NOVA-Cluster/Universal-Poofer-Control/bom/bom.csv

Reference | Qty | Value | Footprint | MPN | Manufacturer | LCSC | LC_Stock | Chosen_Distributor | Datasheet | Validated | DNP | Notes
C4,C1,C2,C3,C66 | 5 | 10uF / 25V | 0805 | CL21A106KAYNNNE | Samsung Electro-Mechanics | C15850 | 3505306 | LCSC | https://datasheet.lcsc.com/datasheet/pdf/02336ea48ea44ca18c72517dd3cb7b47.pdf?productCode=C15850 | Package/pin-map checked; prototype pending |  | Output effective capacitance>0.5uF required; ceramic stable regulator.
C5,C40,C7,C8,C9,C131,C132,C133,C134,C135,C136,C137,C138,C139,C80,C81,C82,C83,C84,C90,C91,C92,C110,C111,C112,C113,C74,C75,C70,C71,C72,C154,C141,C142,C143,C144,C145,C146,C147,C148,C149 | 41 | 100nF | 0805 | CC0805KRX7R9BB104 | YAGEO | C49678 | 7277425 | LCSC | https://datasheet.lcsc.com/datasheet/pdf/23ccee80ee542e7cf156a772bb589942.pdf?productCode=C49678 | Package/pin-map checked; prototype pending |  | Dominant compensation: OUT to isolated local IN-; do not connect directly to global reference.
C6 | 1 | 1uF / 50V | 0805 | CL21B105KBFNNNE | Samsung Electro-Mechanics | C28323 | 2084641 | LCSC | https://datasheet.lcsc.com/datasheet/pdf/02336ea48ea44ca18c72517dd3cb7b47.pdf?productCode=C28323 | Package/pin-map checked; prototype pending
C10,C11,C161,C162,C163,C164,C165,C166,C167,C168,C169 | 11 | 1nF / 50V | 0805 | CL21B102KBANNNC | Samsung Electro-Mechanics | C51210 | 9257 | LCSC | https://datasheet.lcsc.com/datasheet/pdf/02336ea48ea44ca18c72517dd3cb7b47.pdf?productCode=C51210 | Package/pin-map checked; prototype pending |  | Absorbs positive FIELD-step charge through the reverse blocker; prevents detector B-E avalanche. Qualify edge timing.
C50,C55,C60,C101,C102,C103,C104,C105,C106,C107,C108,C109,C156 | 13 | 10nF / 50V | 0805 | CL21B103KBANNNC | Samsung Electro-Mechanics | C1710 | 1006855 | LCSC | https://datasheet.lcsc.com/datasheet/pdf/02336ea48ea44ca18c72517dd3cb7b47.pdf?productCode=C1710 | Package/pin-map checked; prototype pending
D11,D12,D13,D14,D15,D16,D17,D18 | 8 | SS14 | SMA | SS14 | MDD(Microdiode Semiconductor) | C2480 | 2818967 | LCSC | https://datasheet.lcsc.com/datasheet/pdf/9977bb85cd7e349115b7bcb7054cfa0d.pdf?productCode=C2480 | Package/pin-map checked; prototype pending |  | Relay COIL flyback: cathode+12V, anodeMOSFET drain;~30mA initial current.
D31,D32,D33,D34,D35,D36,D37,D38 | 8 | SS34 | SMA | SS34 | MDD(Microdiode Semiconductor) | C8678 | 3557042 | LCSC | https://datasheet.lcsc.com/datasheet/pdf/dfa1ff67dea875d0135103ba9ada713a.pdf?productCode=C8678 | Package/pin-map checked; prototype pending |  | Valve LOAD flyback: cathodeNO, anodeRETURN. External12VDC valve1A max; slow release with diode clamp.
D41,D42,D43,D44,D45,D46,D47,D48 | 8 | SMBJ8.0A | SMB | SMBJ8.0A | Littelfuse | C224028 | 1621 | LCSC | https://datasheet.lcsc.com/datasheet/pdf/4ab84a227fae39f9eac85241b8264ead.pdf?productCode=C224028 | Package/pin-map checked; prototype pending
D91,D21,D22,D23,D24,D25,D26,D27,D28 | 9 | 8.2V / 1W | SMA | SMAZ8V2-13-F | DIODES | C84362 | 1566 | LCSC | https://datasheet.lcsc.com/datasheet/pdf/cc6412513453b26615ae87468f11d42c.pdf?productCode=C84362 | Package/pin-map checked; prototype pending
D111,D112,D113,D114,D115,D116,D117,D118,D101,D121,D102,D122,D103,D123,D104,D124,D105,D125,D106,D126,D107,D127,D108,D128,D109,D129,D119 | 27 | BAS21 | SOT-23 | BAS21,215 | Nexperia | C8661 | 221621 | LCSC | https://datasheet.lcsc.com/datasheet/pdf/75d45a3e45edceaa3bd611cf778a4f4a.pdf?productCode=C8661 | Package/pin-map checked; prototype pending |  | Nexperia BAS21,215:1anode2NC3cathode. Reverse blocks continuous-100V. Hot leakage bound in manufacturer curve; qualify-40..85C. Do not substitute100V 1N4148.
D141,D142,D143,D144,D145,D146,D147,D148,D149 | 9 | BAT54 | SOT-23 | BAT54,215 | Nexperia | C85084 | 110551 | LCSC | https://datasheet.lcsc.com/datasheet/pdf/720f73fc486de0cffc6ba54ebac7d3e3.pdf?productCode=C85084 | Package/pin-map checked; prototype pending |  | Reference-relative clamp protects compensation input during rail loss.
J1,J2,JP1,J11,J12,J13,J14,J15,J16,J17,J18,J9,J10,J41,J42,J43,J44,J45,J46,J47,J48,JP2 | 22 | 2P / 2.54mm | PinHeader_1x02_P2.54mm_Vertical | B-2100S02P-A110 | Ckmtw | C124375 | 71004 | LCSC | https://datasheet.lcsc.com/datasheet/pdf/c97166a9fa81fc94cb289f4b496e4403.pdf?productCode=C124375 | Package/pin-map checked; prototype pending |  | External regulated 5.0V, >=1A. Do not apply 12V.; 12V coil supply only; ~0.24A for eight relays. Valve power is wired separately per channel.; 5V logic; continuous +/-100V referenced to pin2; no galvanic isolation.; Valve:1positive/switchedNO;2valve-return. RETURN is isolated from logicGND. Wire valve negative here.
J3,J4,J5 | 3 | 20P / 2.54mm | PinHeader_1x20_P2.54mm_Vertical | 2.54-1*20P | BOOMELE(Boom Precision Elec) | C50981 | 8114 | LCSC | https://datasheet.lcsc.com/datasheet/pdf/d52c83a07830c4e9e9a614accc55f5cd.pdf?productCode=C50981 | Package/pin-map checked; prototype pending |  | Module pins1-20 in order, 3.3V GPIOs only. Some GPIOs reserved for shift registers.; Module pins21-40 in order. GPIO0/3/45/46 strap levels must be preserved at reset.; Serial bus and relay-driver test/breakout; never drive against MCU or shift-register outputs.
J6,J7,J31,J32,J33,J34,J35,J36,J37,J38 | 10 | 3P / 2.54mm | PinHeader_1x03_P2.54mm_Vertical | B-2100S03P-A110 | Ckmtw | C124376 | 38557 | LCSC | https://datasheet.lcsc.com/datasheet/pdf/219f7e7eb5f34457895b2c164313179f.pdf?productCode=C124376 | Package/pin-map checked; prototype pending |  | Reset:short1-2. Download:hold3-2 low during reset, then release. Use jumper/buttons externally.; 3.3V UART programmer. Self-powered target; never use5V UART levels.; Relay contacts:1COM2NO3NC; externally feedCOM with fused12V valve supply. <=1A valve design.
J20 | 1 | EXP_UP | PinHeader_2x08_P2.54mm_Vertical | 2.54-2*8P针 | BOOMELE(Boom Precision Elec) | C68234 | 36548 | LCSC | https://datasheet.lcsc.com/datasheet/pdf/d52c83a07830c4e9e9a614accc55f5cd.pdf?productCode=C68234 | Package/pin-map checked; prototype pending |  | NOPOWERPINS;independentlocalsupplies. Pin11NCcontinuity,terminateonlylast.
J21 | 1 | EXP_DOWN | PinHeader_2x08_P2.54mm_Vertical | 2.54-2*8P针 | BOOMELE(Boom Precision Elec) | C68234 | 36548 | LCSC | https://datasheet.lcsc.com/datasheet/pdf/d52c83a07830c4e9e9a614accc55f5cd.pdf?productCode=C68234 | Package/pin-map checked; prototype pending |  | NOPOWERPINS;independentlocalsupplies. Pin11NCcontinuity,terminateonlylast.
K1,K2,K3,K4,K5,K6,K7,K8 | 8 | SRD-12VDC-SL-C | Relay_SPDT_Songle_SRD | SRD-12VDC-SL-C | Songle Relay | C30431 | 142727 | LCSC | https://datasheet.lcsc.com/datasheet/pdf/9ddfe54b7529126320ff1ddcabf6bab7.pdf?productCode=C30431 | Package/pin-map checked; prototype pending |  | Songle12V/360mW coil;400ohm nominal.10A contact rating is resistive. Custom footprint corrects stockSANYOU NC/NO reversal;1COM2/5coil3NC4NO.
Q40,Q131,Q132,Q133,Q134,Q135,Q136,Q137,Q138,Q139 | 10 | AO3401A | SOT-23 | AO3401A | AOS | C15127 | 715902 | LCSC | https://datasheet.lcsc.com/datasheet/pdf/fee353dd1e9e0bc90b295f14f381aa4c.pdf?productCode=C15127 | Package/pin-map checked; prototype pending |  | P-MOS gates local5V bias only.1G2S3D;10k gate-source pullup defaultsOFF on OV or powerloss.
Q41,Q42,Q111,Q121,Q112,Q122,Q113,Q123,Q114,Q124,Q115,Q125,Q116,Q126,Q117,Q127,Q118,Q128,Q119,Q129 | 20 | MMBT3904 | SOT-23 | MMBT3904(RANGE:100-300) | JSCJ | C20526 | 2033567 | LCSC | https://datasheet.lcsc.com/datasheet/pdf/9335632bcfa83df8351353eab379720e.pdf?productCode=C20526 | Package/pin-map checked; prototype pending
Q101,Q102,Q103,Q104,Q105,Q106,Q107,Q108,Q109 | 9 | MJD350T4G | TO-252-3_TabPin2 | MJD350T4G | onsemi | C145514 | 6132 | LCSC | https://datasheet.lcsc.com/datasheet/pdf/e1ca48ba9fe8215bfc40bb66a4536fef.pdf?productCode=C145514 | Package/pin-map checked; prototype pending |  | P-MOS gates local5V bias only.1G2S3D;10k gate-source pullup defaultsOFF on OV or powerloss.
Q149,Q1,Q2,Q3,Q4,Q5,Q6,Q7,Q8 | 9 | AO3400A | SOT-23 | AO3400A | AOS | C20917 | 1535925 | LCSC | https://datasheet.lcsc.com/datasheet/pdf/130876b936da464599428c58fd8de8f6.pdf?productCode=C20917 | Package/pin-map checked; prototype pending |  | 1Gate2Source3Drain;Rds(on) specified at2.5V gate. Relay coil current~30mA.
Q151,Q152,Q153,Q154,Q155,Q156,Q157,Q158,Q159 | 9 | MMBT3906 | SOT-23 | MMBT3906 2A(RANGE:100-300) | JSCJ | C2143 | 77637 | LCSC | https://datasheet.lcsc.com/datasheet/pdf/550597da53734df4a72fadeaed7e7aa7.pdf?productCode=C2143 | Package/pin-map checked; prototype pending |  | Fast backup limiter; senses half of33Rdrop, typically30-50mA surge bound.
R2,R3,R4,R5,R61,R70,R114,R113,R115,R1020,R1013,R1050,R1043,R1080,R1073,R1110,R1103,R1140,R1133,R1170,R1163,R1200,R1193,R1230,R1223,R1021,R1051,R1081,R1111,R1141,R1171,R1201,R1231,R1261,R1260,R1253,R90,R91,R92,R93,R94,R95,R124,R125,R126,R127,R128,R129,R130,R131,R132,R133,R134,R135,R88,R153,R155,R157,R1024,R1054,R1084,R1114,R1144,R1174,R1204,R1234,R1264 | 67 | 10k | 0805 | 0805W8F1002T5E | UNI-ROYAL | C17414 | 10726008 | LCSC | https://datasheet.lcsc.com/datasheet/pdf/0a975aaa49b7c97f38a963127be4a823.pdf?productCode=C17414 | Package/pin-map checked; prototype pending |  | Gate-source pullup provides default-off state.
R40,R1001,R1031,R1061,R1091,R1121,R1151,R1181,R1211,R1241,R120,R121 | 12 | 2.2k | 0805 | 0805W8F2201T5E | UNI-ROYAL | C17520 | 936020 | LCSC | https://datasheet.lcsc.com/datasheet/pdf/0a975aaa49b7c97f38a963127be4a823.pdf?productCode=C17520 | Package/pin-map checked; prototype pending
R50,R51 | 2 | 200k | 0805 | 0805W8F2003T5E | UNI-ROYAL | C17539 | 421599 | LCSC | https://datasheet.lcsc.com/datasheet/pdf/0a975aaa49b7c97f38a963127be4a823.pdf?productCode=C17539 | Package/pin-map checked; prototype pending
R52 | 1 | 3.3k | 0805 | 0805W8F3301T5E | UNI-ROYAL | C26010 | 457218 | LCSC | https://datasheet.lcsc.com/datasheet/pdf/0a975aaa49b7c97f38a963127be4a823.pdf?productCode=C26010 | Package/pin-map checked; prototype pending
R56,R1017,R1047,R1077,R1107,R1137,R1167,R1197,R1227,R1257 | 10 | 6.8k | 0805 | 0805W8F6801T5E | UNI-ROYAL | C17772 | 327991 | LCSC | https://datasheet.lcsc.com/datasheet/pdf/0a975aaa49b7c97f38a963127be4a823.pdf?productCode=C17772 | Package/pin-map checked; prototype pending
R57,R58 | 2 | 75k | 0805 | 0805W8F7502T5E | UNI-ROYAL | C17819 | 49785 | LCSC | https://datasheet.lcsc.com/datasheet/pdf/0a975aaa49b7c97f38a963127be4a823.pdf?productCode=C17819 | Package/pin-map checked; prototype pending
R60 | 1 | 30k | 0805 | 0805W8F3002T5E | UNI-ROYAL | C17621 | 317144 | LCSC | https://datasheet.lcsc.com/datasheet/pdf/0a975aaa49b7c97f38a963127be4a823.pdf?productCode=C17621 | Package/pin-map checked; prototype pending |  | Gate-source pullup provides default-off state.
R65,R55,R111,R112,R1003,R1002,R1022,R1023,R1033,R1032,R1052,R1053,R1063,R1062,R1082,R1083,R1093,R1092,R1112,R1113,R1123,R1122,R1142,R1143,R1153,R1152,R1172,R1173,R1183,R1182,R1202,R1203,R1213,R1212,R1232,R1233,R1243,R1242,R1262,R1263,R137,R138,R139,R140 | 44 | 1k | 0805 | 0805W8F1001T5E | UNI-ROYAL | C17513 | 6086189 | LCSC | https://datasheet.lcsc.com/datasheet/pdf/0a975aaa49b7c97f38a963127be4a823.pdf?productCode=C17513 | Package/pin-map checked; prototype pending |  | 5VpullupBEFOREshunt preservescontactcurrent.; MANDATORY: limits clamp versus driver current to <=5.25mA.
R71,R116,R1014,R1015,R1016,R1009,R1010,R1011,R1012,R1044,R1045,R1046,R1039,R1040,R1041,R1042,R1074,R1075,R1076,R1069,R1070,R1071,R1072,R1104,R1105,R1106,R1099,R1100,R1101,R1102,R1134,R1135,R1136,R1129,R1130,R1131,R1132,R1164,R1165,R1166,R1159,R1160,R1161,R1162,R1194,R1195,R1196,R1189,R1190,R1191,R1192,R1224,R1225,R1226,R1219,R1220,R1221,R1222,R1004,R1005,R1006,R1007,R1034,R1035,R1036,R1037,R1064,R1065,R1066,R1067,R1094,R1095,R1096,R1097,R1124,R1125,R1126,R1127,R1154,R1155,R1156,R1157,R1184,R1185,R1186,R1187,R1214,R1215,R1216,R1217,R1244,R1245,R1246,R1247,R1254,R1255,R1256,R1249,R1250,R1251,R1252,R211,R212,R213,R214,R215,R216,R217,R218,R136,R151,R152,R154 | 113 | 100k | 0805 | 0805W8F1003T5E | UNI-ROYAL | C149504 | 2466214 | LCSC | https://datasheet.lcsc.com/datasheet/pdf/0a975aaa49b7c97f38a963127be4a823.pdf?productCode=C149504 | Package/pin-map checked; prototype pending |  | High-impedance test observation; limit ordinary counterdrive to<35uA. Use a high-impedance probe.
R80,R81,R82,R83,R84,R85,R86,R87,R1000,R1030,R1060,R1090,R1120,R1150,R1180,R1210,R1240 | 17 | 33R | 0805 | 0805W8F330JT5E | UNI-ROYAL | C17634 | 334351 | LCSC | https://datasheet.lcsc.com/datasheet/pdf/0a975aaa49b7c97f38a963127be4a823.pdf?productCode=C17634 | Package/pin-map checked; prototype pending |  | Compensated current servo; backup PNP limits short transients. Qualify pulse energy.
R150,R110,R122,R123 | 4 | 4.7k | 0805 | 0805W8F4701T5E | UNI-ROYAL | C17673 | 3444289 | LCSC | https://datasheet.lcsc.com/datasheet/pdf/0a975aaa49b7c97f38a963127be4a823.pdf?productCode=C17673 | Package/pin-map checked; prototype pending |  | Series fault attenuation; <34V and <12mW each at+100V.
R201,R202,R203,R204,R205,R206,R207,R208,R66,R67 | 10 | 100R | 0805 | 0805W8F1000T5E | UNI-ROYAL | C17408 | 2576764 | LCSC | https://datasheet.lcsc.com/datasheet/pdf/0a975aaa49b7c97f38a963127be4a823.pdf?productCode=C17408 | Package/pin-map checked; prototype pending |  | Capacitive-load isolation and power-off discharge current limit.
R1008,R1038,R1068,R1098,R1128,R1158,R1188,R1218,R1248,R156 | 10 | 68k | 0805 | 0805W8F6802T5E | UNI-ROYAL | C17801 | 221823 | LCSC | https://datasheet.lcsc.com/datasheet/pdf/0a975aaa49b7c97f38a963127be4a823.pdf?productCode=C17801 | Package/pin-map checked; prototype pending
R1018,R1019,R1048,R1049,R1078,R1079,R1108,R1109,R1138,R1139,R1168,R1169,R1198,R1199,R1228,R1229,R1258,R1259,R158 | 19 | 1M | 0805 | 0805W8F1004T5E | UNI-ROYAL | C17514 | 752470 | LCSC | https://datasheet.lcsc.com/datasheet/pdf/0a975aaa49b7c97f38a963127be4a823.pdf?productCode=C17514 | Package/pin-map checked; prototype pending |  | 100k||1M =90.909k; lowers5V trip to4.269V with normal-supply corner margin.
U1 | 1 | ESP32-S3-WROOM-1-N8 | ESP32-S3-WROOM-1 | ESP32-S3-WROOM-1-N8 | ESPRESSIF | C2913198 | 6072 | LCSC | https://datasheet.lcsc.com/datasheet/pdf/24a44651a4767a6582addcdaa9cab2ca.pdf?productCode=C2913198 | Package/pin-map checked; prototype pending |  | N8:8MB flash, no PSRAM; all module GPIOs exposed. GPIO0/3/45/46 are strapping pins. Antenna keepout mandatory at layout.
U2 | 1 | TLV1117LV33 | SOT-223-3_TabPin2 | TLV1117LV33DCYR | TI | C15578 | 1771 | LCSC | https://www.ti.com/lit/ds/symlink/tlv1117lv.pdf | Package/pin-map checked; prototype pending |  | Ceramic stable1A regulator. SOT223 copper heat spreader required:0.85W at500mA. Verify final thermal layout.
U3 | 1 | 74HC595D,118 | SOIC-16_3.9x9.9mm_P1.27mm | 74HC595D,118 | Nexperia | C5947 | 300597 | LCSC | https://datasheet.lcsc.com/datasheet/pdf/a010531f03b3cd52f281e9270a37554f.pdf?productCode=C5947 | Package/pin-map checked; prototype pending
U4,U5 | 2 | 74HC165D,653 | SOIC-16_3.9x9.9mm_P1.27mm | 74HC165D,653 | Nexperia | C5613 | 176023 | LCSC | https://datasheet.lcsc.com/datasheet/pdf/581a3a30f07ab5fec4b563321f834e05.pdf?productCode=C5613 | Package/pin-map checked; prototype pending
U10,U13,U11,U14,U12 | 5 | LM2901BIDR | SOIC-14_3.9x8.7mm_P1.27mm | LM2901BIDR | TI | C22427890 | 2406 | LCSC | https://www.ti.com/lit/ds/symlink/lm2901.pdf | Package/pin-map checked; prototype pending |  | B suffix mandatory:5.5mV max offset. Quad comparator5V supply, open-collector outputs pulled to3.3V. Input power-off tolerance independent of supply.
U20,U21,U22 | 3 | LM2902DR | SOIC-14_3.9x8.7mm_P1.27mm | LM2902DR | TI | C350545 | 79908 | LCSC | https://datasheet.lcsc.com/datasheet/pdf/4a62dd90e9e076620b6ad3345f8cbf23.pdf?productCode=C350545 | Package/pin-map checked; prototype pending |  | LM2902DR quad current servo;12 V raw supply;emitter+ CURRENT_REF-;unit properties identical.
U30 | 1 | 74HC00D,653 | SOIC-14_3.9x8.7mm_P1.27mm | 74HC00D,653 | Nexperia | C5586 | 38676 | LCSC | https://datasheet.lcsc.com/datasheet/pdf/f075b54a1e6ef92859876c6b1072c938.pdf?productCode=C5586 | Package/pin-map checked; prototype pending |  | HC00 output-enable logic; 3.3V; all unit properties identical.
U31 | 1 | 74HC02D,653 | SOIC-14_3.9x8.7mm_P1.27mm | 74HC02D,653 | Nexperia | C5588 | 9973 | LCSC | https://datasheet.lcsc.com/datasheet/pdf/1c47bea93f023f708e04ad0ea1d69eaa.pdf?productCode=C5588 | Package/pin-map checked; prototype pending |  | HC02 loop permission and asynchronous clear; 3.3V.
U32 | 1 | 74HC14D,653 | SOIC-14_3.9x8.7mm_P1.27mm | 74HC14D,653 | Nexperia | C5605 | 323410 | LCSC | https://datasheet.lcsc.com/datasheet/pdf/14be360d5023de3678ac97c5270a2114.pdf?productCode=C5605 | Package/pin-map checked; prototype pending |  | HC14 Schmitt conditioning; 3.3V.
U34 | 1 | 74HC74D,653 | SOIC-14_3.9x8.7mm_P1.27mm | 74HC74D,653 | Nexperia | C27597 | 17491 | LCSC | https://datasheet.lcsc.com/datasheet/pdf/f4f0560be08307d88611fab756814ae9.pdf?productCode=C27597 | Package/pin-map checked; prototype pending |  | HC74 edge-armed RUN latch; async clear on stop or power fault; 3.3V.
U35 | 1 | TLV9022DR | SOIC-8_3.9x4.9mm_P1.27mm | TLV9022DR | TI | C2871718 | 3324 | LCSC | https://datasheet.lcsc.com/datasheet/pdf/3d1f78e103f465c65679bc7782083f18.pdf?productCode=C2871718 | Package/pin-map checked; prototype pending |  | B suffix mandatory:5.5mV max offset. Quad comparator5V supply, open-collector outputs pulled to3.3V. Input power-off tolerance independent of supply.
U40 | 1 | TLV803EA30 | SOT-23 | TLV803EA30DBZR | TI | C5218924 | 4037 | LCSC | https://datasheet.lcsc.com/datasheet/pdf/075232f81476471fb0145392049399fa.pdf?productCode=C5218924 | Package/pin-map checked; prototype pending |  | 1GND2RESET_N3VDD;3.08Vthreshold,130-270ms delay.
U50,U51,U52 | 3 | SN74LVC244A | SOIC-20W_7.5x12.8mm_P1.27mm | SN74LVC244ADWR | TI | C507250 | 5314 | LCSC | https://datasheet.lcsc.com/datasheet/pdf/837c4cf251ed322926ebeb792567c9cb.pdf?productCode=C507250 | Package/pin-map checked; prototype pending |  | LVC244A3.3V,Ioff,5Vtolerantinputs;unusedinputsGND.
U54 | 1 | PCA9517AD | SOIC-8_3.9x4.9mm_P1.27mm | PCA9517AD,118 | NXP | C2802638 | 2831 | LCSC | https://www.nxp.com/docs/en/data-sheet/PCA9517A.pdf | Package/pin-map checked; prototype pending |  | NXP A variant;A sides commonUP/DOWN, B privateMCU. Partial-power isolation.
