NOVA-Cluster/Universal-Poofer-Control/output/pcb/placement_top.pdf

## UNIVERSAL POOFER CONTROL

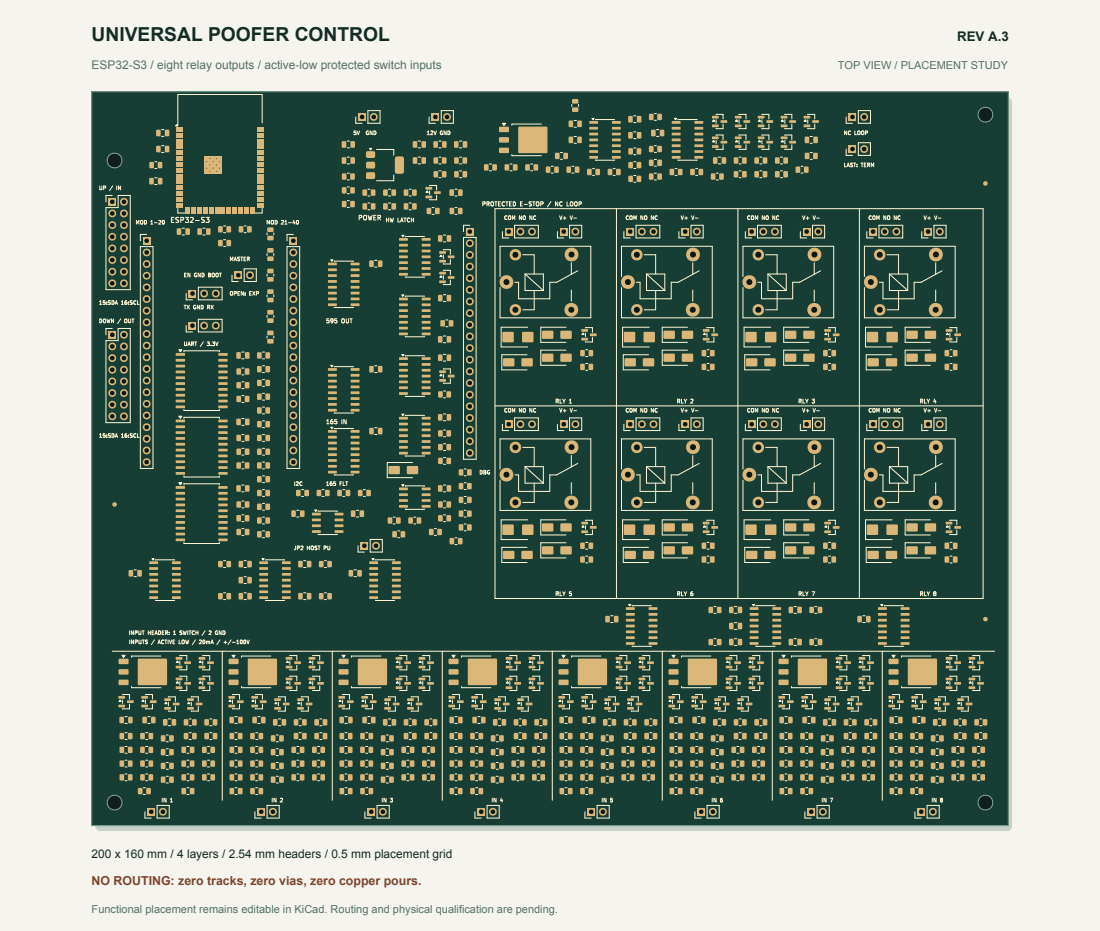
[picture p7: page 1]
REV A.3

ESP32-S3 / eight relay outputs / active-low protected switch inputs

TOP VIEW / PLACEMENT STUDY

200 x 160 mm / 4 layers / 2.54 mm headers / 0.5 mm placement grid

NO ROUTING: zero tracks, zero vias, zero copper pours.

Functional placement remains editable in KiCad. Routing and physical qualification are pending.
