NOVA-Cluster/Universal-Poofer-Control/output/pdf/Universal_Poofer_Control_A3.pdf

1 | 2 | 3 | 4 | 5 | 6 | 7 | 8

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
Size: A3 | Rev: A.3 | F Date: 2026-10-03
KiCad E.D.A. 10.0.5 | Id: 1/24

# Title: 01 | System architecture

## File: Universal_Poofer_Control.kicad_sch

## Sheet: /

## Universal Poofer Control | Engineering

## Grounded contacts / 20mA wetting / +/-100V faults

## Hardware stop latch | 12V / 1A NO valve outputs

18 | Analog supplies, spare units and debug port File: Analog_Support.kicad_sch | 24 | Stable emitter feedback for all wetting sources File: Source_Feedback_Filters.kicad_sch 20 | Buffered current reference and rail sequencing
File: Current_Reference.kicad_sch 16 | Valve outputs 1-4
File: Relay_Outputs_1.kicad_sch | 21 | I2C expansion and power-off isolation
File: I2C_Expansion.kicad_sch 17 | Valve outputs 5-8
File: Relay_Outputs_2.kicad_sch 13 | Wetting sources 5-6
File: Contact_Sources_3.kicad_sch 12 | Wetting sources 3-4
File: Contact_Sources_2.kicad_sch 02 | Processor and service interfaces
File: Controller.kicad_sch | 08 | Contact receivers 3-4
File: Input_Receivers_2.kicad_sch | 09 | Contact receivers 5-6
File: Input_Receivers_3.kicad_sch 06 | Hardware stop latch and coil gate
File: Hardware_Stop.kicad_sch | 05 | Buffered expansion interface
File: Expansion.kicad_sch 04 | Register chains

### File: Serial_IO.kicad_sch 03 | Power and analog references

### File: Power.kicad_sch 22 | Expansion defaults and buffer supplies

File: Expansion_Bias.kicad_sch

### 07 | Contact receivers 1-2

File: Input_Receivers_1.kicad_sch 11 | Wetting sources 1-2

### File: Contact_Sources_1.kicad_sch 23 | Hardware monitoring of 5V and raw 12V

File: Rail_Supervision.kicad_sch

### 10 | Contact receivers 7-8

File: Input_Receivers_4.kicad_sch | 19 | Safety logic supplies and unused gates
File: Logic_Support.kicad_sch 14 | Wetting sources 7-8
File: Contact_Sources_4.kicad_sch | 15 | NC emergency-stop field loop

File: Stop_Field.kicad_sch

# UNIVERSAL POOFER CONTROL

Stable shared wetting-current reference Protected NC loop and tail termination Protected contact sensing

Safety logic bypassing and spare units 20 mA source and field fault cutoff Logic-powered raw supply-loss protection

Analog bypassing and defined spare units

Logic supplies and monitored startup

Safe control defaults and bypass PCB placement stage only: no tracks, vias or copper pours. Routing, actual-valve tests and independent system safety qualification remain required. | Stable transistor-loop feedback

## HARDWARE SAFETY CONTRACT

NC loop open/disconnected sets hardware stop latch. Loop restored does not re-energize retained outputs. Fresh ARM edge and power-good required to enable. GPIO18 = loop healthy; GPIO21 = hardware RUN feedback. NC relay contacts auxiliary; valve connectors are NO. Protected contact sensing | 8 command bits / 16 captured input bits Asynchronous stop / edge-controlled restart | Buffered chain and physical module role REV A.3 | Functional architecture | 2026-10-03
Protected contact sensing 20 mA source and field fault cutoff Processor, reset and programming | Protected contact sensing Physical role jumper; no MCU control of role/source. | 20 mA source and field fault cutoff NO valve contacts and release clamps
Buffered host/expander chain; separate module power. 8 NO valve outputs:12 VDC, 1 A design load per channel. | NO valve contacts and release clamps

Continuous +/-100V field faults; negative faults masked.

Shared A bus / isolated private MCU bus

8 grounded contacts; nominal 20 mA supplied by board. INTERFACE CONTRACT

20 mA source and field fault cutoff

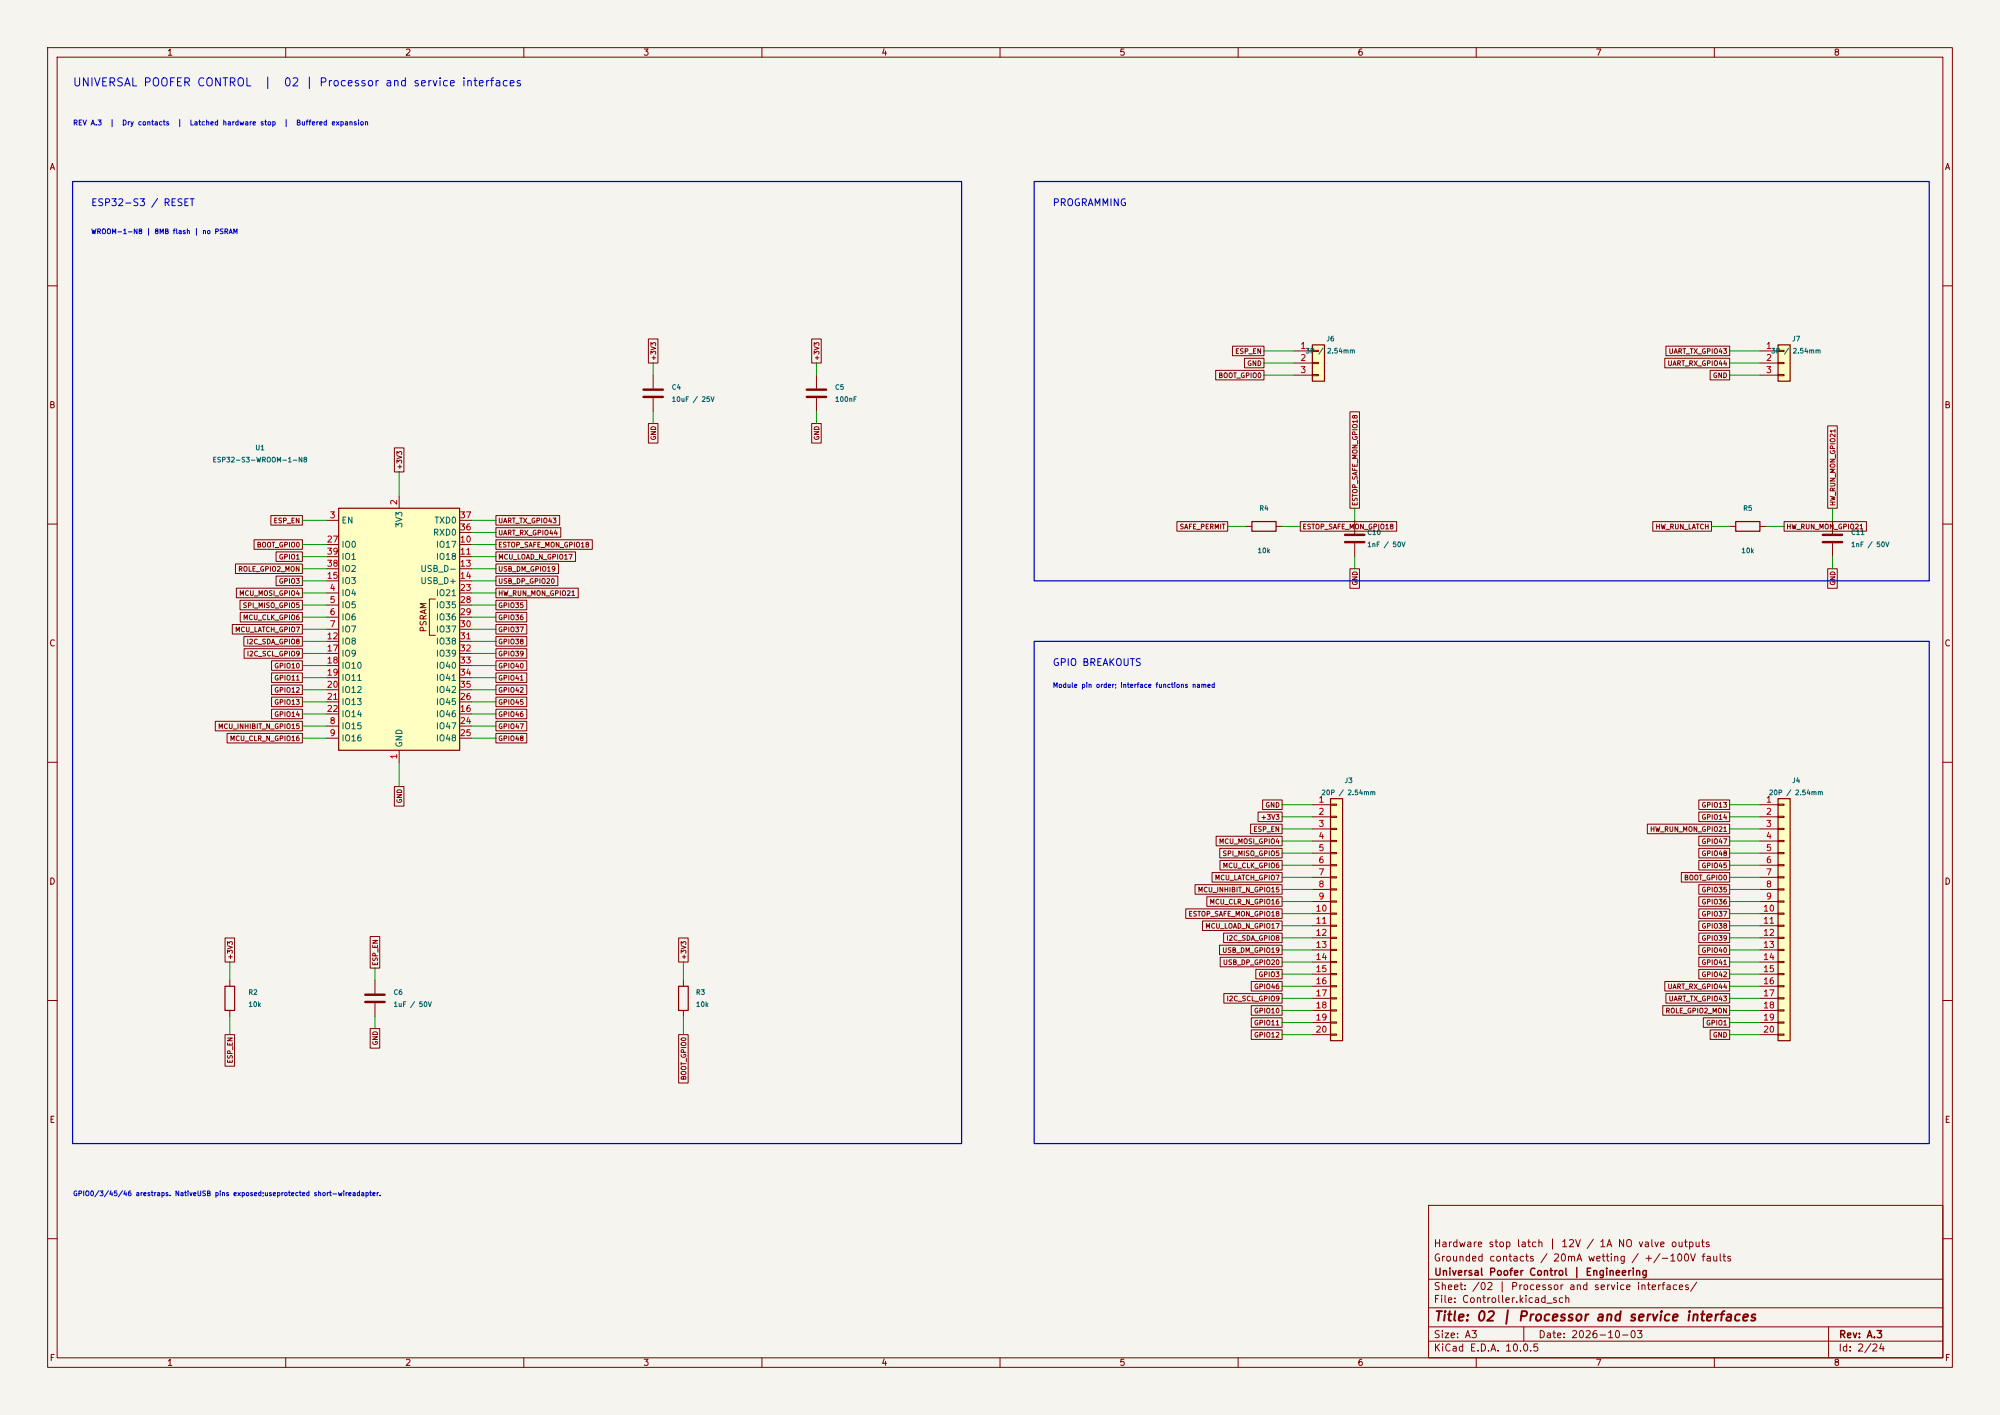
[picture p8: page 2]

UNIVERSAL POOFER CONTROL | 02 | Processor and service interfaces

Module pin order; interface functions named

GPIO0/3/45/46 arestraps. NativeUSB pins exposed;useprotected short-wireadapter.

Hardware stop latch | 12V / 1A NO valve outputs
Grounded contacts / 20mA wetting / +/-100V faults
Universal Poofer Control | Engineering
Sheet: /02 | Processor and service interfaces/
File: Controller.kicad_sch
Title: 02 | Processor and service interfaces

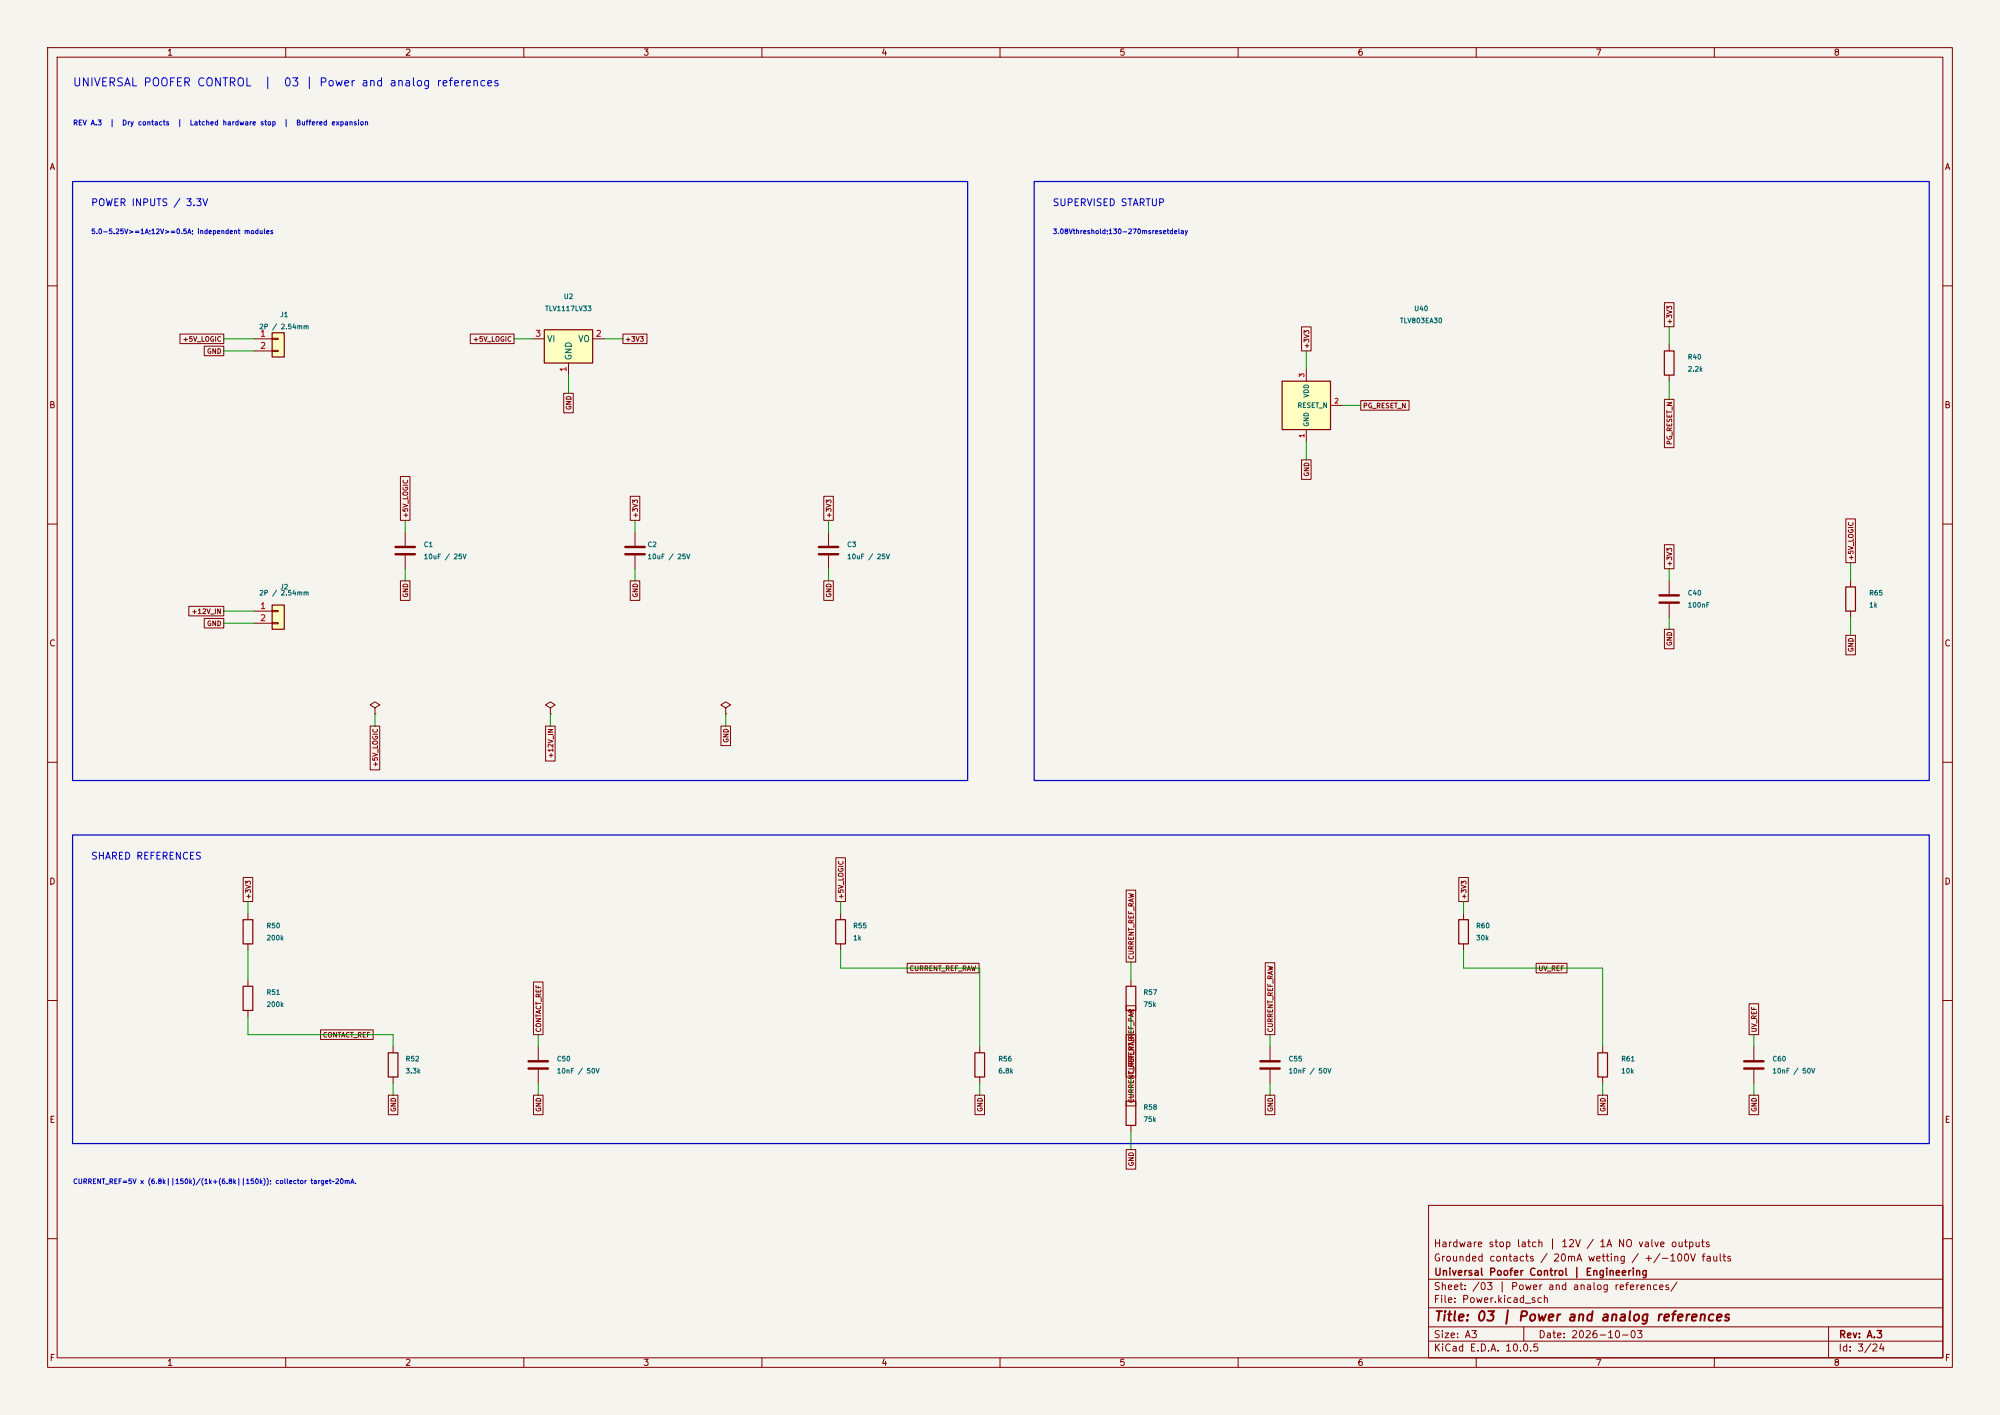
[picture p9: page 3]

UNIVERSAL POOFER CONTROL | 03 | Power and analog references

CURRENT_REF=5V x (6.8k||150k)/(1k+(6.8k||150k)); collector target~20mA. SHARED REFERENCES

Hardware stop latch | 12V / 1A NO valve outputs
Grounded contacts / 20mA wetting / +/-100V faults
Universal Poofer Control | Engineering
Sheet: /03 | Power and analog references/
File: Power.kicad_sch
Title: 03 | Power and analog references

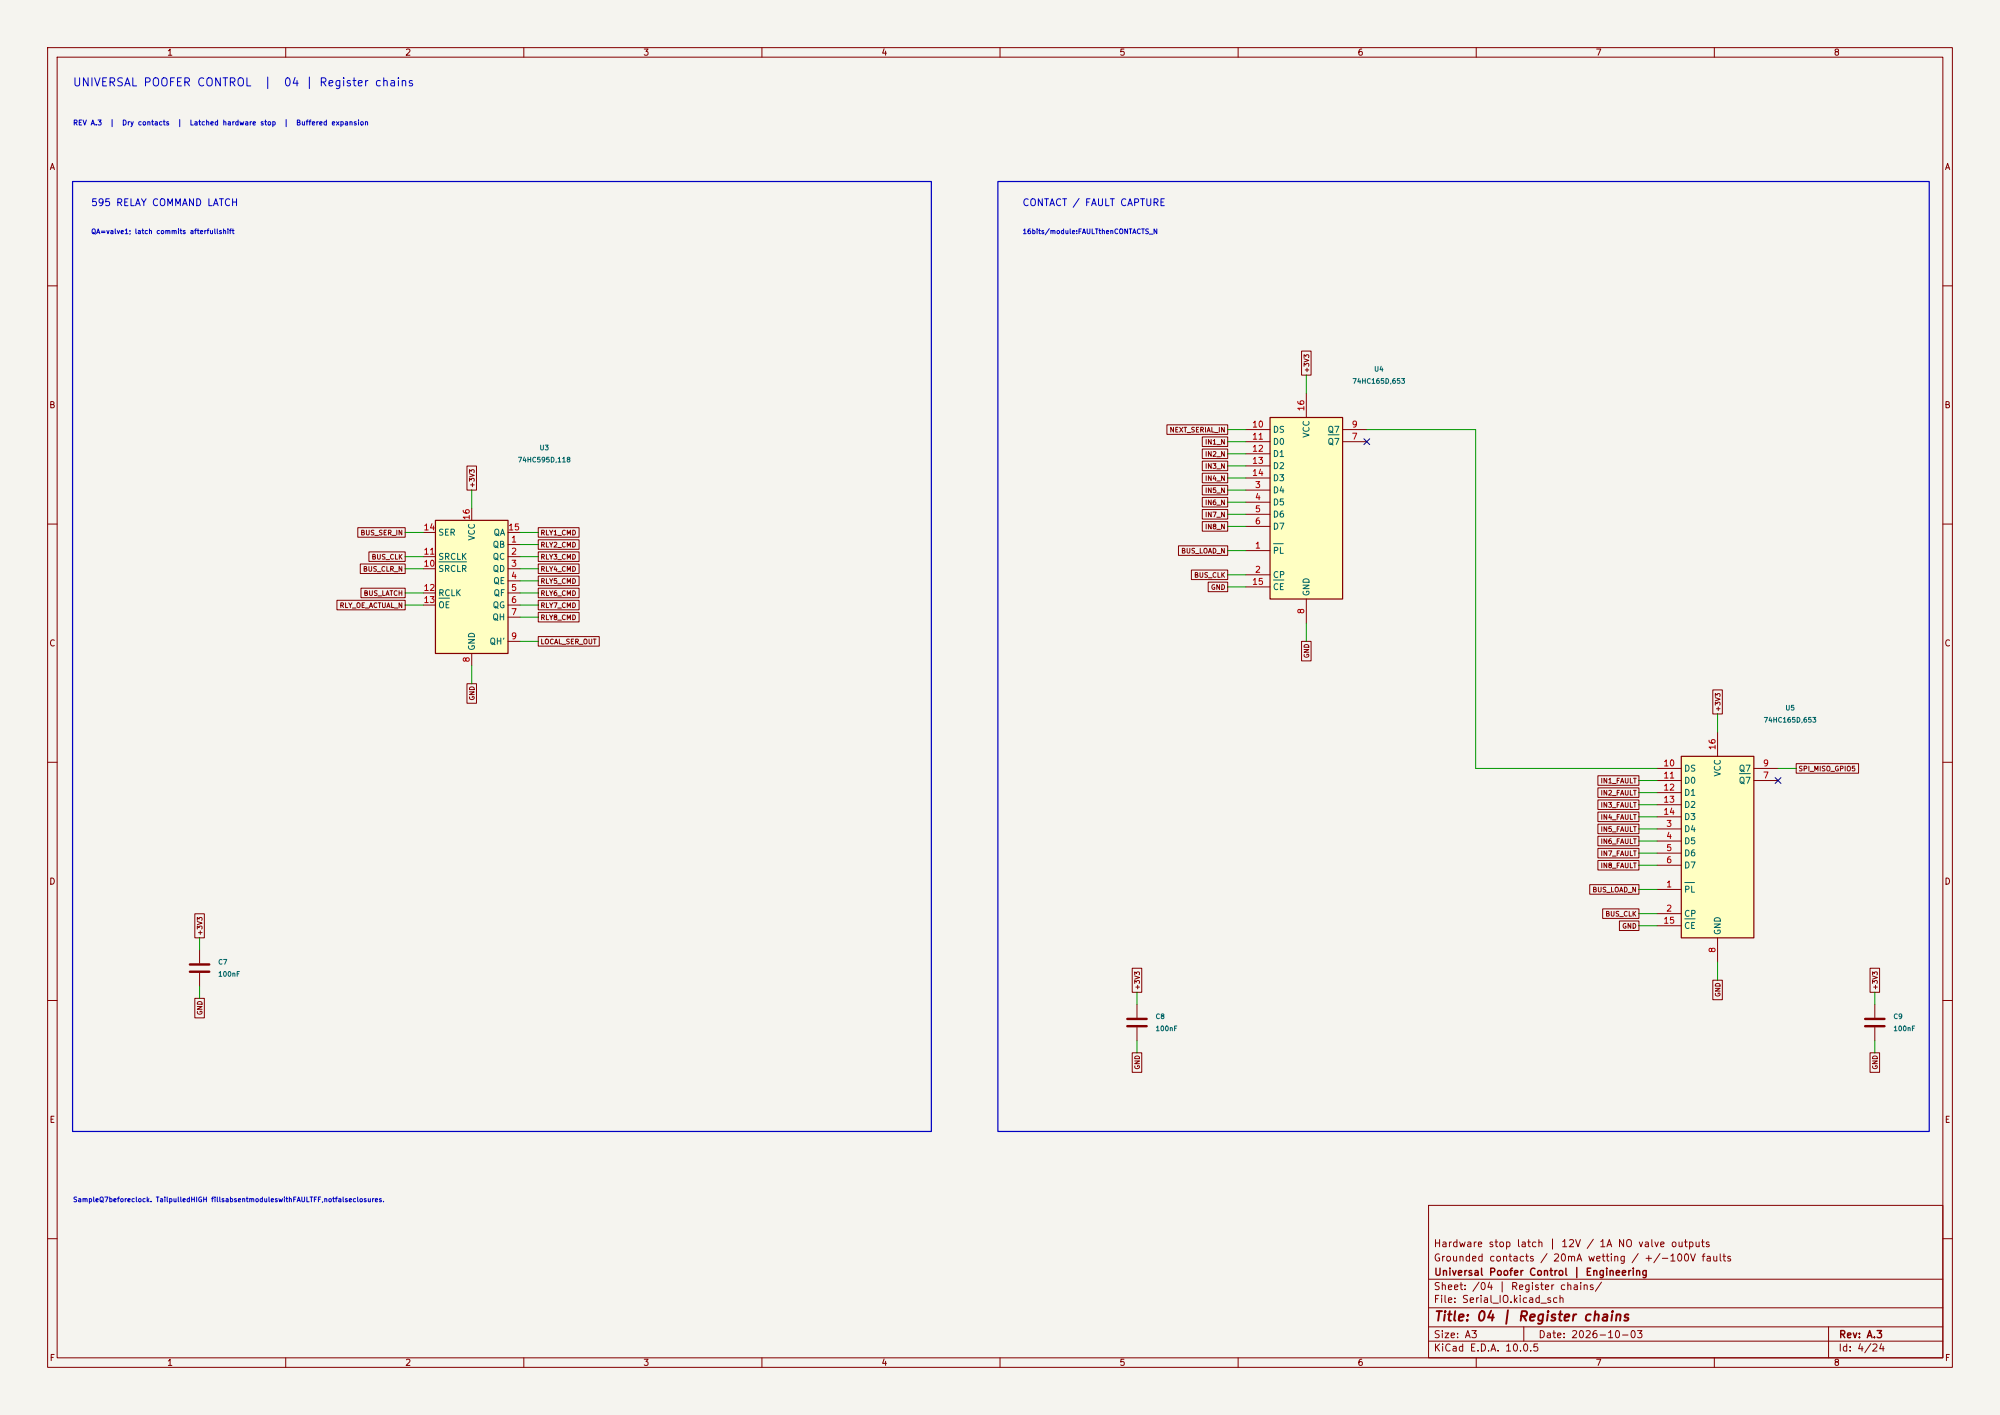
[picture p10: page 4]

16bits/module:FAULTthenCONTACTS_N UNIVERSAL POOFER CONTROL | 04 | Register chains

REV A.3 | Dry contacts | Latched hardware stop | Buffered expansion

QA=valve1; latch commits afterfullshift

SRCLR 10 SRCLK 11 RCLK 12 OE 13

Hardware stop latch | 12V / 1A NO valve outputs
Grounded contacts / 20mA wetting / +/-100V faults
Universal Poofer Control | Engineering
Sheet: /04 | Register chains/
File: Serial_IO.kicad_sch
Title: 04 | Register chains

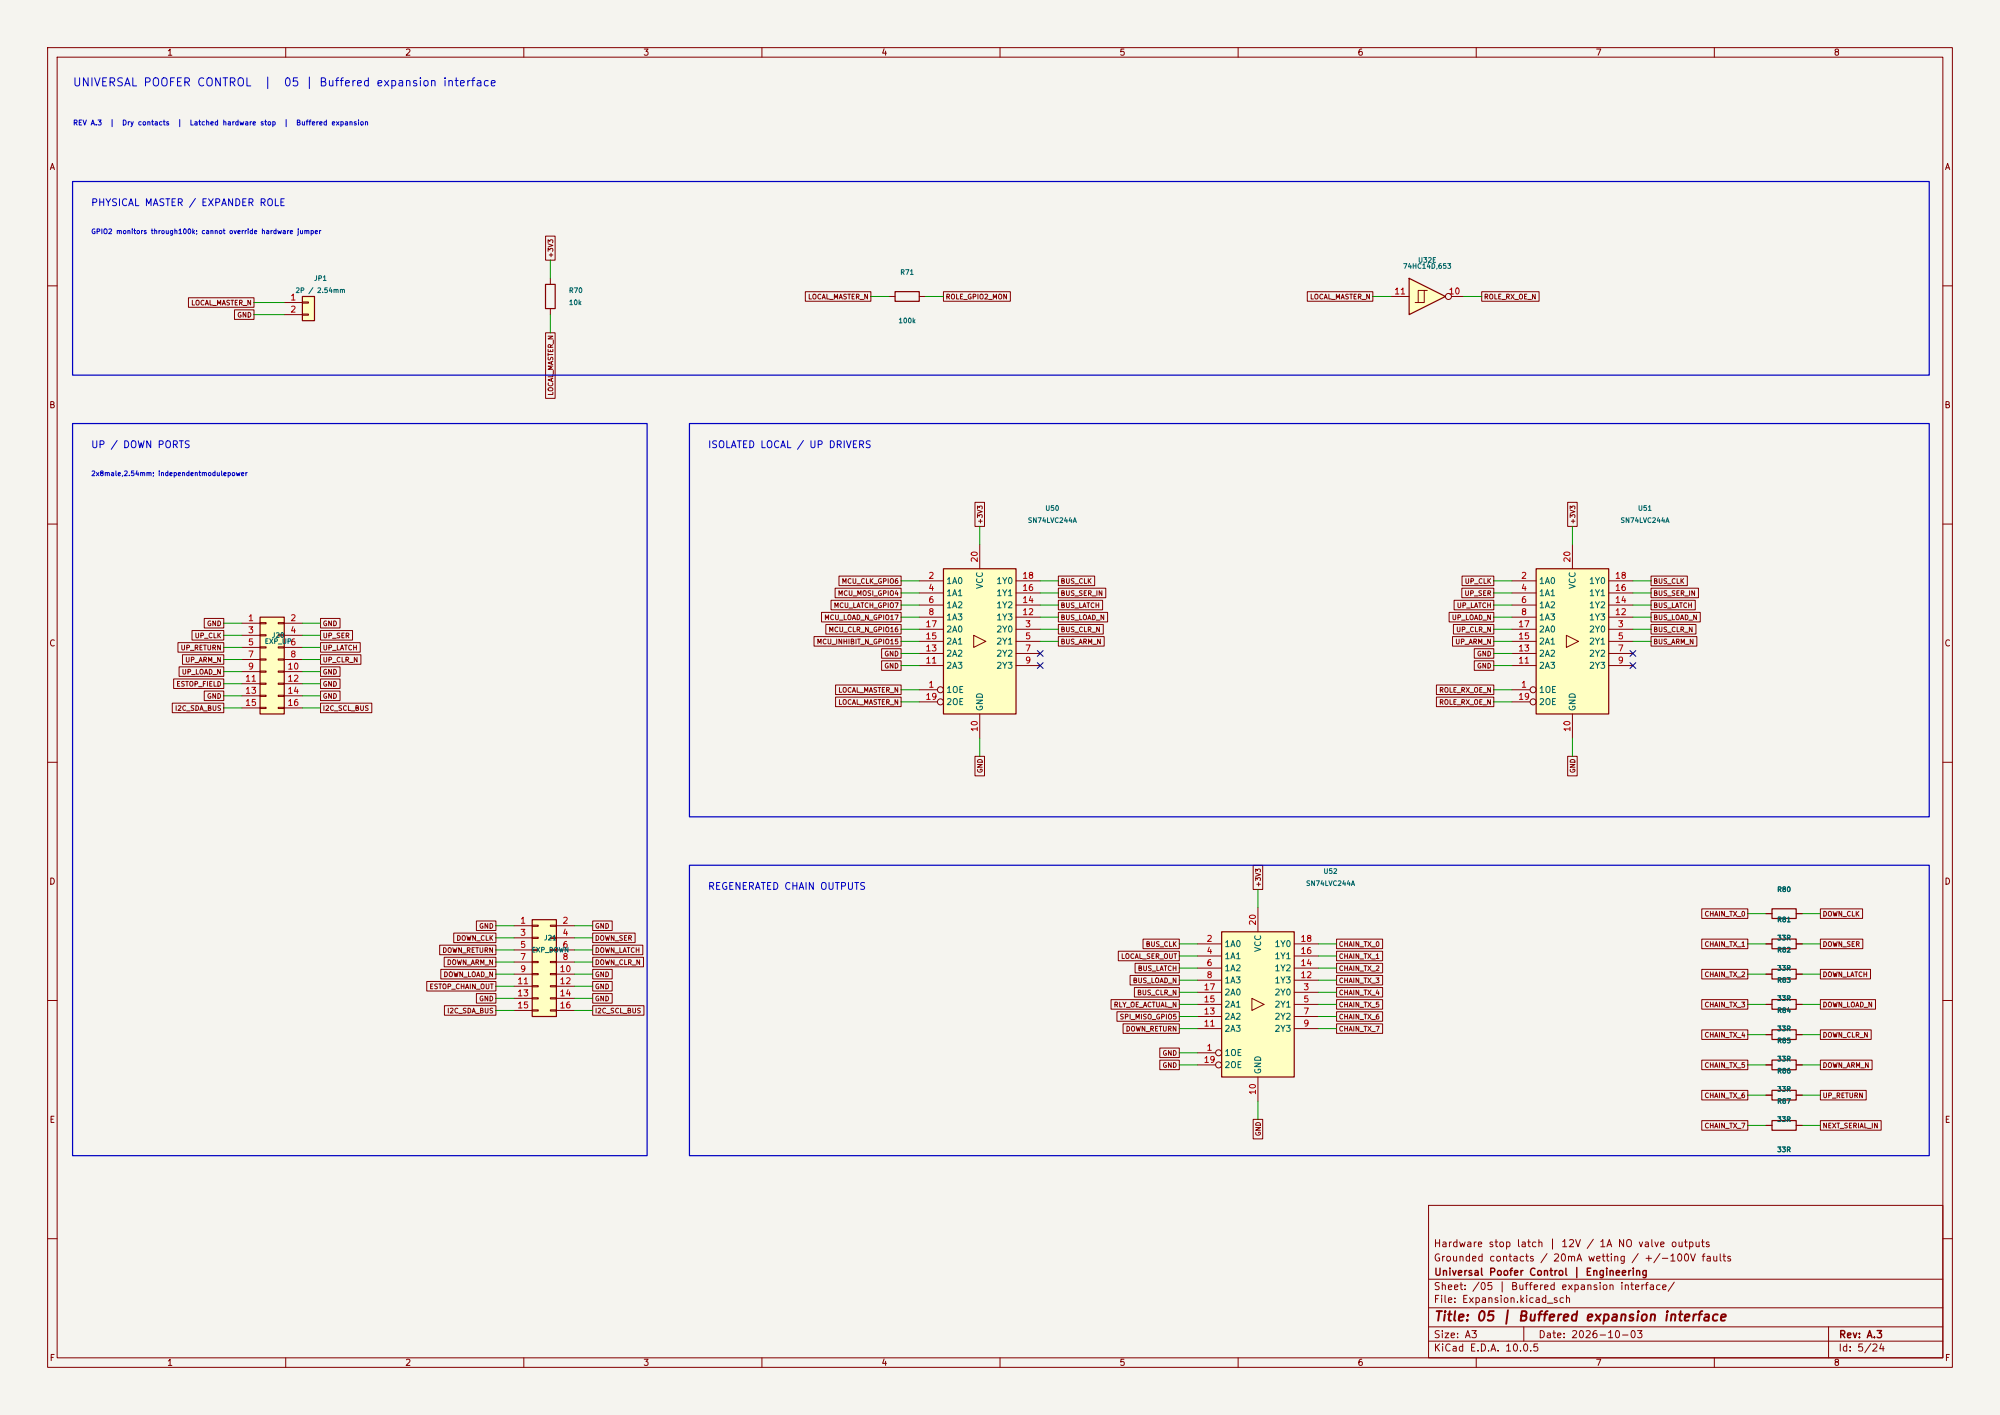
[picture p11: page 5]

UNIVERSAL POOFER CONTROL | 05 | Buffered expansion interface

REV A.3 | Dry contacts | Latched hardware stop | Buffered expansion

PHYSICAL MASTER / EXPANDER ROLE

Hardware stop latch | 12V / 1A NO valve outputs
Grounded contacts / 20mA wetting / +/-100V faults
Universal Poofer Control | Engineering
Sheet: /05 | Buffered expansion interface/
File: Expansion.kicad_sch
Title: 05 | Buffered expansion interface

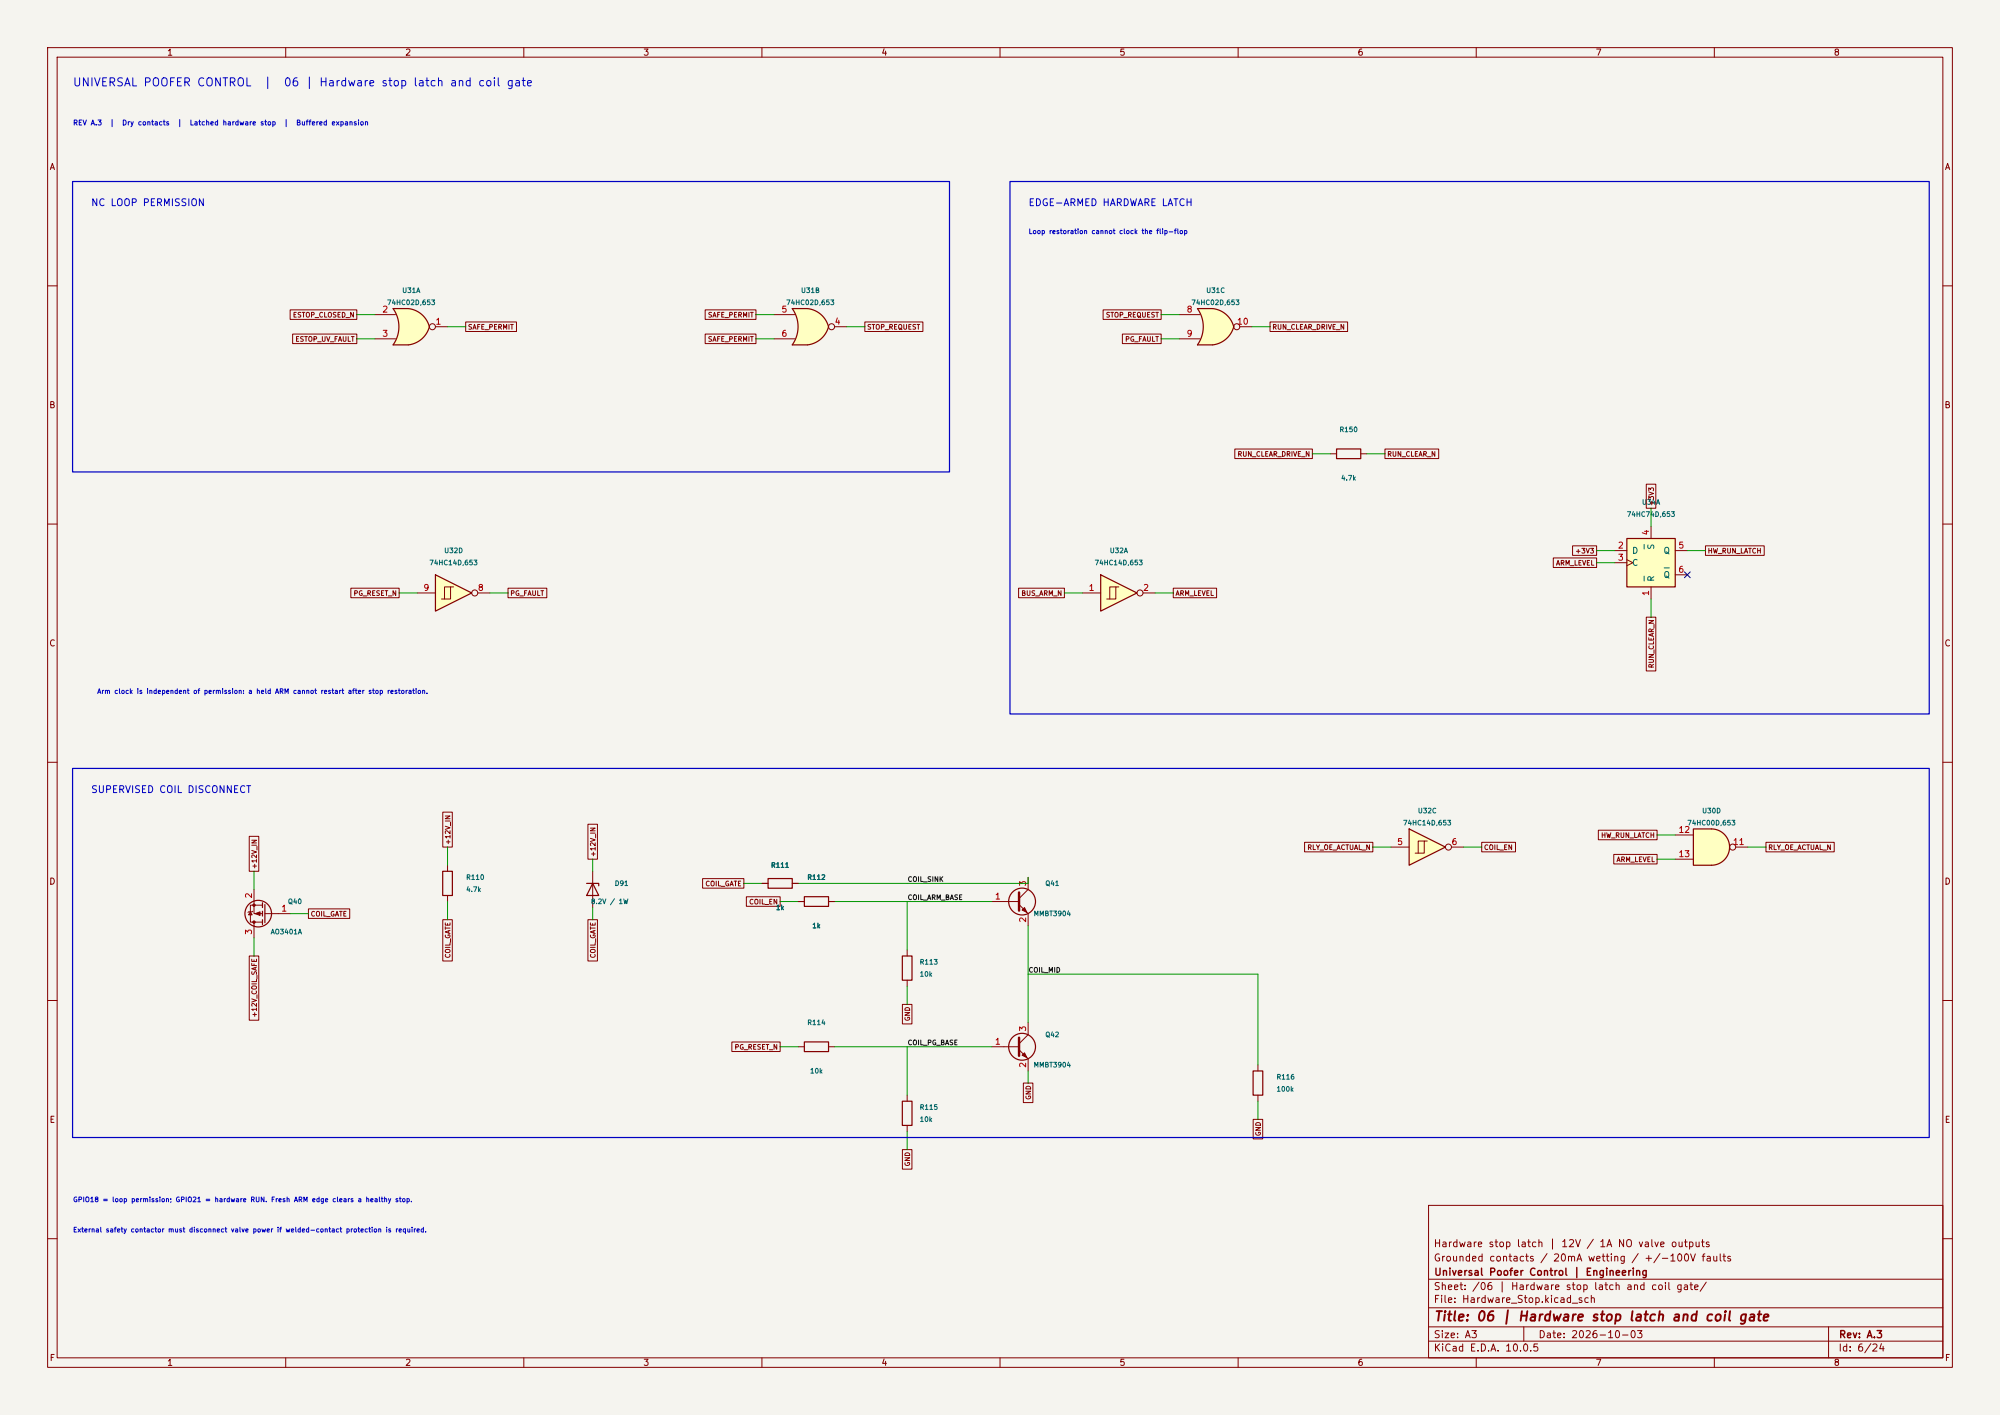
[picture p12: page 6]

UNIVERSAL POOFER CONTROL | 06 | Hardware stop latch and coil gate
REV A.3 | Dry contacts | Latched hardware stop | Buffered expansion SUPERVISED COIL DISCONNECT
74HC02D,653 COIL_GATE

GPIO18 = loop permission; GPIO21 = hardware RUN. Fresh ARM edge clears a healthy stop. External safety contactor must disconnect valve power if welded-contact protection is required.

Hardware stop latch | 12V / 1A NO valve outputs
Grounded contacts / 20mA wetting / +/-100V faults
Universal Poofer Control | Engineering
Sheet: /06 | Hardware stop latch and coil gate/
File: Hardware_Stop.kicad_sch
Title: 06 | Hardware stop latch and coil gate

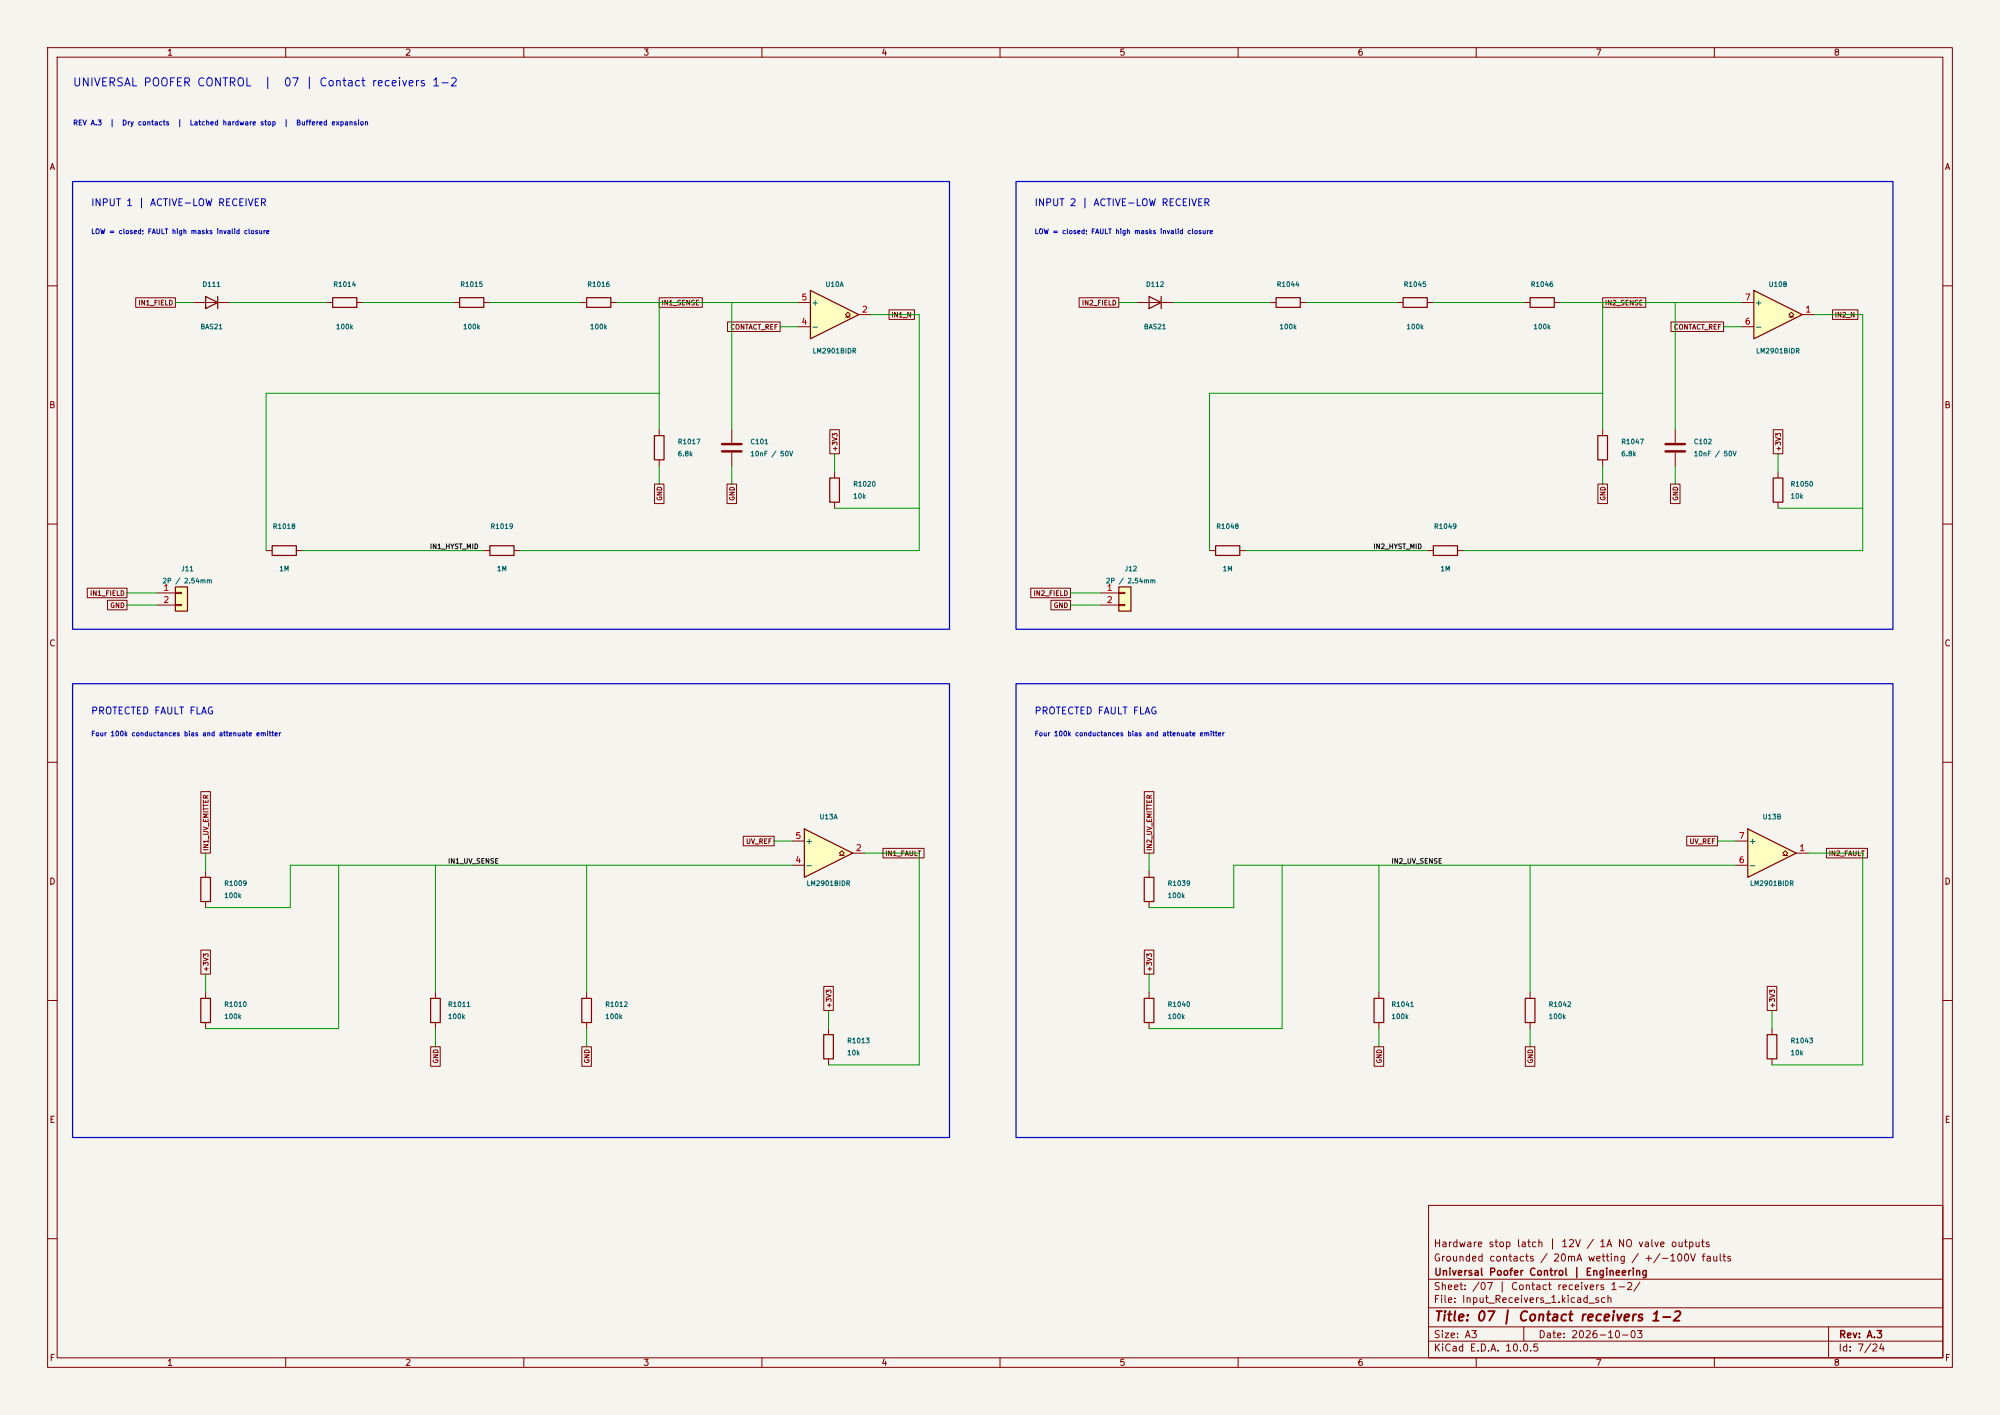
[picture p13: page 7]

REV A.3 | Dry contacts | Latched hardware stop | Buffered expansion UNIVERSAL POOFER CONTROL | 07 | Contact receivers 1-2

INPUT 1 | ACTIVE-LOW RECEIVER

INPUT 2 | ACTIVE-LOW RECEIVER

Four 100k conductances bias and attenuate emitter

Hardware stop latch | 12V / 1A NO valve outputs
Grounded contacts / 20mA wetting / +/-100V faults
Universal Poofer Control | Engineering
Sheet: /07 | Contact receivers 1-2/
File: Input_Receivers_1.kicad_sch
Title: 07 | Contact receivers 1-2

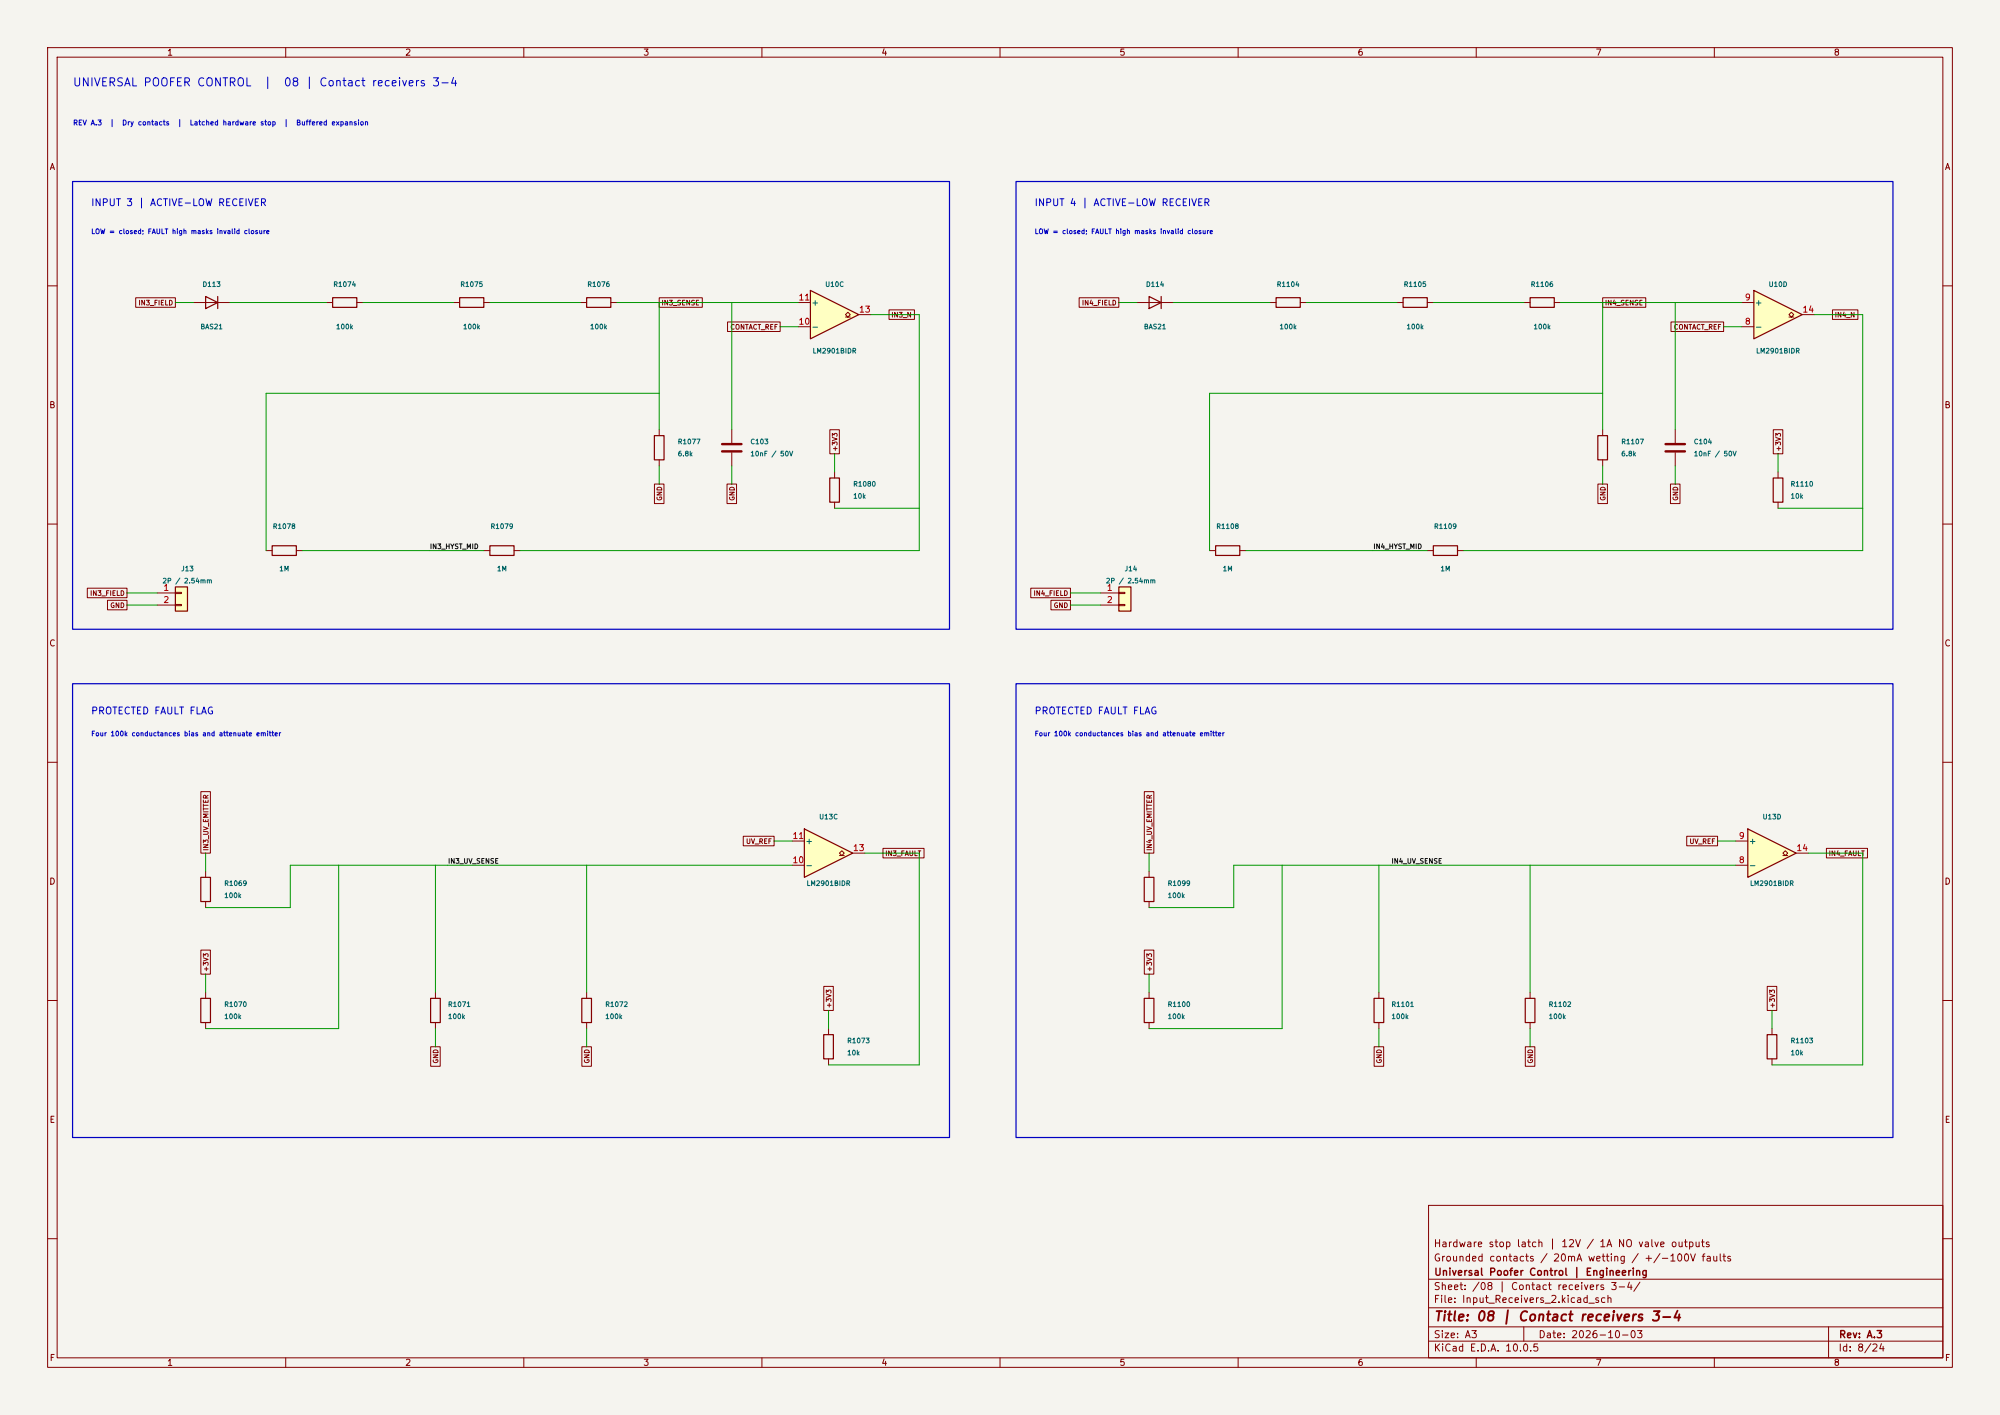
[picture p14: page 8]

REV A.3 | Dry contacts | Latched hardware stop | Buffered expansion UNIVERSAL POOFER CONTROL | 08 | Contact receivers 3-4

INPUT 3 | ACTIVE-LOW RECEIVER

INPUT 4 | ACTIVE-LOW RECEIVER

Four 100k conductances bias and attenuate emitter

Hardware stop latch | 12V / 1A NO valve outputs
Grounded contacts / 20mA wetting / +/-100V faults
Universal Poofer Control | Engineering
Sheet: /08 | Contact receivers 3-4/
File: Input_Receivers_2.kicad_sch
Title: 08 | Contact receivers 3-4

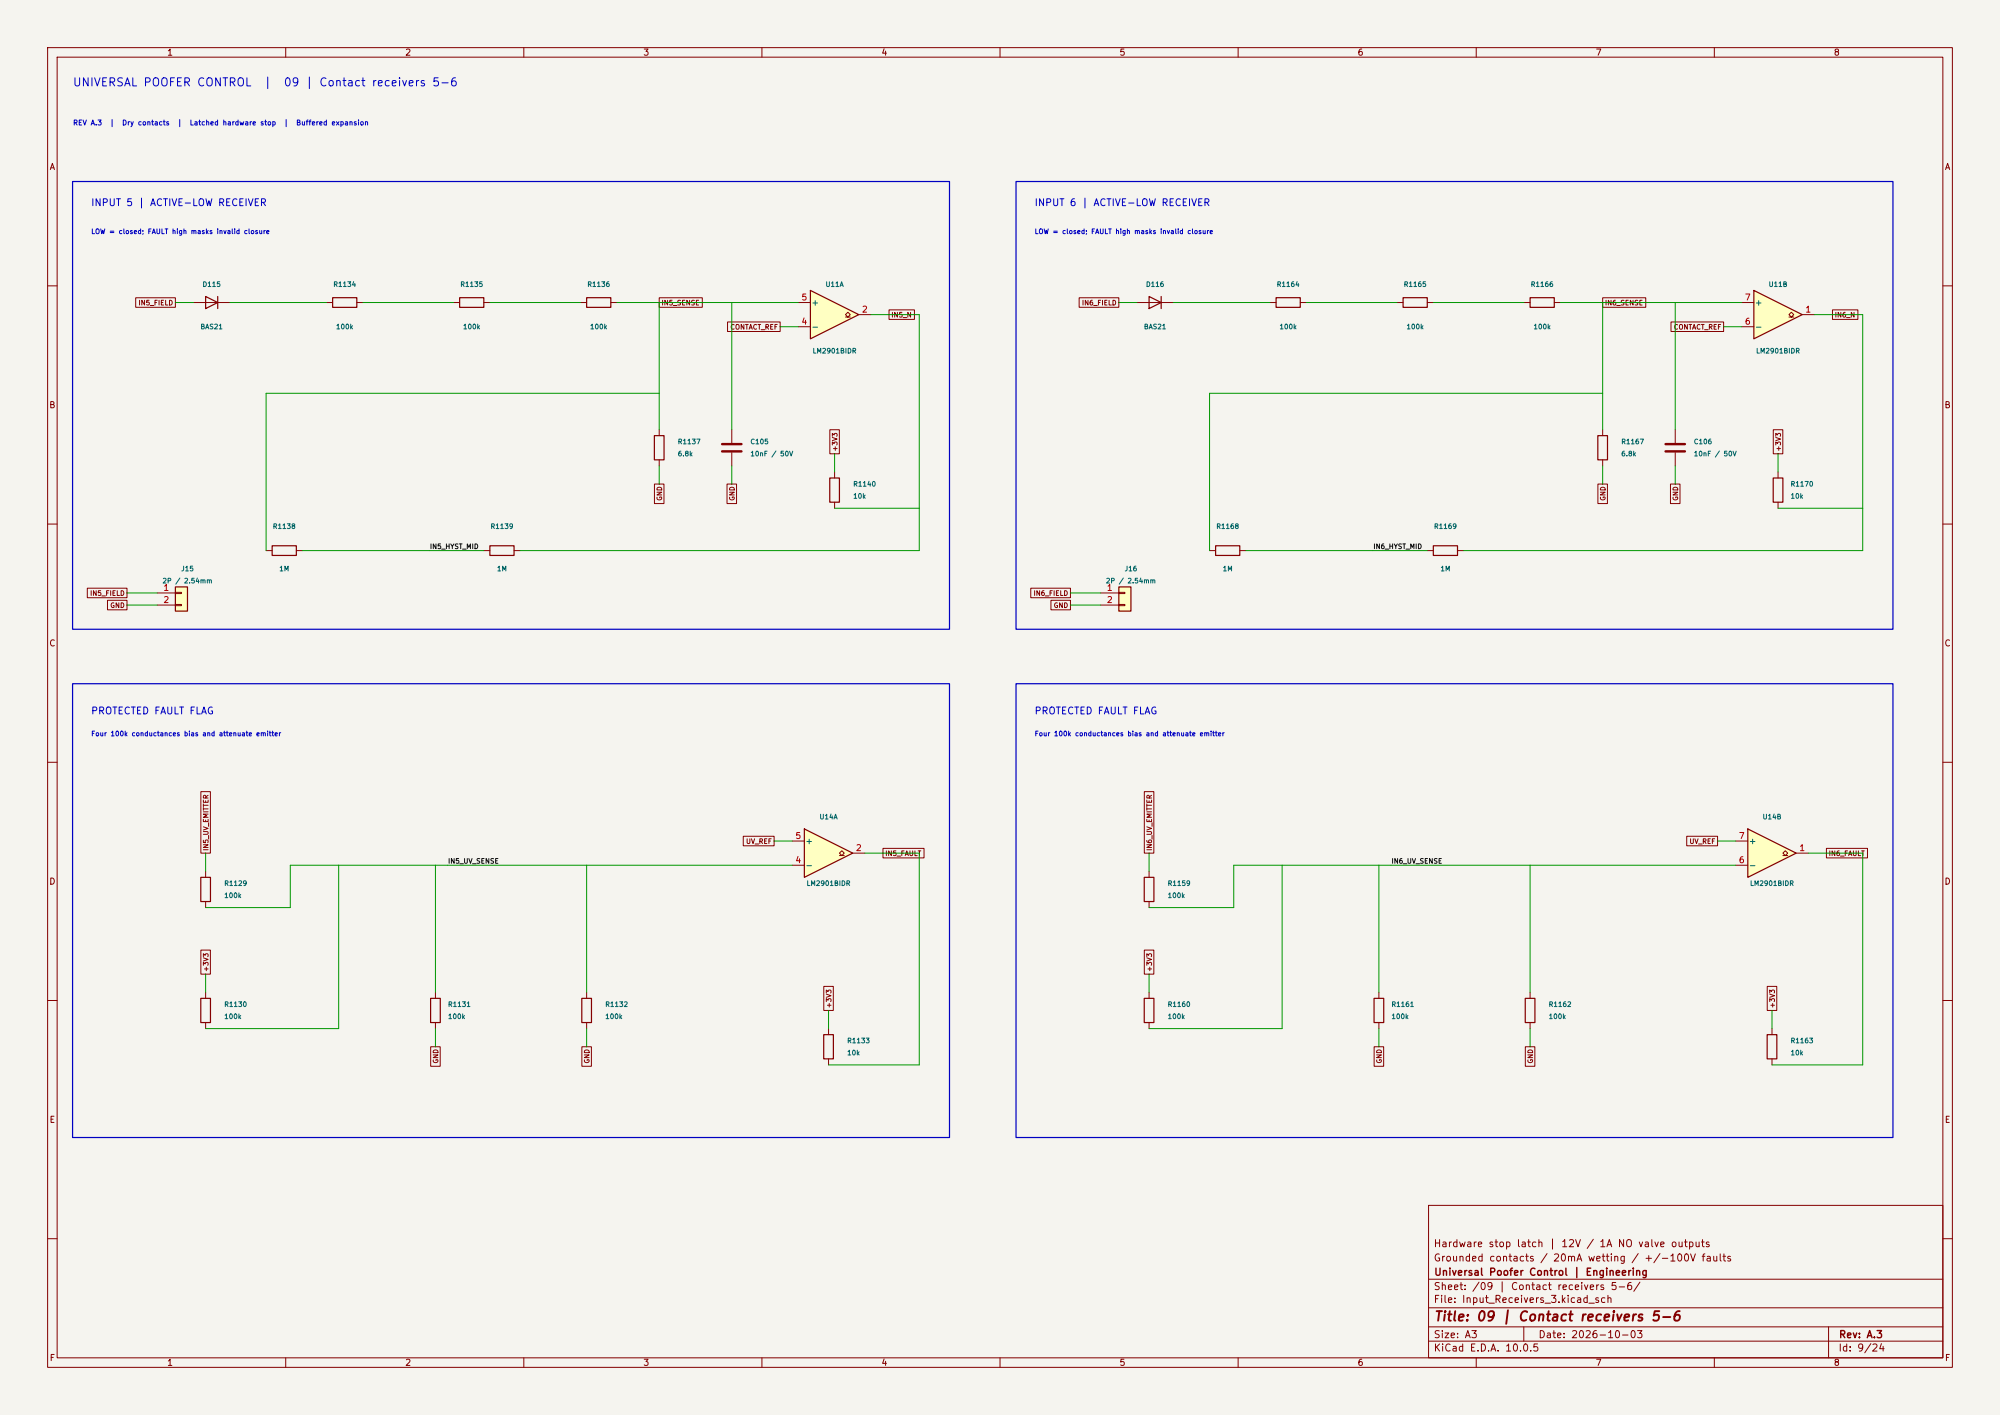
[picture p15: page 9]

REV A.3 | Dry contacts | Latched hardware stop | Buffered expansion UNIVERSAL POOFER CONTROL | 09 | Contact receivers 5-6

INPUT 5 | ACTIVE-LOW RECEIVER

INPUT 6 | ACTIVE-LOW RECEIVER

Four 100k conductances bias and attenuate emitter

Hardware stop latch | 12V / 1A NO valve outputs
Grounded contacts / 20mA wetting / +/-100V faults
Universal Poofer Control | Engineering
Sheet: /09 | Contact receivers 5-6/
File: Input_Receivers_3.kicad_sch
Title: 09 | Contact receivers 5-6

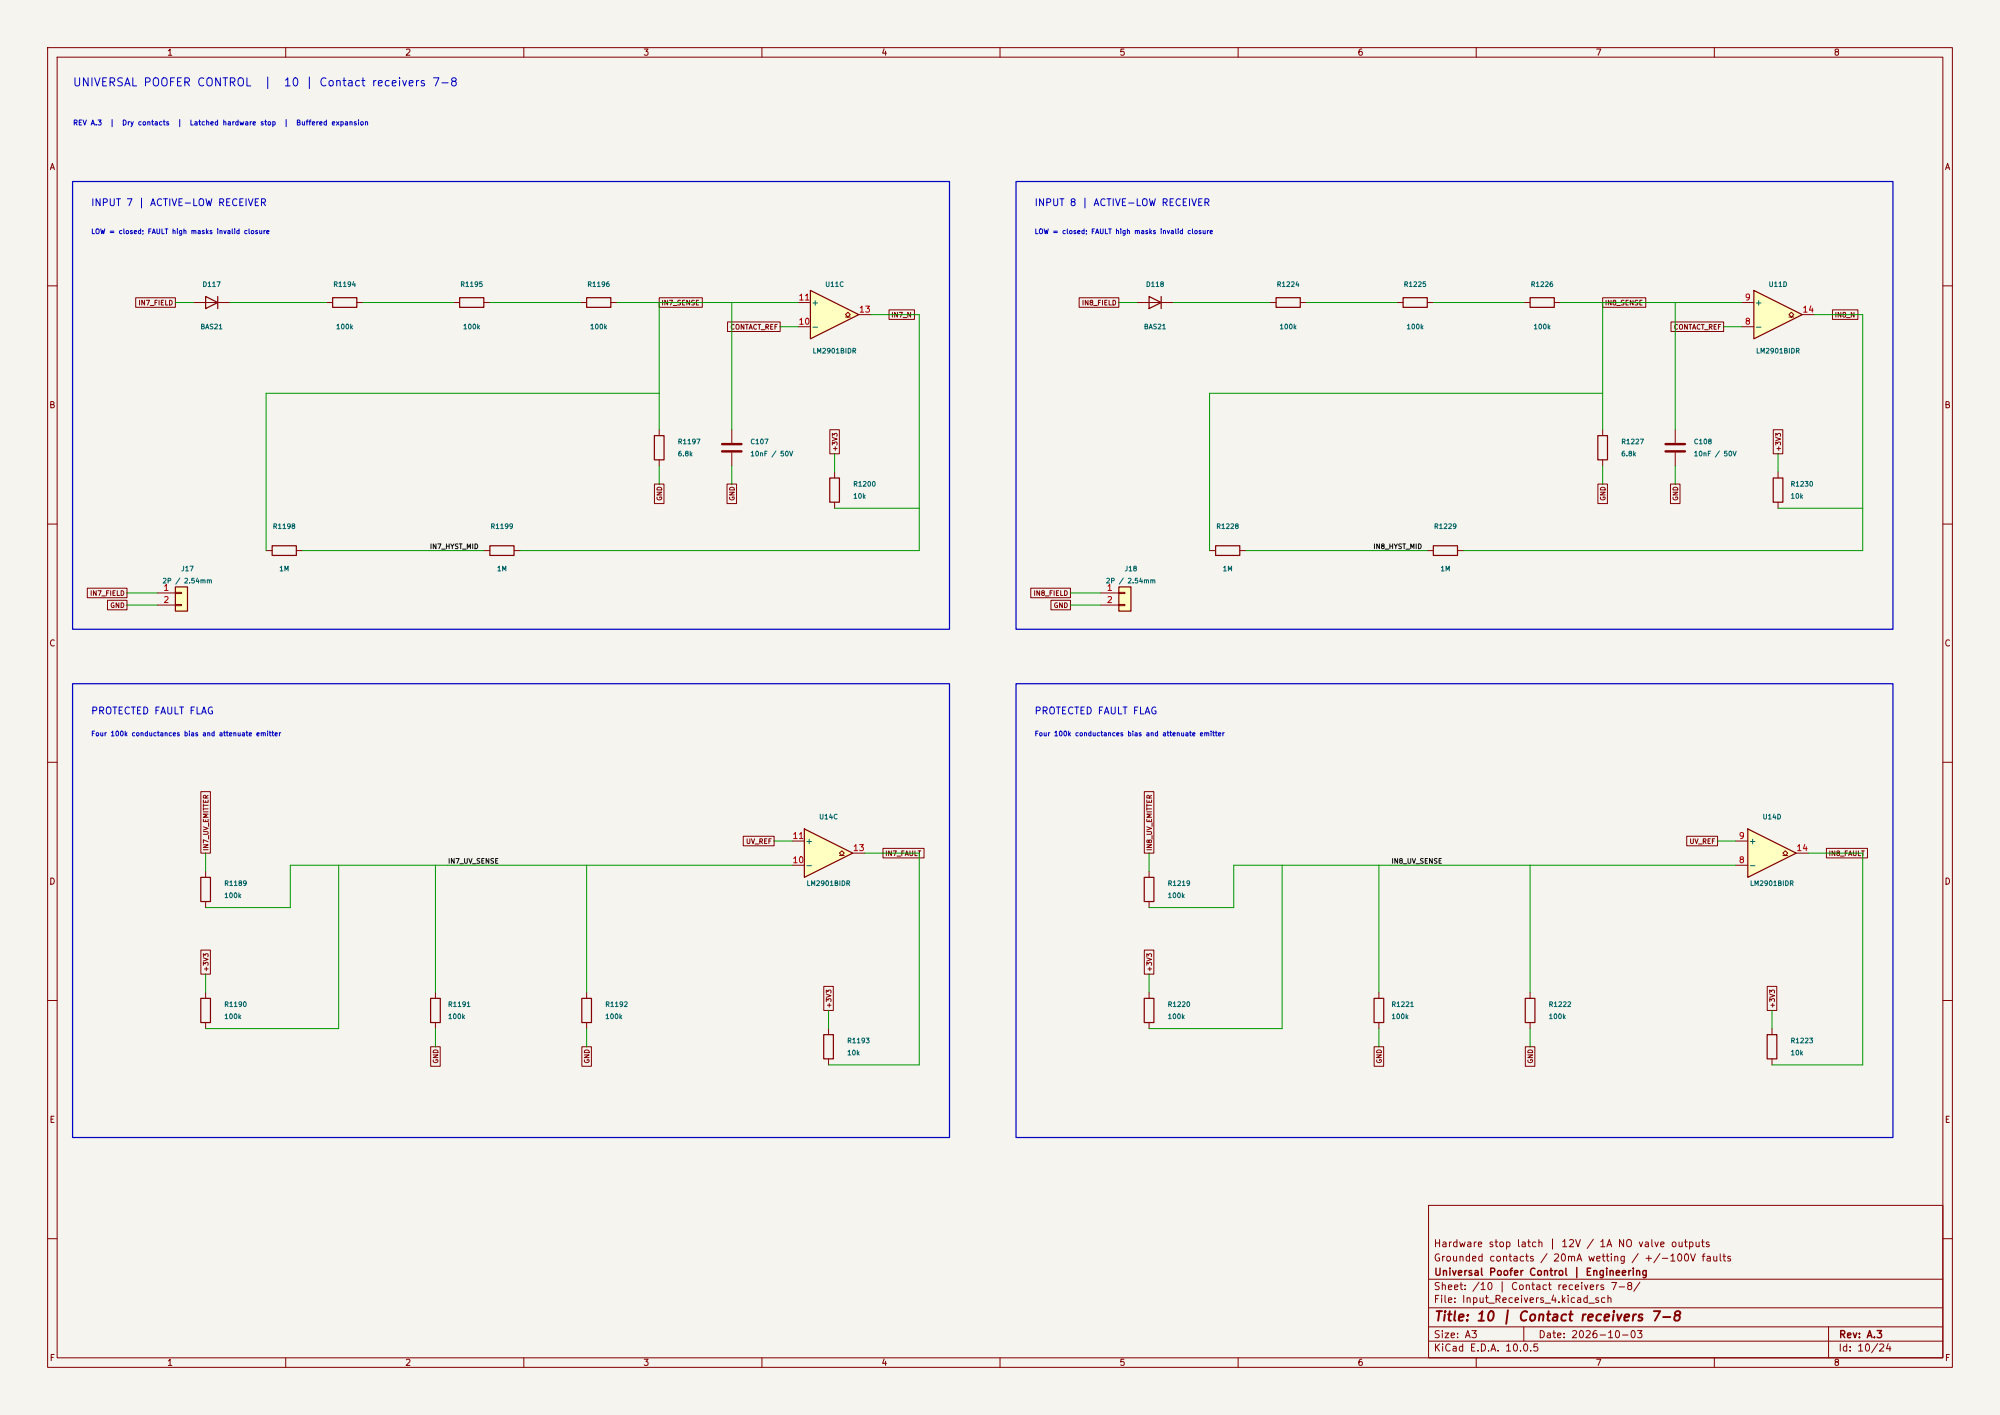
[picture p16: page 10]

REV A.3 | Dry contacts | Latched hardware stop | Buffered expansion UNIVERSAL POOFER CONTROL | 10 | Contact receivers 7-8

INPUT 7 | ACTIVE-LOW RECEIVER

INPUT 8 | ACTIVE-LOW RECEIVER

Four 100k conductances bias and attenuate emitter

Hardware stop latch | 12V / 1A NO valve outputs
Grounded contacts / 20mA wetting / +/-100V faults
Universal Poofer Control | Engineering
Sheet: /10 | Contact receivers 7-8/
File: Input_Receivers_4.kicad_sch
Title: 10 | Contact receivers 7-8

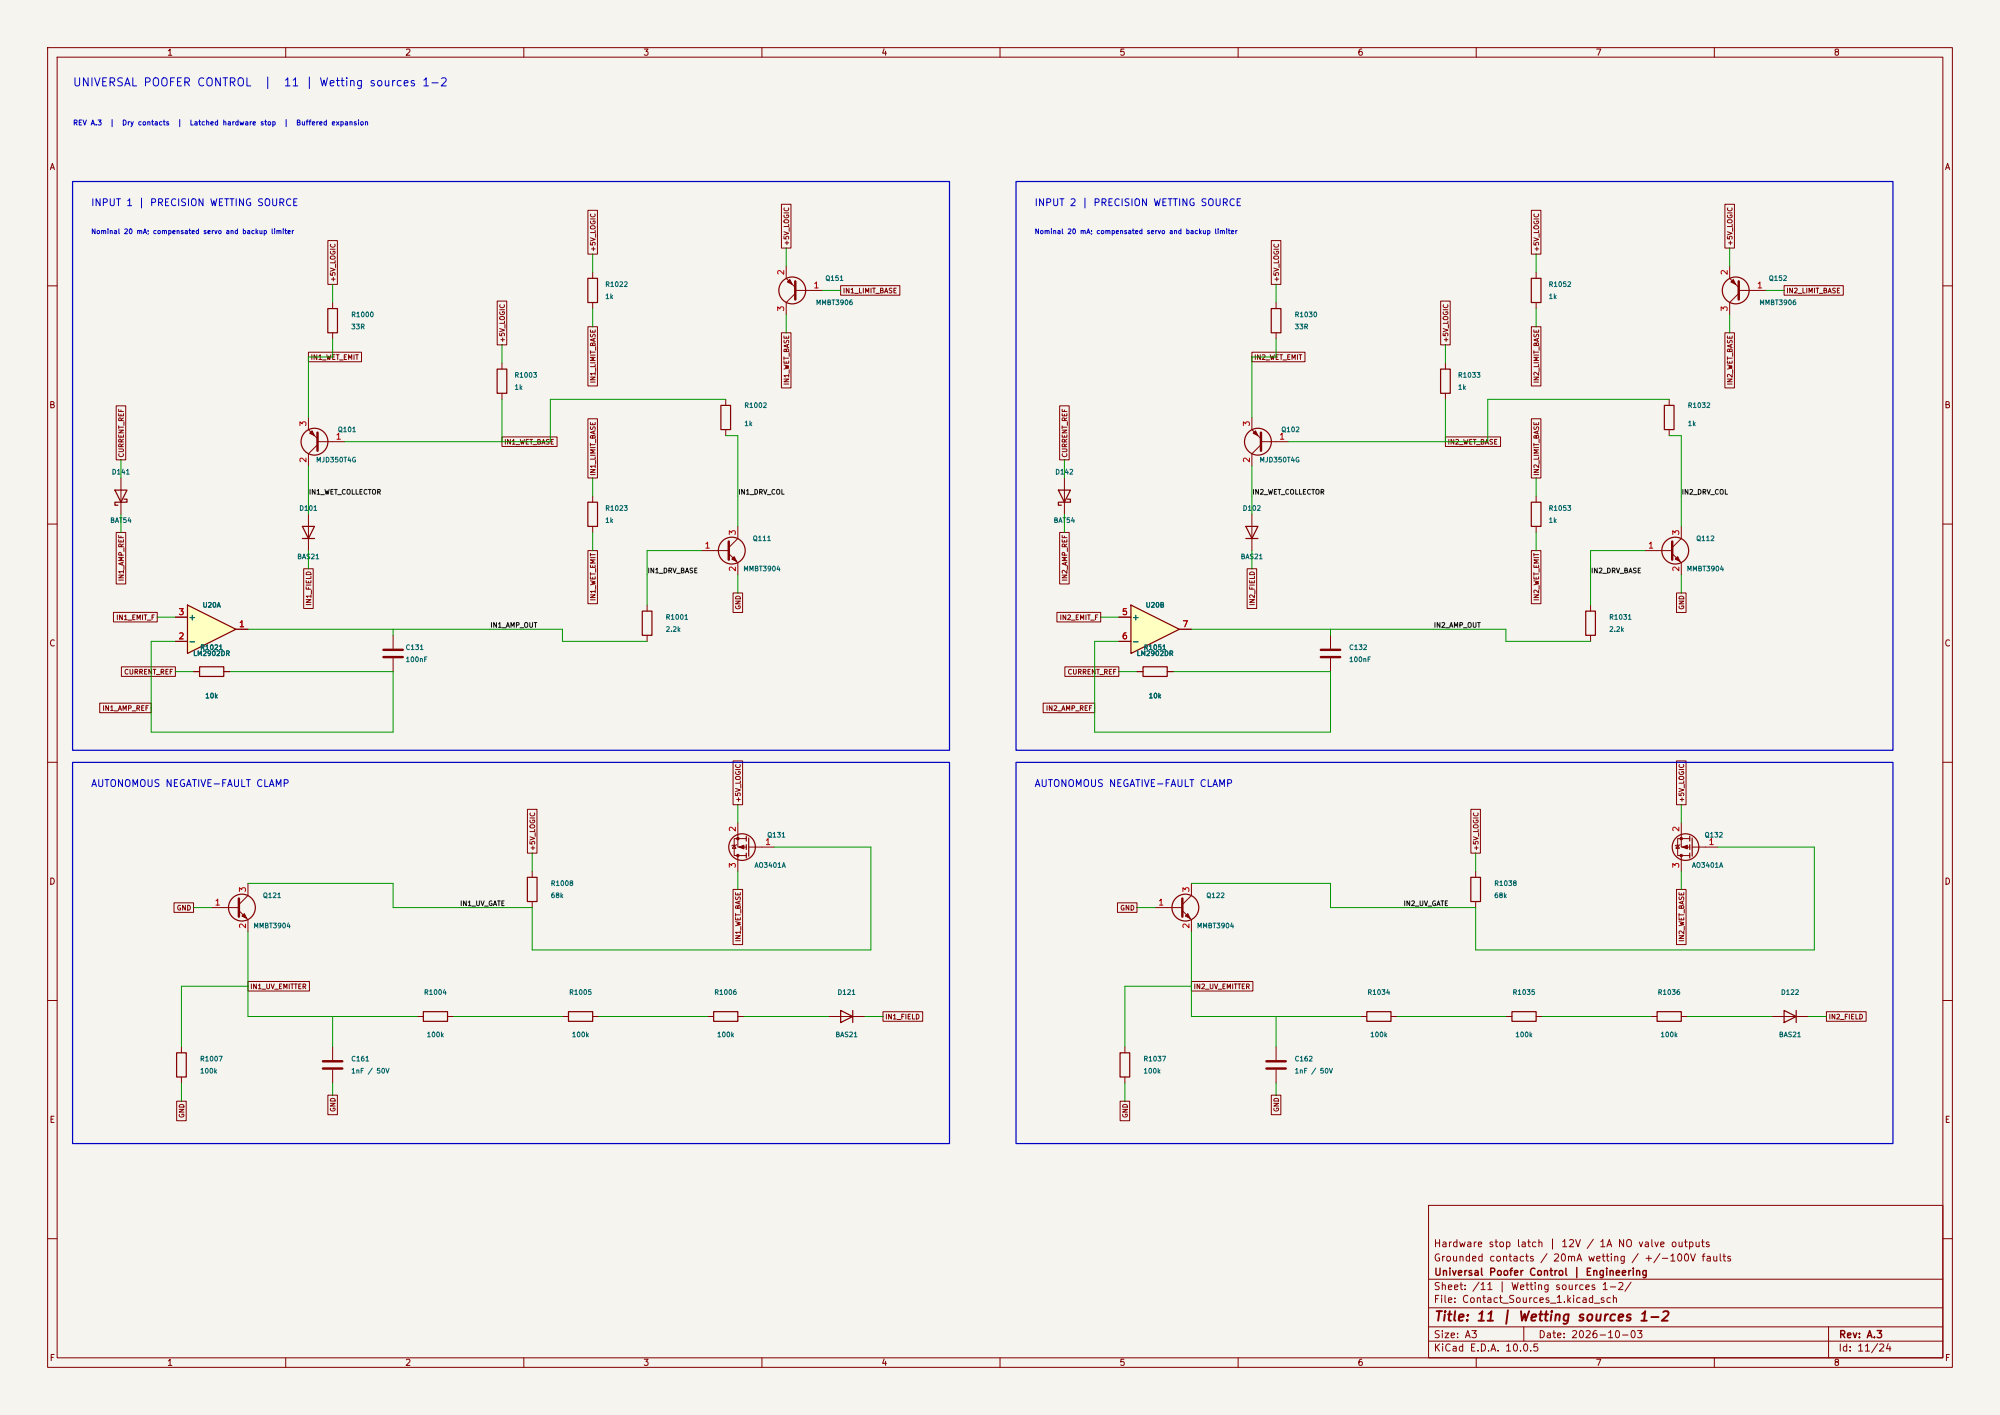
[picture p17: page 11]

REV A.3 | Dry contacts | Latched hardware stop | Buffered expansion UNIVERSAL POOFER CONTROL | 11 | Wetting sources 1-2

INPUT 1 | PRECISION WETTING SOURCE

IN1_UV_GATE AUTONOMOUS NEGATIVE-FAULT CLAMP

AUTONOMOUS NEGATIVE-FAULT CLAMP

Hardware stop latch | 12V / 1A NO valve outputs
Grounded contacts / 20mA wetting / +/-100V faults
Universal Poofer Control | Engineering
Sheet: /11 | Wetting sources 1-2/
File: Contact_Sources_1.kicad_sch
Title: 11 | Wetting sources 1-2

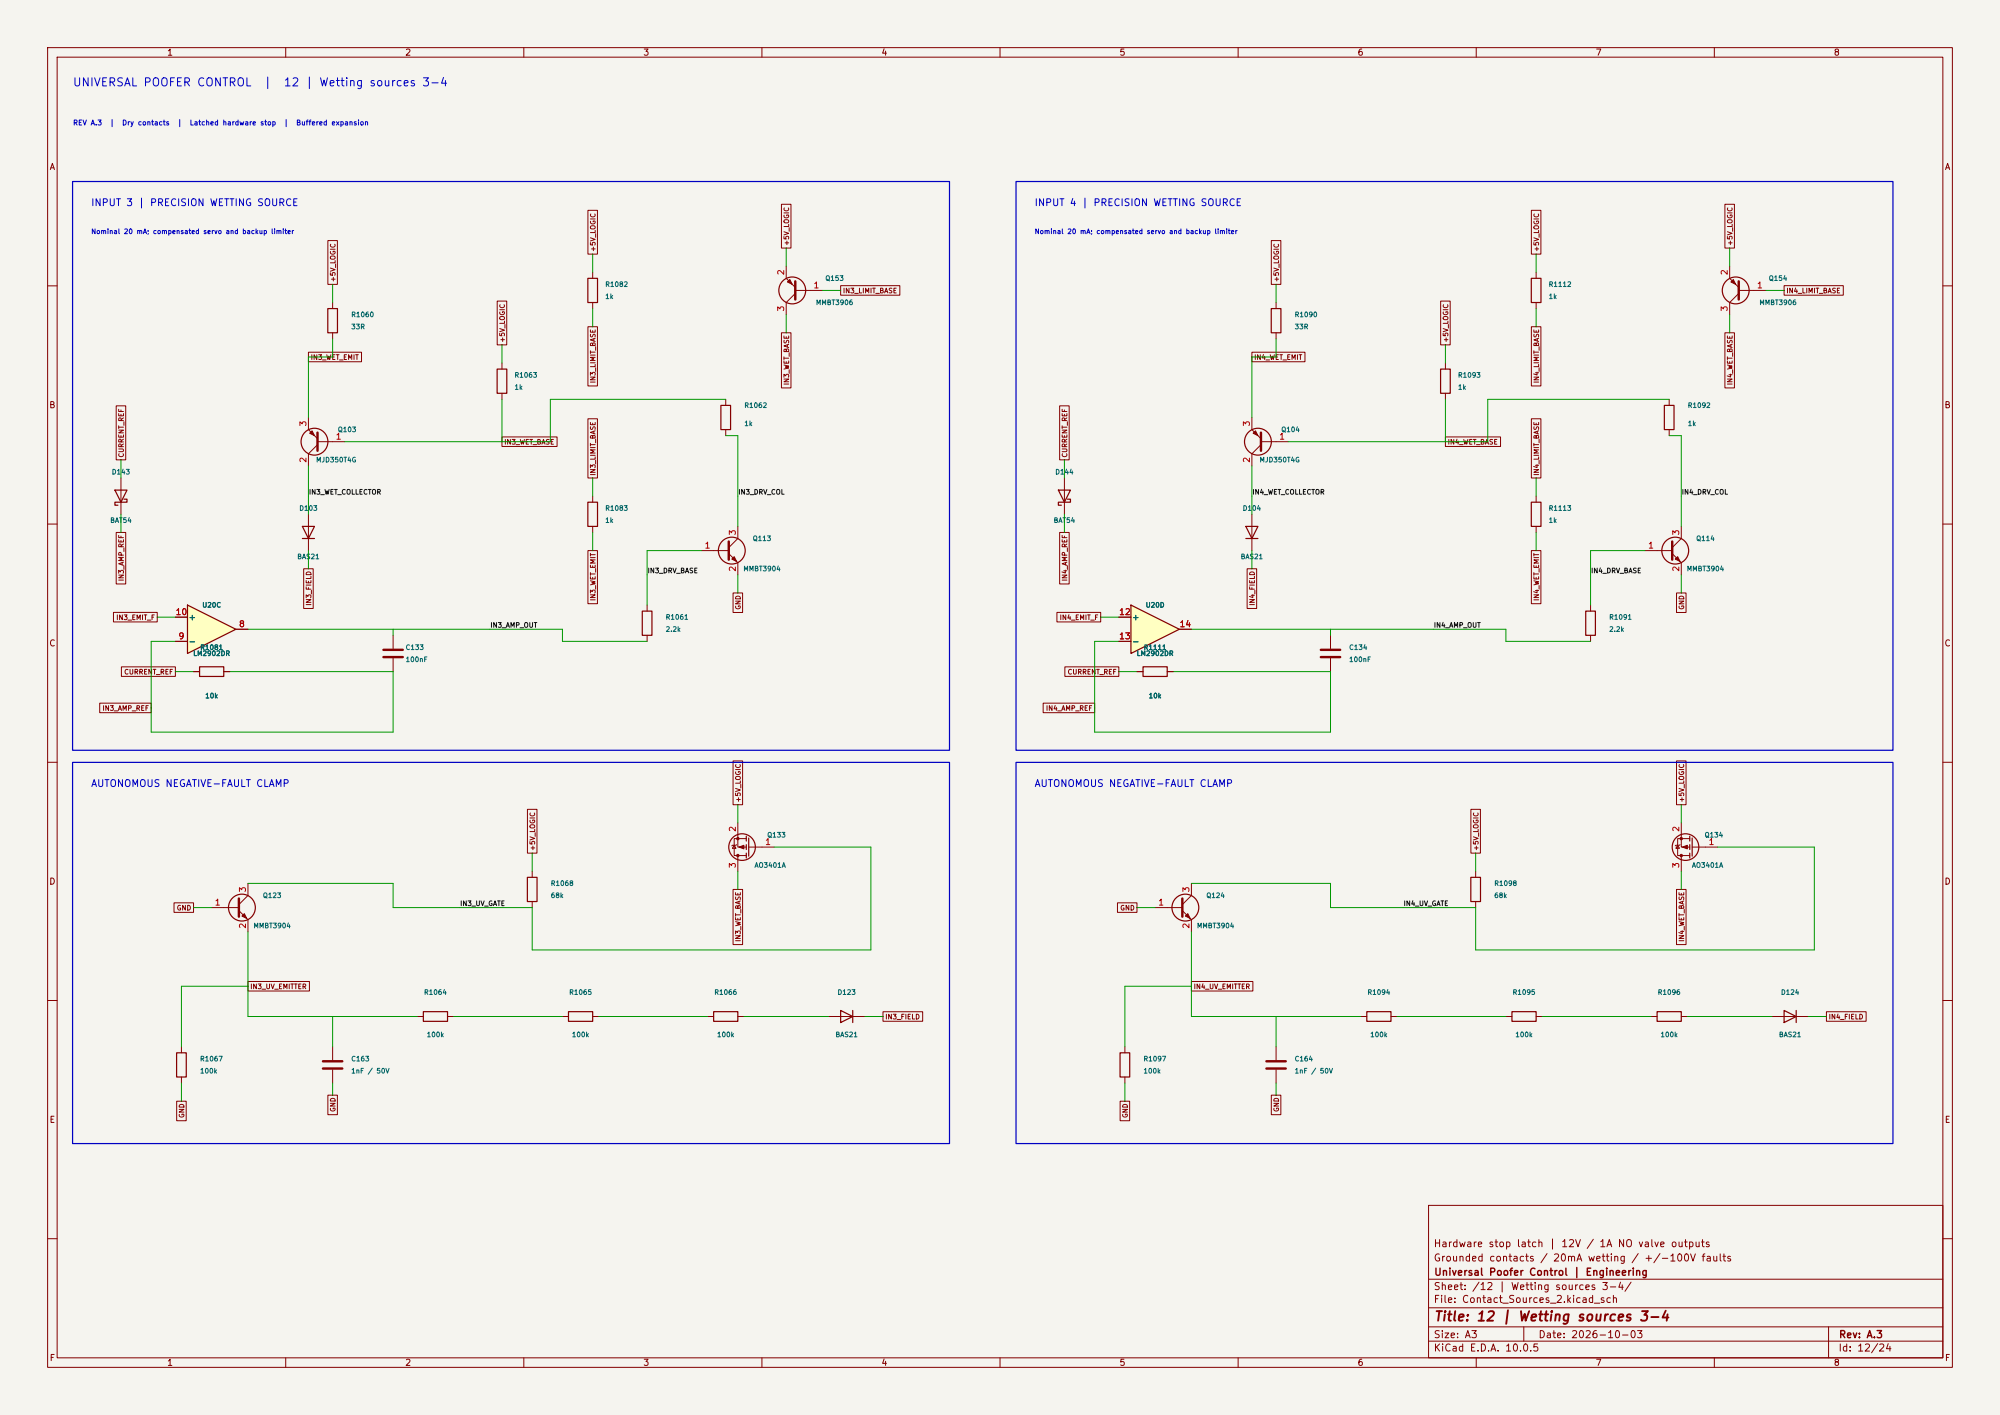
[picture p18: page 12]

REV A.3 | Dry contacts | Latched hardware stop | Buffered expansion UNIVERSAL POOFER CONTROL | 12 | Wetting sources 3-4

INPUT 3 | PRECISION WETTING SOURCE

IN3_UV_GATE AUTONOMOUS NEGATIVE-FAULT CLAMP

AUTONOMOUS NEGATIVE-FAULT CLAMP

Hardware stop latch | 12V / 1A NO valve outputs
Grounded contacts / 20mA wetting / +/-100V faults
Universal Poofer Control | Engineering
Sheet: /12 | Wetting sources 3-4/
File: Contact_Sources_2.kicad_sch
Title: 12 | Wetting sources 3-4

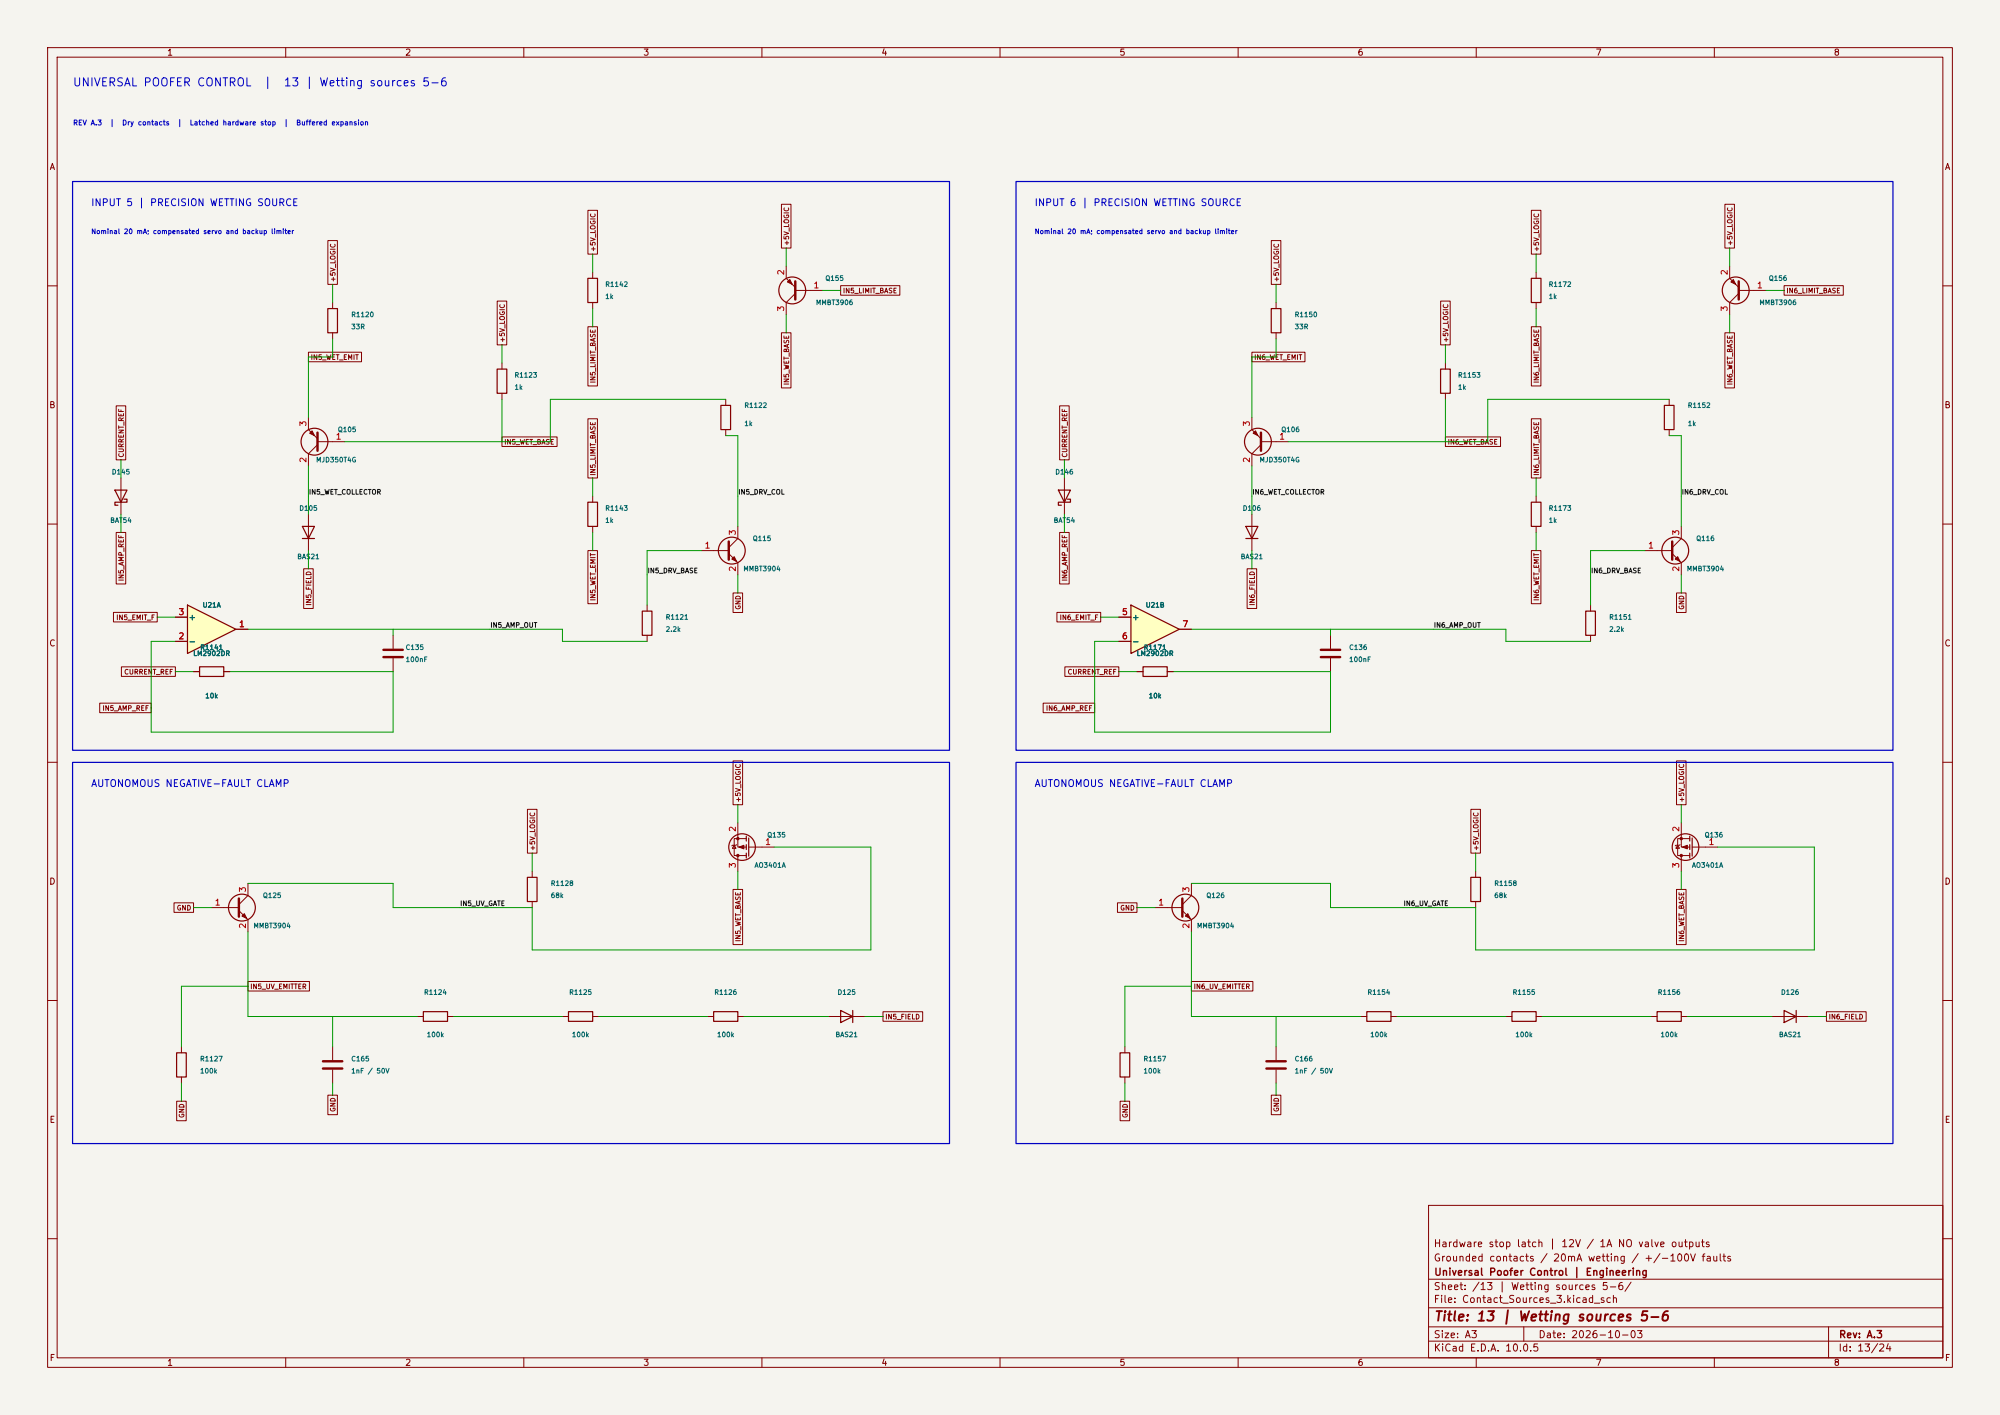
[picture p19: page 13]

REV A.3 | Dry contacts | Latched hardware stop | Buffered expansion UNIVERSAL POOFER CONTROL | 13 | Wetting sources 5-6

INPUT 5 | PRECISION WETTING SOURCE

IN5_UV_GATE AUTONOMOUS NEGATIVE-FAULT CLAMP

AUTONOMOUS NEGATIVE-FAULT CLAMP

Hardware stop latch | 12V / 1A NO valve outputs
Grounded contacts / 20mA wetting / +/-100V faults
Universal Poofer Control | Engineering
Sheet: /13 | Wetting sources 5-6/
File: Contact_Sources_3.kicad_sch
Title: 13 | Wetting sources 5-6

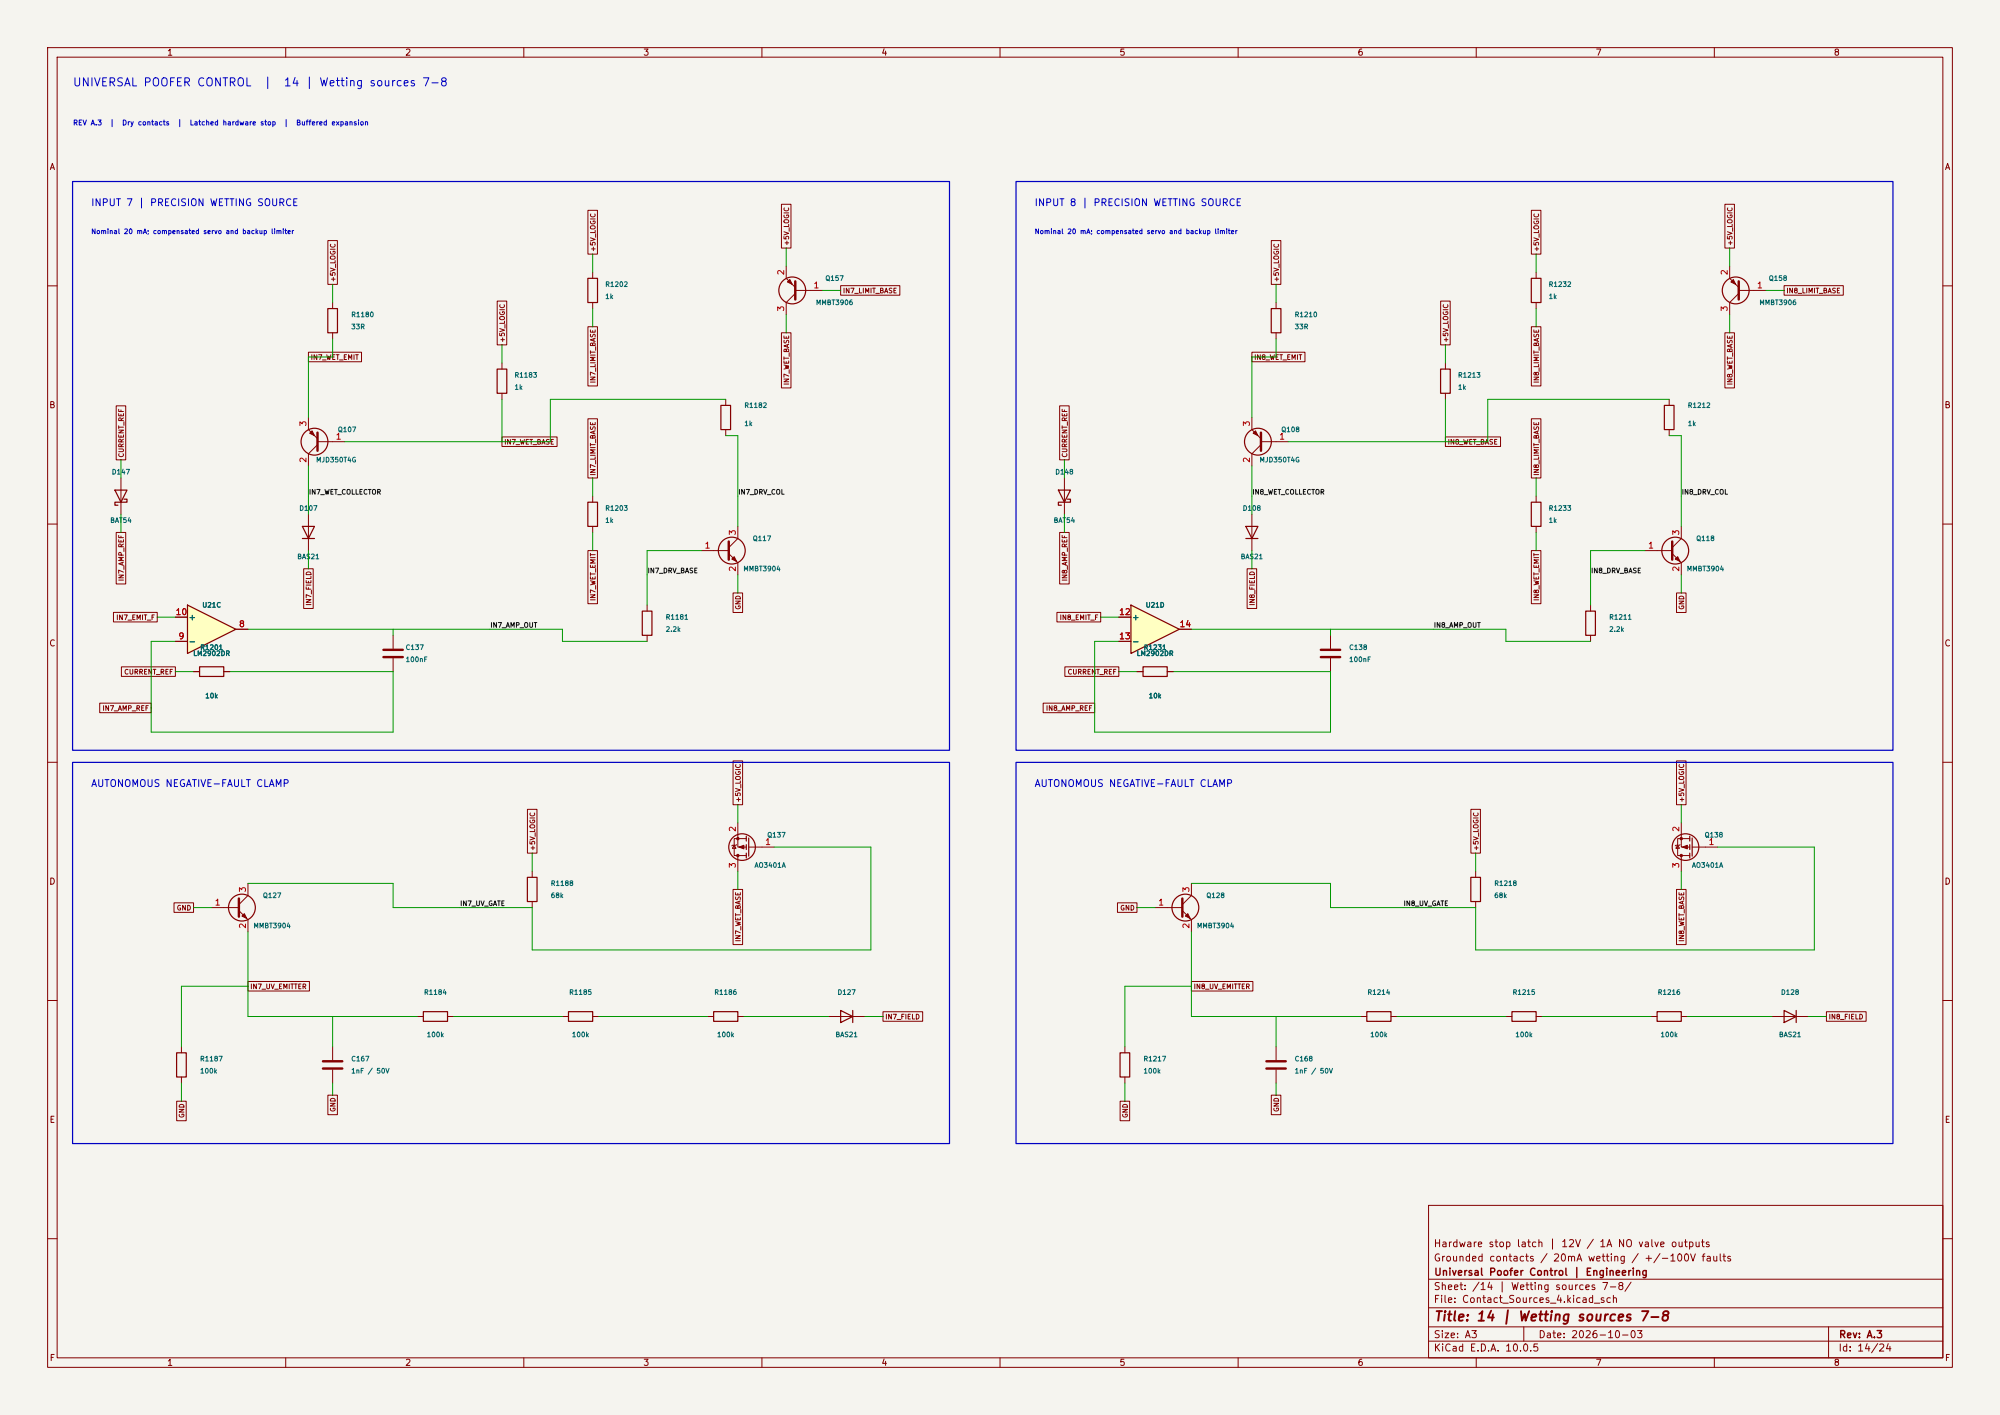
[picture p20: page 14]

REV A.3 | Dry contacts | Latched hardware stop | Buffered expansion UNIVERSAL POOFER CONTROL | 14 | Wetting sources 7-8

INPUT 7 | PRECISION WETTING SOURCE

IN7_UV_GATE AUTONOMOUS NEGATIVE-FAULT CLAMP

AUTONOMOUS NEGATIVE-FAULT CLAMP

Hardware stop latch | 12V / 1A NO valve outputs
Grounded contacts / 20mA wetting / +/-100V faults
Universal Poofer Control | Engineering
Sheet: /14 | Wetting sources 7-8/
File: Contact_Sources_4.kicad_sch
Title: 14 | Wetting sources 7-8

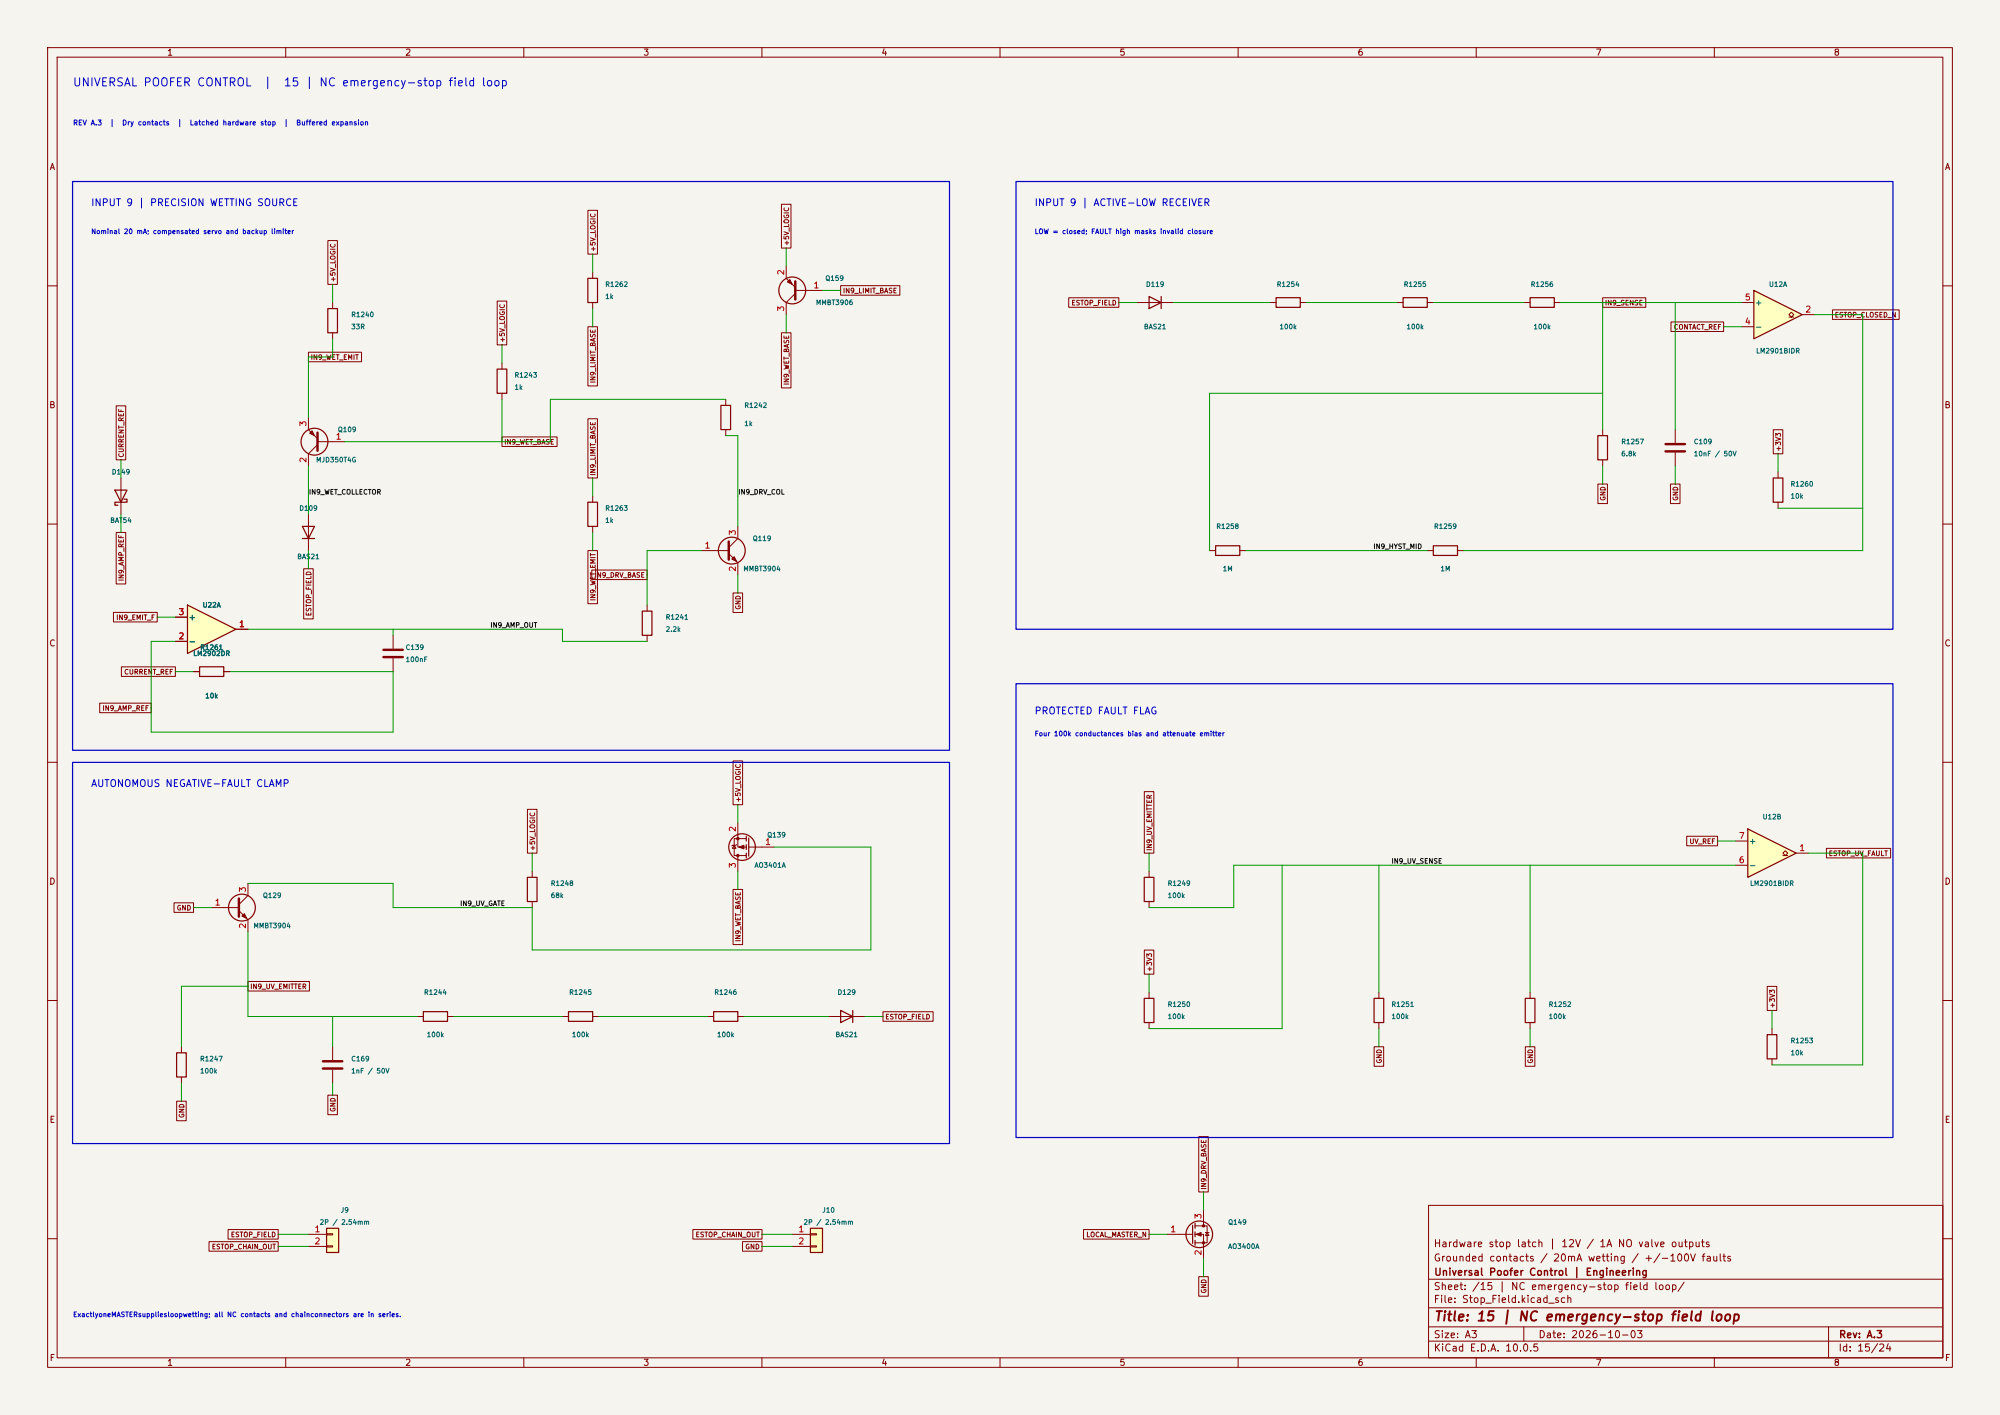
[picture p21: page 15]

REV A.3 | Dry contacts | Latched hardware stop | Buffered expansion UNIVERSAL POOFER CONTROL | 15 | NC emergency-stop field loop

INPUT 9 | PRECISION WETTING SOURCE

INPUT 9 | ACTIVE-LOW RECEIVER

LOW = closed; FAULT high masks invalid closure AUTONOMOUS NEGATIVE-FAULT CLAMP

Nominal 20 mA; compensated servo and backup limiter

Four 100k conductances bias and attenuate emitter PROTECTED FAULT FLAG

Hardware stop latch | 12V / 1A NO valve outputs
Grounded contacts / 20mA wetting / +/-100V faults
Universal Poofer Control | Engineering
Sheet: /15 | NC emergency-stop field loop/
File: Stop_Field.kicad_sch
Title: 15 | NC emergency-stop field loop

ExactlyoneMASTERsuppliesloopwetting; all NC contacts and chainconnectors are in series.

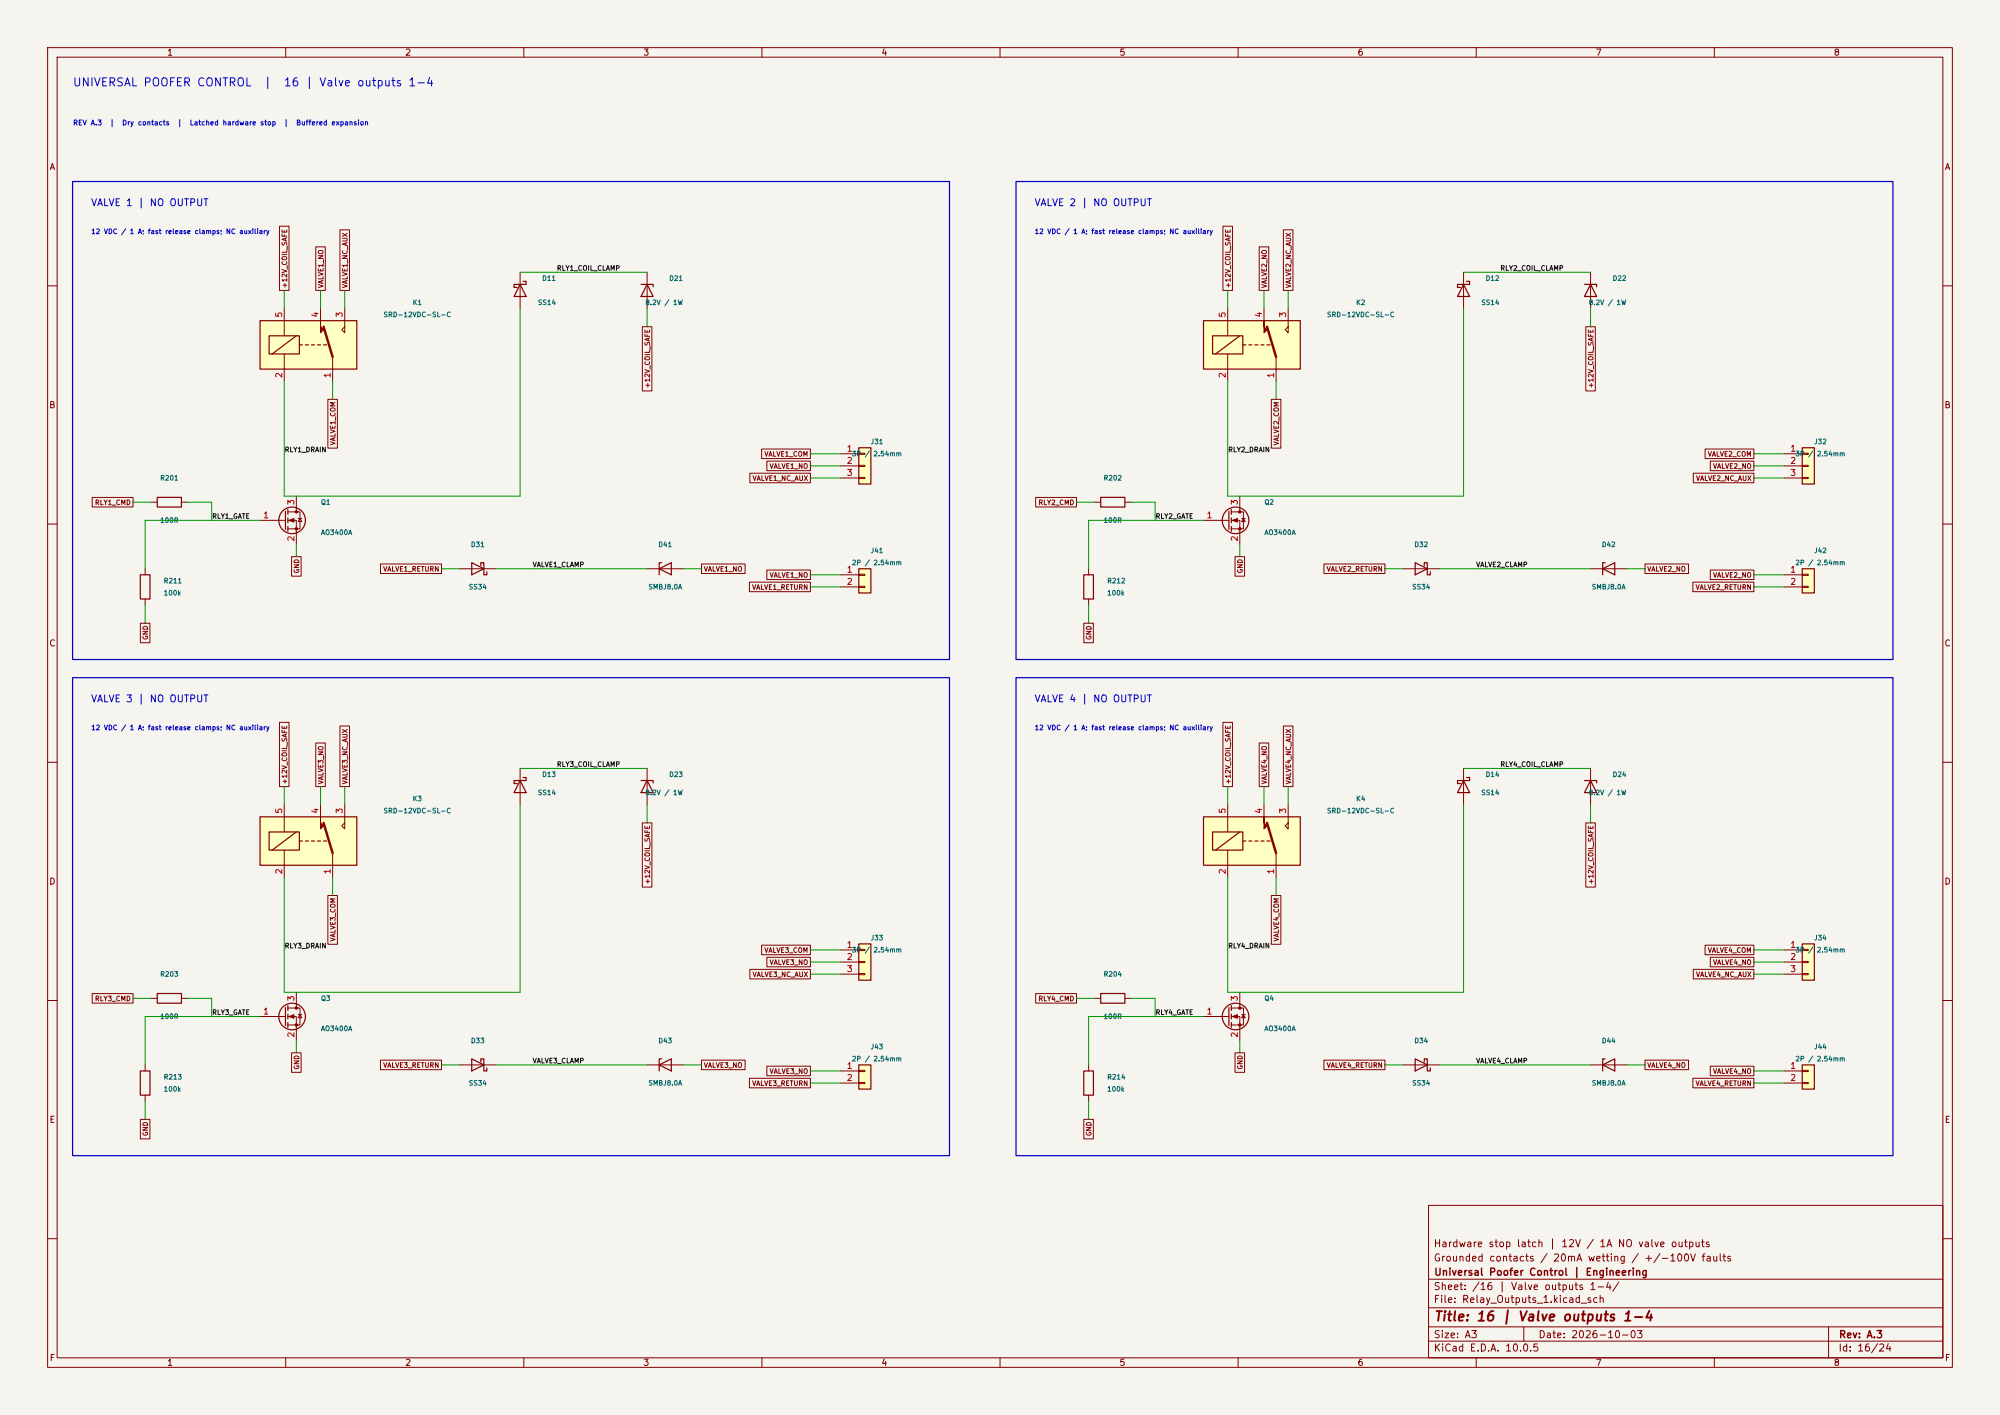
[picture p22: page 16]

REV A.3 | Dry contacts | Latched hardware stop | Buffered expansion UNIVERSAL POOFER CONTROL | 16 | Valve outputs 1-4

12 VDC / 1 A; fast release clamps; NC auxiliary VALVE 1 | NO OUTPUT

12 VDC / 1 A; fast release clamps; NC auxiliary VALVE 3 | NO OUTPUT

12 VDC / 1 A; fast release clamps; NC auxiliary VALVE 4 | NO OUTPUT

12 VDC / 1 A; fast release clamps; NC auxiliary

Hardware stop latch | 12V / 1A NO valve outputs
Grounded contacts / 20mA wetting / +/-100V faults
Universal Poofer Control | Engineering
Sheet: /16 | Valve outputs 1-4/
File: Relay_Outputs_1.kicad_sch
Title: 16 | Valve outputs 1-4

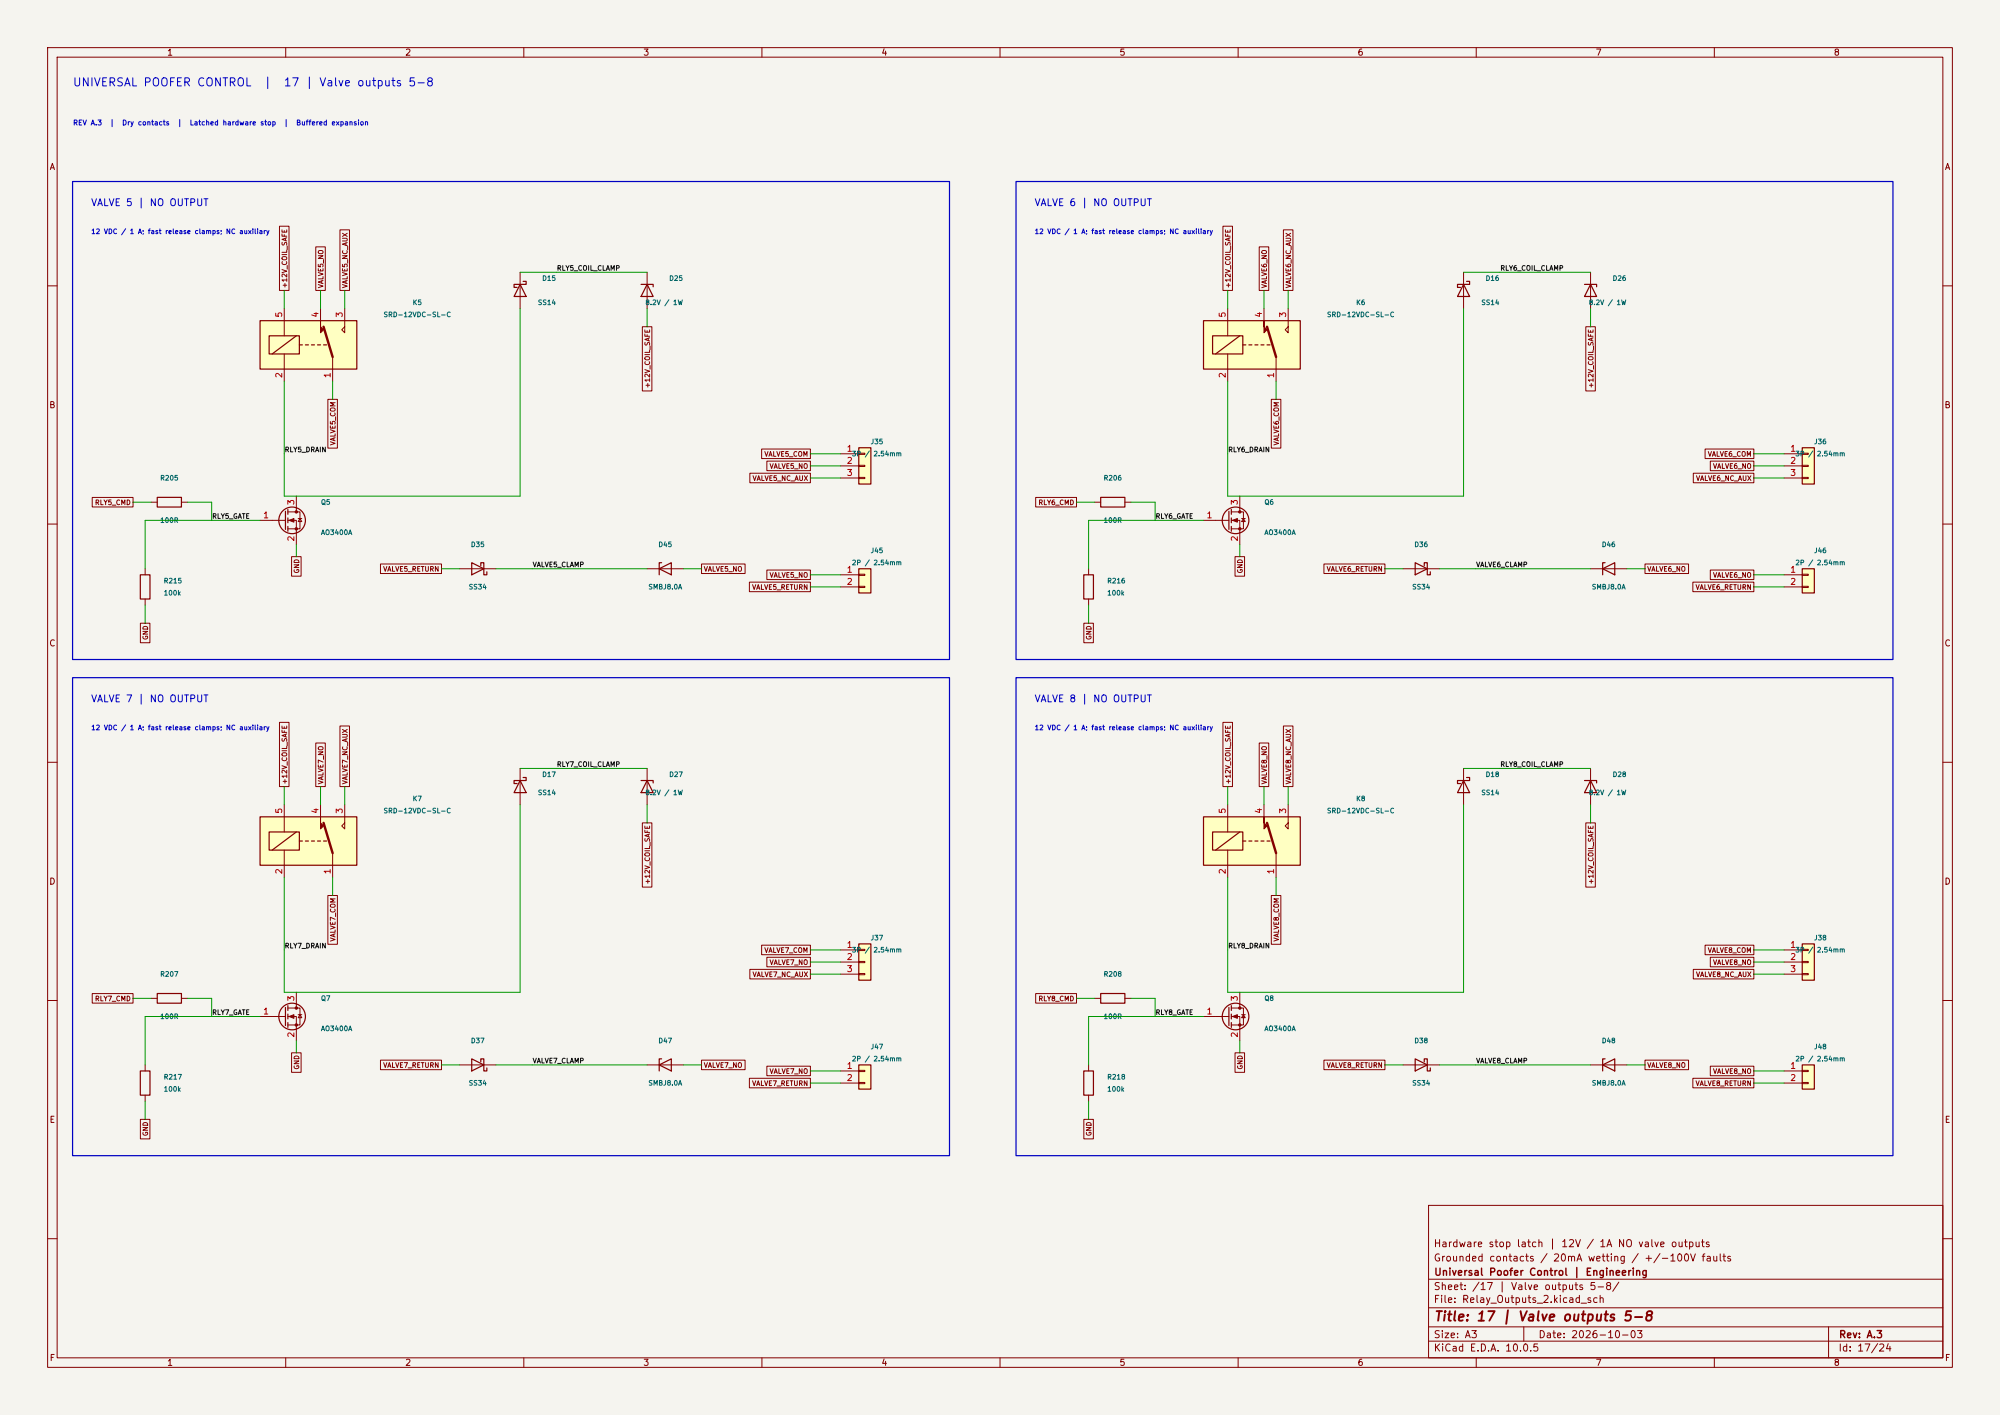
[picture p23: page 17]

REV A.3 | Dry contacts | Latched hardware stop | Buffered expansion UNIVERSAL POOFER CONTROL | 17 | Valve outputs 5-8

12 VDC / 1 A; fast release clamps; NC auxiliary VALVE 5 | NO OUTPUT

12 VDC / 1 A; fast release clamps; NC auxiliary VALVE 7 | NO OUTPUT

12 VDC / 1 A; fast release clamps; NC auxiliary VALVE 8 | NO OUTPUT

12 VDC / 1 A; fast release clamps; NC auxiliary

Hardware stop latch | 12V / 1A NO valve outputs
Grounded contacts / 20mA wetting / +/-100V faults
Universal Poofer Control | Engineering
Sheet: /17 | Valve outputs 5-8/
File: Relay_Outputs_2.kicad_sch
Title: 17 | Valve outputs 5-8

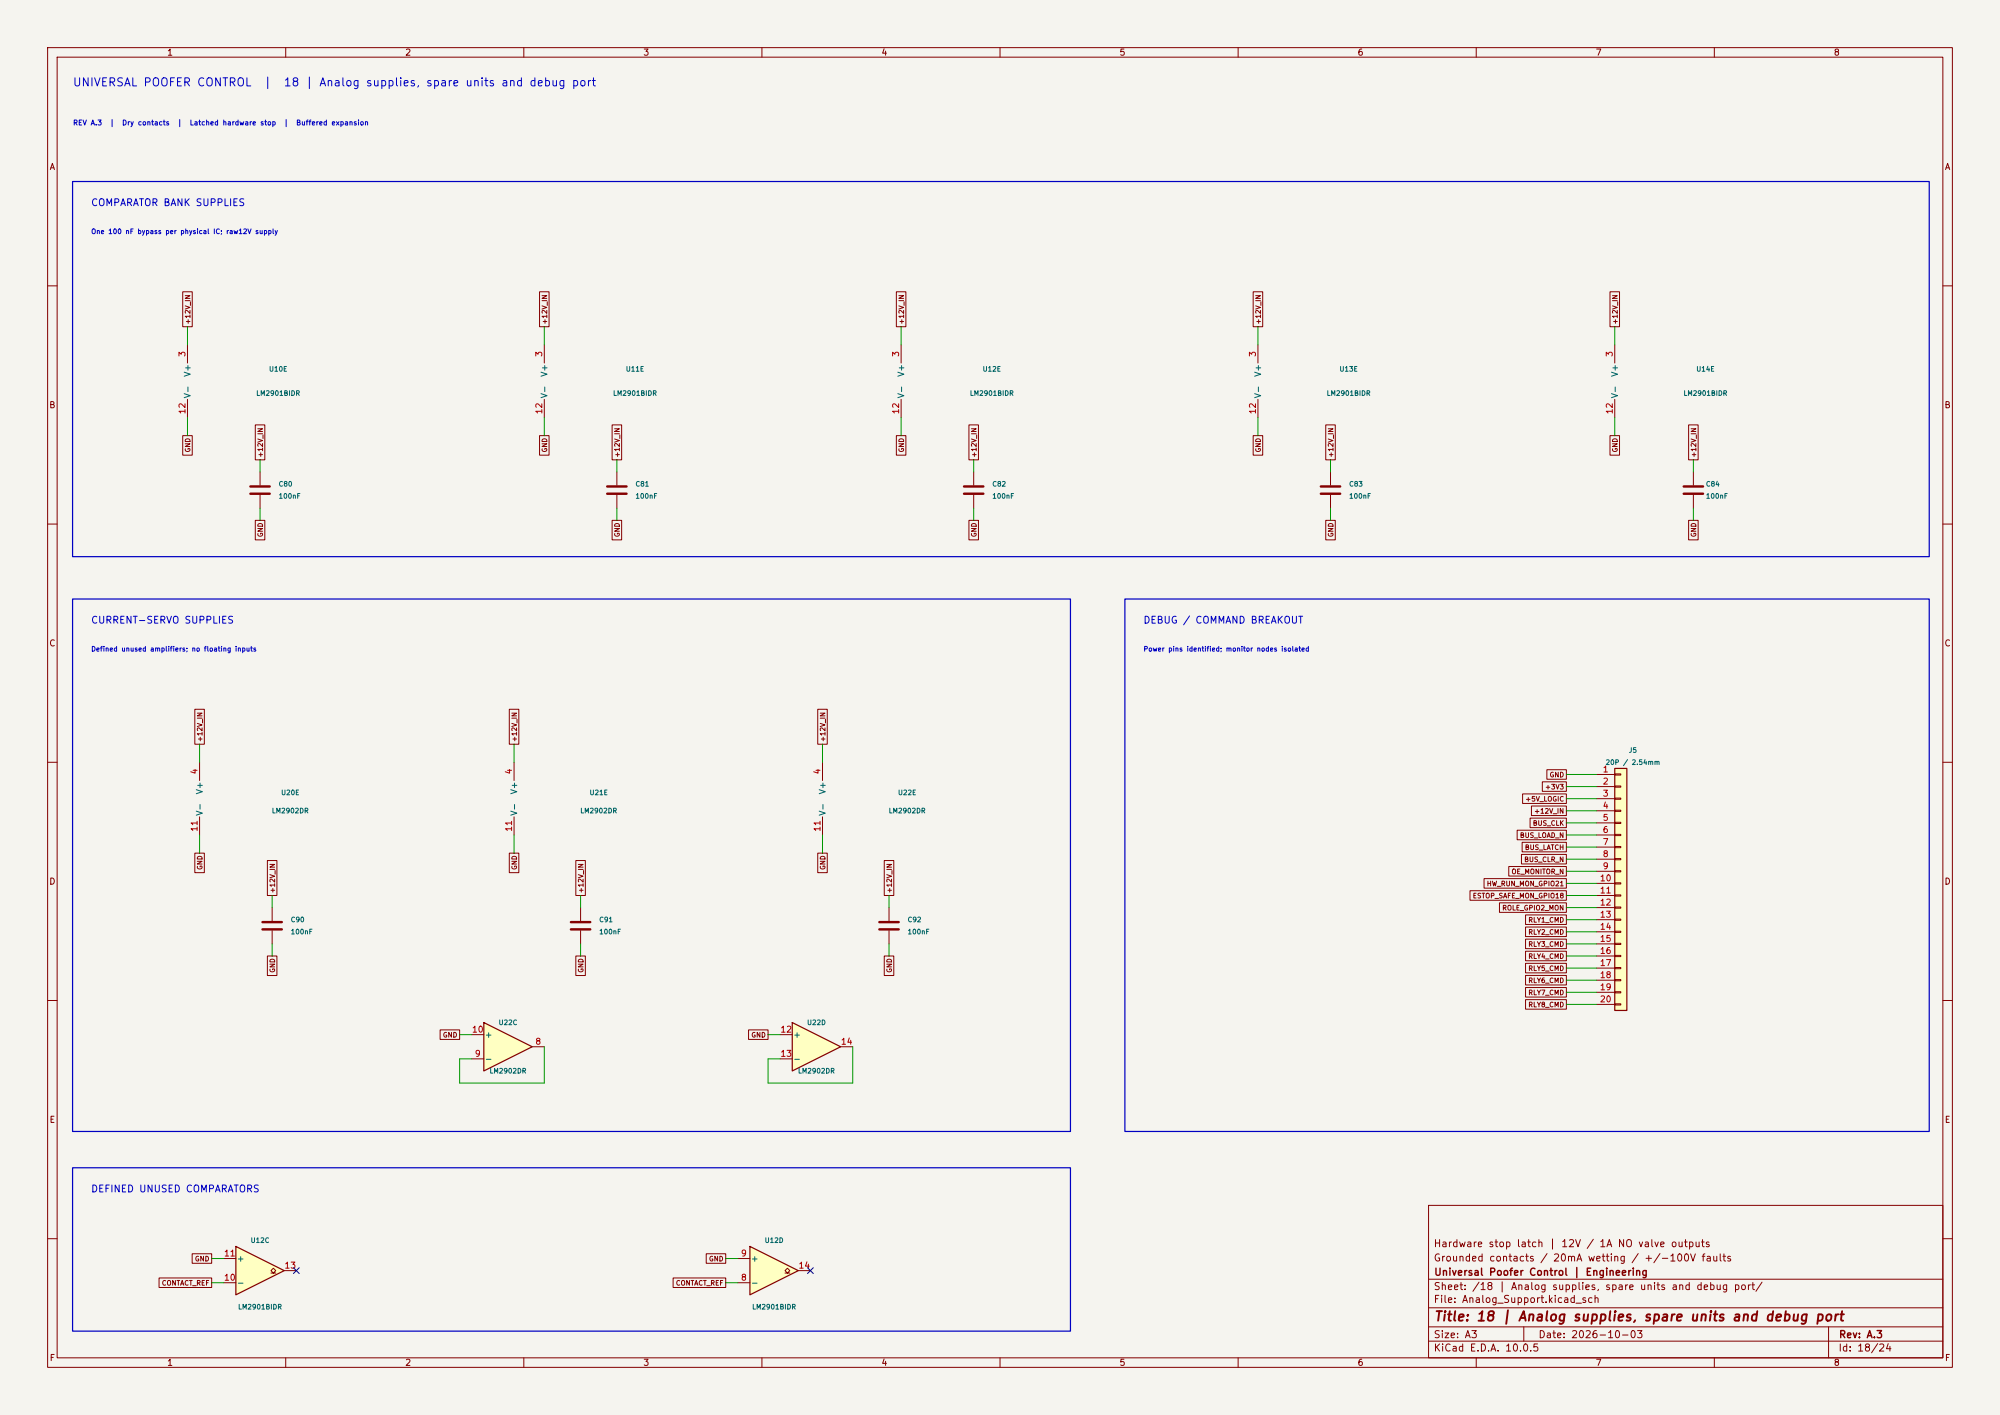
[picture p24: page 18]

REV A.3 | Dry contacts | Latched hardware stop | Buffered expansion UNIVERSAL POOFER CONTROL | 18 | Analog supplies, spare units and debug port

Power pins identified; monitor nodes isolated DEFINED UNUSED COMPARATORS

Defined unused amplifiers; no floating inputs

Hardware stop latch | 12V / 1A NO valve outputs
Grounded contacts / 20mA wetting / +/-100V faults
Universal Poofer Control | Engineering
Sheet: /18 | Analog supplies, spare units and debug port/
File: Analog_Support.kicad_sch
Title: 18 | Analog supplies, spare units and debug port

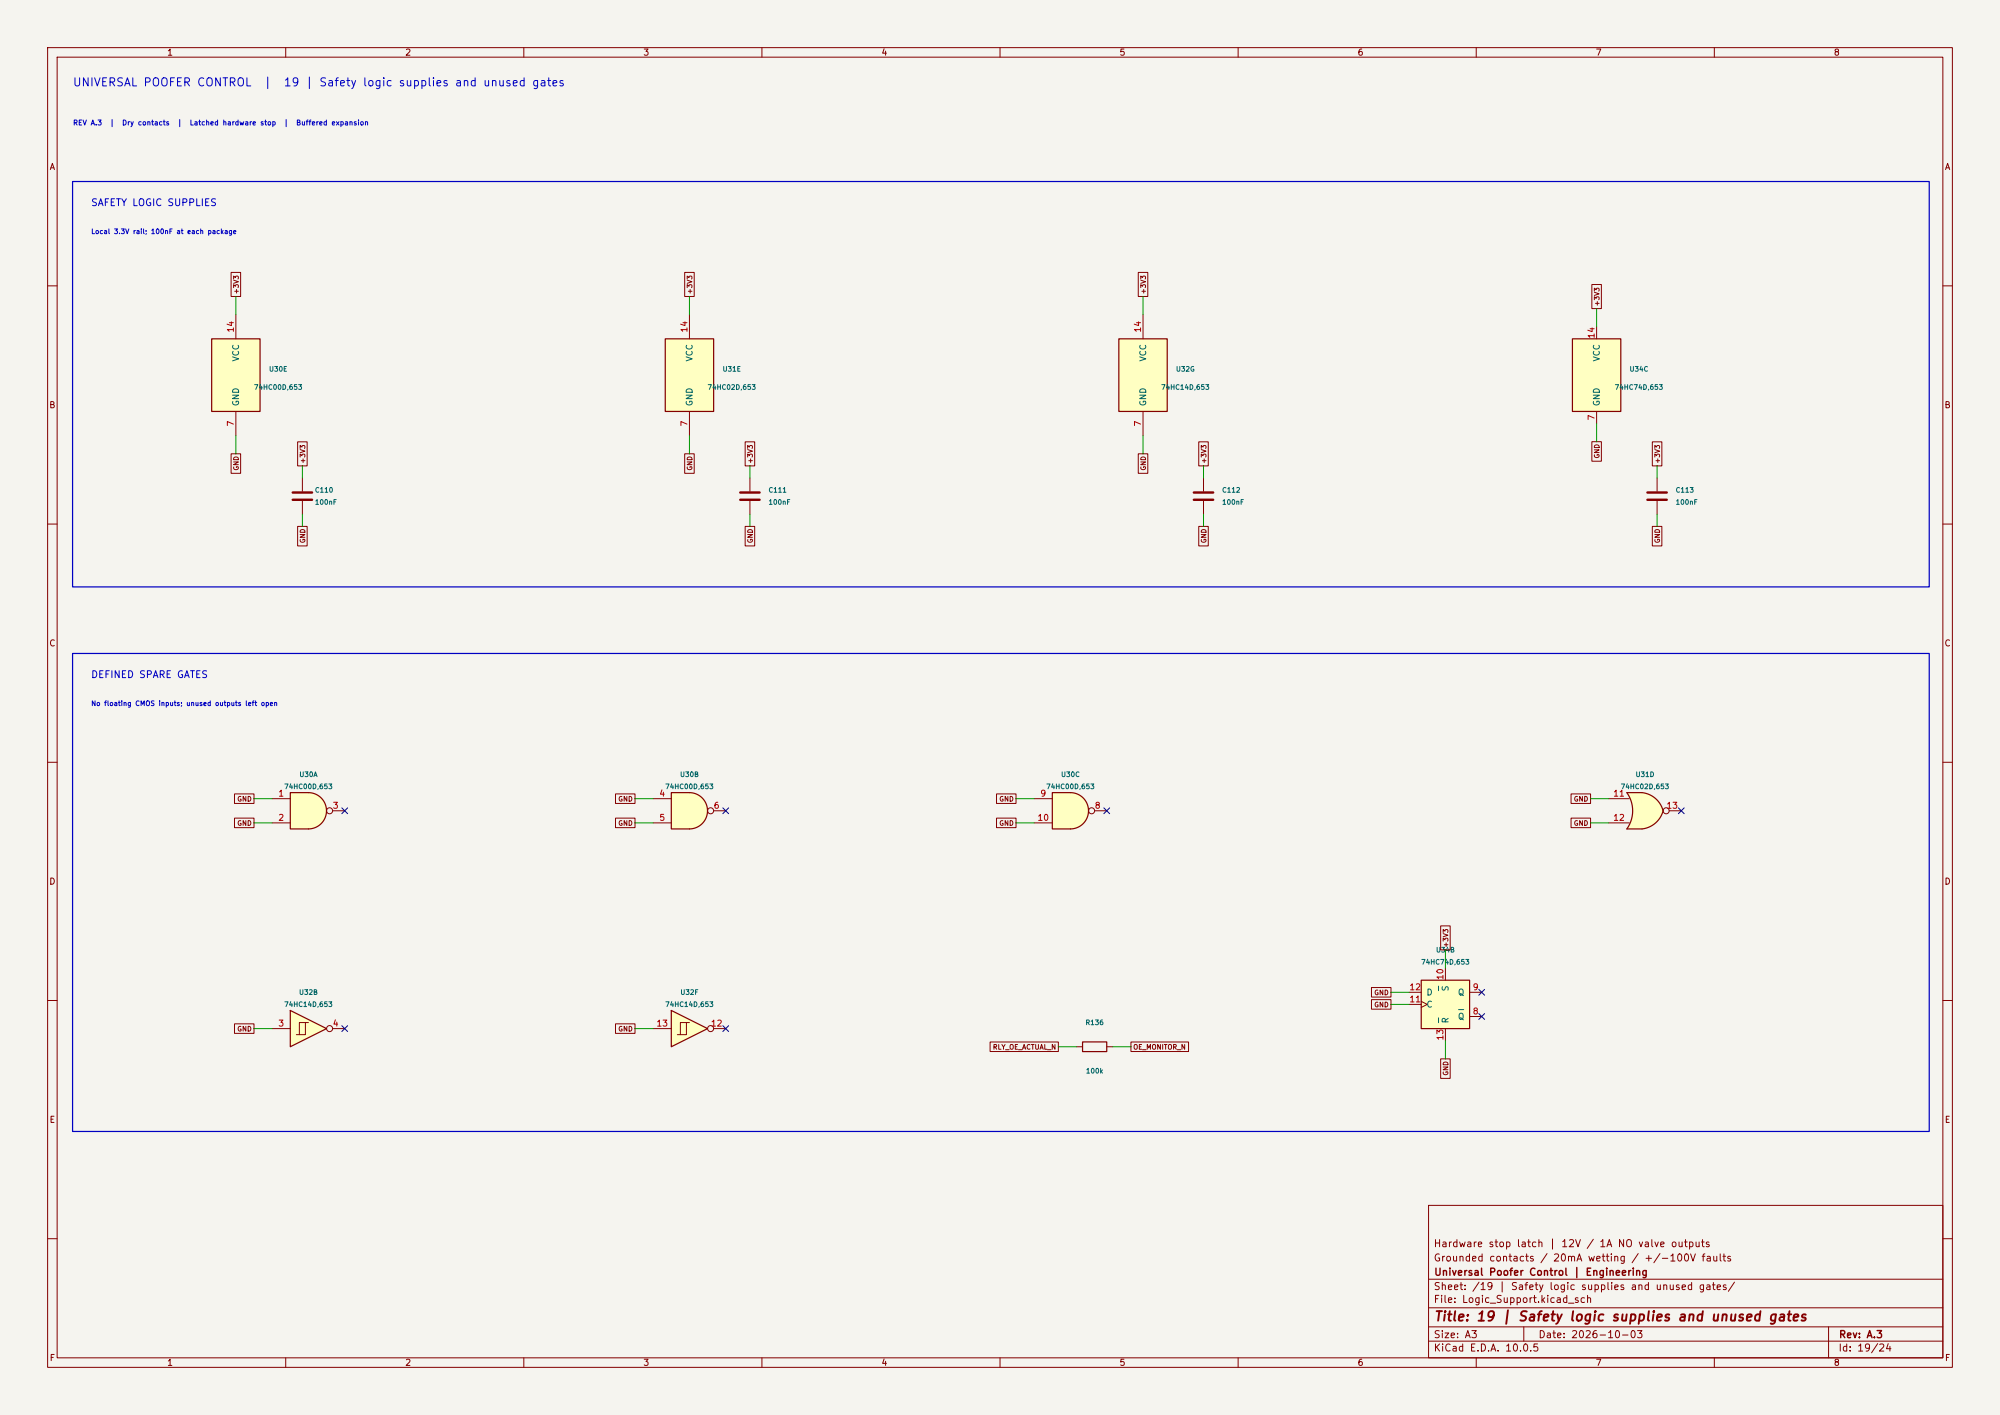
[picture p25: page 19]

UNIVERSAL POOFER CONTROL | 19 | Safety logic supplies and unused gates
Local 3.3V rail; 100nF at each package No floating CMOS inputs; unused outputs left open

REV A.3 | Dry contacts | Latched hardware stop | Buffered expansion DEFINED SPARE GATES

Hardware stop latch | 12V / 1A NO valve outputs
Grounded contacts / 20mA wetting / +/-100V faults
Universal Poofer Control | Engineering
Sheet: /19 | Safety logic supplies and unused gates/
File: Logic_Support.kicad_sch
Title: 19 | Safety logic supplies and unused gates

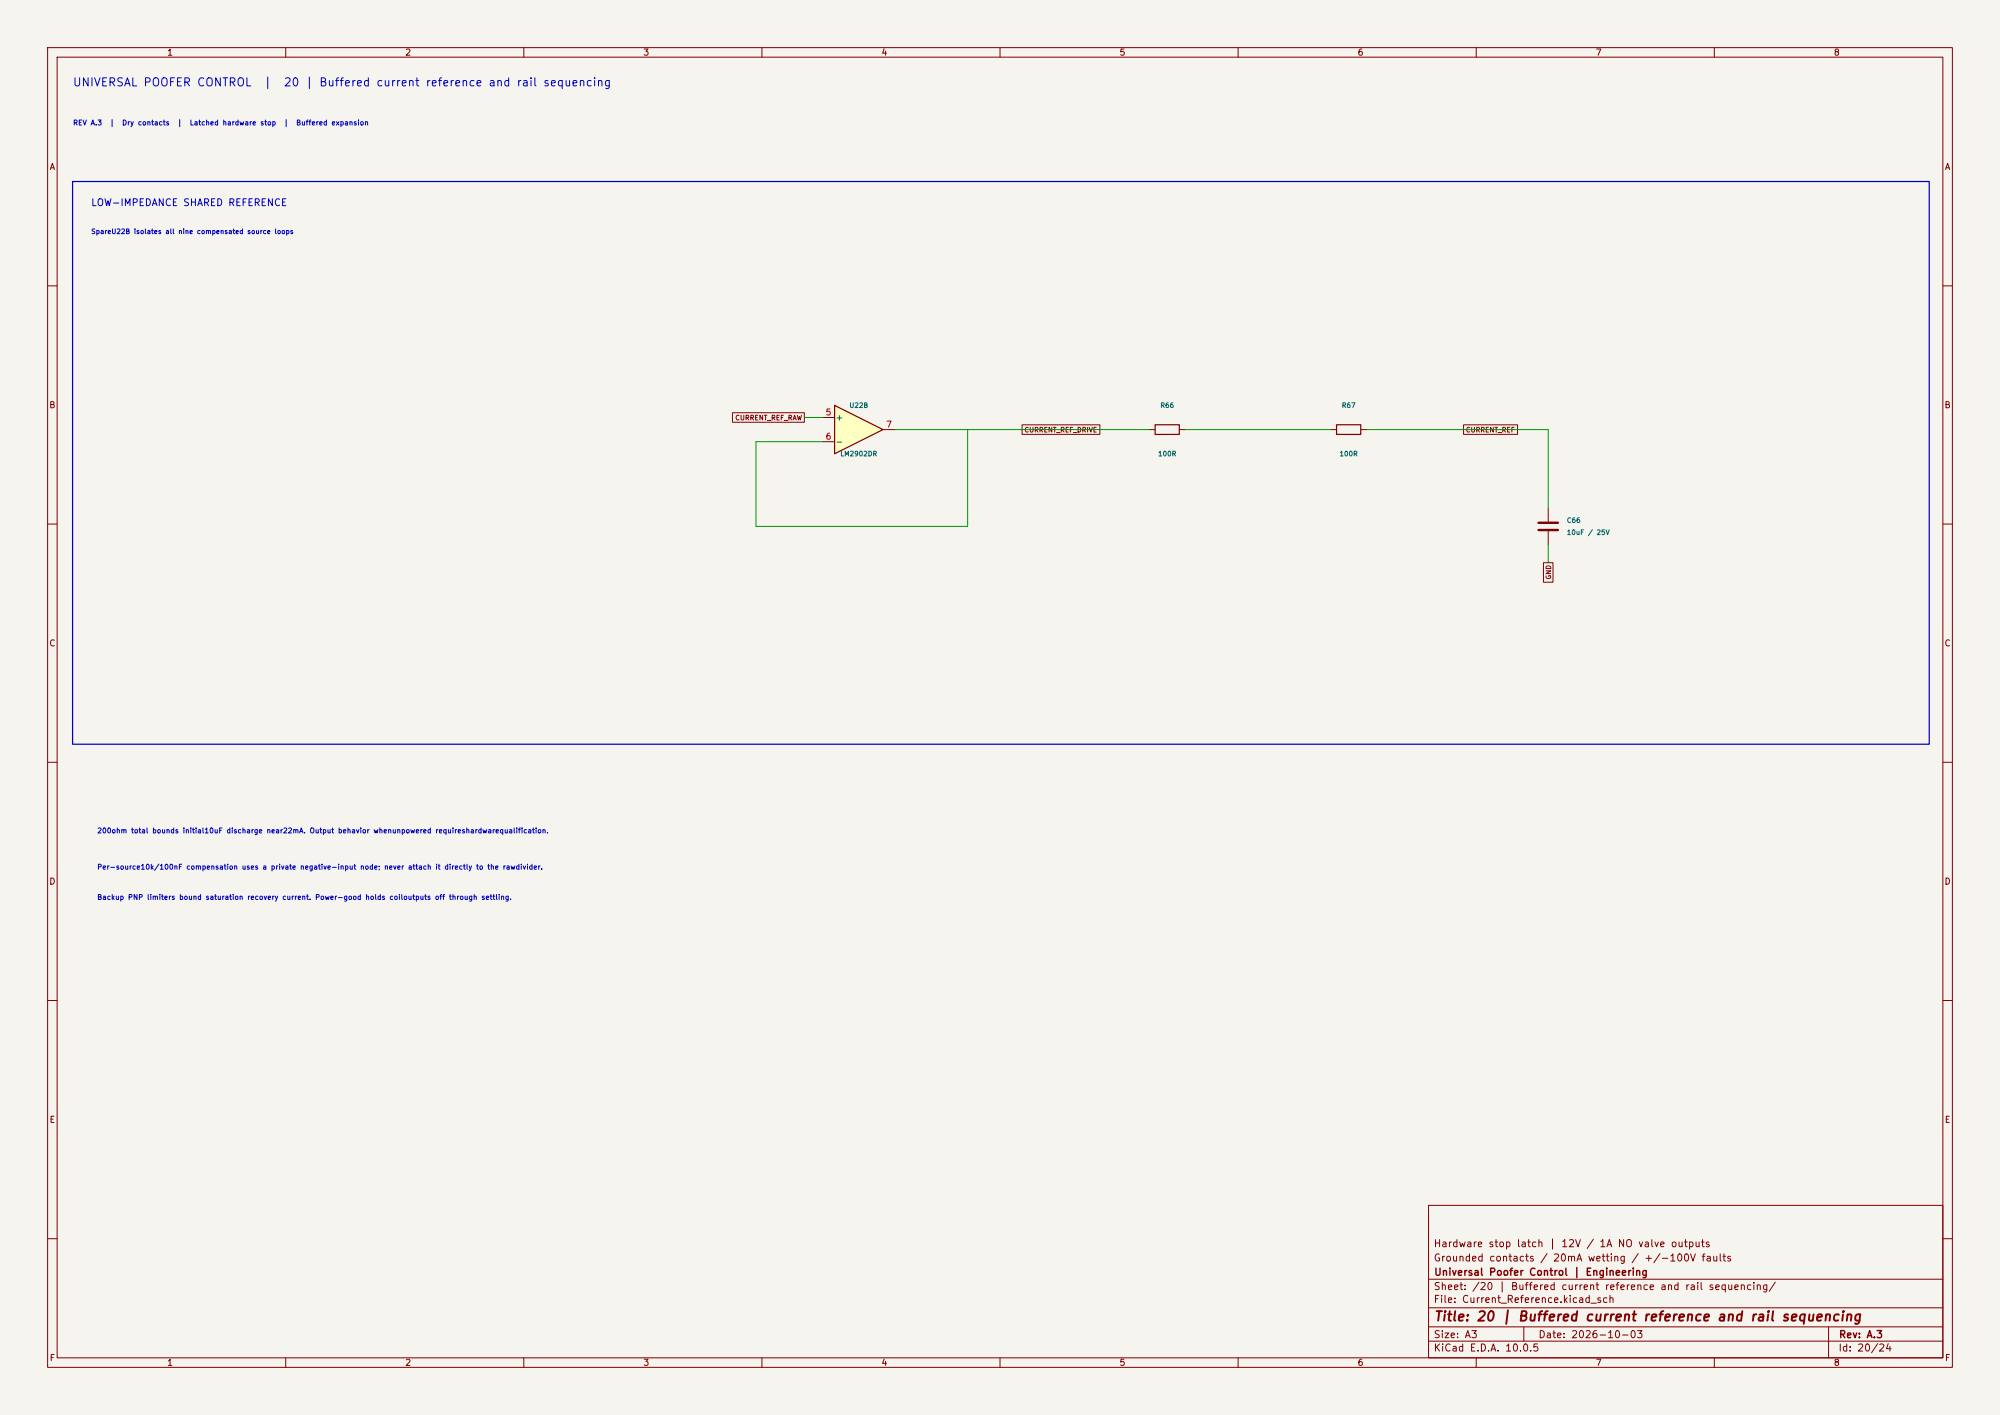
[picture p26: page 20]

SpareU22B isolates all nine compensated source loops UNIVERSAL POOFER CONTROL | 20 | Buffered current reference and rail sequencing

REV A.3 | Dry contacts | Latched hardware stop | Buffered expansion LOW-IMPEDANCE SHARED REFERENCE

CURRENT_REF_DRIVE 200ohm total bounds initial10uF discharge near22mA. Output behavior whenunpowered requireshardwarequalification. Backup PNP limiters bound saturation recovery current. Power-good holds coiloutputs off through settling. Per-source10k/100nF compensation uses a private negative-input node; never attach it directly to the rawdivider.

Hardware stop latch | 12V / 1A NO valve outputs
Grounded contacts / 20mA wetting / +/-100V faults
Universal Poofer Control | Engineering
Sheet: /20 | Buffered current reference and rail sequencing/
File: Current_Reference.kicad_sch
Title: 20 | Buffered current reference and rail sequencing

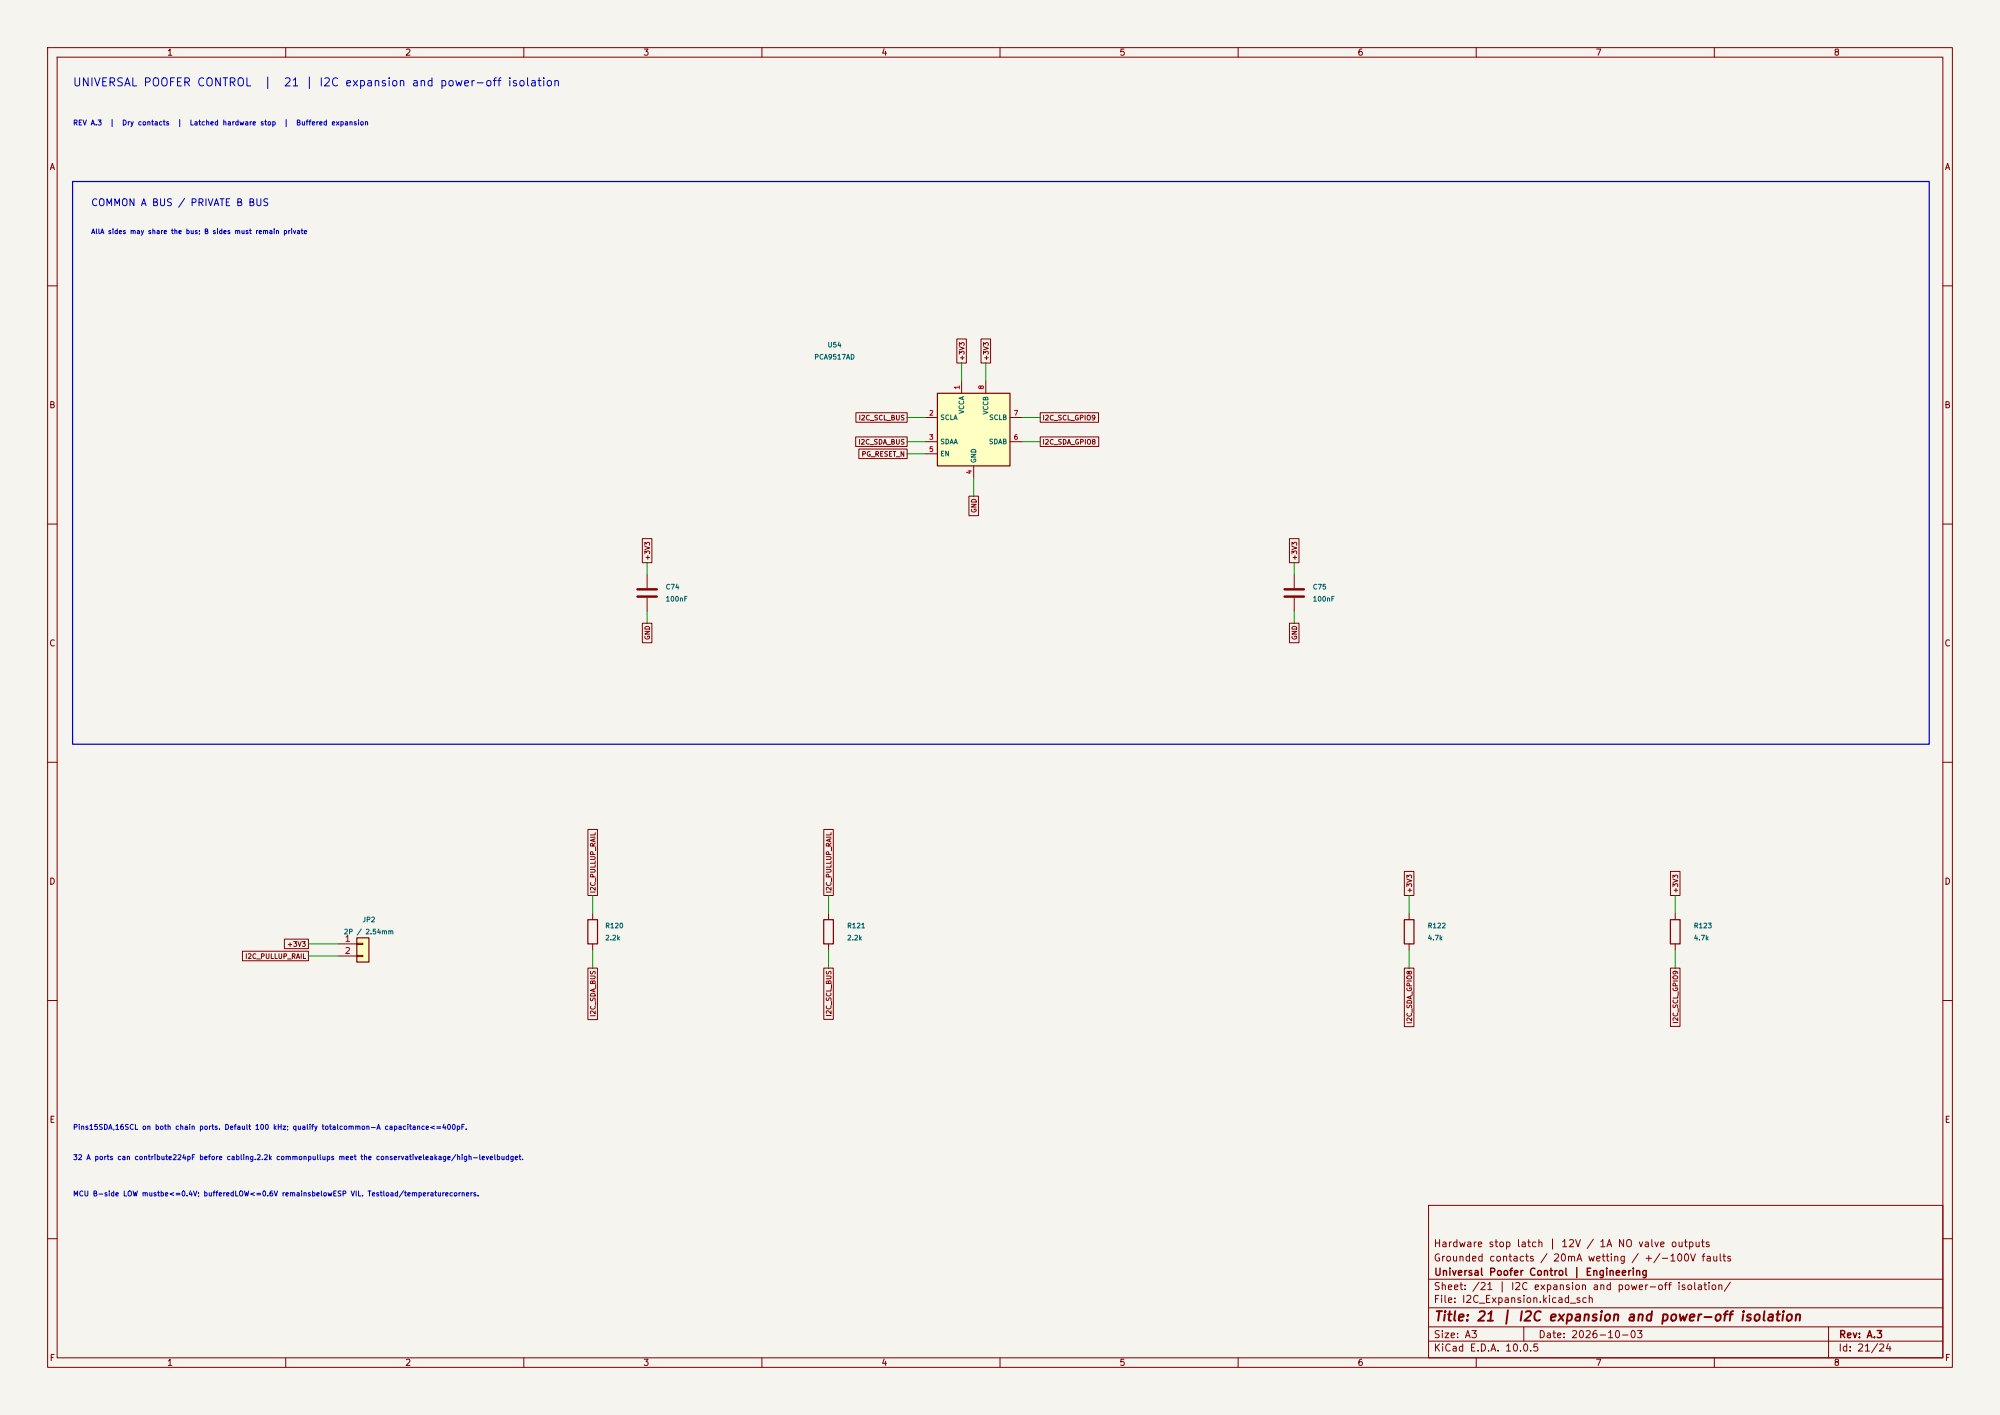
[picture p27: page 21]

UNIVERSAL POOFER CONTROL | 21 | I2C expansion and power-off isolation

REV A.3 | Dry contacts | Latched hardware stop | Buffered expansion

COMMON A BUS / PRIVATE B BUS

AllA sides may share the bus; B sides must remain private

+3V3 MCU B-side LOW mustbe<=0.4V; bufferedLOW<=0.6V remainsbelowESP VIL. Testload/temperaturecorners.

32 A ports can contribute224pF before cabling.2.2k commonpullups meet the conservativeleakage/high-levelbudget. Pins15SDA,16SCL on both chain ports. Default 100 kHz; qualify totalcommon-A capacitance<=400pF.

Hardware stop latch | 12V / 1A NO valve outputs
Grounded contacts / 20mA wetting / +/-100V faults
Universal Poofer Control | Engineering
Sheet: /21 | I2C expansion and power-off isolation/
File: I2C_Expansion.kicad_sch
Title: 21 | I2C expansion and power-off isolation

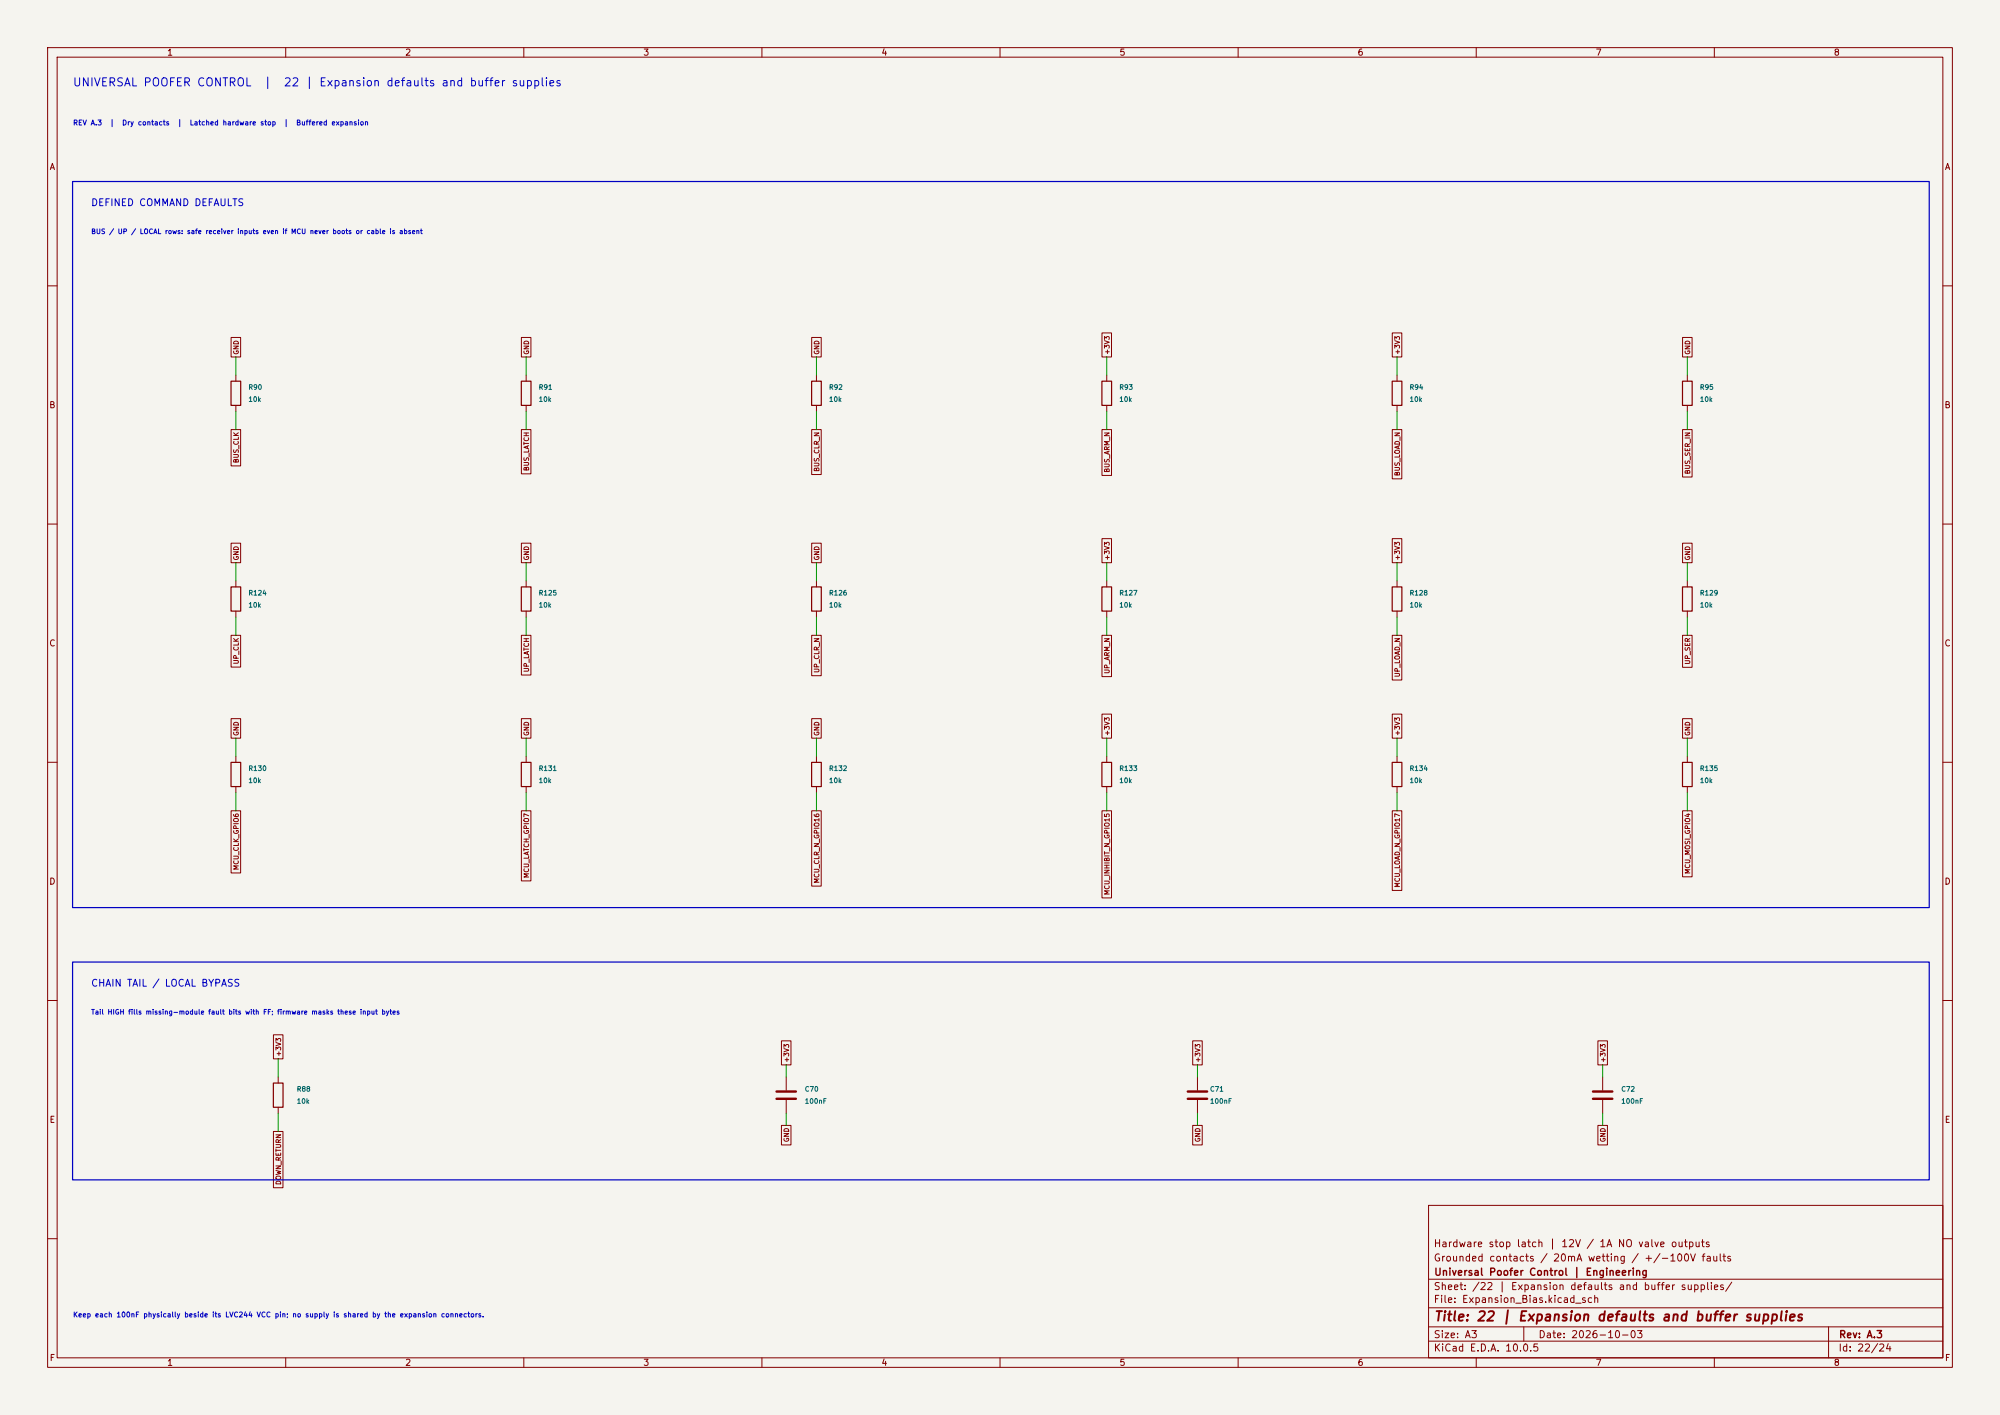
[picture p28: page 22]

UNIVERSAL POOFER CONTROL | 22 | Expansion defaults and buffer supplies

REV A.3 | Dry contacts | Latched hardware stop | Buffered expansion

BUS / UP / LOCAL rows: safe receiver inputs even if MCU never boots or cable is absent DEFINED COMMAND DEFAULTS

CHAIN TAIL / LOCAL BYPASS

Tail HIGH fills missing-module fault bits with FF; firmware masks these input bytes

Hardware stop latch | 12V / 1A NO valve outputs
Grounded contacts / 20mA wetting / +/-100V faults
Universal Poofer Control | Engineering
Sheet: /22 | Expansion defaults and buffer supplies/
File: Expansion_Bias.kicad_sch
Title: 22 | Expansion defaults and buffer supplies

Keep each 100nF physically beside its LVC244 VCC pin; no supply is shared by the expansion connectors.

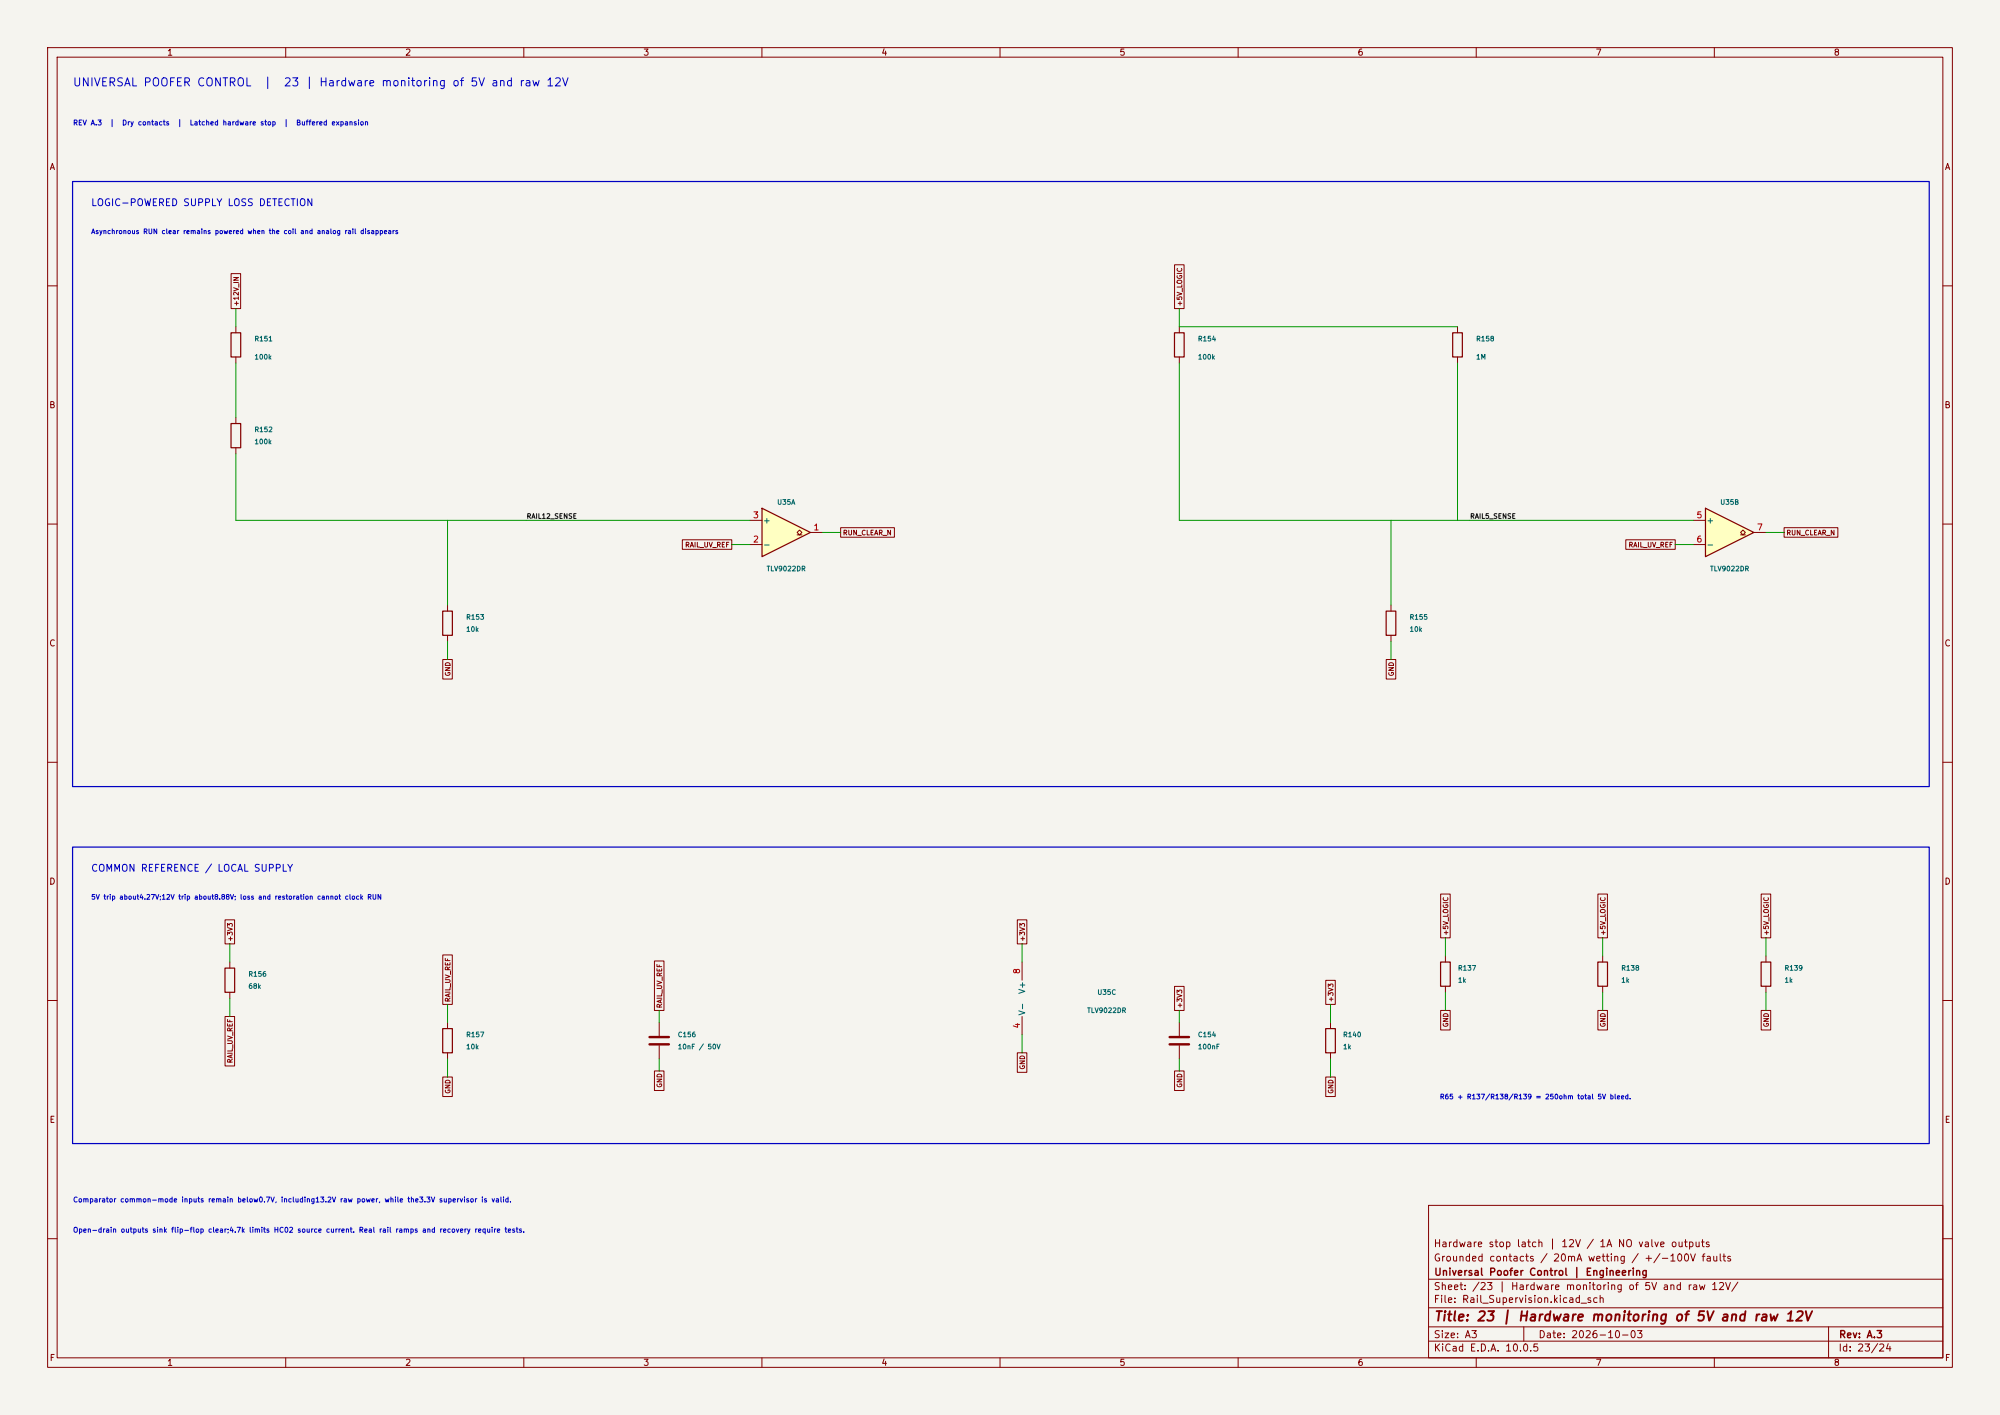
[picture p29: page 23]

REV A.3 | Dry contacts | Latched hardware stop | Buffered expansion UNIVERSAL POOFER CONTROL | 23 | Hardware monitoring of 5V and raw 12V

Asynchronous RUN clear remains powered when the coil and analog rail disappears LOGIC-POWERED SUPPLY LOSS DETECTION

5V trip about4.27V;12V trip about8.88V; loss and restoration cannot clock RUN COMMON REFERENCE / LOCAL SUPPLY

Hardware stop latch | 12V / 1A NO valve outputs
Grounded contacts / 20mA wetting / +/-100V faults
Universal Poofer Control | Engineering
Sheet: /23 | Hardware monitoring of 5V and raw 12V/
File: Rail_Supervision.kicad_sch
Title: 23 | Hardware monitoring of 5V and raw 12V

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
# Title: 24 | Stable emitter feedback for all wetting sources

## File: Source_Feedback_Filters.kicad_sch

## Sheet: /24 | Stable emitter feedback for all wetting sources/

## Universal Poofer Control | Engineering

## Grounded contacts / 20mA wetting / +/-100V faults

## Hardware stop latch | 12V / 1A NO valve outputs

C144
100nF

R1054

10k

C149

100nF R1264

10k

C142

100nF R1024

10k | R1174

10k C141

100nF | C145

100nF R1144

10k | C146

100nF R1234

10k | C148

100nF C147
100nF

R1084

10k

R1204

10k

C143

100nF R1114

10k | GND

IN6_EMIT_F

IN7_WET_EMIT | GND

IN8_WET_EMIT

# IN4_EMIT_F GND GND

IN4_WET_EMIT

IN7_EMIT_F

IN3_WET_EMIT

IN5_WET_EMIT

IN2_WET_EMIT

IN5_EMIT_F GND

IN1_WET_EMIT | IN1_EMIT_F

IN6_WET_EMIT GND

IN9_WET_EMIT | IN9_EMIT_F GND GND

IN2_EMIT_F GND

IN3_EMIT_F

IN8_EMIT_F

## INPUT 8 | EMITTER FEEDBACK

10k / 100n low-pass removes high-frequency plant gain 10k / 100n low-pass removes high-frequency plant gain UNIVERSAL POOFER CONTROL | 24 | Stable emitter feedback for all wetting sources
10k / 100n low-pass removes high-frequency plant gain | 10k / 100n low-pass removes high-frequency plant gain

## INPUT 4 | EMITTER FEEDBACK

REV A.3 | Dry contacts | Latched hardware stop | Buffered expansion

## INPUT 5 | EMITTER FEEDBACK

10k / 100n low-pass removes high-frequency plant gain

## INPUT 6 | EMITTER FEEDBACK

Retain the separate OUT-to-IN- compensation. These filters improve illustrative AC phase margin; real parts still require tests.

INPUT 1 | EMITTER FEEDBACK | INPUT 2 | EMITTER FEEDBACK

10k / 100n low-pass removes high-frequency plant gain

10k / 100n low-pass removes high-frequency plant gain | 10k / 100n low-pass removes high-frequency plant gain

## INPUT 3 | EMITTER FEEDBACK

10k / 100n low-pass removes high-frequency plant gain

INPUT 7 | EMITTER FEEDBACK | INPUT 9 | EMITTER FEEDBACK
