NOVA-Cluster/Universal-Poofer-Control/(list of files, drawings)

Other design files:
analysis/pcb_placement.json
analysis/pcb_placement_validation.json
