NOVA-Cluster/Universal-Poofer-Control/Universal_Poofer_Control.kicad_pcb

## KiCad design Universal_Poofer_Control.kicad_pcb (2026-10-03)

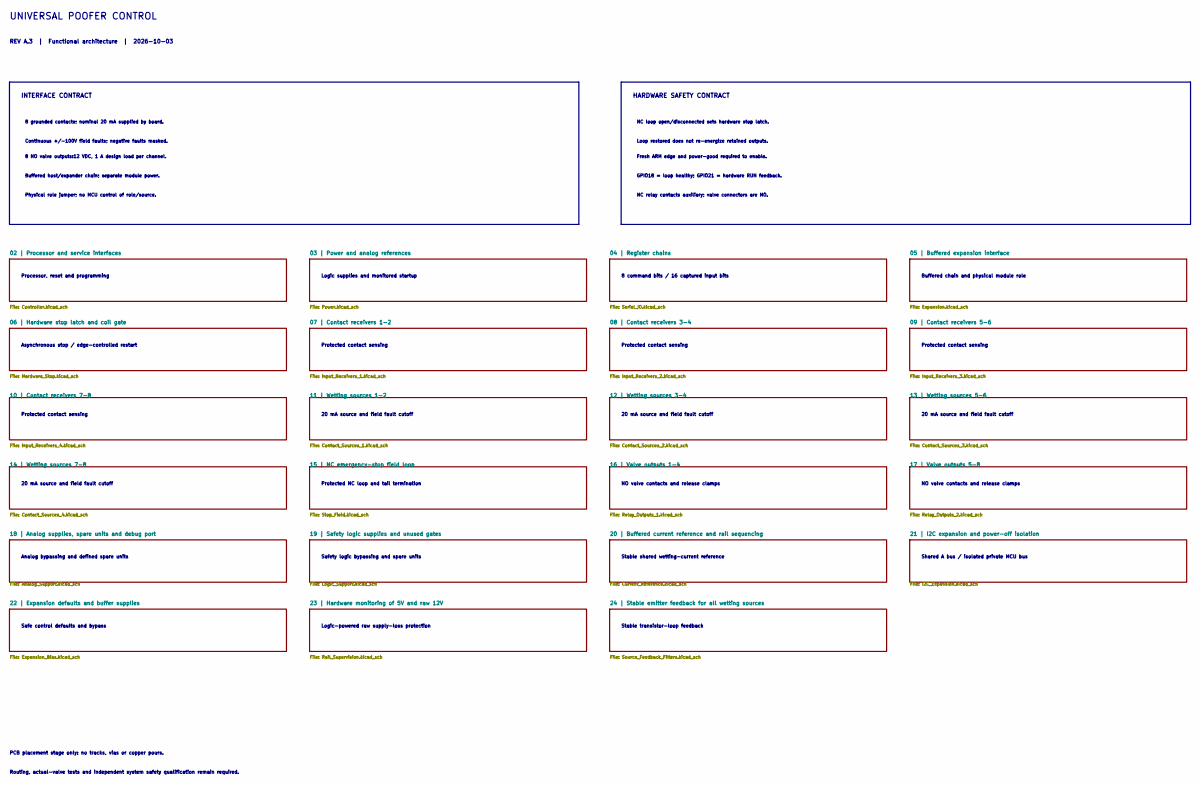
[picture p30: schematic Universal_Poofer_Control.kicad_sch, 01 | System architecture]

Notes on the sheet:
UNIVERSAL POOFER CONTROL
REV A.3 | Functional architecture | 2026-10-03
INTERFACE CONTRACT
HARDWARE SAFETY CONTRACT
8 grounded contacts; nominal 20 mA supplied by board.
Continuous +/-100V field faults; negative faults masked.
8 NO valve outputs:12 VDC, 1 A design load per channel.
Buffered host/expander chain; separate module power.
Physical role jumper; no MCU control of role/source.
NC loop open/disconnected sets hardware stop latch.
Loop restored does not re-energize retained outputs.
Fresh ARM edge and power-good required to enable.
GPIO18 = loop healthy; GPIO21 = hardware RUN feedback.
NC relay contacts auxiliary; valve connectors are NO.
Processor, reset and programming
Logic supplies and monitored startup
8 command bits / 16 captured input bits
Buffered chain and physical module role
Asynchronous stop / edge-controlled restart
Protected contact sensing
20 mA source and field fault cutoff
Protected NC loop and tail termination
NO valve contacts and release clamps
Analog bypassing and defined spare units
Safety logic bypassing and spare units
Stable shared wetting-current reference
Shared A bus / isolated private MCU bus
Safe control defaults and bypass
Logic-powered raw supply-loss protection
Stable transistor-loop feedback
PCB placement stage only: no tracks, vias or copper pours.
Routing, actual-valve tests and independent system safety qualification remain required.

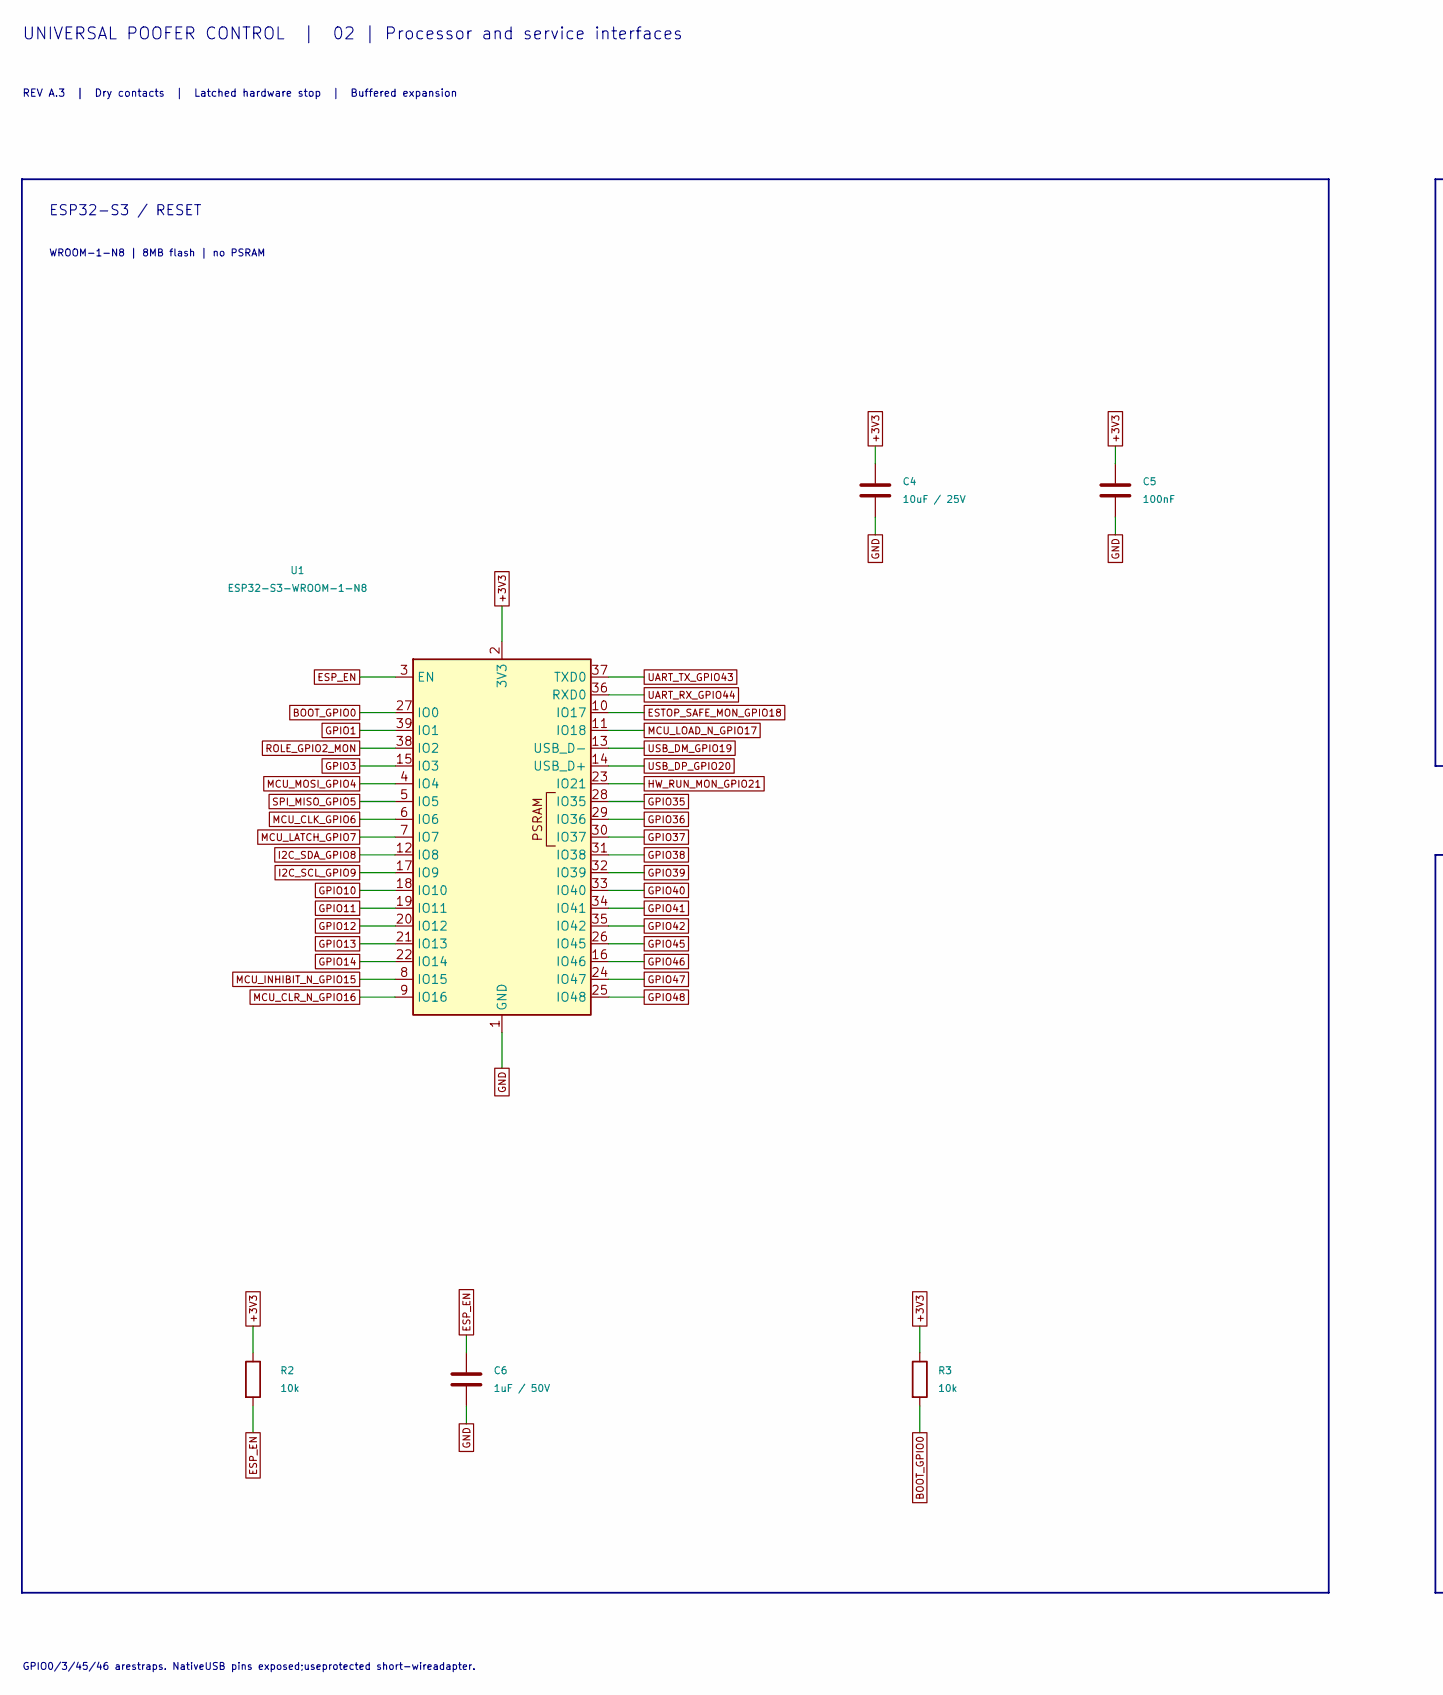
[picture p31: schematic Controller.kicad_sch, 02 | Processor and service interfaces, part in row 1, column 1]

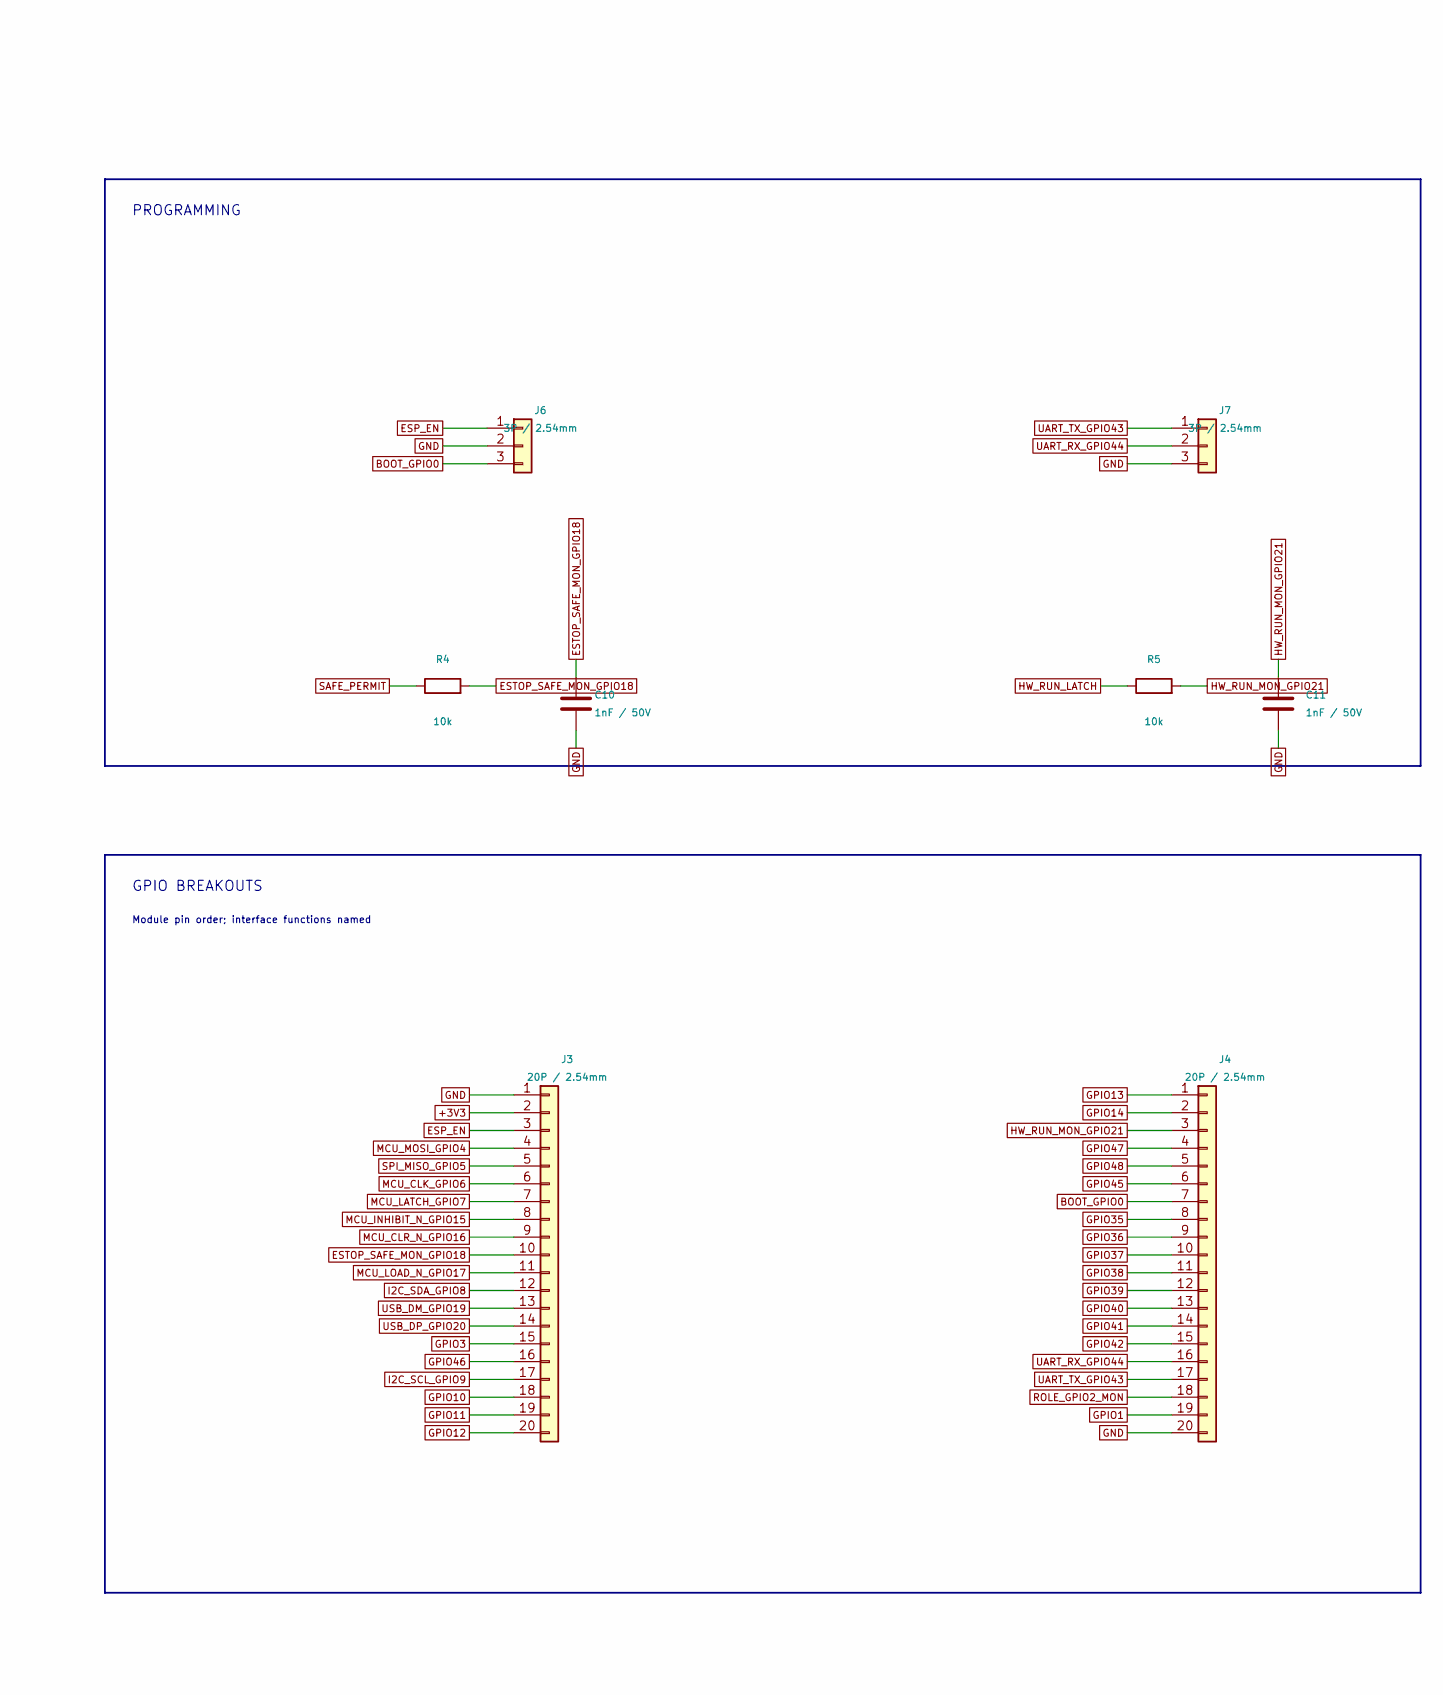
[picture p32: schematic Controller.kicad_sch, 02 | Processor and service interfaces, part in row 1, column 2]

Parts:
C4: 10uF / 25V; C_0805_2012Metric; MPN CL21A106KAYNNNE; LCSC C15850
C5: 100nF; C_0805_2012Metric; MPN CC0805KRX7R9BB104; LCSC C49678
C6: 1uF / 50V; C_0805_2012Metric; MPN CL21B105KBFNNNE; LCSC C28323
C10, C11: 1nF / 50V; C_0805_2012Metric; MPN CL21B102KBANNNC; LCSC C51210
J3, J4: 20P / 2.54mm; PinHeader_1x20_P2.54mm_Vertical; MPN 2.54-1*20P; LCSC C50981
J6, J7: 3P / 2.54mm; PinHeader_1x03_P2.54mm_Vertical; MPN B-2100S03P-A110; LCSC C124376
R2, R3, R4, R5: 10k; R_0805_2012Metric; MPN 0805W8F1002T5E; LCSC C17414
U1: ESP32-S3-WROOM-1-N8; ESP32-S3-WROOM-1; MPN ESP32-S3-WROOM-1-N8; LCSC C2913198

Connections:
+3V3: C4.1, C5.1, J3.2, R2.1, R3.1, U1.2 (3V3); also elsewhere on the board
BOOT_GPIO0: J4.7, J6.3, R3.2, U1.27 (IO0)
ESP_EN: C6.1, J3.3, J6.1, R2.2, U1.3 (EN)
ESTOP_SAFE_MON_GPIO18: C10.1, J3.10, R4.2, U1.10 (IO17); also elsewhere on the board
GND: C4.2, C5.2, C6.2, C10.2, C11.2, J3.1, J4.20, J6.2, J7.3, U1.1 (GND), U1.40 (GND), U1.41 (GND); also elsewhere on the board
GPIO1: J4.19, U1.39 (IO1)
GPIO3: J3.15, U1.15 (IO3)
GPIO10: J3.18, U1.18 (IO10)
GPIO11: J3.19, U1.19 (IO11)
GPIO12: J3.20, U1.20 (IO12)
GPIO13: J4.1, U1.21 (IO13)
GPIO14: J4.2, U1.22 (IO14)
GPIO35: J4.8, U1.28 (IO35)
GPIO36: J4.9, U1.29 (IO36)
GPIO37: J4.10, U1.30 (IO37)
GPIO38: J4.11, U1.31 (IO38)
GPIO39: J4.12, U1.32 (IO39)
GPIO40: J4.13, U1.33 (IO40)
GPIO41: J4.14, U1.34 (IO41)
GPIO42: J4.15, U1.35 (IO42)
GPIO45: J4.6, U1.26 (IO45)
GPIO46: J3.16, U1.16 (IO46)
GPIO47: J4.4, U1.24 (IO47)
GPIO48: J4.5, U1.25 (IO48)
HW_RUN_LATCH: R5.1; also elsewhere on the board
HW_RUN_MON_GPIO21: C11.1, J4.3, R5.2, U1.23 (IO21); also elsewhere on the board
I2C_SCL_GPIO9: J3.17, U1.17 (IO9); also elsewhere on the board
I2C_SDA_GPIO8: J3.12, U1.12 (IO8); also elsewhere on the board
MCU_CLK_GPIO6: J3.6, U1.6 (IO6); also elsewhere on the board
MCU_CLR_N_GPIO16: J3.9, U1.9 (IO16); also elsewhere on the board
MCU_INHIBIT_N_GPIO15: J3.8, U1.8 (IO15); also elsewhere on the board
MCU_LATCH_GPIO7: J3.7, U1.7 (IO7); also elsewhere on the board
MCU_LOAD_N_GPIO17: J3.11, U1.11 (IO18); also elsewhere on the board
MCU_MOSI_GPIO4: J3.4, U1.4 (IO4); also elsewhere on the board
ROLE_GPIO2_MON: J4.18, U1.38 (IO2); also elsewhere on the board
SAFE_PERMIT: R4.1; also elsewhere on the board
SPI_MISO_GPIO5: J3.5, U1.5 (IO5); also elsewhere on the board
UART_RX_GPIO44: J4.16, J7.2, U1.36 (RXD0)
UART_TX_GPIO43: J4.17, J7.1, U1.37 (TXD0)
USB_DM_GPIO19: J3.13, U1.13 (USB_D-)
USB_DP_GPIO20: J3.14, U1.14 (USB_D+)

Notes on the sheet:
UNIVERSAL POOFER CONTROL | 02 | Processor and service interfaces
REV A.3 | Dry contacts | Latched hardware stop | Buffered expansion
ESP32-S3 / RESET
WROOM-1-N8 | 8MB flash | no PSRAM
PROGRAMMING
GPIO BREAKOUTS
Module pin order; interface functions named
GPIO0/3/45/46 arestraps. NativeUSB pins exposed;useprotected short-wireadapter.

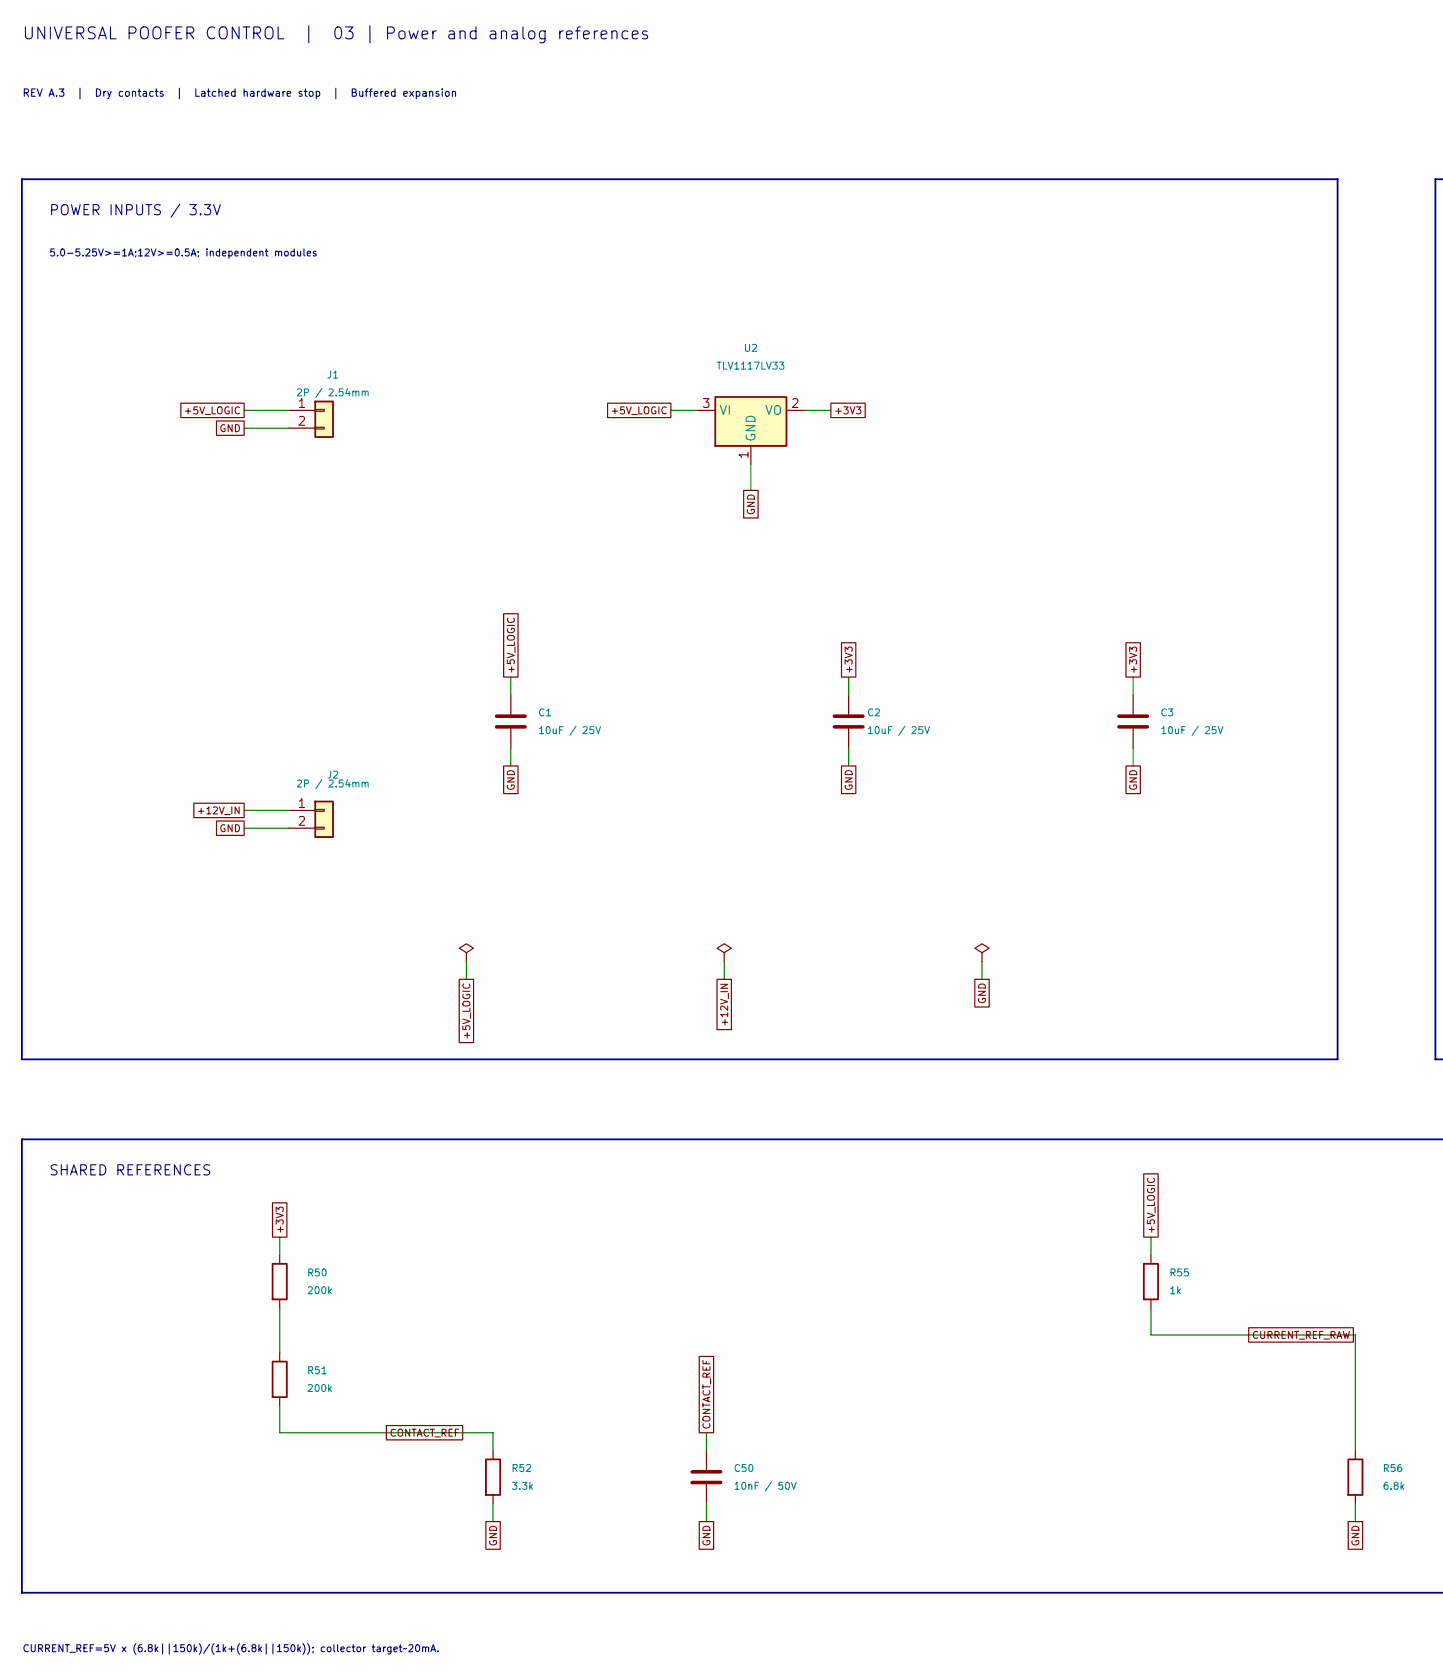
[picture p33: schematic Power.kicad_sch, 03 | Power and analog references, part in row 1, column 1]

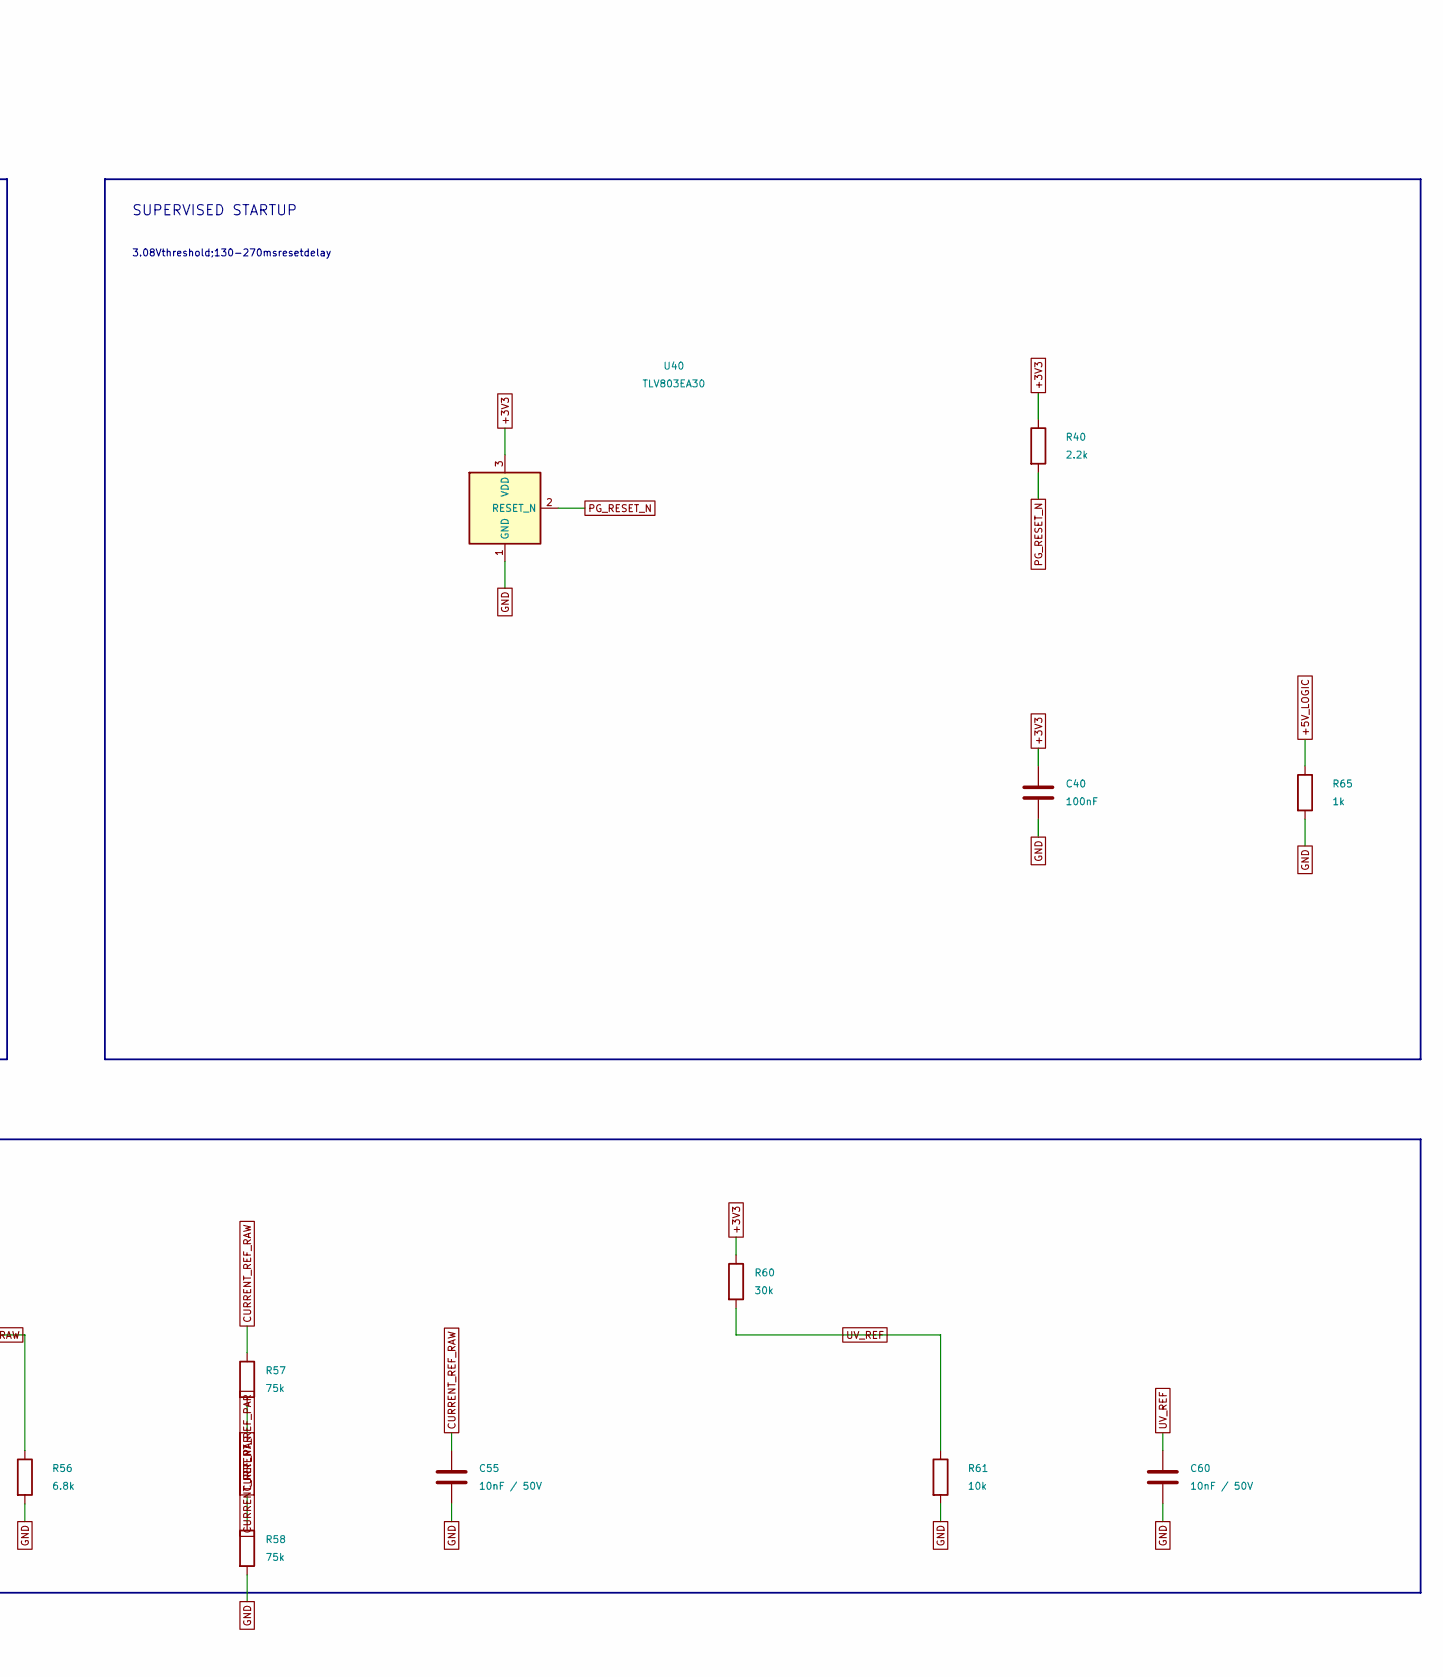
[picture p34: schematic Power.kicad_sch, 03 | Power and analog references, part in row 1, column 2]

Parts:
C1, C2, C3: 10uF / 25V; C_0805_2012Metric; MPN CL21A106KAYNNNE; LCSC C15850
C40: 100nF; C_0805_2012Metric; MPN CC0805KRX7R9BB104; LCSC C49678
C50, C55, C60: 10nF / 50V; C_0805_2012Metric; MPN CL21B103KBANNNC; LCSC C1710
J1, J2: 2P / 2.54mm; PinHeader_1x02_P2.54mm_Vertical; MPN B-2100S02P-A110; LCSC C124375
R40: 2.2k; R_0805_2012Metric; MPN 0805W8F2201T5E; LCSC C17520
R50, R51: 200k; R_0805_2012Metric; MPN 0805W8F2003T5E; LCSC C17539
R52: 3.3k; R_0805_2012Metric; MPN 0805W8F3301T5E; LCSC C26010
R55, R65: 1k; R_0805_2012Metric; MPN 0805W8F1001T5E; LCSC C17513
R56: 6.8k; R_0805_2012Metric; MPN 0805W8F6801T5E; LCSC C17772
R57, R58: 75k; R_0805_2012Metric; MPN 0805W8F7502T5E; LCSC C17819
R60: 30k; R_0805_2012Metric; MPN 0805W8F3002T5E; LCSC C17621
R61: 10k; R_0805_2012Metric; MPN 0805W8F1002T5E; LCSC C17414
U2: TLV1117LV33; SOT-223-3_TabPin2; MPN TLV1117LV33DCYR; LCSC C15578
U40: TLV803EA30; SOT-23; MPN TLV803EA30DBZR; LCSC C5218924

Connections:
+3V3: C2.1, C3.1, C40.1, R40.1, R50.1, R60.1, U2.2 (VO), U40.3 (VDD); also elsewhere on the board
+5V_LOGIC: C1.1, J1.1, R55.1, R65.1, U2.3 (VI); also elsewhere on the board
+12V_IN: J2.1; also elsewhere on the board
CONTACT_REF: C50.1, R51.2, R52.1; also elsewhere on the board
CURRENT_REF_PAR: R57.2, R58.1
CURRENT_REF_RAW: C55.1, R55.2, R56.1, R57.1; also elsewhere on the board
GND: C1.2, C2.2, C3.2, C40.2, C50.2, C55.2, C60.2, J1.2, J2.2, R52.2, R56.2, R58.2, R61.2, R65.2, U2.1 (GND), U40.1 (GND); also elsewhere on the board
unnamed: R50.2, R51.1
PG_RESET_N: R40.2, U40.2 (RESET_N); also elsewhere on the board
UV_REF: C60.1, R60.2, R61.1; also elsewhere on the board

Notes on the sheet:
UNIVERSAL POOFER CONTROL | 03 | Power and analog references
REV A.3 | Dry contacts | Latched hardware stop | Buffered expansion
POWER INPUTS / 3.3V
5.0-5.25V>=1A;12V>=0.5A; independent modules
SUPERVISED STARTUP
3.08Vthreshold;130-270msresetdelay
SHARED REFERENCES
CURRENT_REF=5V x (6.8k||150k)/(1k+(6.8k||150k)); collector target~20mA.

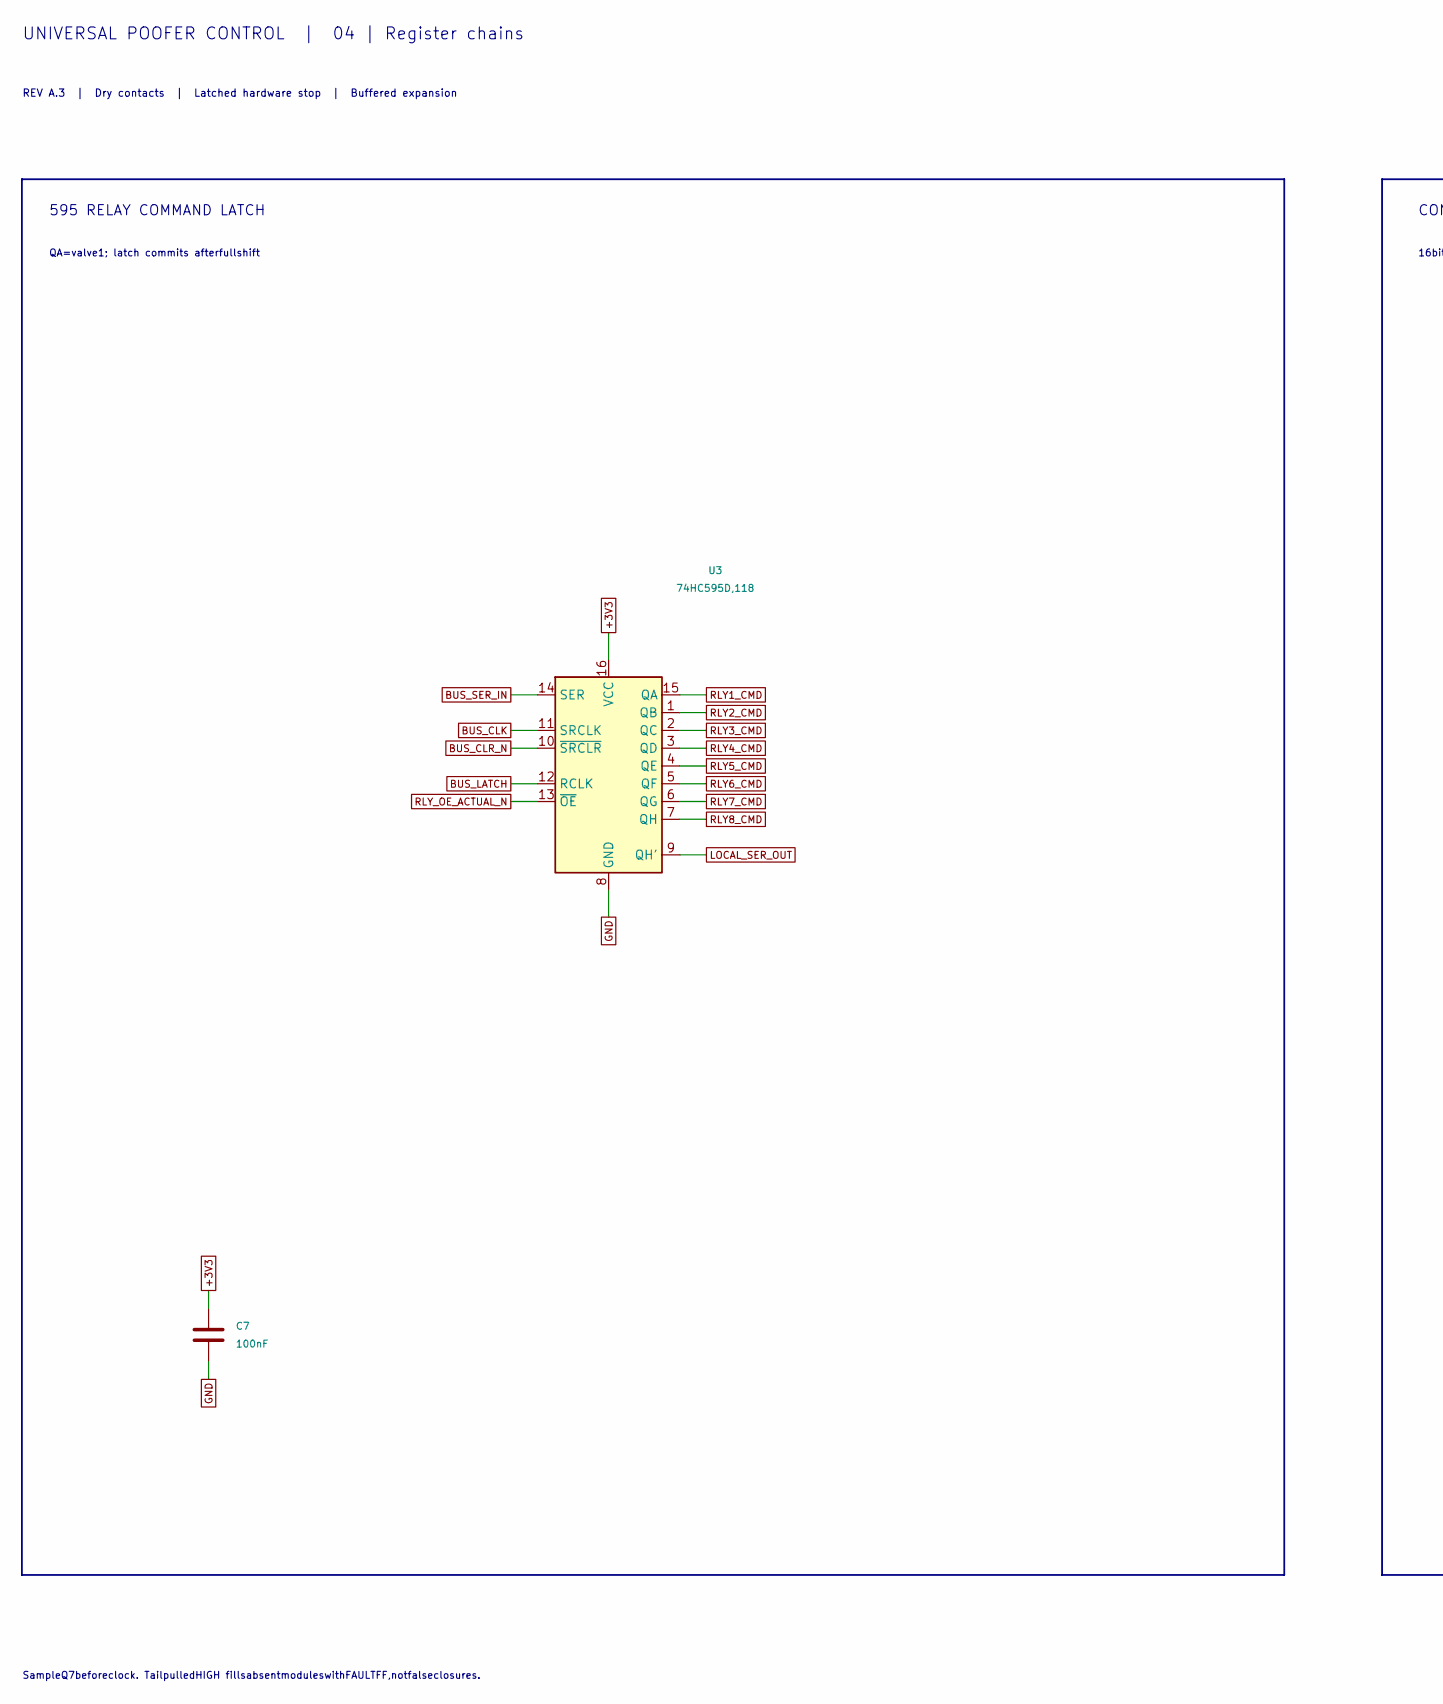
[picture p35: schematic Serial_IO.kicad_sch, 04 | Register chains, part in row 1, column 1]

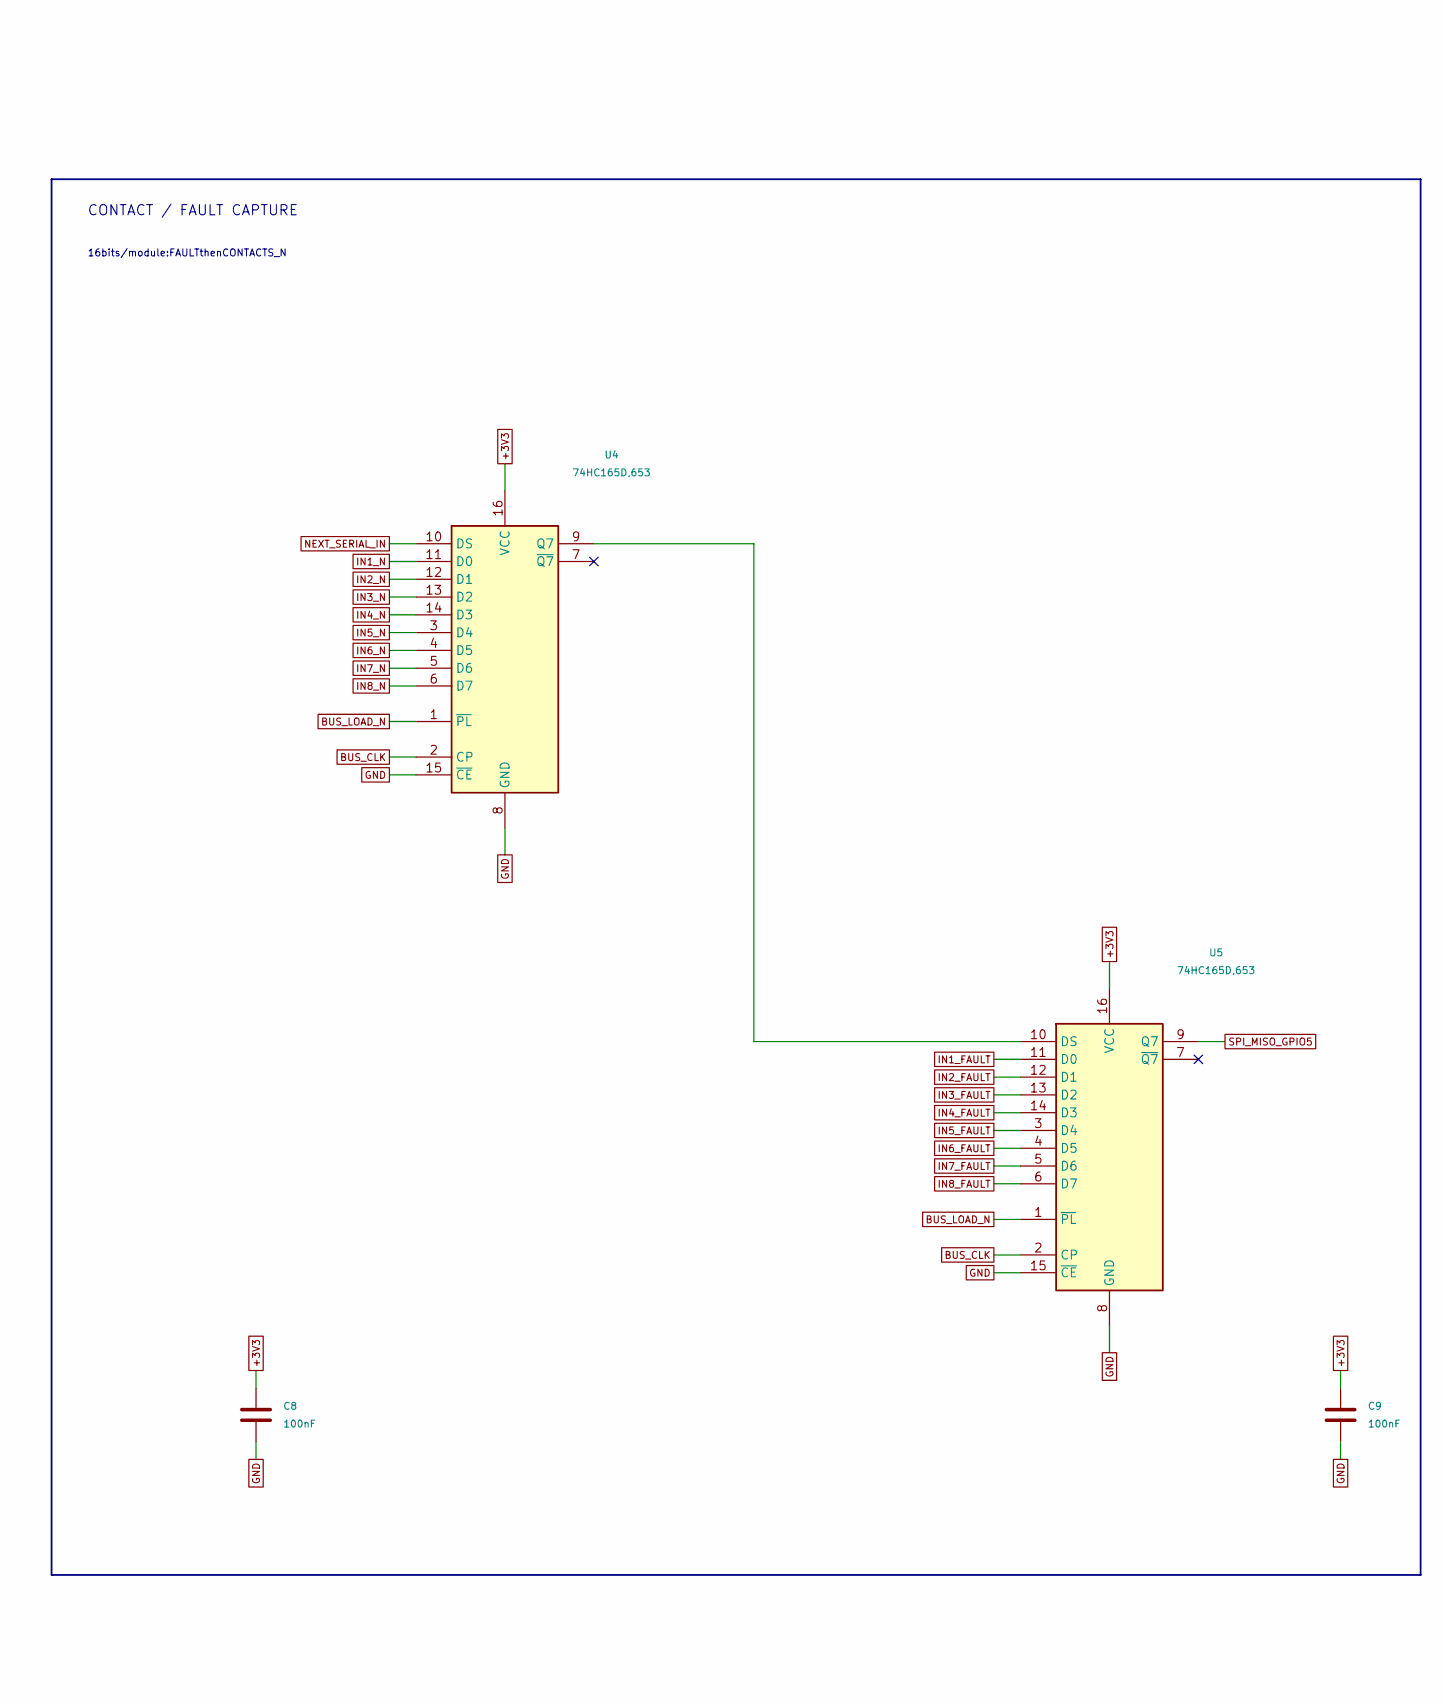
[picture p36: schematic Serial_IO.kicad_sch, 04 | Register chains, part in row 1, column 2]

Parts:
C7, C8, C9: 100nF; C_0805_2012Metric; MPN CC0805KRX7R9BB104; LCSC C49678
U3: 74HC595D,118; SOIC-16_3.9x9.9mm_P1.27mm; MPN 74HC595D,118; LCSC C5947
U4, U5: 74HC165D,653; SOIC-16_3.9x9.9mm_P1.27mm; MPN 74HC165D,653; LCSC C5613

Connections:
+3V3: C7.1, C8.1, C9.1, U3.16 (VCC), U4.16 (VCC), U5.16 (VCC); also elsewhere on the board
BUS_CLK: U3.11 (SRCLK), U4.2 (CP), U5.2 (CP); also elsewhere on the board
BUS_CLR_N: U3.10 (~SRCLR); also elsewhere on the board
BUS_LATCH: U3.12 (RCLK); also elsewhere on the board
BUS_LOAD_N: U4.1 (~PL), U5.1 (~PL); also elsewhere on the board
BUS_SER_IN: U3.14 (SER); also elsewhere on the board
GND: C7.2, C8.2, C9.2, U3.8 (GND), U4.8 (GND), U4.15 (~CE), U5.8 (GND), U5.15 (~CE); also elsewhere on the board
IN1_FAULT: U5.11 (D0); also elsewhere on the board
IN1_N: U4.11 (D0); also elsewhere on the board
IN2_FAULT: U5.12 (D1); also elsewhere on the board
IN2_N: U4.12 (D1); also elsewhere on the board
IN3_FAULT: U5.13 (D2); also elsewhere on the board
IN3_N: U4.13 (D2); also elsewhere on the board
IN4_FAULT: U5.14 (D3); also elsewhere on the board
IN4_N: U4.14 (D3); also elsewhere on the board
IN5_FAULT: U5.3 (D4); also elsewhere on the board
IN5_N: U4.3 (D4); also elsewhere on the board
IN6_FAULT: U5.4 (D5); also elsewhere on the board
IN6_N: U4.4 (D5); also elsewhere on the board
IN7_FAULT: U5.5 (D6); also elsewhere on the board
IN7_N: U4.5 (D6); also elsewhere on the board
IN8_FAULT: U5.6 (D7); also elsewhere on the board
IN8_N: U4.6 (D7); also elsewhere on the board
LOCAL_SER_OUT: U3.9 (QH'); also elsewhere on the board
NEXT_SERIAL_IN: U4.10 (DS); also elsewhere on the board
unnamed: U4.9 (Q7), U5.10 (DS)
RLY1_CMD: U3.15 (QA); also elsewhere on the board
RLY2_CMD: U3.1 (QB); also elsewhere on the board
RLY3_CMD: U3.2 (QC); also elsewhere on the board
RLY4_CMD: U3.3 (QD); also elsewhere on the board
RLY5_CMD: U3.4 (QE); also elsewhere on the board
RLY6_CMD: U3.5 (QF); also elsewhere on the board
RLY7_CMD: U3.6 (QG); also elsewhere on the board
RLY8_CMD: U3.7 (QH); also elsewhere on the board
RLY_OE_ACTUAL_N: U3.13 (~OE); also elsewhere on the board
SPI_MISO_GPIO5: U5.9 (Q7); also elsewhere on the board

Notes on the sheet:
UNIVERSAL POOFER CONTROL | 04 | Register chains
REV A.3 | Dry contacts | Latched hardware stop | Buffered expansion
595 RELAY COMMAND LATCH
QA=valve1; latch commits afterfullshift
CONTACT / FAULT CAPTURE
16bits/module:FAULTthenCONTACTS_N
SampleQ7beforeclock. TailpulledHIGH fillsabsentmoduleswithFAULTFF,notfalseclosures.
