NOVA-Cluster/Universal-Poofer-Control/Universal_Poofer_Control.kicad_pcb

## KiCad design Universal_Poofer_Control.kicad_pcb (continued)

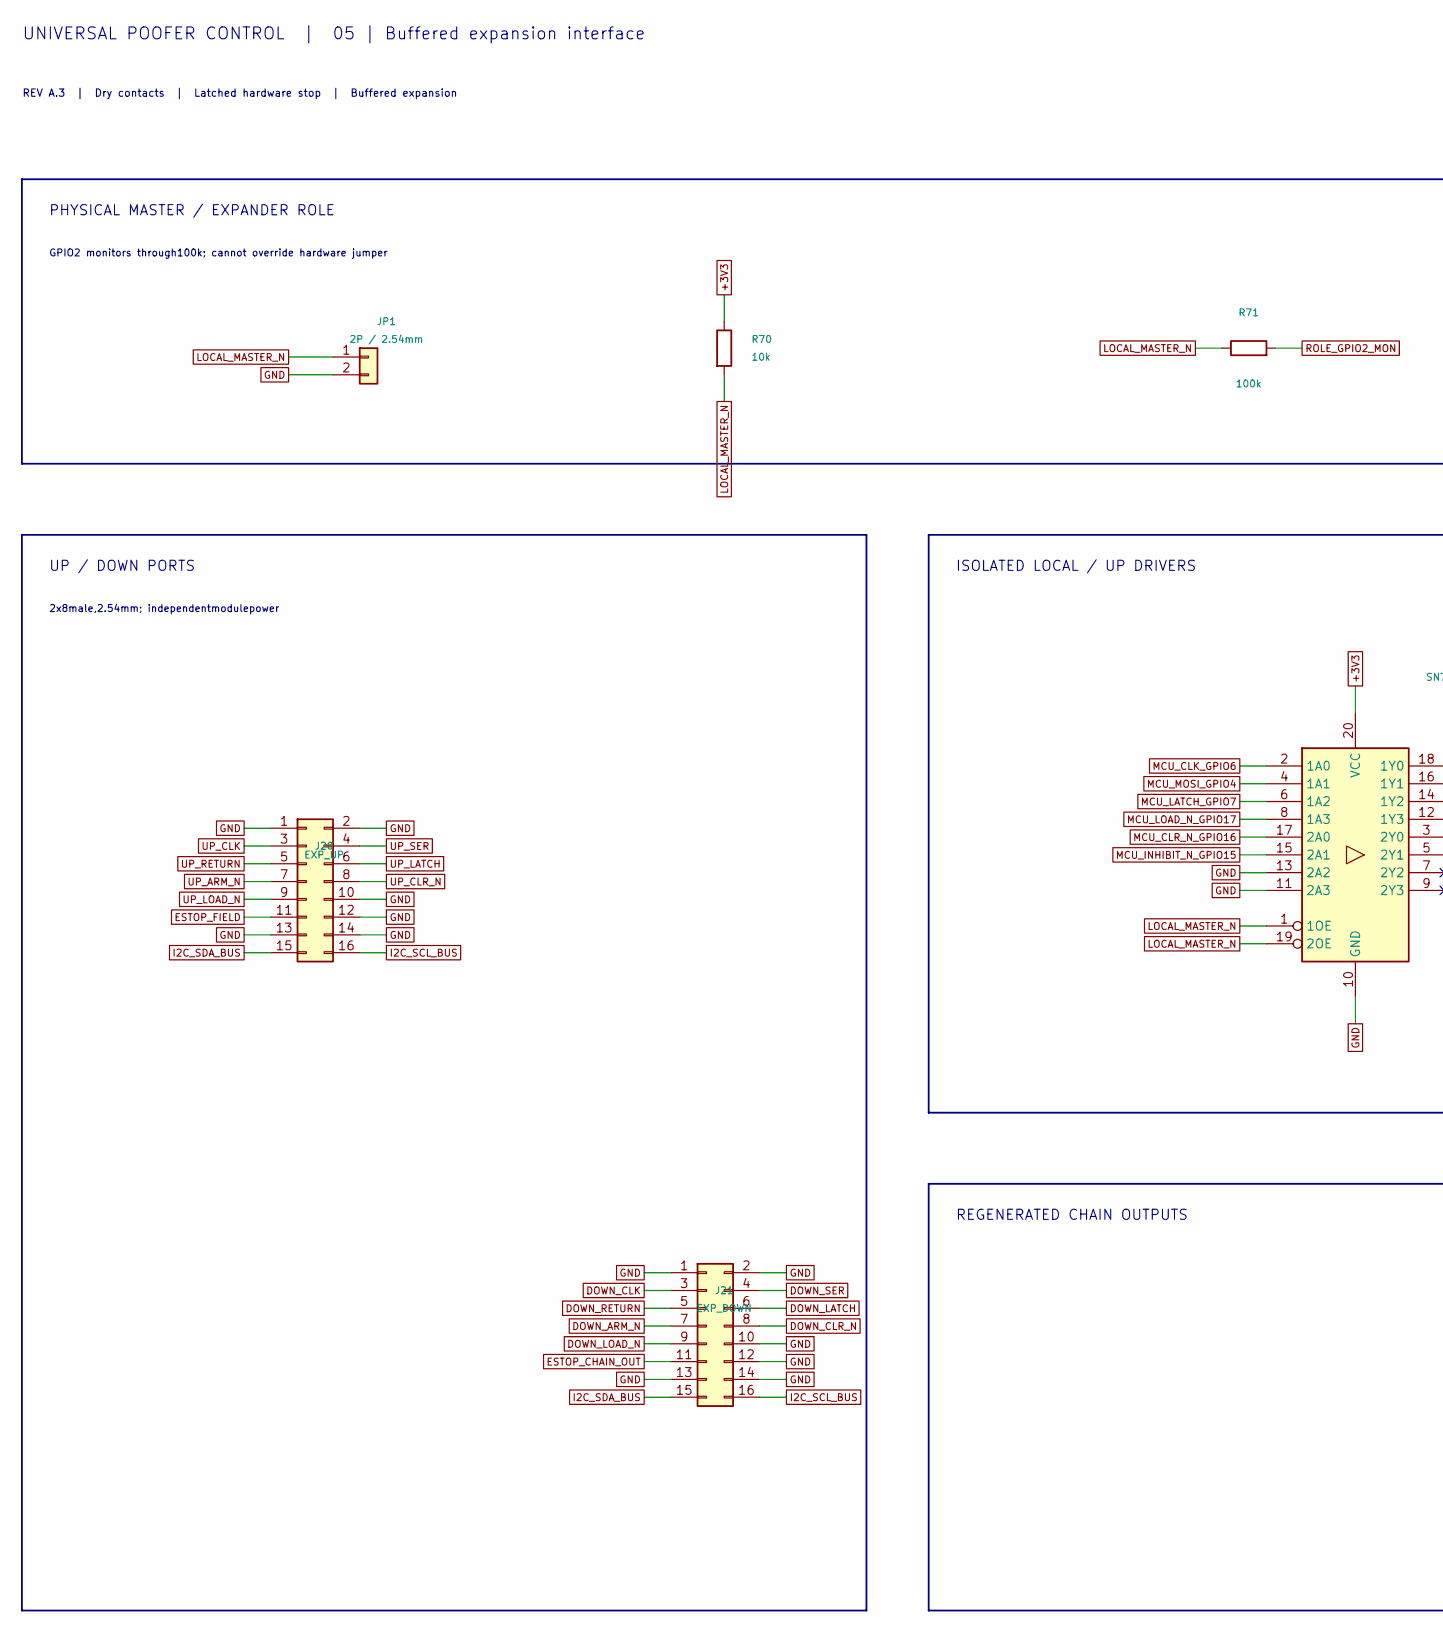
[picture p37: schematic Expansion.kicad_sch, 05 | Buffered expansion interface, part in row 1, column 1]

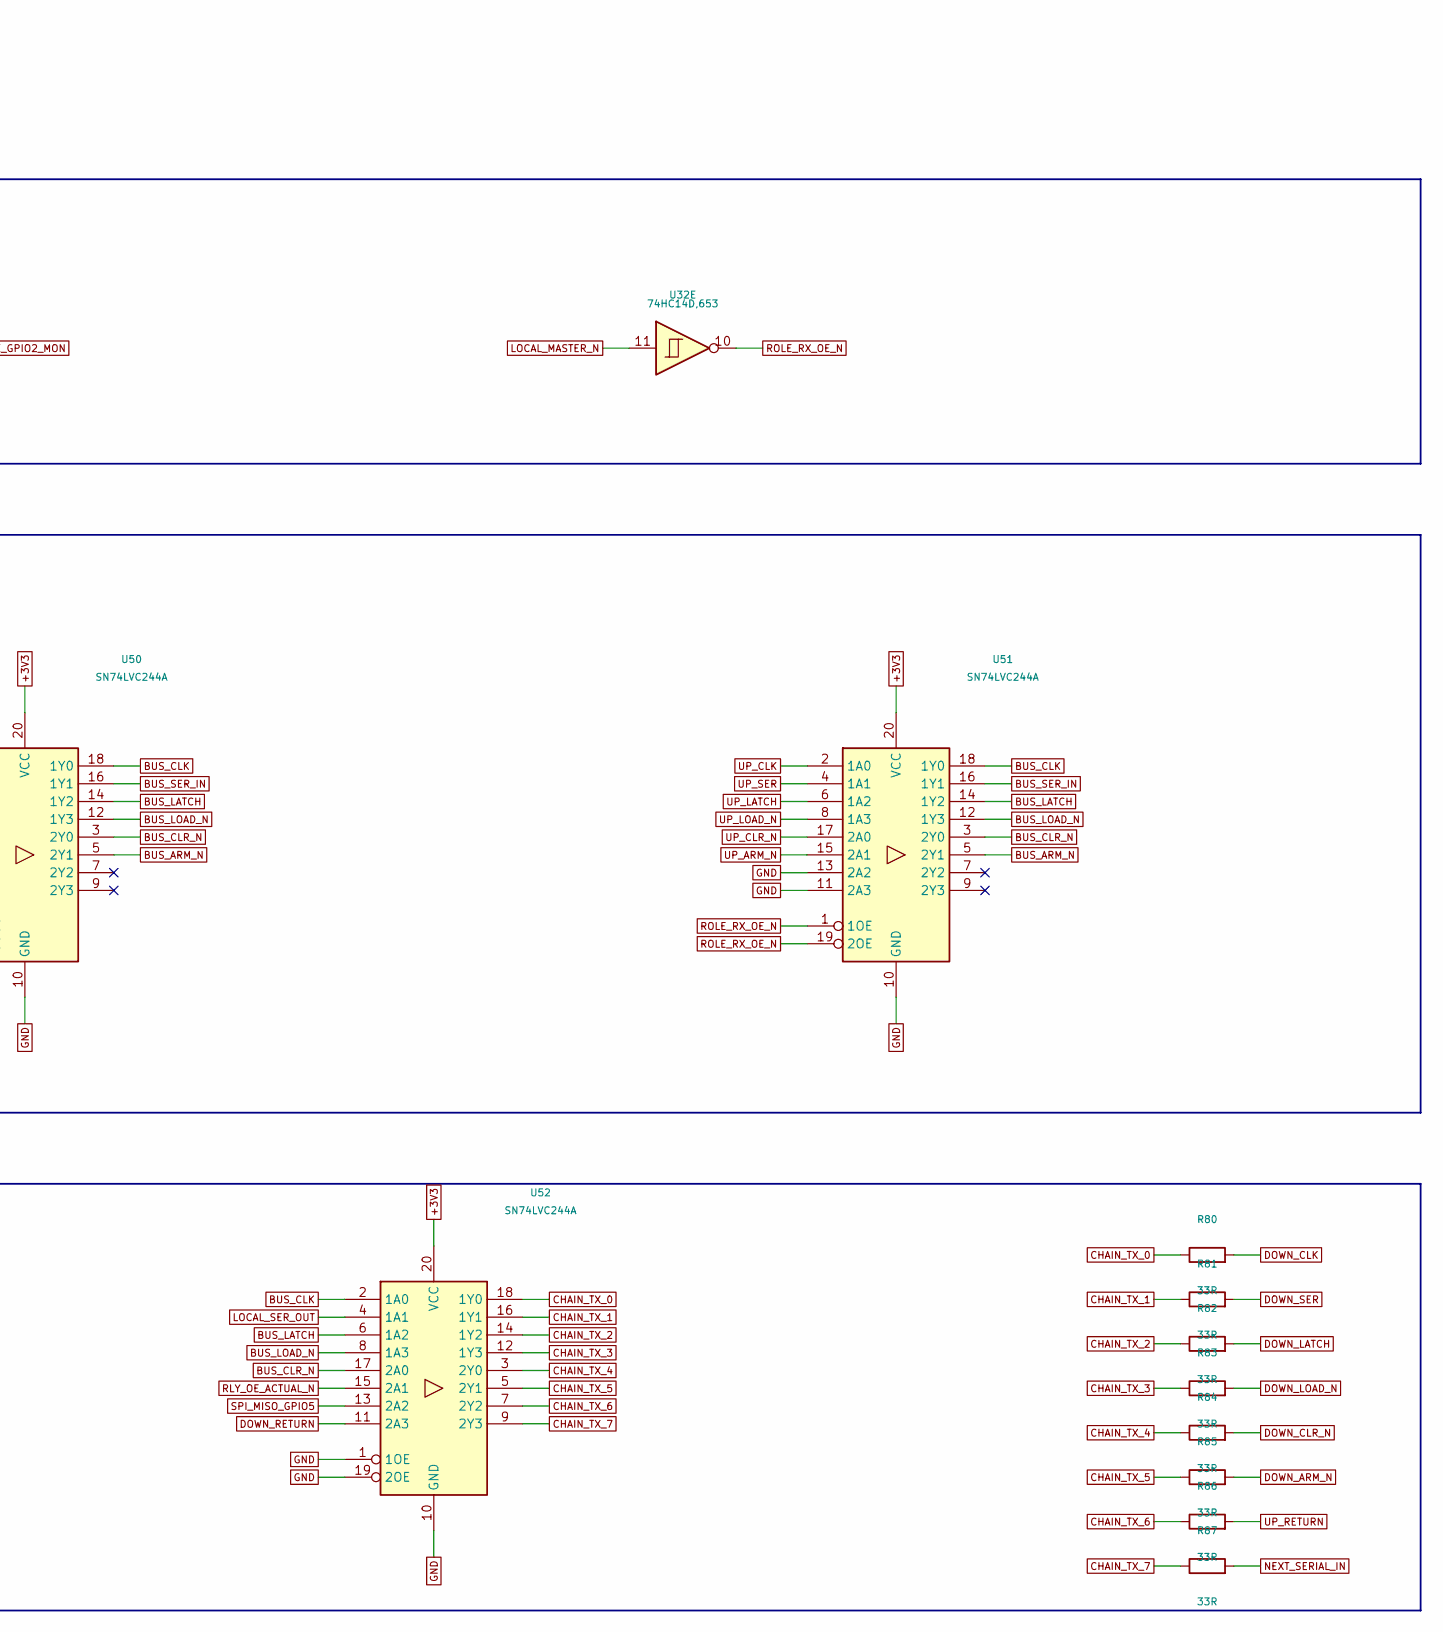
[picture p38: schematic Expansion.kicad_sch, 05 | Buffered expansion interface, part in row 1, column 2]

Parts:
J20: EXP_UP; PinHeader_2x08_P2.54mm_Vertical; MPN 2.54-2*8P针; LCSC C68234
J21: EXP_DOWN; PinHeader_2x08_P2.54mm_Vertical; MPN 2.54-2*8P针; LCSC C68234
JP1: 2P / 2.54mm; PinHeader_1x02_P2.54mm_Vertical; MPN B-2100S02P-A110; LCSC C124375
R70: 10k; R_0805_2012Metric; MPN 0805W8F1002T5E; LCSC C17414
R71: 100k; R_0805_2012Metric; MPN 0805W8F1003T5E; LCSC C149504
R80, R81, R82, R83, R84, R85, R86, R87: 33R; R_0805_2012Metric; MPN 0805W8F330JT5E; LCSC C17634
U32: 74HC14D,653; SOIC-14_3.9x8.7mm_P1.27mm; MPN 74HC14D,653; LCSC C5605
U50, U51, U52: SN74LVC244A; SOIC-20W_7.5x12.8mm_P1.27mm; MPN SN74LVC244ADWR; LCSC C507250

Connections:
+3V3: R70.1, U50.20 (VCC), U51.20 (VCC), U52.20 (VCC); also elsewhere on the board
BUS_ARM_N: U50.5 (2Y1), U51.5 (2Y1); also elsewhere on the board
BUS_CLK: U50.18 (1Y0), U51.18 (1Y0), U52.2 (1A0); also elsewhere on the board
BUS_CLR_N: U50.3 (2Y0), U51.3 (2Y0), U52.17 (2A0); also elsewhere on the board
BUS_LATCH: U50.14 (1Y2), U51.14 (1Y2), U52.6 (1A2); also elsewhere on the board
BUS_LOAD_N: U50.12 (1Y3), U51.12 (1Y3), U52.8 (1A3); also elsewhere on the board
BUS_SER_IN: U50.16 (1Y1), U51.16 (1Y1); also elsewhere on the board
CHAIN_TX_0: R80.1, U52.18 (1Y0)
CHAIN_TX_1: R81.1, U52.16 (1Y1)
CHAIN_TX_2: R82.1, U52.14 (1Y2)
CHAIN_TX_3: R83.1, U52.12 (1Y3)
CHAIN_TX_4: R84.1, U52.3 (2Y0)
CHAIN_TX_5: R85.1, U52.5 (2Y1)
CHAIN_TX_6: R86.1, U52.7 (2Y2)
CHAIN_TX_7: R87.1, U52.9 (2Y3)
DOWN_ARM_N: J21.7, R85.2
DOWN_CLK: J21.3, R80.2
DOWN_CLR_N: J21.8, R84.2
DOWN_LATCH: J21.6, R82.2
DOWN_LOAD_N: J21.9, R83.2
DOWN_RETURN: J21.5, U52.11 (2A3); also elsewhere on the board
DOWN_SER: J21.4, R81.2
ESTOP_CHAIN_OUT: J21.11; also elsewhere on the board
ESTOP_FIELD: J20.11; also elsewhere on the board
GND: J20.1, J20.2, J20.10, J20.12, J20.13, J20.14, J21.1, J21.2, J21.10, J21.12, J21.13, J21.14, JP1.2, U50.10 (GND), U50.11 (2A3), U50.13 (2A2), U51.10 (GND), U51.11 (2A3), U51.13 (2A2), U52.1 (1OE), U52.10 (GND), U52.19 (2OE); also elsewhere on the board
I2C_SCL_BUS: J20.16, J21.16; also elsewhere on the board
I2C_SDA_BUS: J20.15, J21.15; also elsewhere on the board
LOCAL_MASTER_N: JP1.1, R70.2, R71.1, U32.11, U50.1 (1OE), U50.19 (2OE); also elsewhere on the board
LOCAL_SER_OUT: U52.4 (1A1); also elsewhere on the board
MCU_CLK_GPIO6: U50.2 (1A0); also elsewhere on the board
MCU_CLR_N_GPIO16: U50.17 (2A0); also elsewhere on the board
MCU_INHIBIT_N_GPIO15: U50.15 (2A1); also elsewhere on the board
MCU_LATCH_GPIO7: U50.6 (1A2); also elsewhere on the board
MCU_LOAD_N_GPIO17: U50.8 (1A3); also elsewhere on the board
MCU_MOSI_GPIO4: U50.4 (1A1); also elsewhere on the board
NEXT_SERIAL_IN: R87.2; also elsewhere on the board
RLY_OE_ACTUAL_N: U52.15 (2A1); also elsewhere on the board
ROLE_GPIO2_MON: R71.2; also elsewhere on the board
ROLE_RX_OE_N: U32.10, U51.1 (1OE), U51.19 (2OE)
SPI_MISO_GPIO5: U52.13 (2A2); also elsewhere on the board
UP_ARM_N: J20.7, U51.15 (2A1); also elsewhere on the board
UP_CLK: J20.3, U51.2 (1A0); also elsewhere on the board
UP_CLR_N: J20.8, U51.17 (2A0); also elsewhere on the board
UP_LATCH: J20.6, U51.6 (1A2); also elsewhere on the board
UP_LOAD_N: J20.9, U51.8 (1A3); also elsewhere on the board
UP_RETURN: J20.5, R86.2
UP_SER: J20.4, U51.4 (1A1); also elsewhere on the board

Notes on the sheet:
UNIVERSAL POOFER CONTROL | 05 | Buffered expansion interface
REV A.3 | Dry contacts | Latched hardware stop | Buffered expansion
PHYSICAL MASTER / EXPANDER ROLE
GPIO2 monitors through100k; cannot override hardware jumper
UP / DOWN PORTS
2x8male,2.54mm; independentmodulepower
ISOLATED LOCAL / UP DRIVERS
REGENERATED CHAIN OUTPUTS

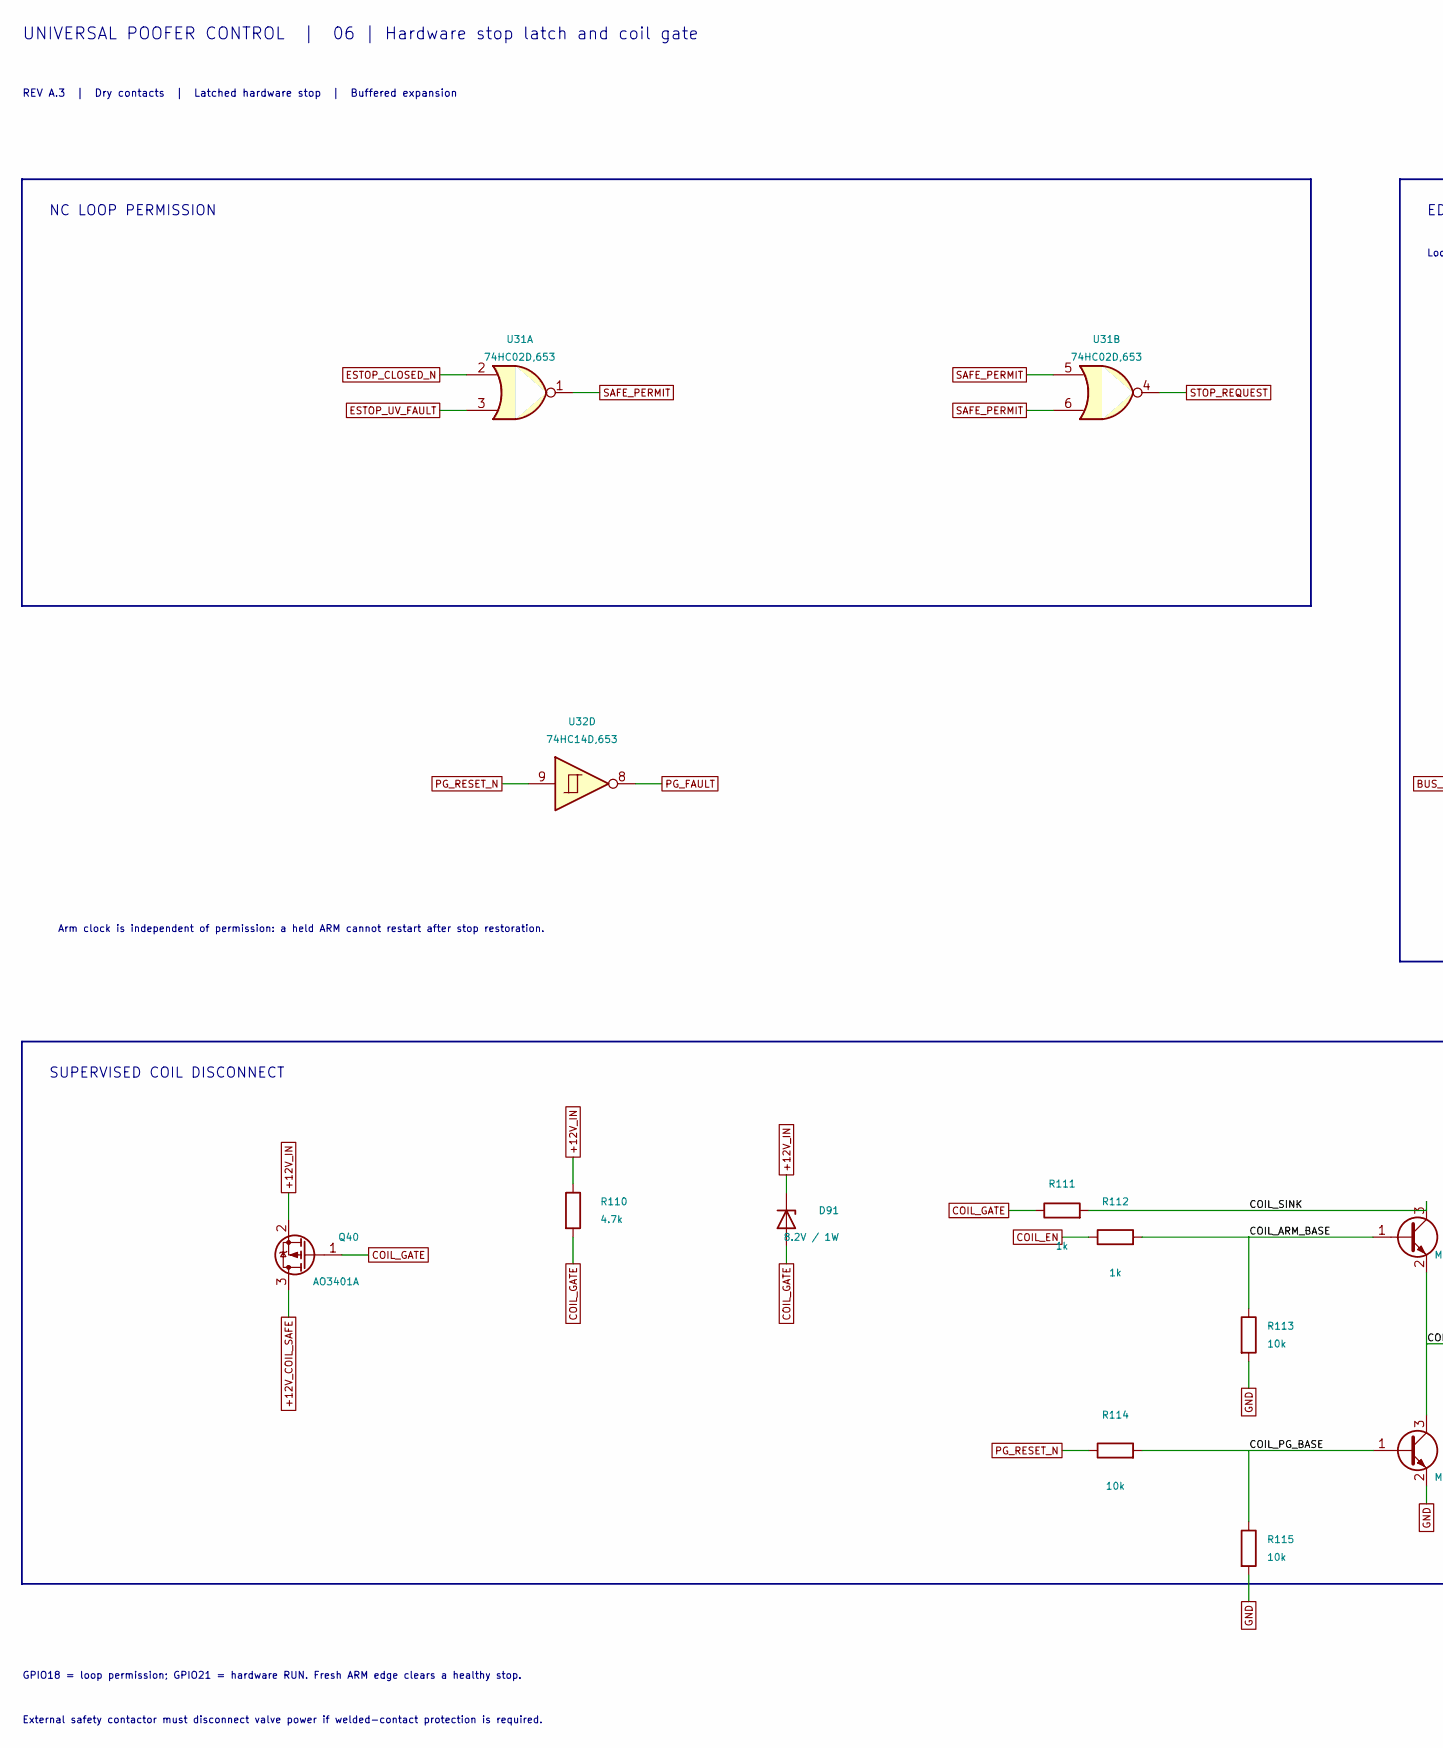
[picture p39: schematic Hardware_Stop.kicad_sch, 06 | Hardware stop latch and coil gate, part in row 1, column 1]

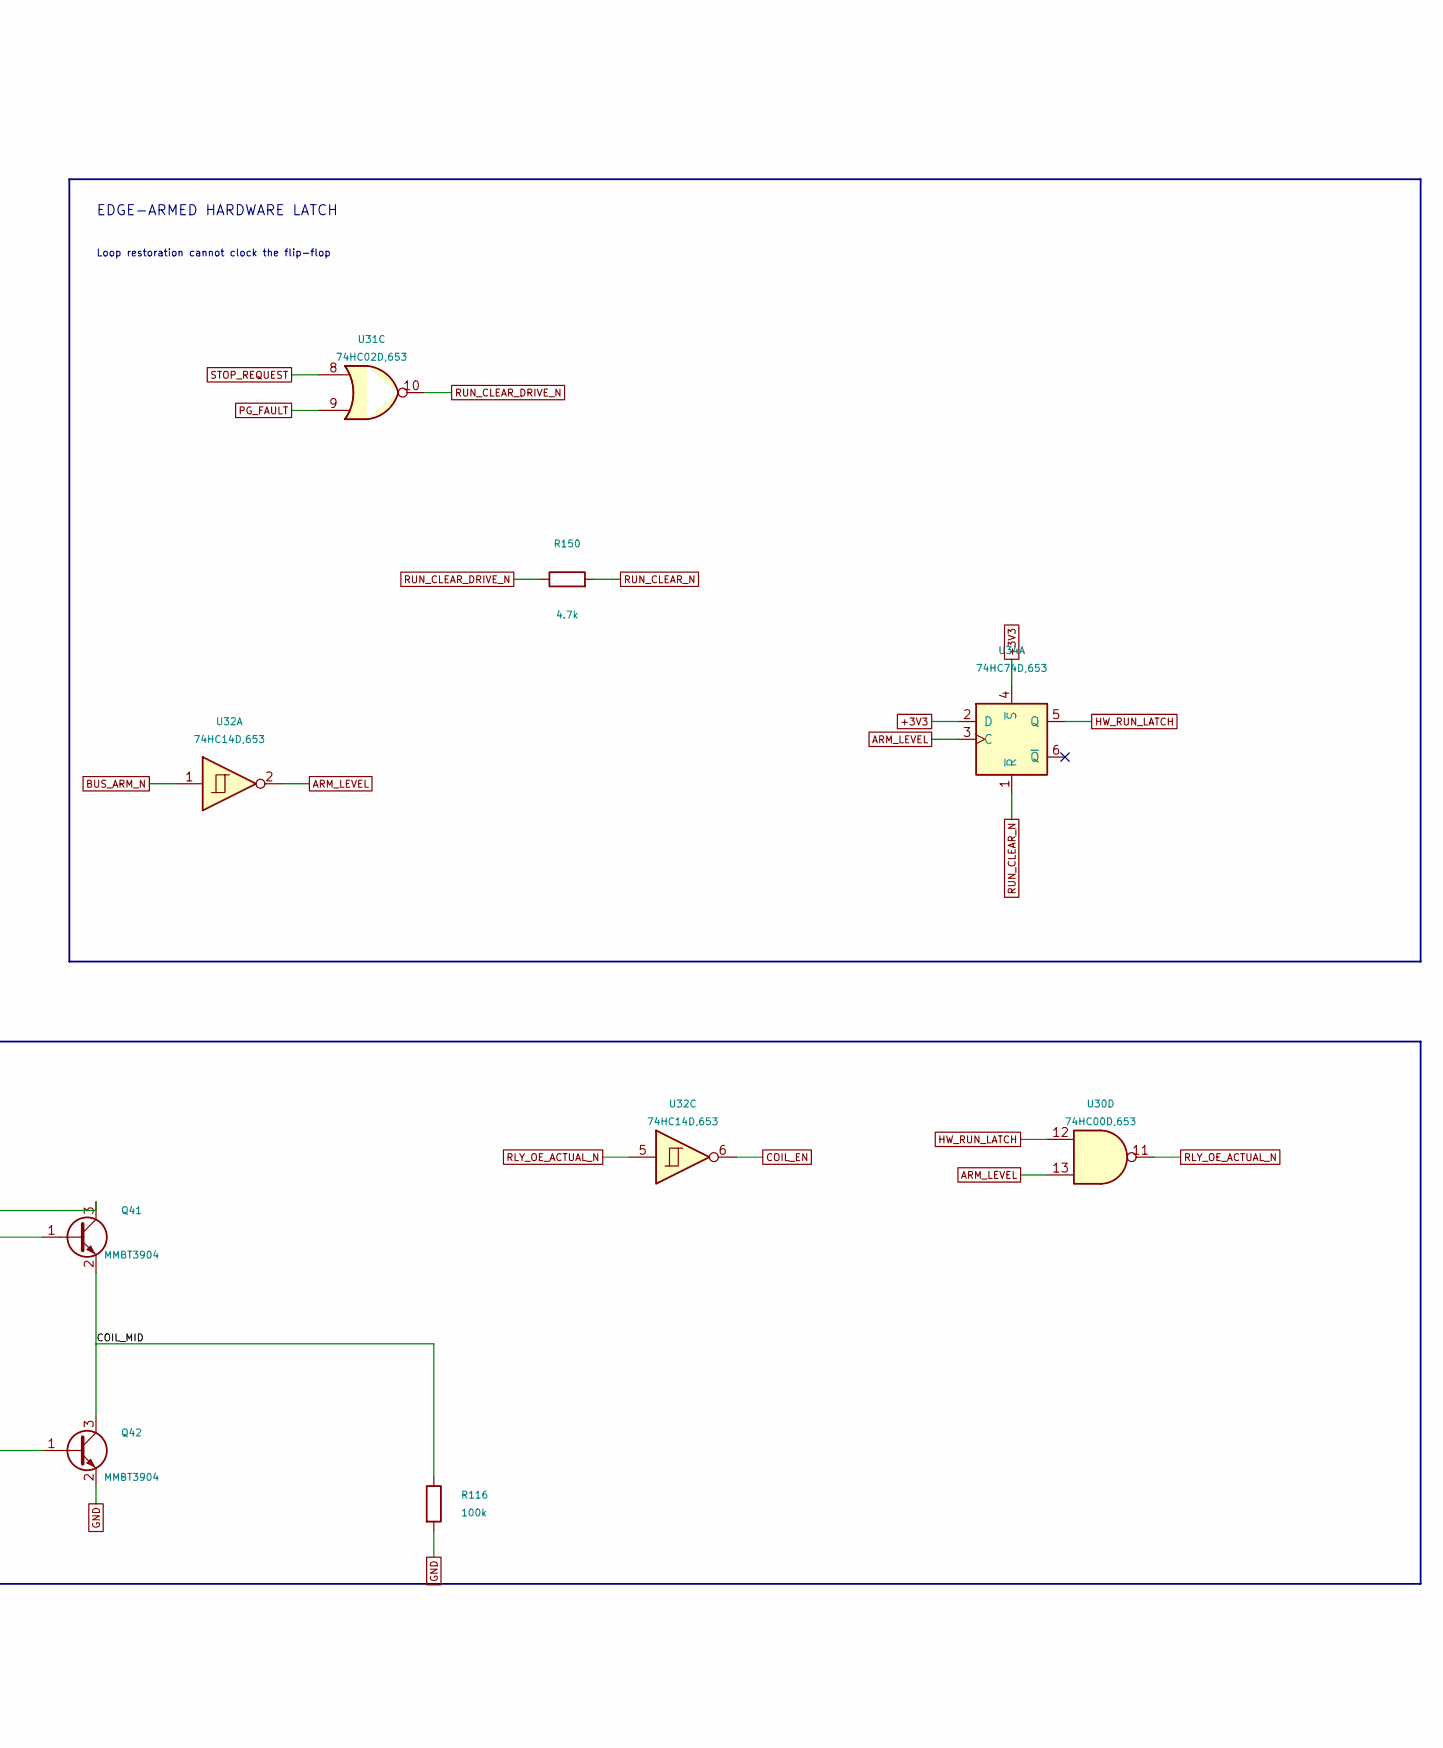
[picture p40: schematic Hardware_Stop.kicad_sch, 06 | Hardware stop latch and coil gate, part in row 1, column 2]

Parts:
D91: 8.2V / 1W; D_SMA; MPN SMAZ8V2-13-F; LCSC C84362
Q40: AO3401A; SOT-23; MPN AO3401A; LCSC C15127
Q41, Q42: MMBT3904; SOT-23; MPN MMBT3904(RANGE:100-300); LCSC C20526
R110, R150: 4.7k; R_0805_2012Metric; MPN 0805W8F4701T5E; LCSC C17673
R111, R112: 1k; R_0805_2012Metric; MPN 0805W8F1001T5E; LCSC C17513
R113, R114, R115: 10k; R_0805_2012Metric; MPN 0805W8F1002T5E; LCSC C17414
R116: 100k; R_0805_2012Metric; MPN 0805W8F1003T5E; LCSC C149504
U30: 74HC00D,653; SOIC-14_3.9x8.7mm_P1.27mm; MPN 74HC00D,653; LCSC C5586
U31: 74HC02D,653; SOIC-14_3.9x8.7mm_P1.27mm; MPN 74HC02D,653; LCSC C5588
U32: 74HC14D,653; SOIC-14_3.9x8.7mm_P1.27mm; MPN 74HC14D,653; LCSC C5605
U34: 74HC74D,653; SOIC-14_3.9x8.7mm_P1.27mm; MPN 74HC74D,653; LCSC C27597

Connections:
+3V3: U34.2 (D), U34.4 (~S); also elsewhere on the board
+12V_COIL_SAFE: Q40.3 (D); also elsewhere on the board
+12V_IN: D91.1 (K), Q40.2 (S), R110.1; also elsewhere on the board
/06 | Hardware stop latch and coil gate/COIL_ARM_BASE: Q41.1 (B), R112.2, R113.1
/06 | Hardware stop latch and coil gate/COIL_MID: Q41.2 (E), Q42.3 (C), R116.1
/06 | Hardware stop latch and coil gate/COIL_PG_BASE: Q42.1 (B), R114.2, R115.1
/06 | Hardware stop latch and coil gate/COIL_SINK: Q41.3 (C), R111.2
ARM_LEVEL: U30.13, U32.2, U34.3 (C)
BUS_ARM_N: U32.1; also elsewhere on the board
COIL_EN: R112.1, U32.6
COIL_GATE: D91.2 (A), Q40.1 (G), R110.2, R111.1
ESTOP_CLOSED_N: U31.2; also elsewhere on the board
ESTOP_UV_FAULT: U31.3; also elsewhere on the board
GND: Q42.2 (E), R113.2, R115.2, R116.2; also elsewhere on the board
HW_RUN_LATCH: U30.12, U34.5 (Q); also elsewhere on the board
PG_FAULT: U31.9, U32.8
PG_RESET_N: R114.1, U32.9; also elsewhere on the board
RLY_OE_ACTUAL_N: U30.11, U32.5; also elsewhere on the board
RUN_CLEAR_DRIVE_N: R150.1, U31.10
RUN_CLEAR_N: R150.2, U34.1 (~R); also elsewhere on the board
SAFE_PERMIT: U31.1, U31.5, U31.6; also elsewhere on the board
STOP_REQUEST: U31.4, U31.8

Notes on the sheet:
UNIVERSAL POOFER CONTROL | 06 | Hardware stop latch and coil gate
REV A.3 | Dry contacts | Latched hardware stop | Buffered expansion
NC LOOP PERMISSION
EDGE-ARMED HARDWARE LATCH
Loop restoration cannot clock the flip-flop
SUPERVISED COIL DISCONNECT
Arm clock is independent of permission: a held ARM cannot restart after stop restoration.
GPIO18 = loop permission; GPIO21 = hardware RUN. Fresh ARM edge clears a healthy stop.
External safety contactor must disconnect valve power if welded-contact protection is required.

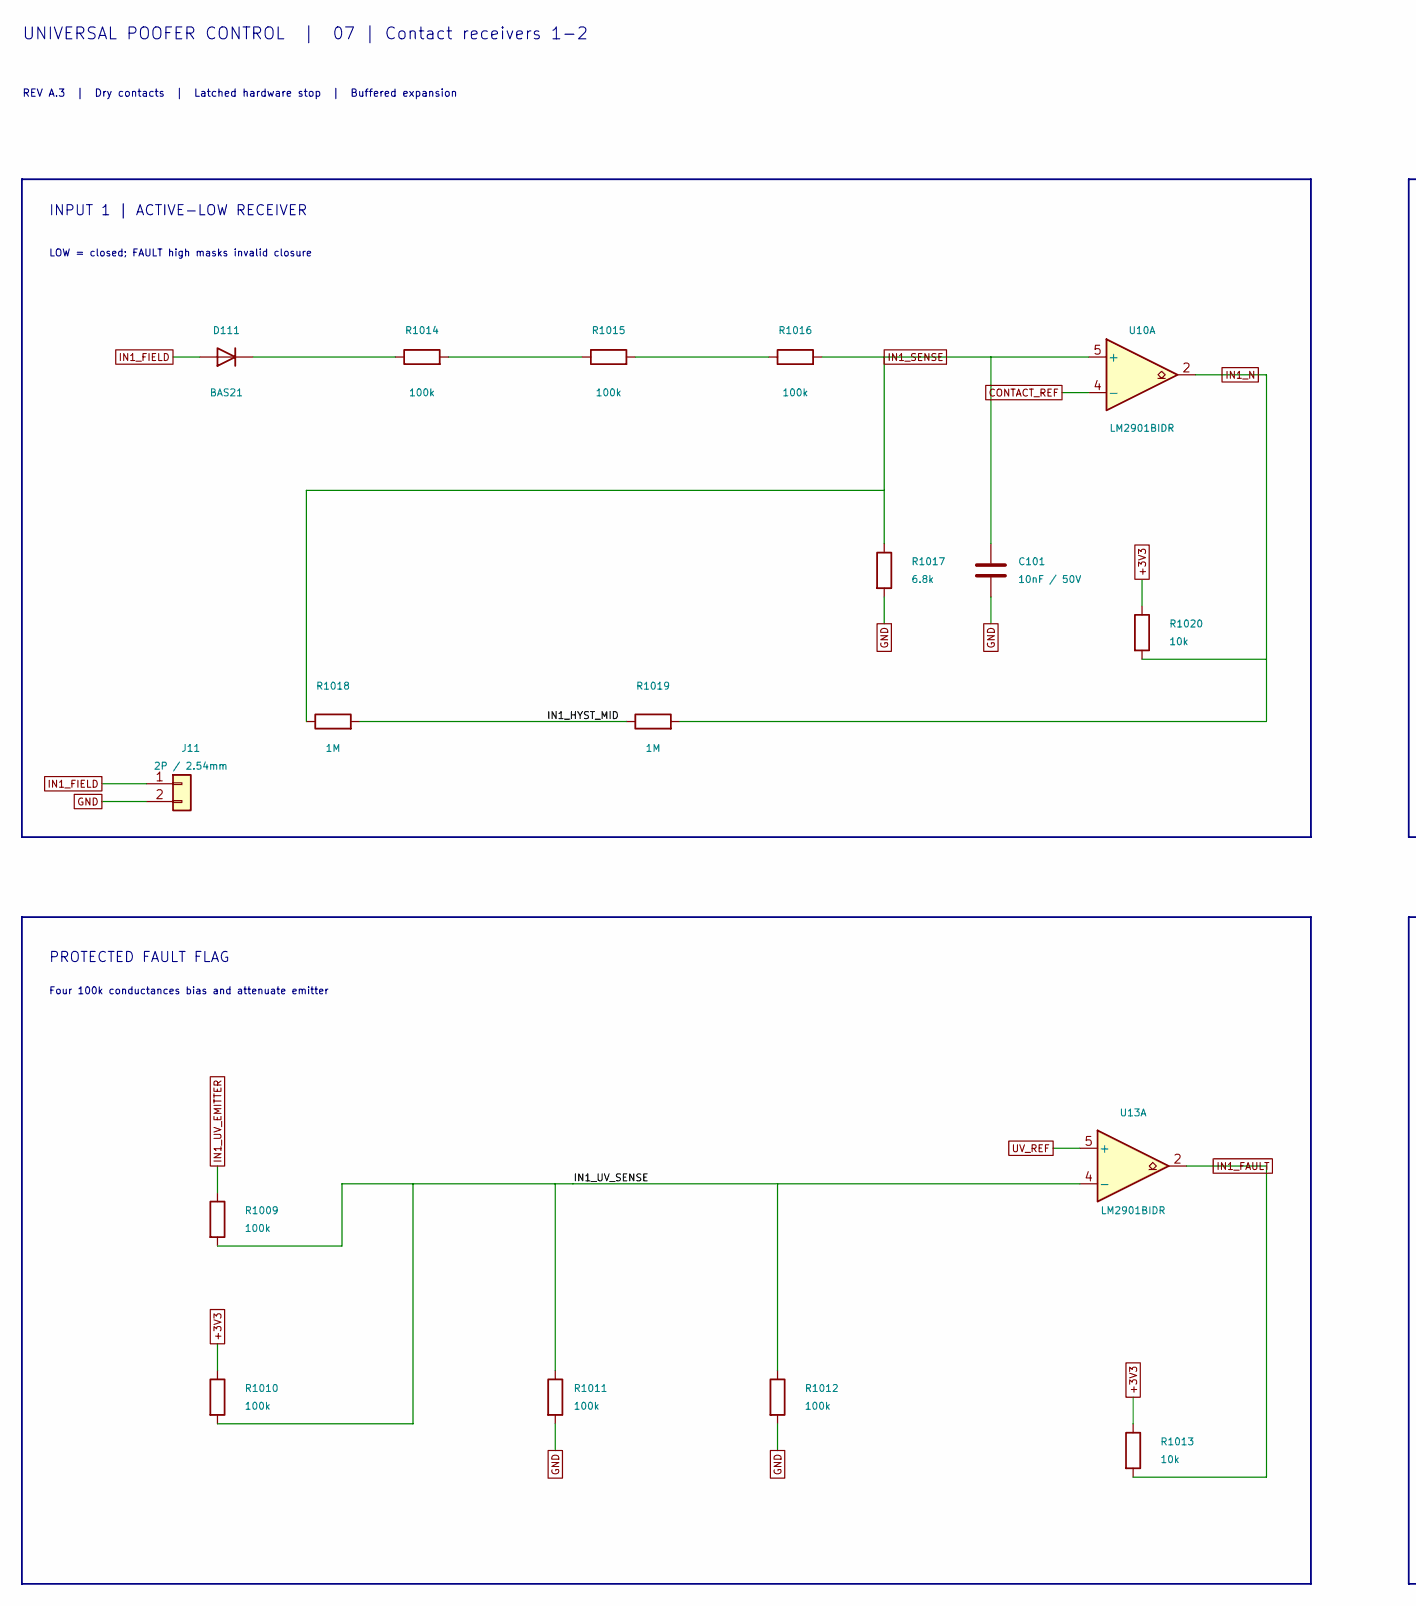
[picture p41: schematic Input_Receivers_1.kicad_sch, 07 | Contact receivers 1-2, part in row 1, column 1]

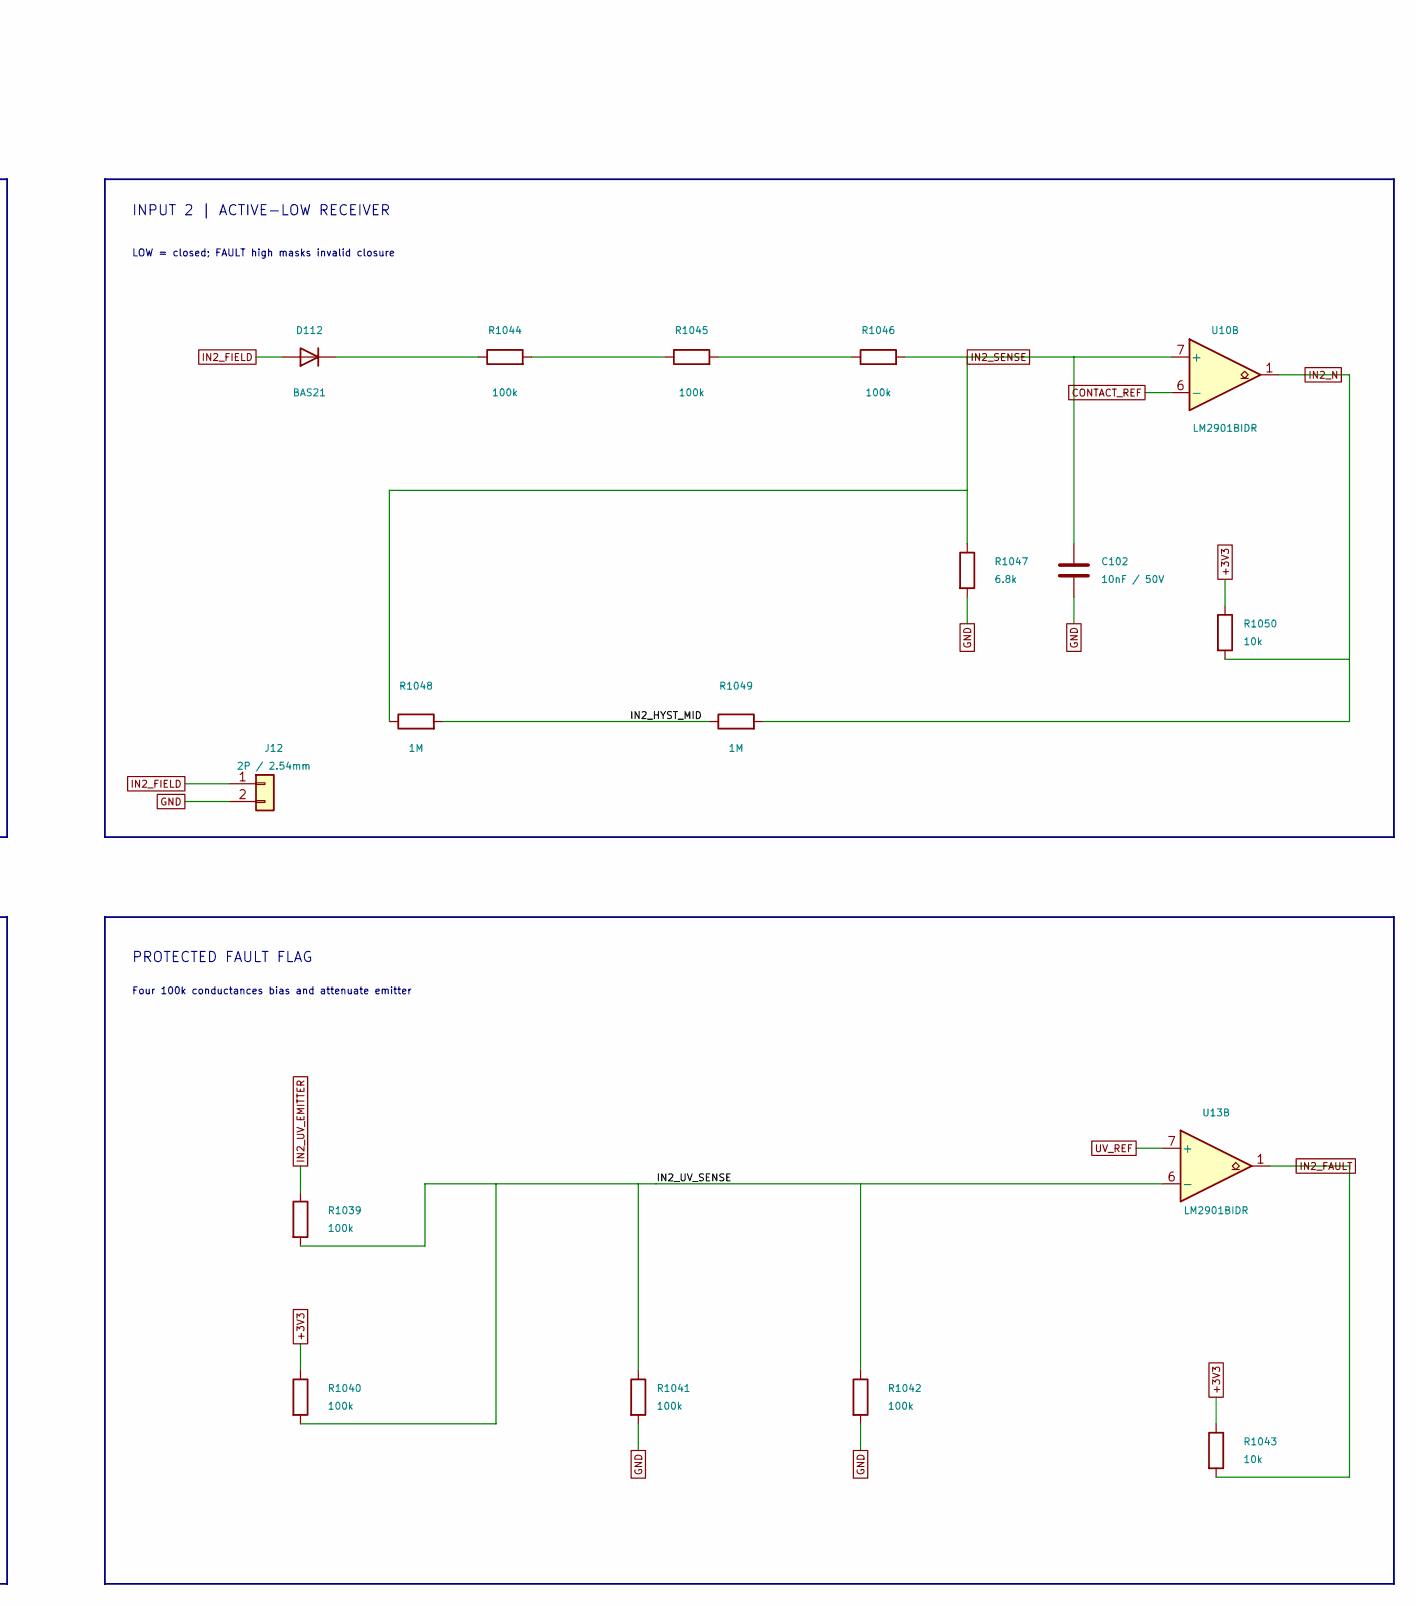
[picture p42: schematic Input_Receivers_1.kicad_sch, 07 | Contact receivers 1-2, part in row 1, column 2]

Parts:
C101, C102: 10nF / 50V; C_0805_2012Metric; MPN CL21B103KBANNNC; LCSC C1710
D111, D112: BAS21; SOT-23; MPN BAS21,215; LCSC C8661
J11, J12: 2P / 2.54mm; PinHeader_1x02_P2.54mm_Vertical; MPN B-2100S02P-A110; LCSC C124375
R1009, R1010, R1011, R1012, R1014, R1015, R1016, R1039, R1040, R1041, R1042, R1044, R1045, R1046: 100k; R_0805_2012Metric; MPN 0805W8F1003T5E; LCSC C149504
R1013, R1020, R1043, R1050: 10k; R_0805_2012Metric; MPN 0805W8F1002T5E; LCSC C17414
R1017, R1047: 6.8k; R_0805_2012Metric; MPN 0805W8F6801T5E; LCSC C17772
R1018, R1019, R1048, R1049: 1M; R_0805_2012Metric; MPN 0805W8F1004T5E; LCSC C17514
U10, U13: LM2901BIDR; SOIC-14_3.9x8.7mm_P1.27mm; MPN LM2901BIDR; LCSC C22427890

Connections:
+3V3: R1010.1, R1013.1, R1020.1, R1040.1, R1043.1, R1050.1; also elsewhere on the board
/07 | Contact receivers 1-2/IN1_HYST_MID: R1018.2, R1019.1
/07 | Contact receivers 1-2/IN1_UV_SENSE: R1009.2, R1010.2, R1011.1, R1012.1, U13.4 (-)
/07 | Contact receivers 1-2/IN2_HYST_MID: R1048.2, R1049.1
/07 | Contact receivers 1-2/IN2_UV_SENSE: R1039.2, R1040.2, R1041.1, R1042.1, U13.6 (-)
CONTACT_REF: U10.4 (-), U10.6 (-); also elsewhere on the board
GND: C101.2, C102.2, J11.2, J12.2, R1011.2, R1012.2, R1017.2, R1041.2, R1042.2, R1047.2; also elsewhere on the board
IN1_FAULT: R1013.2, U13.2; also elsewhere on the board
IN1_FIELD: D111.1 (A), J11.1; also elsewhere on the board
IN1_N: R1019.2, R1020.2, U10.2; also elsewhere on the board
IN1_SENSE: C101.1, R1016.2, R1017.1, R1018.1, U10.5 (+)
IN1_UV_EMITTER: R1009.1; also elsewhere on the board
IN2_FAULT: R1043.2, U13.1; also elsewhere on the board
IN2_FIELD: D112.1 (A), J12.1; also elsewhere on the board
IN2_N: R1049.2, R1050.2, U10.1; also elsewhere on the board
IN2_SENSE: C102.1, R1046.2, R1047.1, R1048.1, U10.7 (+)
IN2_UV_EMITTER: R1039.1; also elsewhere on the board
unnamed: D111.3 (K), R1014.1
unnamed: D112.3 (K), R1044.1
unnamed: R1014.2, R1015.1
unnamed: R1015.2, R1016.1
unnamed: R1044.2, R1045.1
unnamed: R1045.2, R1046.1
UV_REF: U13.5 (+), U13.7 (+); also elsewhere on the board

Notes on the sheet:
UNIVERSAL POOFER CONTROL | 07 | Contact receivers 1-2
REV A.3 | Dry contacts | Latched hardware stop | Buffered expansion
INPUT 1 | ACTIVE-LOW RECEIVER
LOW = closed; FAULT high masks invalid closure
PROTECTED FAULT FLAG
Four 100k conductances bias and attenuate emitter
INPUT 2 | ACTIVE-LOW RECEIVER
