NOVA-Cluster/Universal-Poofer-Control/Universal_Poofer_Control.kicad_pcb

## KiCad design Universal_Poofer_Control.kicad_pcb (continued)

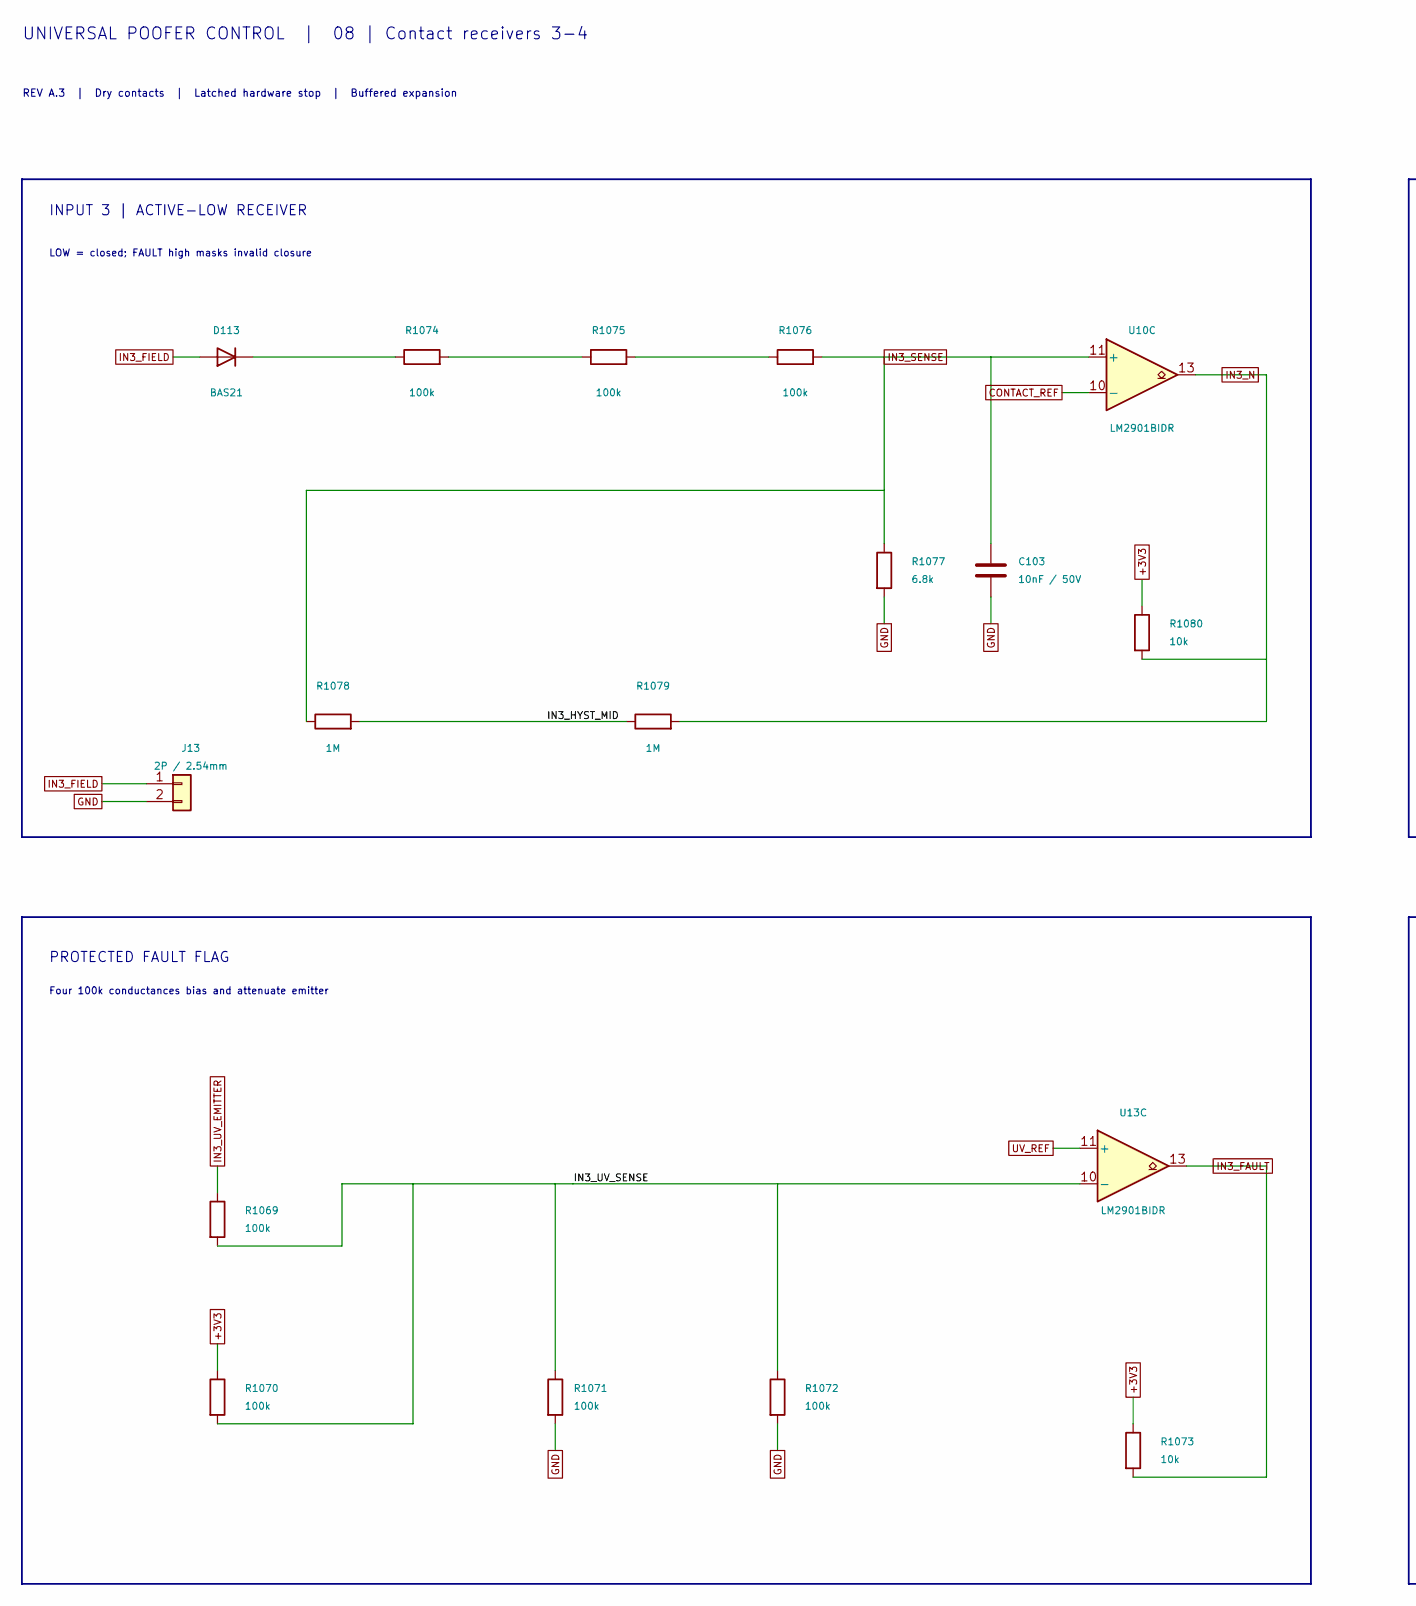
[picture p43: schematic Input_Receivers_2.kicad_sch, 08 | Contact receivers 3-4, part in row 1, column 1]

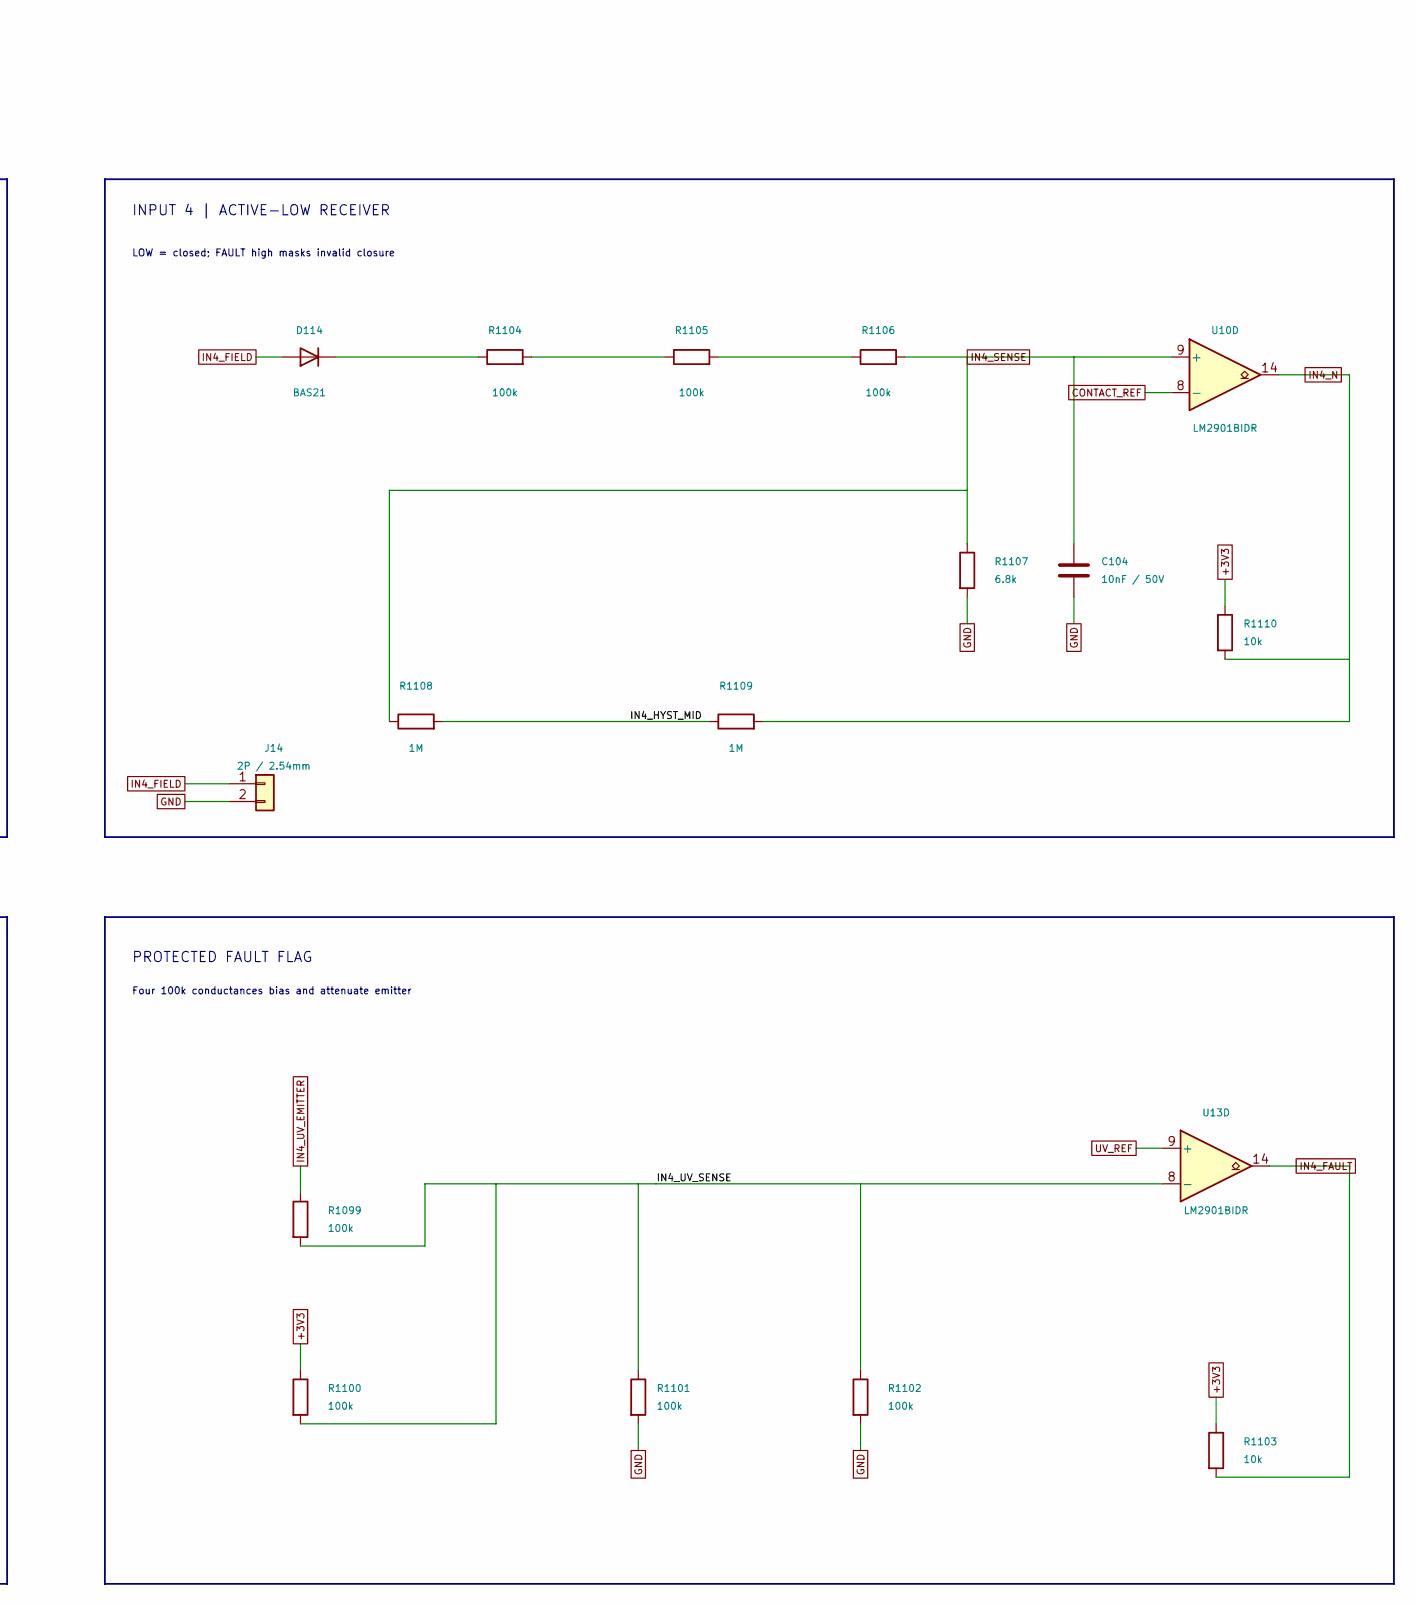
[picture p44: schematic Input_Receivers_2.kicad_sch, 08 | Contact receivers 3-4, part in row 1, column 2]

Parts:
C103, C104: 10nF / 50V; C_0805_2012Metric; MPN CL21B103KBANNNC; LCSC C1710
D113, D114: BAS21; SOT-23; MPN BAS21,215; LCSC C8661
J13, J14: 2P / 2.54mm; PinHeader_1x02_P2.54mm_Vertical; MPN B-2100S02P-A110; LCSC C124375
R1069, R1070, R1071, R1072, R1074, R1075, R1076, R1099, R1100, R1101, R1102, R1104, R1105, R1106: 100k; R_0805_2012Metric; MPN 0805W8F1003T5E; LCSC C149504
R1073, R1080, R1103, R1110: 10k; R_0805_2012Metric; MPN 0805W8F1002T5E; LCSC C17414
R1077, R1107: 6.8k; R_0805_2012Metric; MPN 0805W8F6801T5E; LCSC C17772
R1078, R1079, R1108, R1109: 1M; R_0805_2012Metric; MPN 0805W8F1004T5E; LCSC C17514
U10, U13: LM2901BIDR; SOIC-14_3.9x8.7mm_P1.27mm; MPN LM2901BIDR; LCSC C22427890

Connections:
+3V3: R1070.1, R1073.1, R1080.1, R1100.1, R1103.1, R1110.1; also elsewhere on the board
/08 | Contact receivers 3-4/IN3_HYST_MID: R1078.2, R1079.1
/08 | Contact receivers 3-4/IN3_UV_SENSE: R1069.2, R1070.2, R1071.1, R1072.1, U13.10 (-)
/08 | Contact receivers 3-4/IN4_HYST_MID: R1108.2, R1109.1
/08 | Contact receivers 3-4/IN4_UV_SENSE: R1099.2, R1100.2, R1101.1, R1102.1, U13.8 (-)
CONTACT_REF: U10.8 (-), U10.10 (-); also elsewhere on the board
GND: C103.2, C104.2, J13.2, J14.2, R1071.2, R1072.2, R1077.2, R1101.2, R1102.2, R1107.2; also elsewhere on the board
IN3_FAULT: R1073.2, U13.13; also elsewhere on the board
IN3_FIELD: D113.1 (A), J13.1; also elsewhere on the board
IN3_N: R1079.2, R1080.2, U10.13; also elsewhere on the board
IN3_SENSE: C103.1, R1076.2, R1077.1, R1078.1, U10.11 (+)
IN3_UV_EMITTER: R1069.1; also elsewhere on the board
IN4_FAULT: R1103.2, U13.14; also elsewhere on the board
IN4_FIELD: D114.1 (A), J14.1; also elsewhere on the board
IN4_N: R1109.2, R1110.2, U10.14; also elsewhere on the board
IN4_SENSE: C104.1, R1106.2, R1107.1, R1108.1, U10.9 (+)
IN4_UV_EMITTER: R1099.1; also elsewhere on the board
unnamed: D113.3 (K), R1074.1
unnamed: D114.3 (K), R1104.1
unnamed: R1074.2, R1075.1
unnamed: R1075.2, R1076.1
unnamed: R1104.2, R1105.1
unnamed: R1105.2, R1106.1
UV_REF: U13.9 (+), U13.11 (+); also elsewhere on the board

Notes on the sheet:
UNIVERSAL POOFER CONTROL | 08 | Contact receivers 3-4
REV A.3 | Dry contacts | Latched hardware stop | Buffered expansion
INPUT 3 | ACTIVE-LOW RECEIVER
LOW = closed; FAULT high masks invalid closure
PROTECTED FAULT FLAG
Four 100k conductances bias and attenuate emitter
INPUT 4 | ACTIVE-LOW RECEIVER

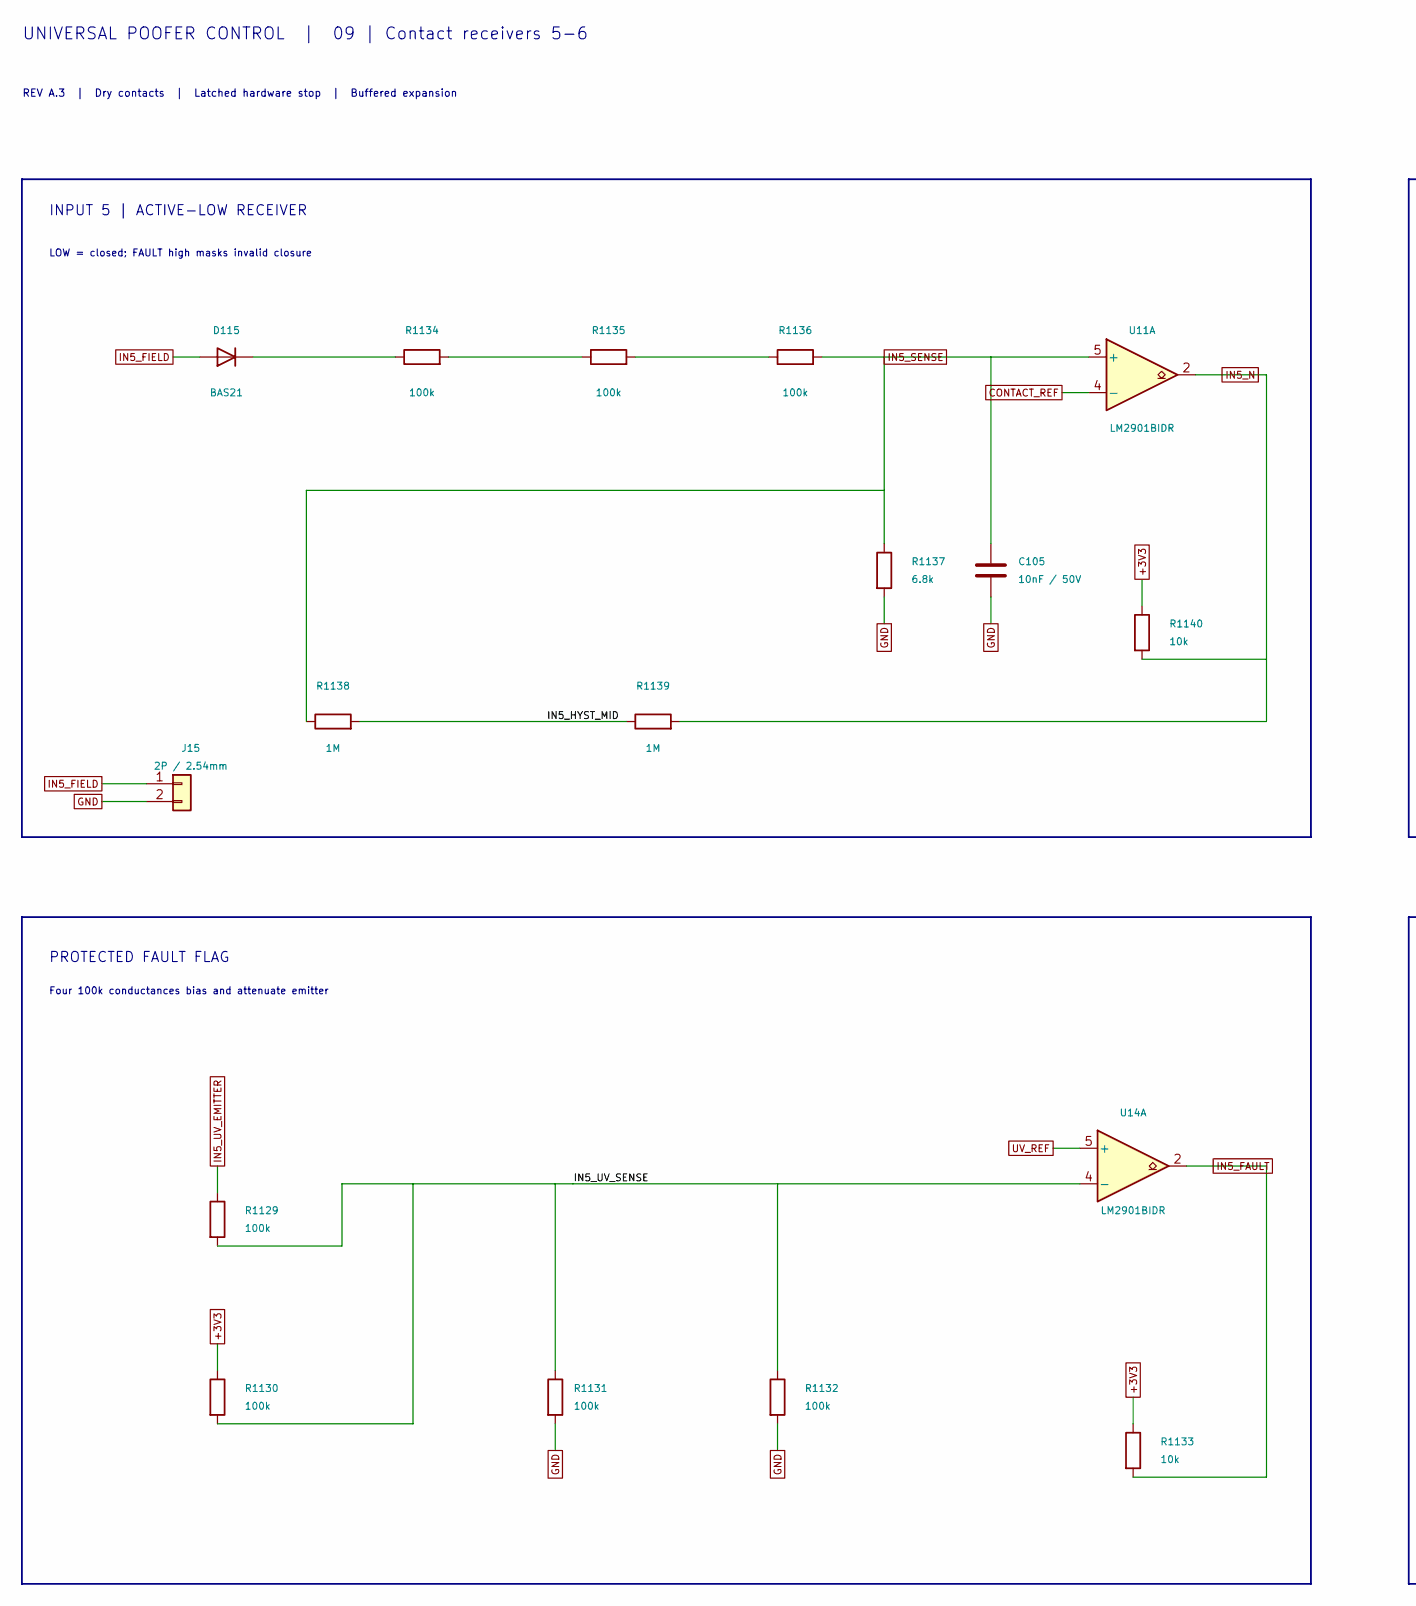
[picture p45: schematic Input_Receivers_3.kicad_sch, 09 | Contact receivers 5-6, part in row 1, column 1]

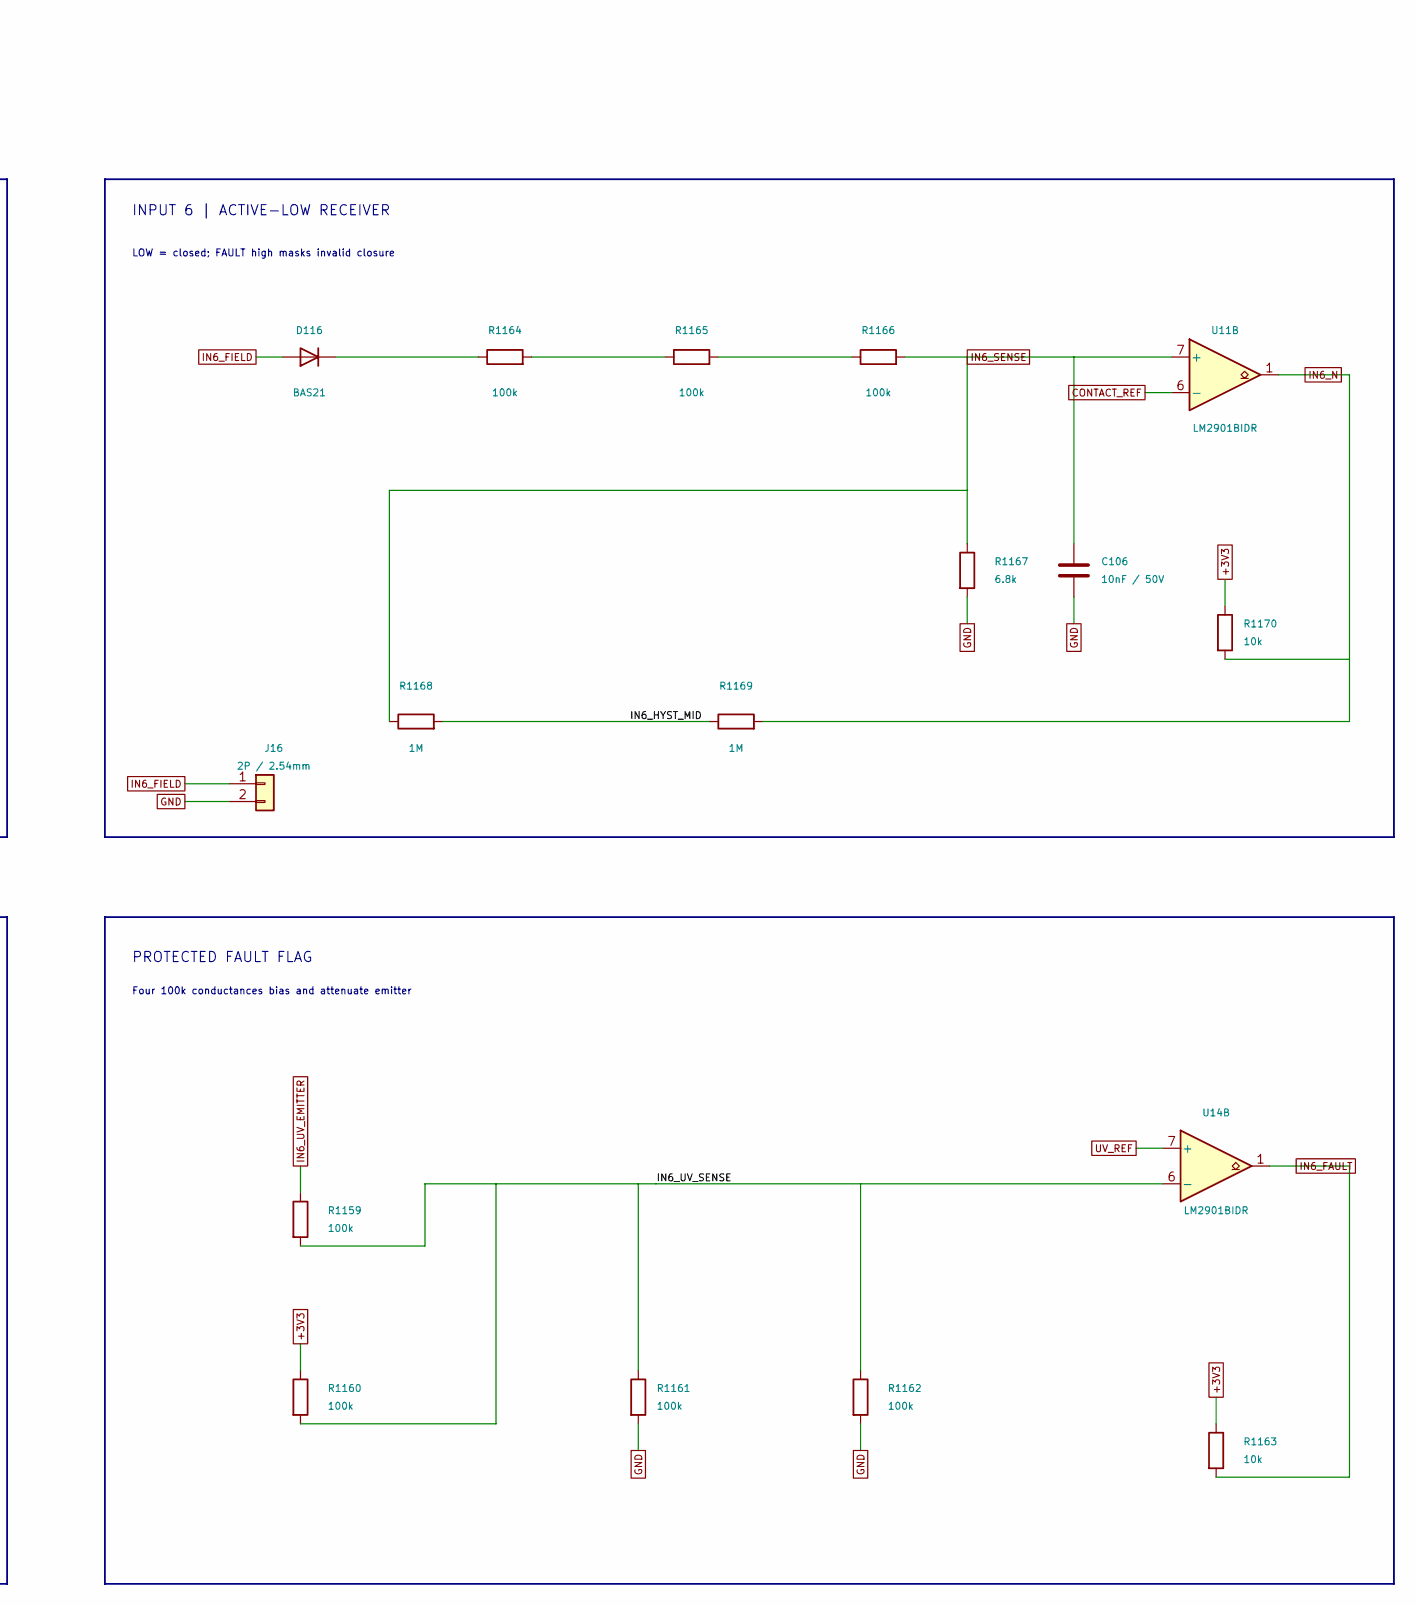
[picture p46: schematic Input_Receivers_3.kicad_sch, 09 | Contact receivers 5-6, part in row 1, column 2]

Parts:
C105, C106: 10nF / 50V; C_0805_2012Metric; MPN CL21B103KBANNNC; LCSC C1710
D115, D116: BAS21; SOT-23; MPN BAS21,215; LCSC C8661
J15, J16: 2P / 2.54mm; PinHeader_1x02_P2.54mm_Vertical; MPN B-2100S02P-A110; LCSC C124375
R1129, R1130, R1131, R1132, R1134, R1135, R1136, R1159, R1160, R1161, R1162, R1164, R1165, R1166: 100k; R_0805_2012Metric; MPN 0805W8F1003T5E; LCSC C149504
R1133, R1140, R1163, R1170: 10k; R_0805_2012Metric; MPN 0805W8F1002T5E; LCSC C17414
R1137, R1167: 6.8k; R_0805_2012Metric; MPN 0805W8F6801T5E; LCSC C17772
R1138, R1139, R1168, R1169: 1M; R_0805_2012Metric; MPN 0805W8F1004T5E; LCSC C17514
U11, U14: LM2901BIDR; SOIC-14_3.9x8.7mm_P1.27mm; MPN LM2901BIDR; LCSC C22427890

Connections:
+3V3: R1130.1, R1133.1, R1140.1, R1160.1, R1163.1, R1170.1; also elsewhere on the board
/09 | Contact receivers 5-6/IN5_HYST_MID: R1138.2, R1139.1
/09 | Contact receivers 5-6/IN5_UV_SENSE: R1129.2, R1130.2, R1131.1, R1132.1, U14.4 (-)
/09 | Contact receivers 5-6/IN6_HYST_MID: R1168.2, R1169.1
/09 | Contact receivers 5-6/IN6_UV_SENSE: R1159.2, R1160.2, R1161.1, R1162.1, U14.6 (-)
CONTACT_REF: U11.4 (-), U11.6 (-); also elsewhere on the board
GND: C105.2, C106.2, J15.2, J16.2, R1131.2, R1132.2, R1137.2, R1161.2, R1162.2, R1167.2; also elsewhere on the board
IN5_FAULT: R1133.2, U14.2; also elsewhere on the board
IN5_FIELD: D115.1 (A), J15.1; also elsewhere on the board
IN5_N: R1139.2, R1140.2, U11.2; also elsewhere on the board
IN5_SENSE: C105.1, R1136.2, R1137.1, R1138.1, U11.5 (+)
IN5_UV_EMITTER: R1129.1; also elsewhere on the board
IN6_FAULT: R1163.2, U14.1; also elsewhere on the board
IN6_FIELD: D116.1 (A), J16.1; also elsewhere on the board
IN6_N: R1169.2, R1170.2, U11.1; also elsewhere on the board
IN6_SENSE: C106.1, R1166.2, R1167.1, R1168.1, U11.7 (+)
IN6_UV_EMITTER: R1159.1; also elsewhere on the board
unnamed: D115.3 (K), R1134.1
unnamed: D116.3 (K), R1164.1
unnamed: R1134.2, R1135.1
unnamed: R1135.2, R1136.1
unnamed: R1164.2, R1165.1
unnamed: R1165.2, R1166.1
UV_REF: U14.5 (+), U14.7 (+); also elsewhere on the board

Notes on the sheet:
UNIVERSAL POOFER CONTROL | 09 | Contact receivers 5-6
REV A.3 | Dry contacts | Latched hardware stop | Buffered expansion
INPUT 5 | ACTIVE-LOW RECEIVER
LOW = closed; FAULT high masks invalid closure
PROTECTED FAULT FLAG
Four 100k conductances bias and attenuate emitter
INPUT 6 | ACTIVE-LOW RECEIVER

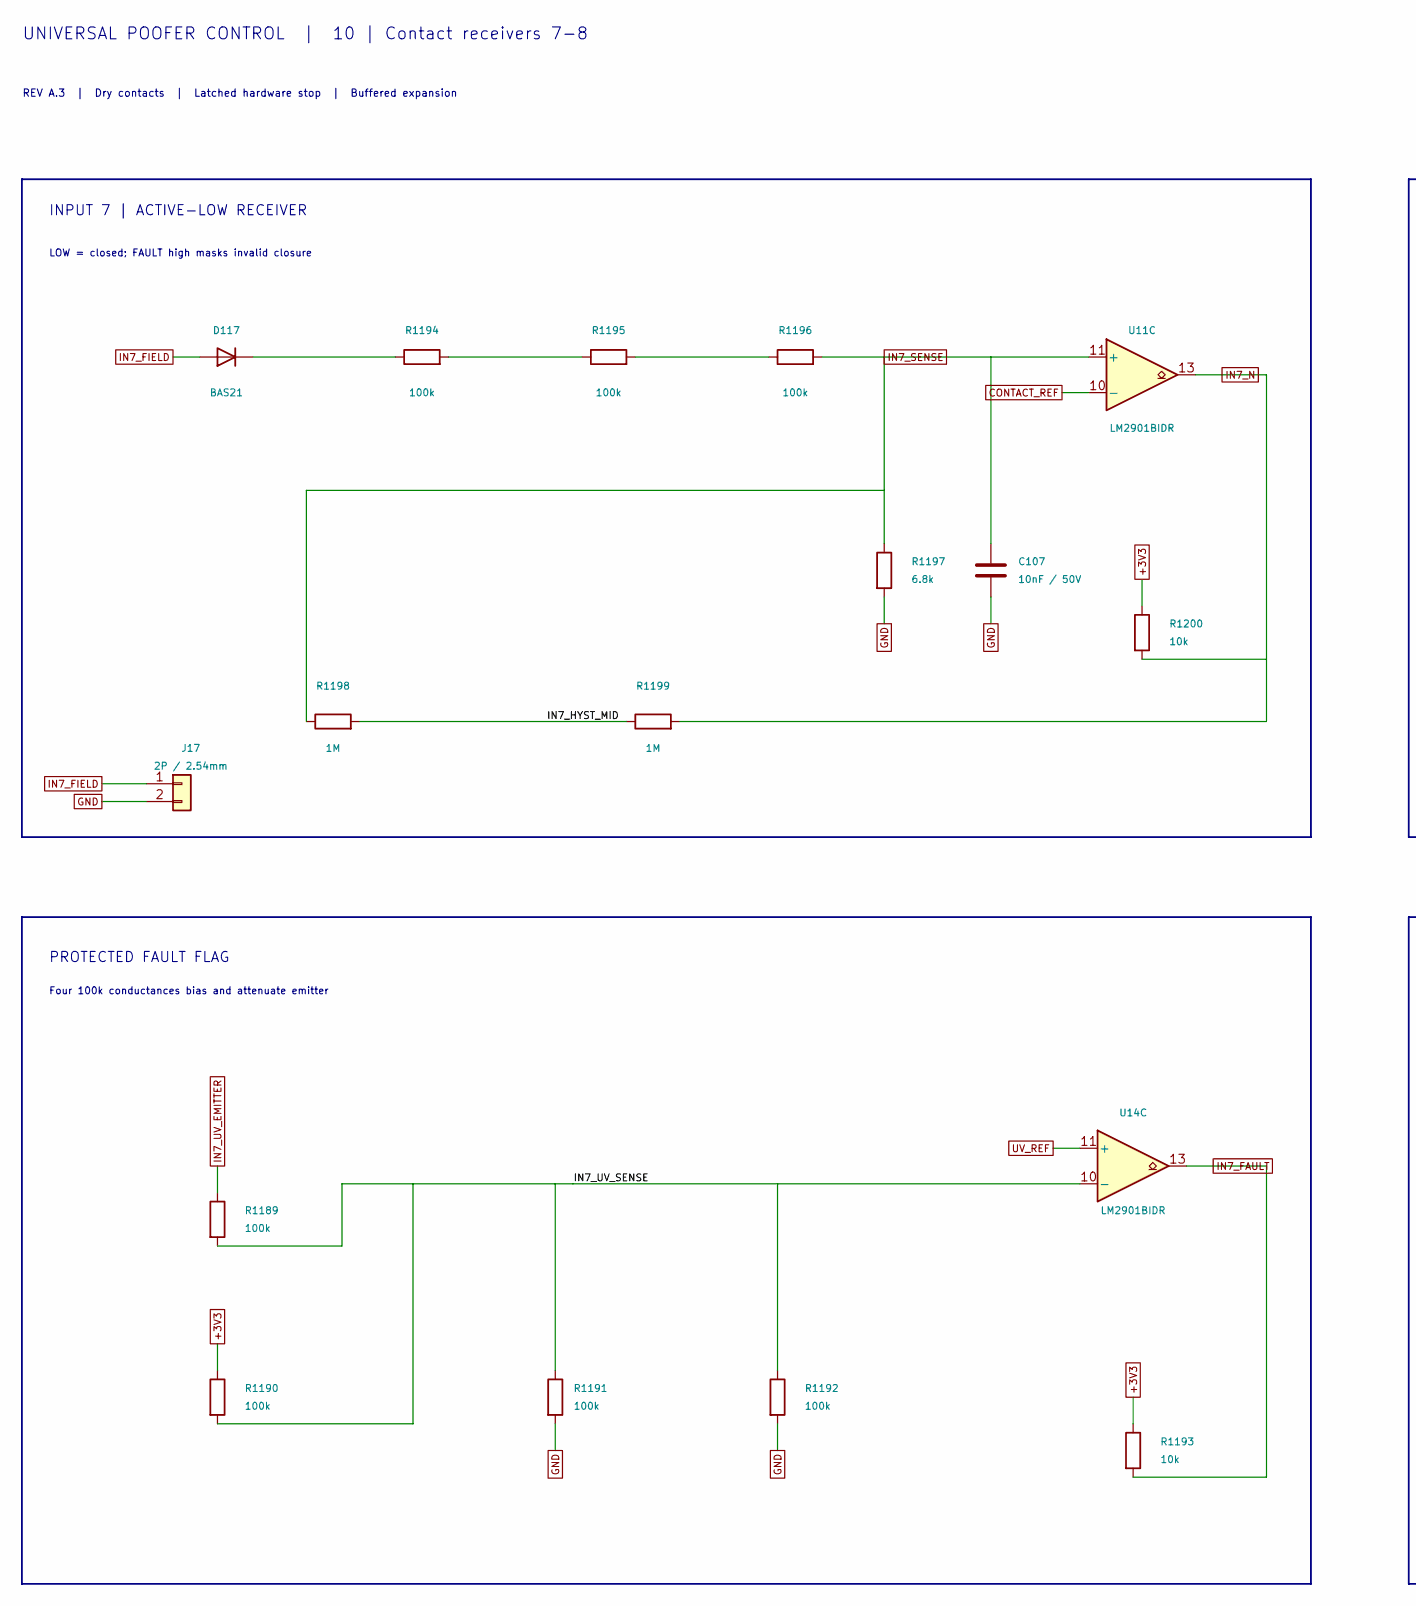
[picture p47: schematic Input_Receivers_4.kicad_sch, 10 | Contact receivers 7-8, part in row 1, column 1]

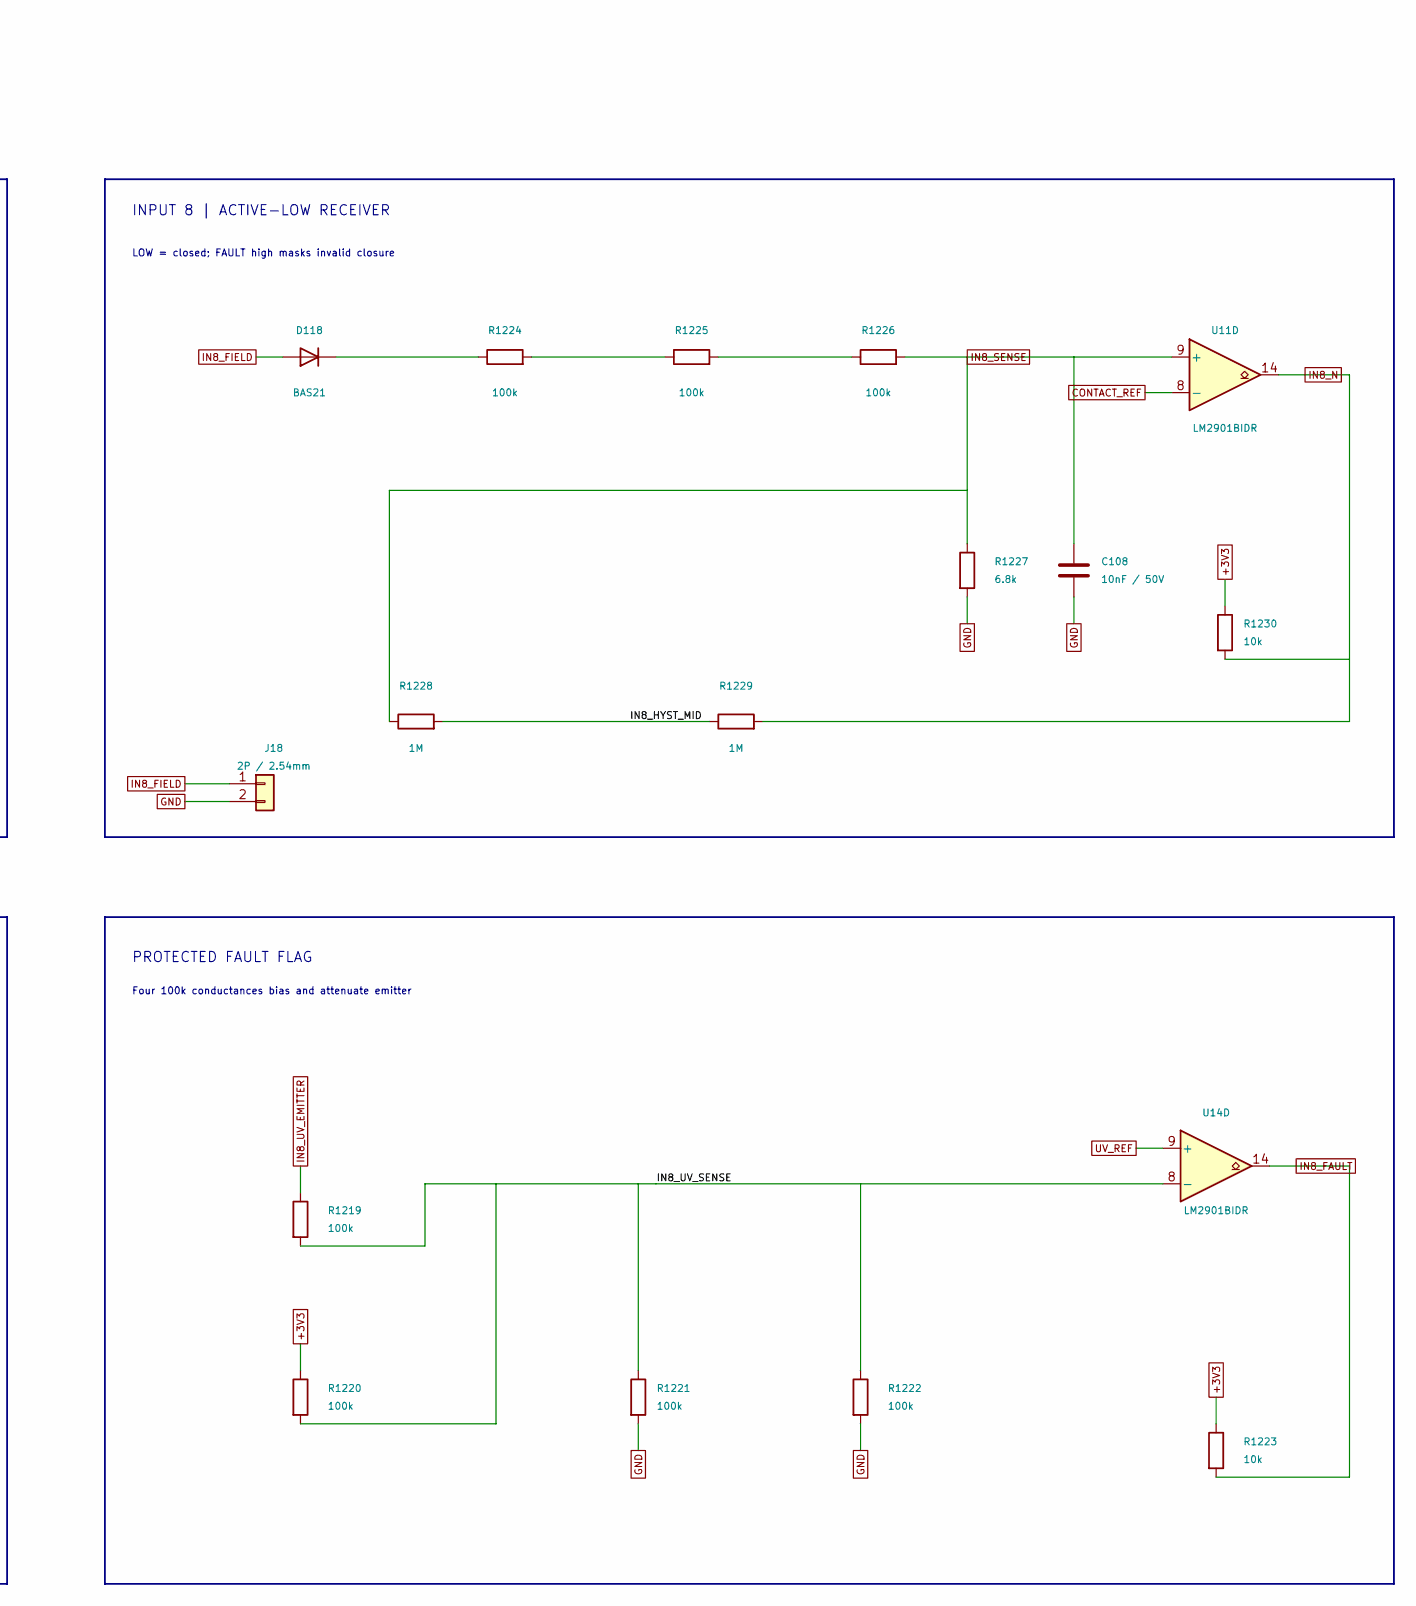
[picture p48: schematic Input_Receivers_4.kicad_sch, 10 | Contact receivers 7-8, part in row 1, column 2]

Parts:
C107, C108: 10nF / 50V; C_0805_2012Metric; MPN CL21B103KBANNNC; LCSC C1710
D117, D118: BAS21; SOT-23; MPN BAS21,215; LCSC C8661
J17, J18: 2P / 2.54mm; PinHeader_1x02_P2.54mm_Vertical; MPN B-2100S02P-A110; LCSC C124375
R1189, R1190, R1191, R1192, R1194, R1195, R1196, R1219, R1220, R1221, R1222, R1224, R1225, R1226: 100k; R_0805_2012Metric; MPN 0805W8F1003T5E; LCSC C149504
R1193, R1200, R1223, R1230: 10k; R_0805_2012Metric; MPN 0805W8F1002T5E; LCSC C17414
R1197, R1227: 6.8k; R_0805_2012Metric; MPN 0805W8F6801T5E; LCSC C17772
R1198, R1199, R1228, R1229: 1M; R_0805_2012Metric; MPN 0805W8F1004T5E; LCSC C17514
U11, U14: LM2901BIDR; SOIC-14_3.9x8.7mm_P1.27mm; MPN LM2901BIDR; LCSC C22427890

Connections:
+3V3: R1190.1, R1193.1, R1200.1, R1220.1, R1223.1, R1230.1; also elsewhere on the board
/10 | Contact receivers 7-8/IN7_HYST_MID: R1198.2, R1199.1
/10 | Contact receivers 7-8/IN7_UV_SENSE: R1189.2, R1190.2, R1191.1, R1192.1, U14.10 (-)
/10 | Contact receivers 7-8/IN8_HYST_MID: R1228.2, R1229.1
/10 | Contact receivers 7-8/IN8_UV_SENSE: R1219.2, R1220.2, R1221.1, R1222.1, U14.8 (-)
CONTACT_REF: U11.8 (-), U11.10 (-); also elsewhere on the board
GND: C107.2, C108.2, J17.2, J18.2, R1191.2, R1192.2, R1197.2, R1221.2, R1222.2, R1227.2; also elsewhere on the board
IN7_FAULT: R1193.2, U14.13; also elsewhere on the board
IN7_FIELD: D117.1 (A), J17.1; also elsewhere on the board
IN7_N: R1199.2, R1200.2, U11.13; also elsewhere on the board
IN7_SENSE: C107.1, R1196.2, R1197.1, R1198.1, U11.11 (+)
IN7_UV_EMITTER: R1189.1; also elsewhere on the board
IN8_FAULT: R1223.2, U14.14; also elsewhere on the board
IN8_FIELD: D118.1 (A), J18.1; also elsewhere on the board
IN8_N: R1229.2, R1230.2, U11.14; also elsewhere on the board
IN8_SENSE: C108.1, R1226.2, R1227.1, R1228.1, U11.9 (+)
IN8_UV_EMITTER: R1219.1; also elsewhere on the board
unnamed: D117.3 (K), R1194.1
unnamed: D118.3 (K), R1224.1
unnamed: R1194.2, R1195.1
unnamed: R1195.2, R1196.1
unnamed: R1224.2, R1225.1
unnamed: R1225.2, R1226.1
UV_REF: U14.9 (+), U14.11 (+); also elsewhere on the board

Notes on the sheet:
UNIVERSAL POOFER CONTROL | 10 | Contact receivers 7-8
REV A.3 | Dry contacts | Latched hardware stop | Buffered expansion
INPUT 7 | ACTIVE-LOW RECEIVER
LOW = closed; FAULT high masks invalid closure
PROTECTED FAULT FLAG
Four 100k conductances bias and attenuate emitter
INPUT 8 | ACTIVE-LOW RECEIVER
