NOVA-Cluster/Universal-Poofer-Control/Universal_Poofer_Control.kicad_pcb

## KiCad design Universal_Poofer_Control.kicad_pcb (continued)

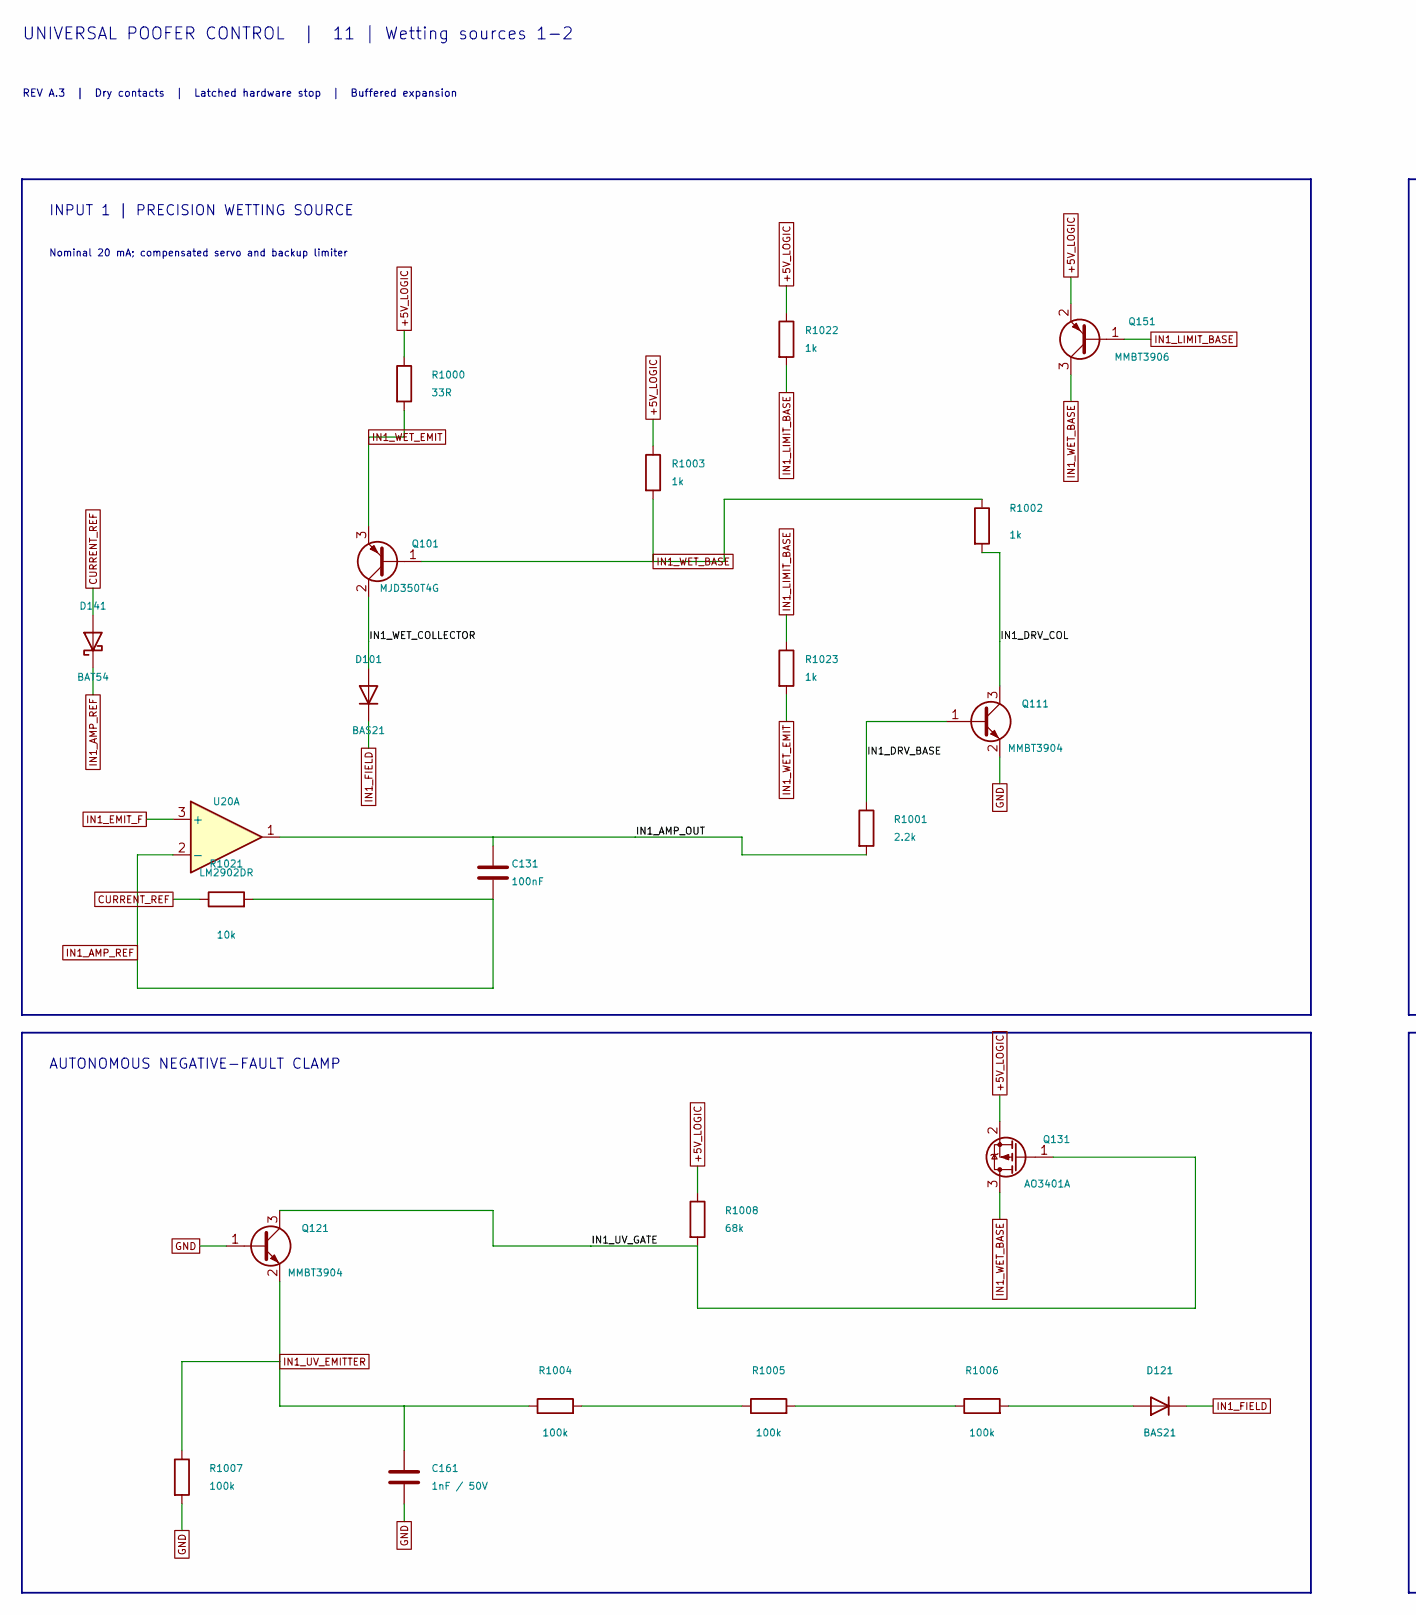
[picture p49: schematic Contact_Sources_1.kicad_sch, 11 | Wetting sources 1-2, part in row 1, column 1]

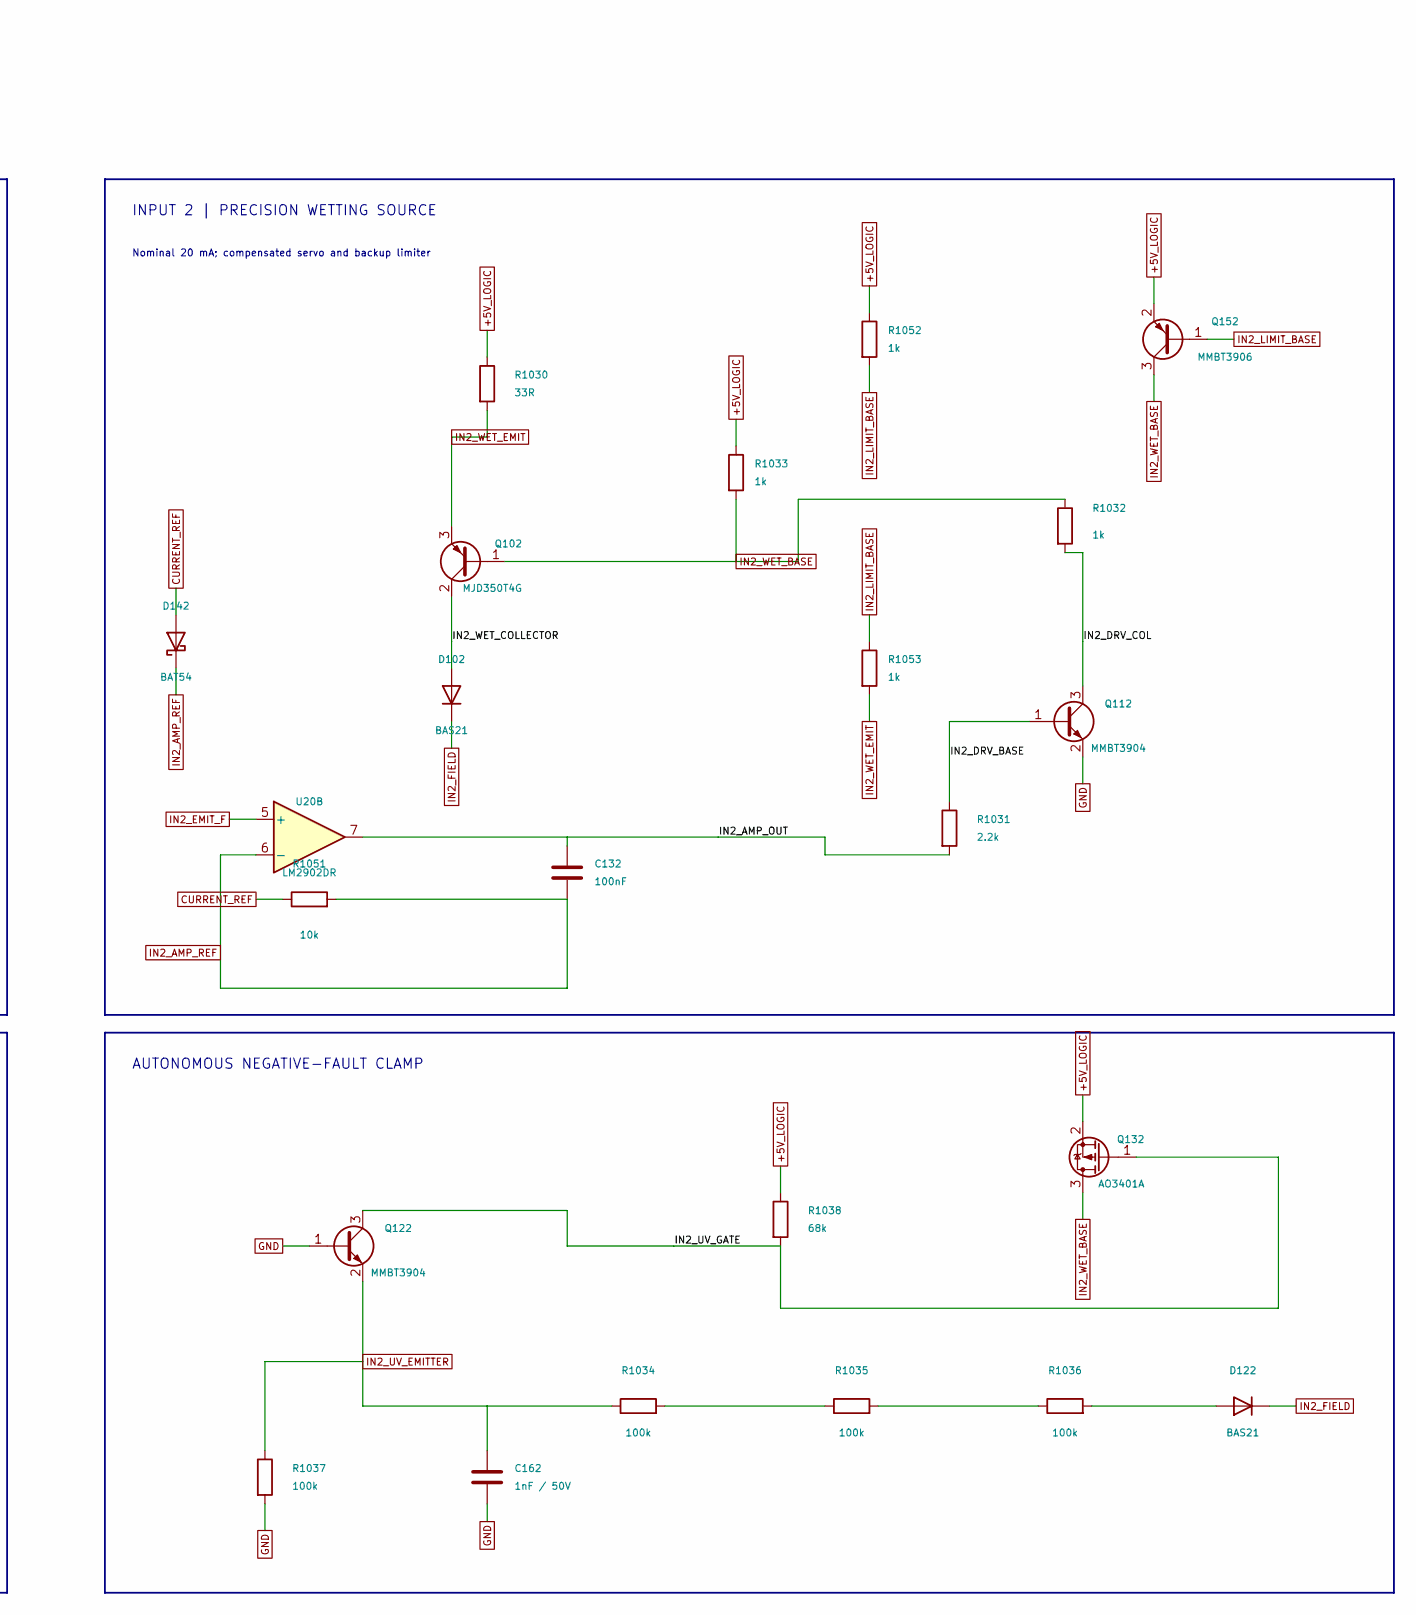
[picture p50: schematic Contact_Sources_1.kicad_sch, 11 | Wetting sources 1-2, part in row 1, column 2]

Parts:
C131, C132: 100nF; C_0805_2012Metric; MPN CC0805KRX7R9BB104; LCSC C49678
C161, C162: 1nF / 50V; C_0805_2012Metric; MPN CL21B102KBANNNC; LCSC C51210
D101, D102, D121, D122: BAS21; SOT-23; MPN BAS21,215; LCSC C8661
D141, D142: BAT54; SOT-23; MPN BAT54,215; LCSC C85084
Q101, Q102: MJD350T4G; TO-252-3_TabPin2; MPN MJD350T4G; LCSC C145514
Q111, Q112, Q121, Q122: MMBT3904; SOT-23; MPN MMBT3904(RANGE:100-300); LCSC C20526
Q131, Q132: AO3401A; SOT-23; MPN AO3401A; LCSC C15127
Q151, Q152: MMBT3906; SOT-23; MPN MMBT3906 2A(RANGE:100-300); LCSC C2143
R1000, R1030: 33R; R_0805_2012Metric; MPN 0805W8F330JT5E; LCSC C17634
R1001, R1031: 2.2k; R_0805_2012Metric; MPN 0805W8F2201T5E; LCSC C17520
R1002, R1003, R1022, R1023, R1032, R1033, R1052, R1053: 1k; R_0805_2012Metric; MPN 0805W8F1001T5E; LCSC C17513
R1004, R1005, R1006, R1007, R1034, R1035, R1036, R1037: 100k; R_0805_2012Metric; MPN 0805W8F1003T5E; LCSC C149504
R1008, R1038: 68k; R_0805_2012Metric; MPN 0805W8F6802T5E; LCSC C17801
R1021, R1051: 10k; R_0805_2012Metric; MPN 0805W8F1002T5E; LCSC C17414
U20: LM2902DR; SOIC-14_3.9x8.7mm_P1.27mm; MPN LM2902DR; LCSC C350545

Connections:
+5V_LOGIC: Q131.2 (S), Q132.2 (S), Q151.2 (E), Q152.2 (E), R1000.1, R1003.1, R1008.1, R1022.1, R1030.1, R1033.1, R1038.1, R1052.1; also elsewhere on the board
/11 | Wetting sources 1-2/IN1_AMP_OUT: C131.1, R1001.2, U20.1
/11 | Wetting sources 1-2/IN1_DRV_BASE: Q111.1 (B), R1001.1
/11 | Wetting sources 1-2/IN1_DRV_COL: Q111.3 (C), R1002.2
/11 | Wetting sources 1-2/IN1_UV_GATE: Q121.3 (C), Q131.1 (G), R1008.2
/11 | Wetting sources 1-2/IN1_WET_COLLECTOR: D101.1 (A), Q101.2 (C)
/11 | Wetting sources 1-2/IN2_AMP_OUT: C132.1, R1031.2, U20.7
/11 | Wetting sources 1-2/IN2_DRV_BASE: Q112.1 (B), R1031.1
/11 | Wetting sources 1-2/IN2_DRV_COL: Q112.3 (C), R1032.2
/11 | Wetting sources 1-2/IN2_UV_GATE: Q122.3 (C), Q132.1 (G), R1038.2
/11 | Wetting sources 1-2/IN2_WET_COLLECTOR: D102.1 (A), Q102.2 (C)
CURRENT_REF: D141.1 (A), D142.1 (A), R1021.1, R1051.1; also elsewhere on the board
GND: C161.2, C162.2, Q111.2 (E), Q112.2 (E), Q121.1 (B), Q122.1 (B), R1007.2, R1037.2; also elsewhere on the board
IN1_AMP_REF: C131.2, D141.3 (K), R1021.2, U20.2 (-)
IN1_EMIT_F: U20.3 (+); also elsewhere on the board
IN1_FIELD: D101.3 (K), D121.3 (K); also elsewhere on the board
IN1_LIMIT_BASE: Q151.1 (B), R1022.2, R1023.1
IN1_UV_EMITTER: C161.1, Q121.2 (E), R1004.1, R1007.1; also elsewhere on the board
IN1_WET_BASE: Q101.1 (B), Q131.3 (D), Q151.3 (C), R1002.1, R1003.2
IN1_WET_EMIT: Q101.3 (E), R1000.2, R1023.2; also elsewhere on the board
IN2_AMP_REF: C132.2, D142.3 (K), R1051.2, U20.6 (-)
IN2_EMIT_F: U20.5 (+); also elsewhere on the board
IN2_FIELD: D102.3 (K), D122.3 (K); also elsewhere on the board
IN2_LIMIT_BASE: Q152.1 (B), R1052.2, R1053.1
IN2_UV_EMITTER: C162.1, Q122.2 (E), R1034.1, R1037.1; also elsewhere on the board
IN2_WET_BASE: Q102.1 (B), Q132.3 (D), Q152.3 (C), R1032.1, R1033.2
IN2_WET_EMIT: Q102.3 (E), R1030.2, R1053.2; also elsewhere on the board
unnamed: D121.1 (A), R1006.2
unnamed: D122.1 (A), R1036.2
unnamed: R1004.2, R1005.1
unnamed: R1005.2, R1006.1
unnamed: R1034.2, R1035.1
unnamed: R1035.2, R1036.1

Notes on the sheet:
UNIVERSAL POOFER CONTROL | 11 | Wetting sources 1-2
REV A.3 | Dry contacts | Latched hardware stop | Buffered expansion
INPUT 1 | PRECISION WETTING SOURCE
Nominal 20 mA; compensated servo and backup limiter
AUTONOMOUS NEGATIVE-FAULT CLAMP
INPUT 2 | PRECISION WETTING SOURCE

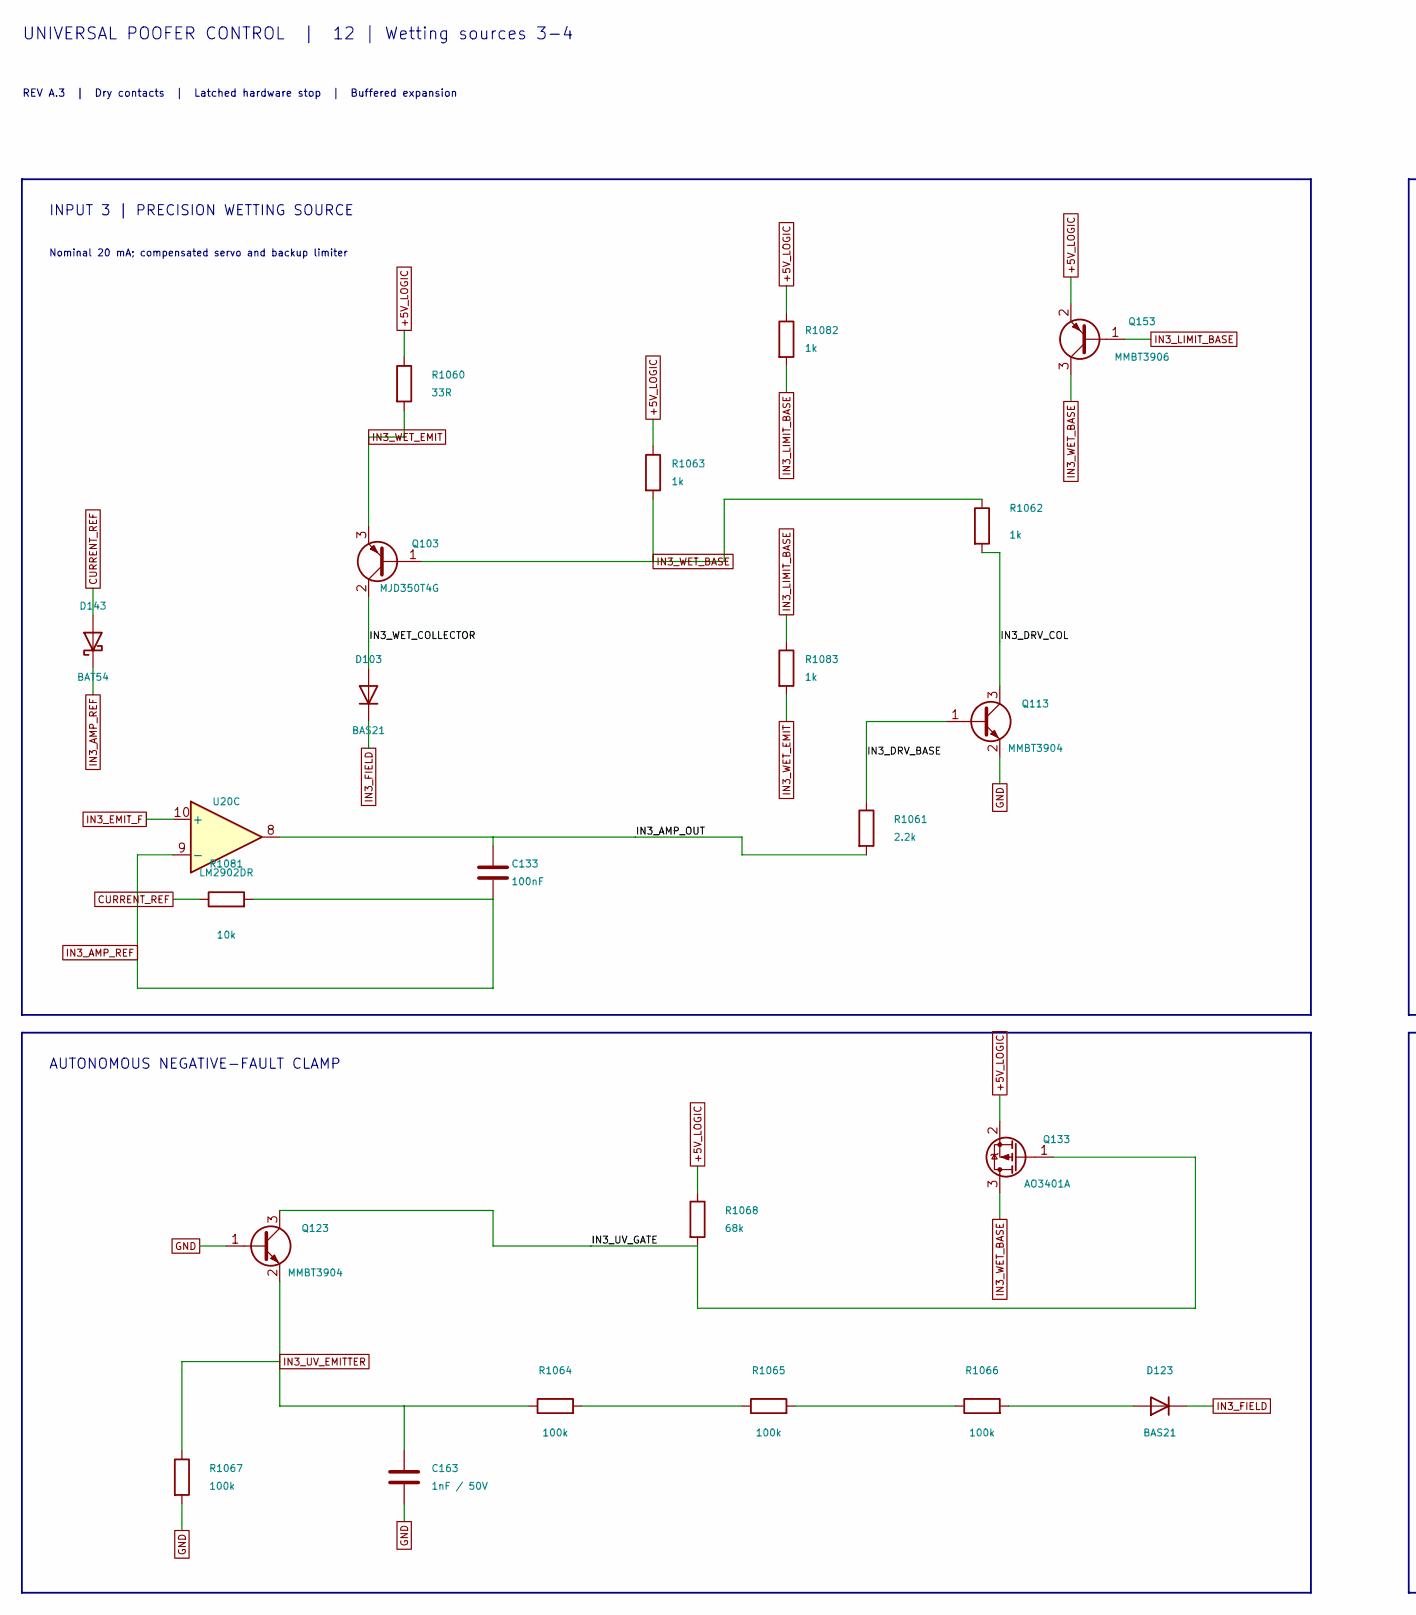
[picture p51: schematic Contact_Sources_2.kicad_sch, 12 | Wetting sources 3-4, part in row 1, column 1]

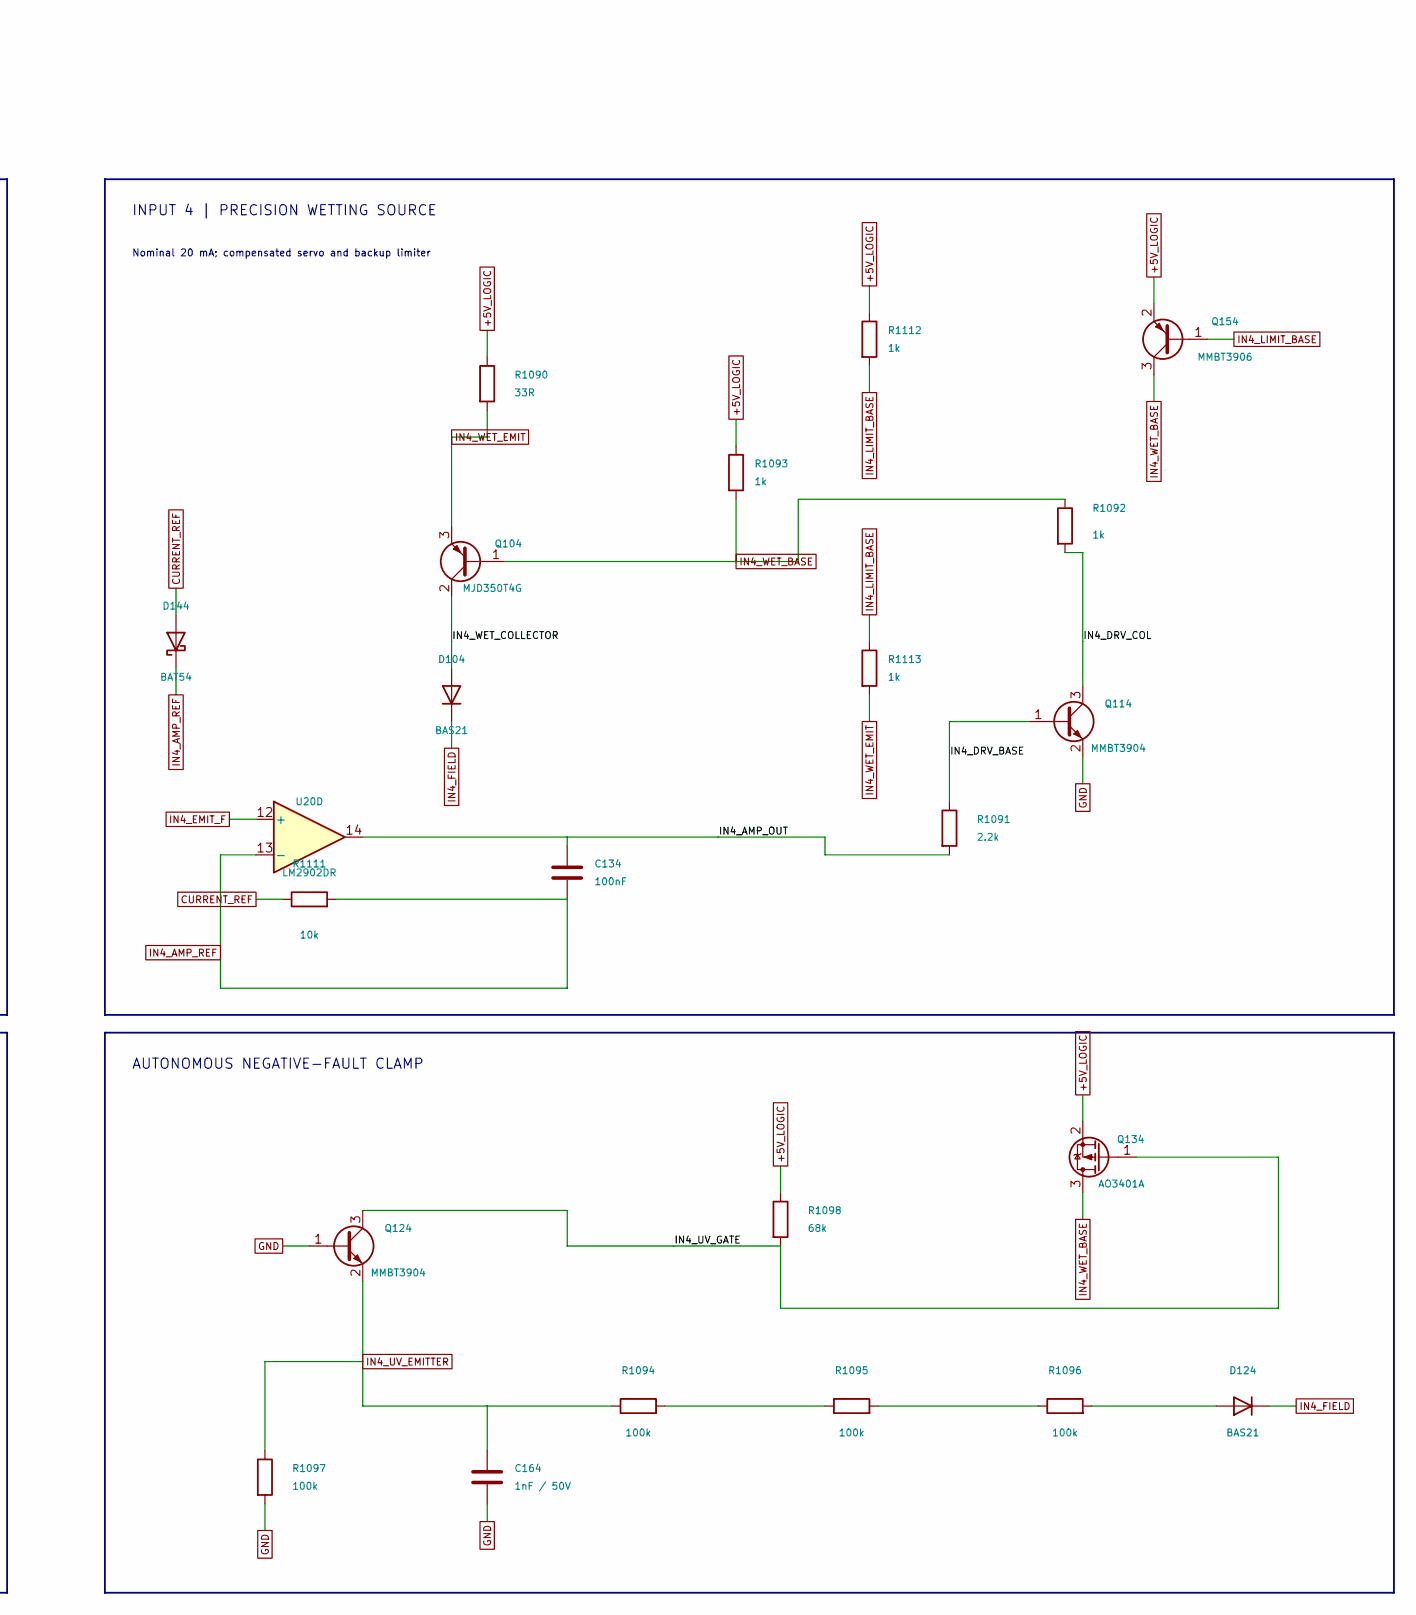
[picture p52: schematic Contact_Sources_2.kicad_sch, 12 | Wetting sources 3-4, part in row 1, column 2]

Parts:
C133, C134: 100nF; C_0805_2012Metric; MPN CC0805KRX7R9BB104; LCSC C49678
C163, C164: 1nF / 50V; C_0805_2012Metric; MPN CL21B102KBANNNC; LCSC C51210
D103, D104, D123, D124: BAS21; SOT-23; MPN BAS21,215; LCSC C8661
D143, D144: BAT54; SOT-23; MPN BAT54,215; LCSC C85084
Q103, Q104: MJD350T4G; TO-252-3_TabPin2; MPN MJD350T4G; LCSC C145514
Q113, Q114, Q123, Q124: MMBT3904; SOT-23; MPN MMBT3904(RANGE:100-300); LCSC C20526
Q133, Q134: AO3401A; SOT-23; MPN AO3401A; LCSC C15127
Q153, Q154: MMBT3906; SOT-23; MPN MMBT3906 2A(RANGE:100-300); LCSC C2143
R1060, R1090: 33R; R_0805_2012Metric; MPN 0805W8F330JT5E; LCSC C17634
R1061, R1091: 2.2k; R_0805_2012Metric; MPN 0805W8F2201T5E; LCSC C17520
R1062, R1063, R1082, R1083, R1092, R1093, R1112, R1113: 1k; R_0805_2012Metric; MPN 0805W8F1001T5E; LCSC C17513
R1064, R1065, R1066, R1067, R1094, R1095, R1096, R1097: 100k; R_0805_2012Metric; MPN 0805W8F1003T5E; LCSC C149504
R1068, R1098: 68k; R_0805_2012Metric; MPN 0805W8F6802T5E; LCSC C17801
R1081, R1111: 10k; R_0805_2012Metric; MPN 0805W8F1002T5E; LCSC C17414
U20: LM2902DR; SOIC-14_3.9x8.7mm_P1.27mm; MPN LM2902DR; LCSC C350545

Connections:
+5V_LOGIC: Q133.2 (S), Q134.2 (S), Q153.2 (E), Q154.2 (E), R1060.1, R1063.1, R1068.1, R1082.1, R1090.1, R1093.1, R1098.1, R1112.1; also elsewhere on the board
/12 | Wetting sources 3-4/IN3_AMP_OUT: C133.1, R1061.2, U20.8
/12 | Wetting sources 3-4/IN3_DRV_BASE: Q113.1 (B), R1061.1
/12 | Wetting sources 3-4/IN3_DRV_COL: Q113.3 (C), R1062.2
/12 | Wetting sources 3-4/IN3_UV_GATE: Q123.3 (C), Q133.1 (G), R1068.2
/12 | Wetting sources 3-4/IN3_WET_COLLECTOR: D103.1 (A), Q103.2 (C)
/12 | Wetting sources 3-4/IN4_AMP_OUT: C134.1, R1091.2, U20.14
/12 | Wetting sources 3-4/IN4_DRV_BASE: Q114.1 (B), R1091.1
/12 | Wetting sources 3-4/IN4_DRV_COL: Q114.3 (C), R1092.2
/12 | Wetting sources 3-4/IN4_UV_GATE: Q124.3 (C), Q134.1 (G), R1098.2
/12 | Wetting sources 3-4/IN4_WET_COLLECTOR: D104.1 (A), Q104.2 (C)
CURRENT_REF: D143.1 (A), D144.1 (A), R1081.1, R1111.1; also elsewhere on the board
GND: C163.2, C164.2, Q113.2 (E), Q114.2 (E), Q123.1 (B), Q124.1 (B), R1067.2, R1097.2; also elsewhere on the board
IN3_AMP_REF: C133.2, D143.3 (K), R1081.2, U20.9 (-)
IN3_EMIT_F: U20.10 (+); also elsewhere on the board
IN3_FIELD: D103.3 (K), D123.3 (K); also elsewhere on the board
IN3_LIMIT_BASE: Q153.1 (B), R1082.2, R1083.1
IN3_UV_EMITTER: C163.1, Q123.2 (E), R1064.1, R1067.1; also elsewhere on the board
IN3_WET_BASE: Q103.1 (B), Q133.3 (D), Q153.3 (C), R1062.1, R1063.2
IN3_WET_EMIT: Q103.3 (E), R1060.2, R1083.2; also elsewhere on the board
IN4_AMP_REF: C134.2, D144.3 (K), R1111.2, U20.13 (-)
IN4_EMIT_F: U20.12 (+); also elsewhere on the board
IN4_FIELD: D104.3 (K), D124.3 (K); also elsewhere on the board
IN4_LIMIT_BASE: Q154.1 (B), R1112.2, R1113.1
IN4_UV_EMITTER: C164.1, Q124.2 (E), R1094.1, R1097.1; also elsewhere on the board
IN4_WET_BASE: Q104.1 (B), Q134.3 (D), Q154.3 (C), R1092.1, R1093.2
IN4_WET_EMIT: Q104.3 (E), R1090.2, R1113.2; also elsewhere on the board
unnamed: D123.1 (A), R1066.2
unnamed: D124.1 (A), R1096.2
unnamed: R1064.2, R1065.1
unnamed: R1065.2, R1066.1
unnamed: R1094.2, R1095.1
unnamed: R1095.2, R1096.1

Notes on the sheet:
UNIVERSAL POOFER CONTROL | 12 | Wetting sources 3-4
REV A.3 | Dry contacts | Latched hardware stop | Buffered expansion
INPUT 3 | PRECISION WETTING SOURCE
Nominal 20 mA; compensated servo and backup limiter
AUTONOMOUS NEGATIVE-FAULT CLAMP
INPUT 4 | PRECISION WETTING SOURCE

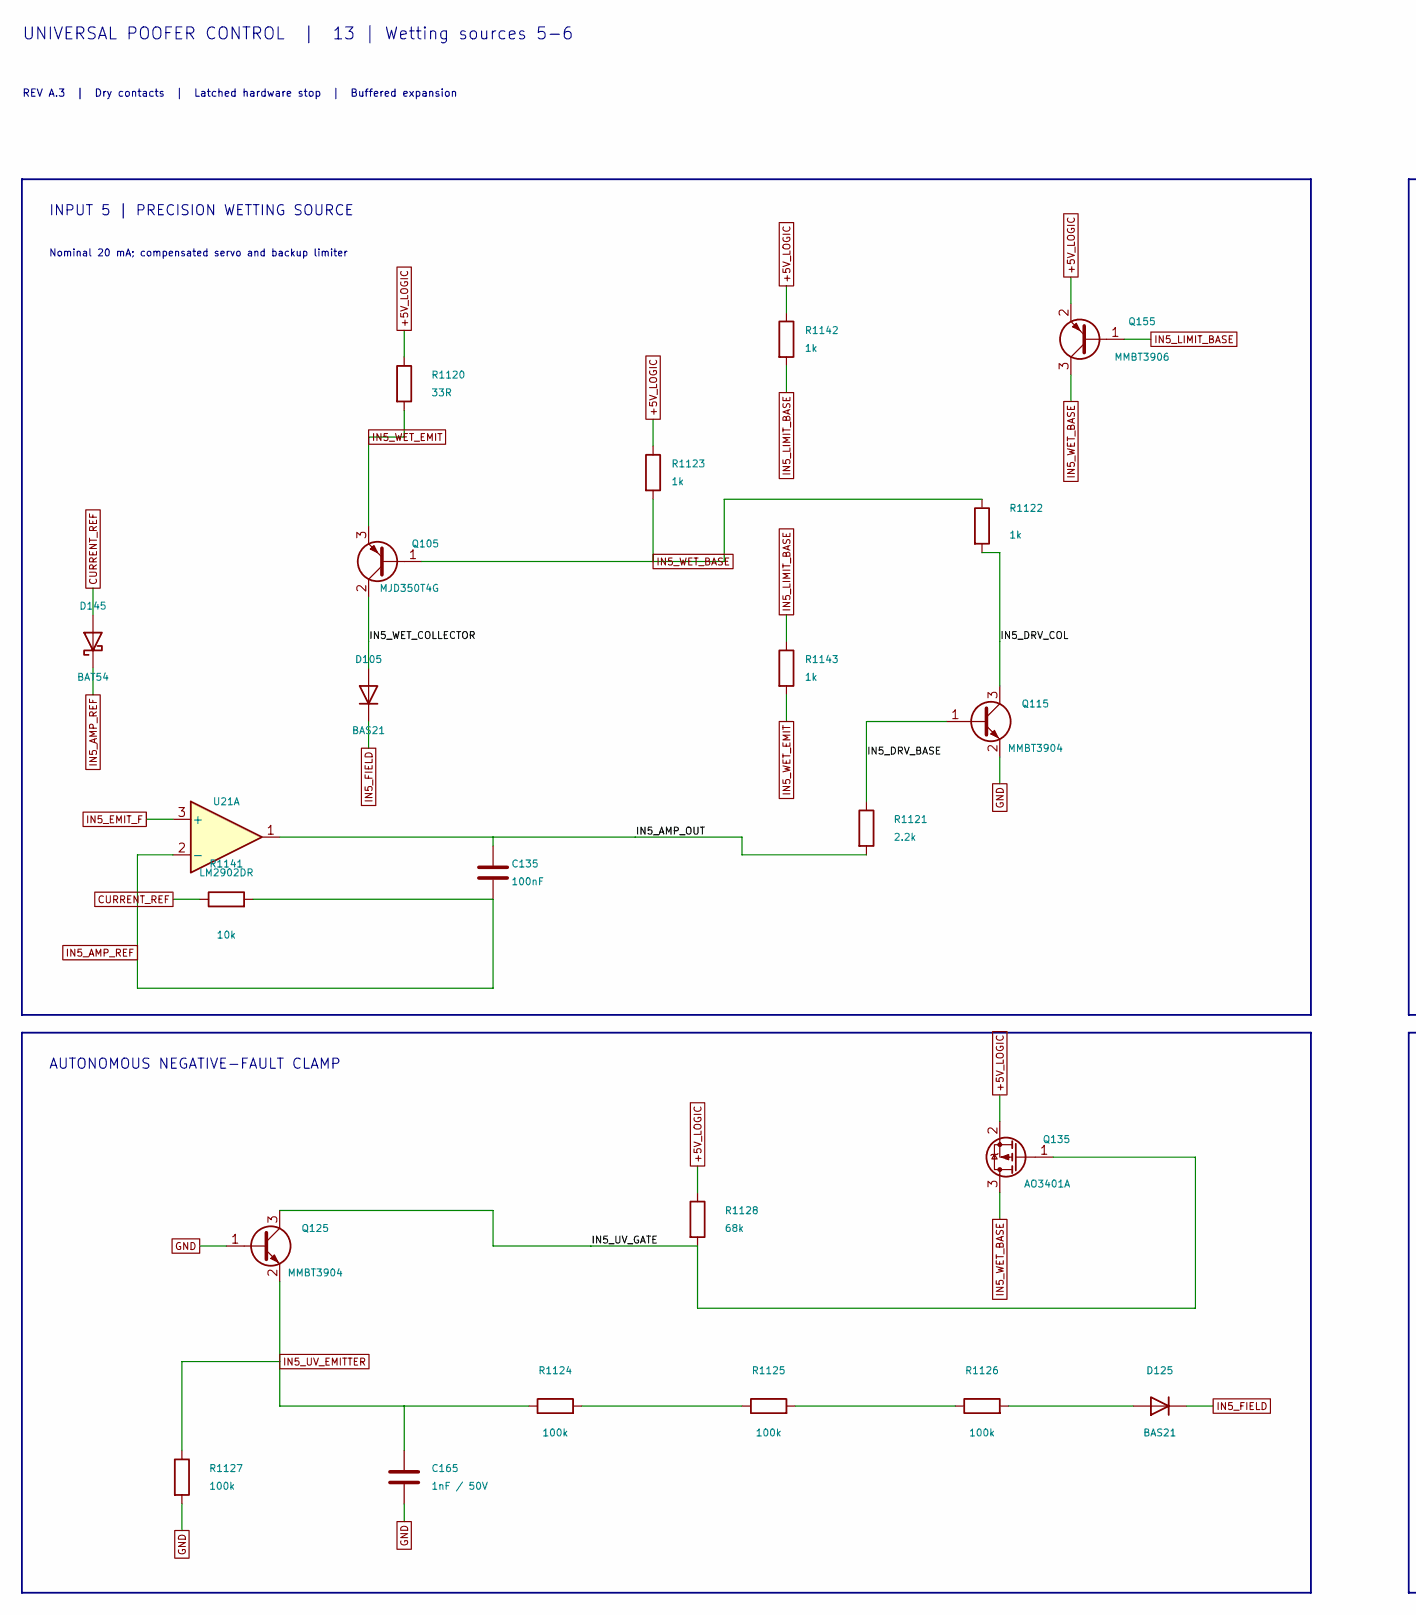
[picture p53: schematic Contact_Sources_3.kicad_sch, 13 | Wetting sources 5-6, part in row 1, column 1]

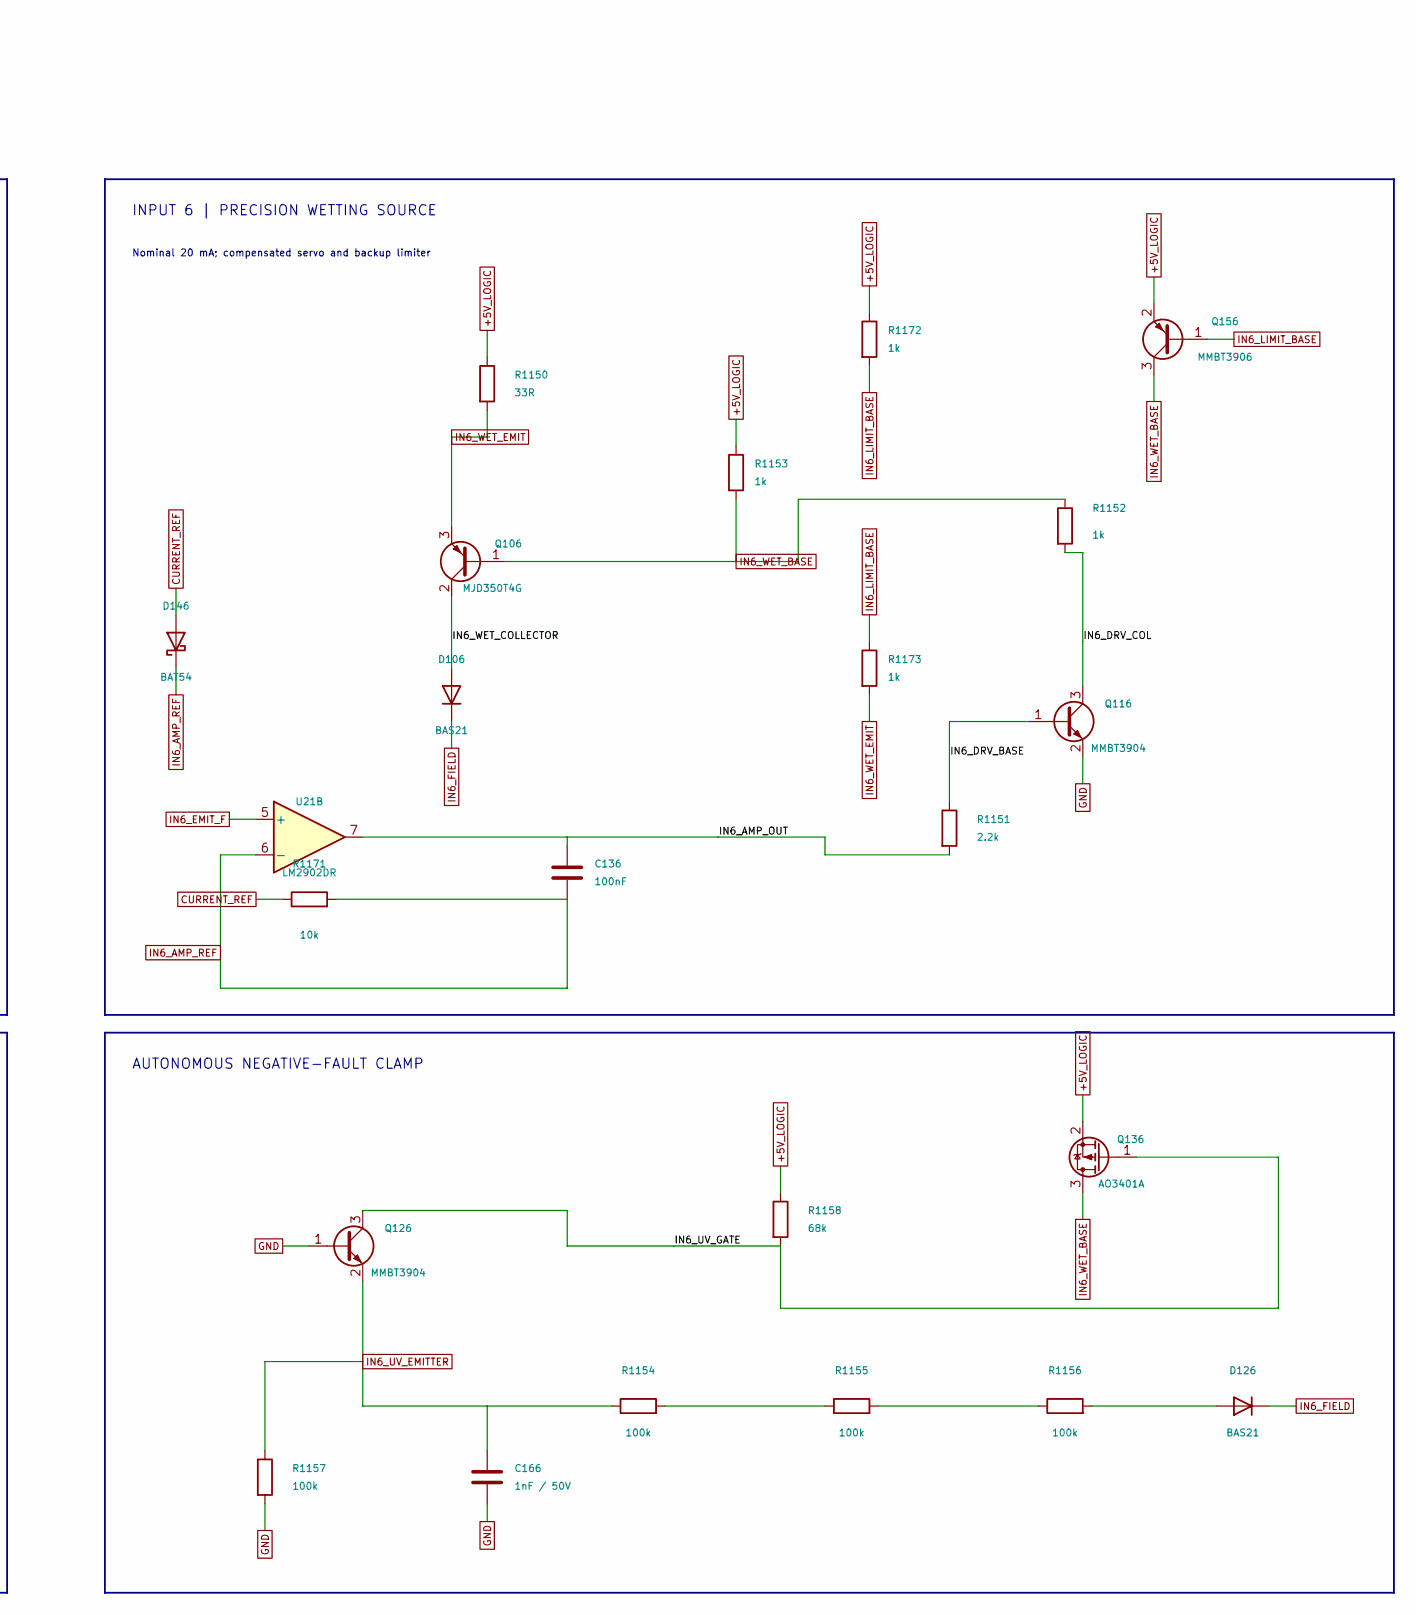
[picture p54: schematic Contact_Sources_3.kicad_sch, 13 | Wetting sources 5-6, part in row 1, column 2]

Parts:
C135, C136: 100nF; C_0805_2012Metric; MPN CC0805KRX7R9BB104; LCSC C49678
C165, C166: 1nF / 50V; C_0805_2012Metric; MPN CL21B102KBANNNC; LCSC C51210
D105, D106, D125, D126: BAS21; SOT-23; MPN BAS21,215; LCSC C8661
D145, D146: BAT54; SOT-23; MPN BAT54,215; LCSC C85084
Q105, Q106: MJD350T4G; TO-252-3_TabPin2; MPN MJD350T4G; LCSC C145514
Q115, Q116, Q125, Q126: MMBT3904; SOT-23; MPN MMBT3904(RANGE:100-300); LCSC C20526
Q135, Q136: AO3401A; SOT-23; MPN AO3401A; LCSC C15127
Q155, Q156: MMBT3906; SOT-23; MPN MMBT3906 2A(RANGE:100-300); LCSC C2143
R1120, R1150: 33R; R_0805_2012Metric; MPN 0805W8F330JT5E; LCSC C17634
R1121, R1151: 2.2k; R_0805_2012Metric; MPN 0805W8F2201T5E; LCSC C17520
R1122, R1123, R1142, R1143, R1152, R1153, R1172, R1173: 1k; R_0805_2012Metric; MPN 0805W8F1001T5E; LCSC C17513
R1124, R1125, R1126, R1127, R1154, R1155, R1156, R1157: 100k; R_0805_2012Metric; MPN 0805W8F1003T5E; LCSC C149504
R1128, R1158: 68k; R_0805_2012Metric; MPN 0805W8F6802T5E; LCSC C17801
R1141, R1171: 10k; R_0805_2012Metric; MPN 0805W8F1002T5E; LCSC C17414
U21: LM2902DR; SOIC-14_3.9x8.7mm_P1.27mm; MPN LM2902DR; LCSC C350545

Connections:
+5V_LOGIC: Q135.2 (S), Q136.2 (S), Q155.2 (E), Q156.2 (E), R1120.1, R1123.1, R1128.1, R1142.1, R1150.1, R1153.1, R1158.1, R1172.1; also elsewhere on the board
/13 | Wetting sources 5-6/IN5_AMP_OUT: C135.1, R1121.2, U21.1
/13 | Wetting sources 5-6/IN5_DRV_BASE: Q115.1 (B), R1121.1
/13 | Wetting sources 5-6/IN5_DRV_COL: Q115.3 (C), R1122.2
/13 | Wetting sources 5-6/IN5_UV_GATE: Q125.3 (C), Q135.1 (G), R1128.2
/13 | Wetting sources 5-6/IN5_WET_COLLECTOR: D105.1 (A), Q105.2 (C)
/13 | Wetting sources 5-6/IN6_AMP_OUT: C136.1, R1151.2, U21.7
/13 | Wetting sources 5-6/IN6_DRV_BASE: Q116.1 (B), R1151.1
/13 | Wetting sources 5-6/IN6_DRV_COL: Q116.3 (C), R1152.2
/13 | Wetting sources 5-6/IN6_UV_GATE: Q126.3 (C), Q136.1 (G), R1158.2
/13 | Wetting sources 5-6/IN6_WET_COLLECTOR: D106.1 (A), Q106.2 (C)
CURRENT_REF: D145.1 (A), D146.1 (A), R1141.1, R1171.1; also elsewhere on the board
GND: C165.2, C166.2, Q115.2 (E), Q116.2 (E), Q125.1 (B), Q126.1 (B), R1127.2, R1157.2; also elsewhere on the board
IN5_AMP_REF: C135.2, D145.3 (K), R1141.2, U21.2 (-)
IN5_EMIT_F: U21.3 (+); also elsewhere on the board
IN5_FIELD: D105.3 (K), D125.3 (K); also elsewhere on the board
IN5_LIMIT_BASE: Q155.1 (B), R1142.2, R1143.1
IN5_UV_EMITTER: C165.1, Q125.2 (E), R1124.1, R1127.1; also elsewhere on the board
IN5_WET_BASE: Q105.1 (B), Q135.3 (D), Q155.3 (C), R1122.1, R1123.2
IN5_WET_EMIT: Q105.3 (E), R1120.2, R1143.2; also elsewhere on the board
IN6_AMP_REF: C136.2, D146.3 (K), R1171.2, U21.6 (-)
IN6_EMIT_F: U21.5 (+); also elsewhere on the board
IN6_FIELD: D106.3 (K), D126.3 (K); also elsewhere on the board
IN6_LIMIT_BASE: Q156.1 (B), R1172.2, R1173.1
IN6_UV_EMITTER: C166.1, Q126.2 (E), R1154.1, R1157.1; also elsewhere on the board
IN6_WET_BASE: Q106.1 (B), Q136.3 (D), Q156.3 (C), R1152.1, R1153.2
IN6_WET_EMIT: Q106.3 (E), R1150.2, R1173.2; also elsewhere on the board
unnamed: D125.1 (A), R1126.2
unnamed: D126.1 (A), R1156.2
unnamed: R1124.2, R1125.1
unnamed: R1125.2, R1126.1
unnamed: R1154.2, R1155.1
unnamed: R1155.2, R1156.1

Notes on the sheet:
UNIVERSAL POOFER CONTROL | 13 | Wetting sources 5-6
REV A.3 | Dry contacts | Latched hardware stop | Buffered expansion
INPUT 5 | PRECISION WETTING SOURCE
Nominal 20 mA; compensated servo and backup limiter
AUTONOMOUS NEGATIVE-FAULT CLAMP
INPUT 6 | PRECISION WETTING SOURCE
