NOVA-Cluster/Universal-Poofer-Control/Universal_Poofer_Control.kicad_pcb

## KiCad design Universal_Poofer_Control.kicad_pcb (continued)

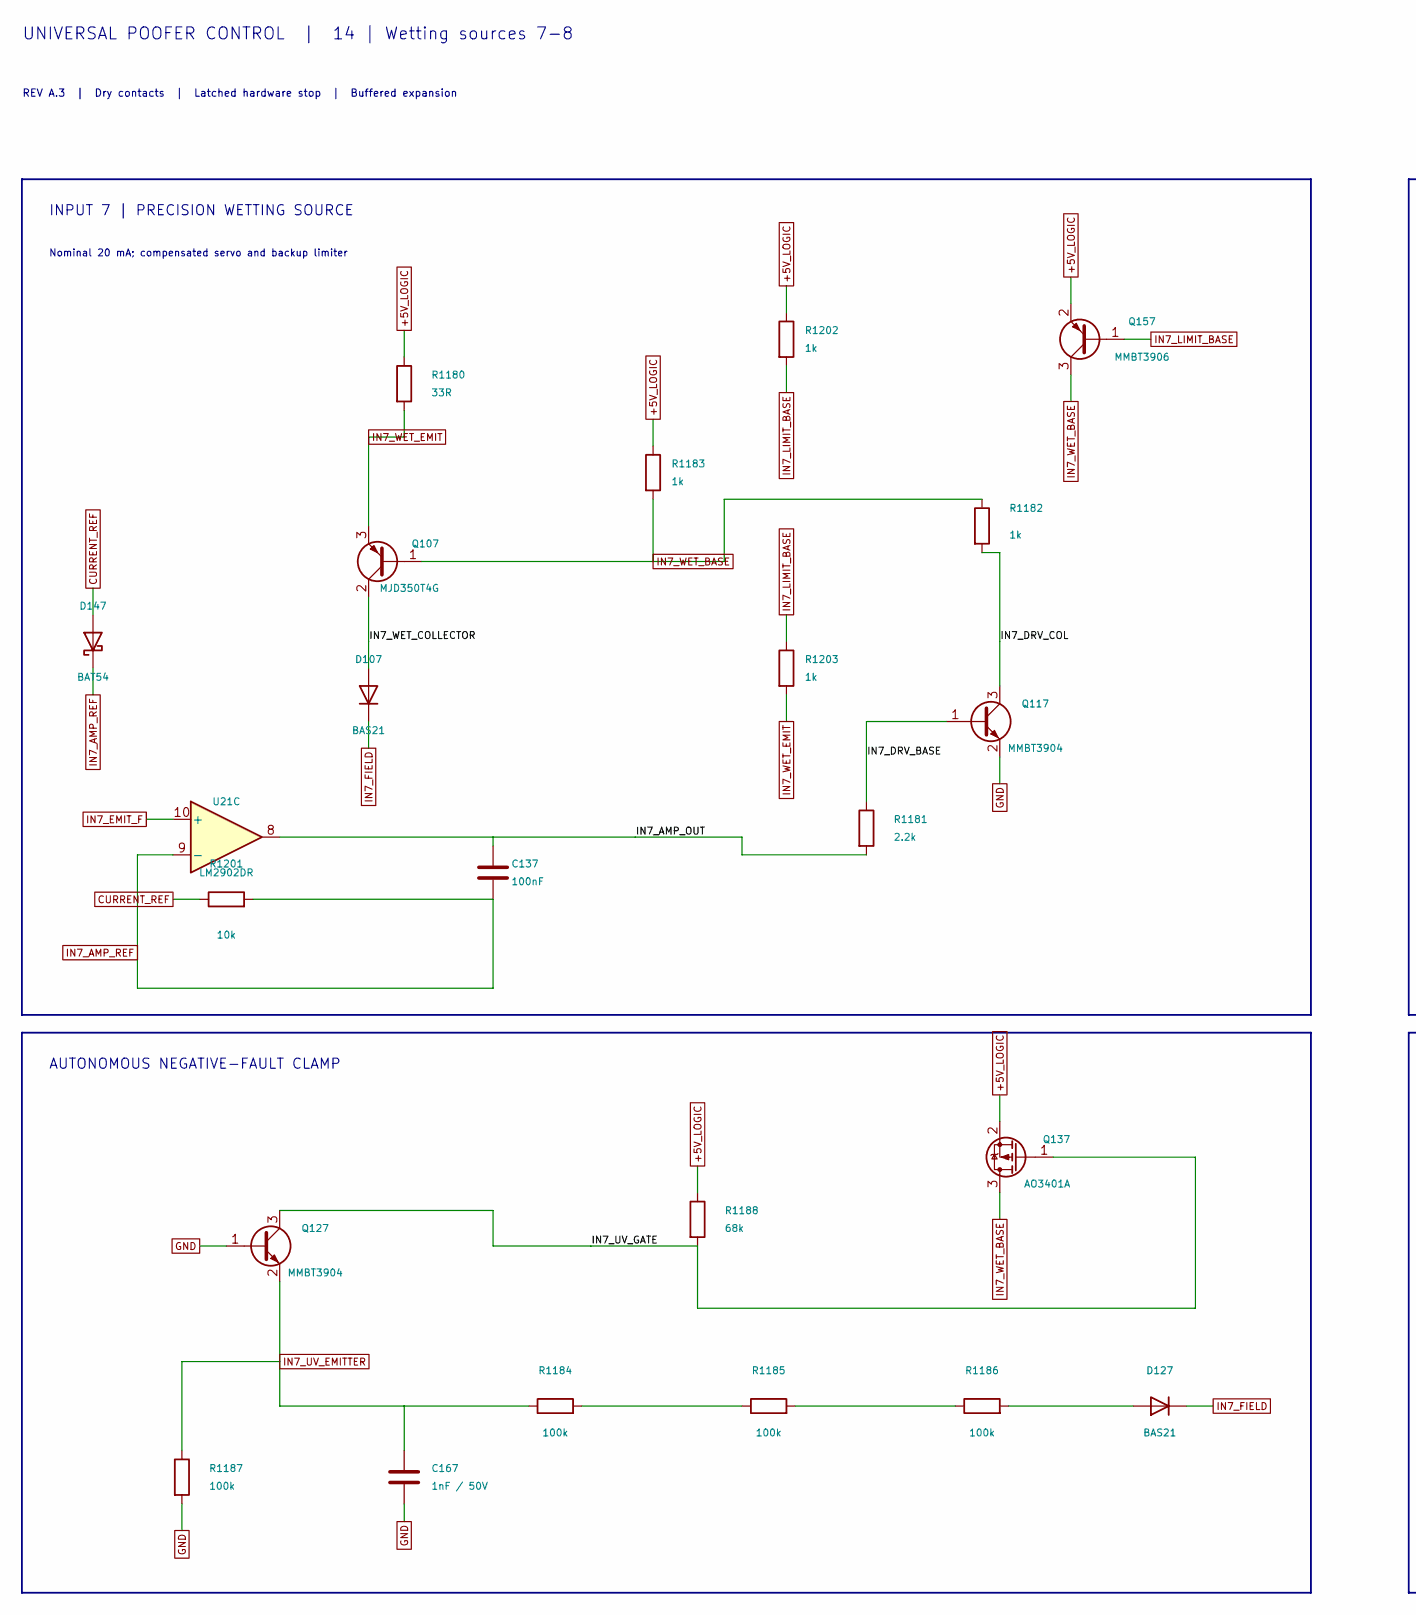
[picture p55: schematic Contact_Sources_4.kicad_sch, 14 | Wetting sources 7-8, part in row 1, column 1]

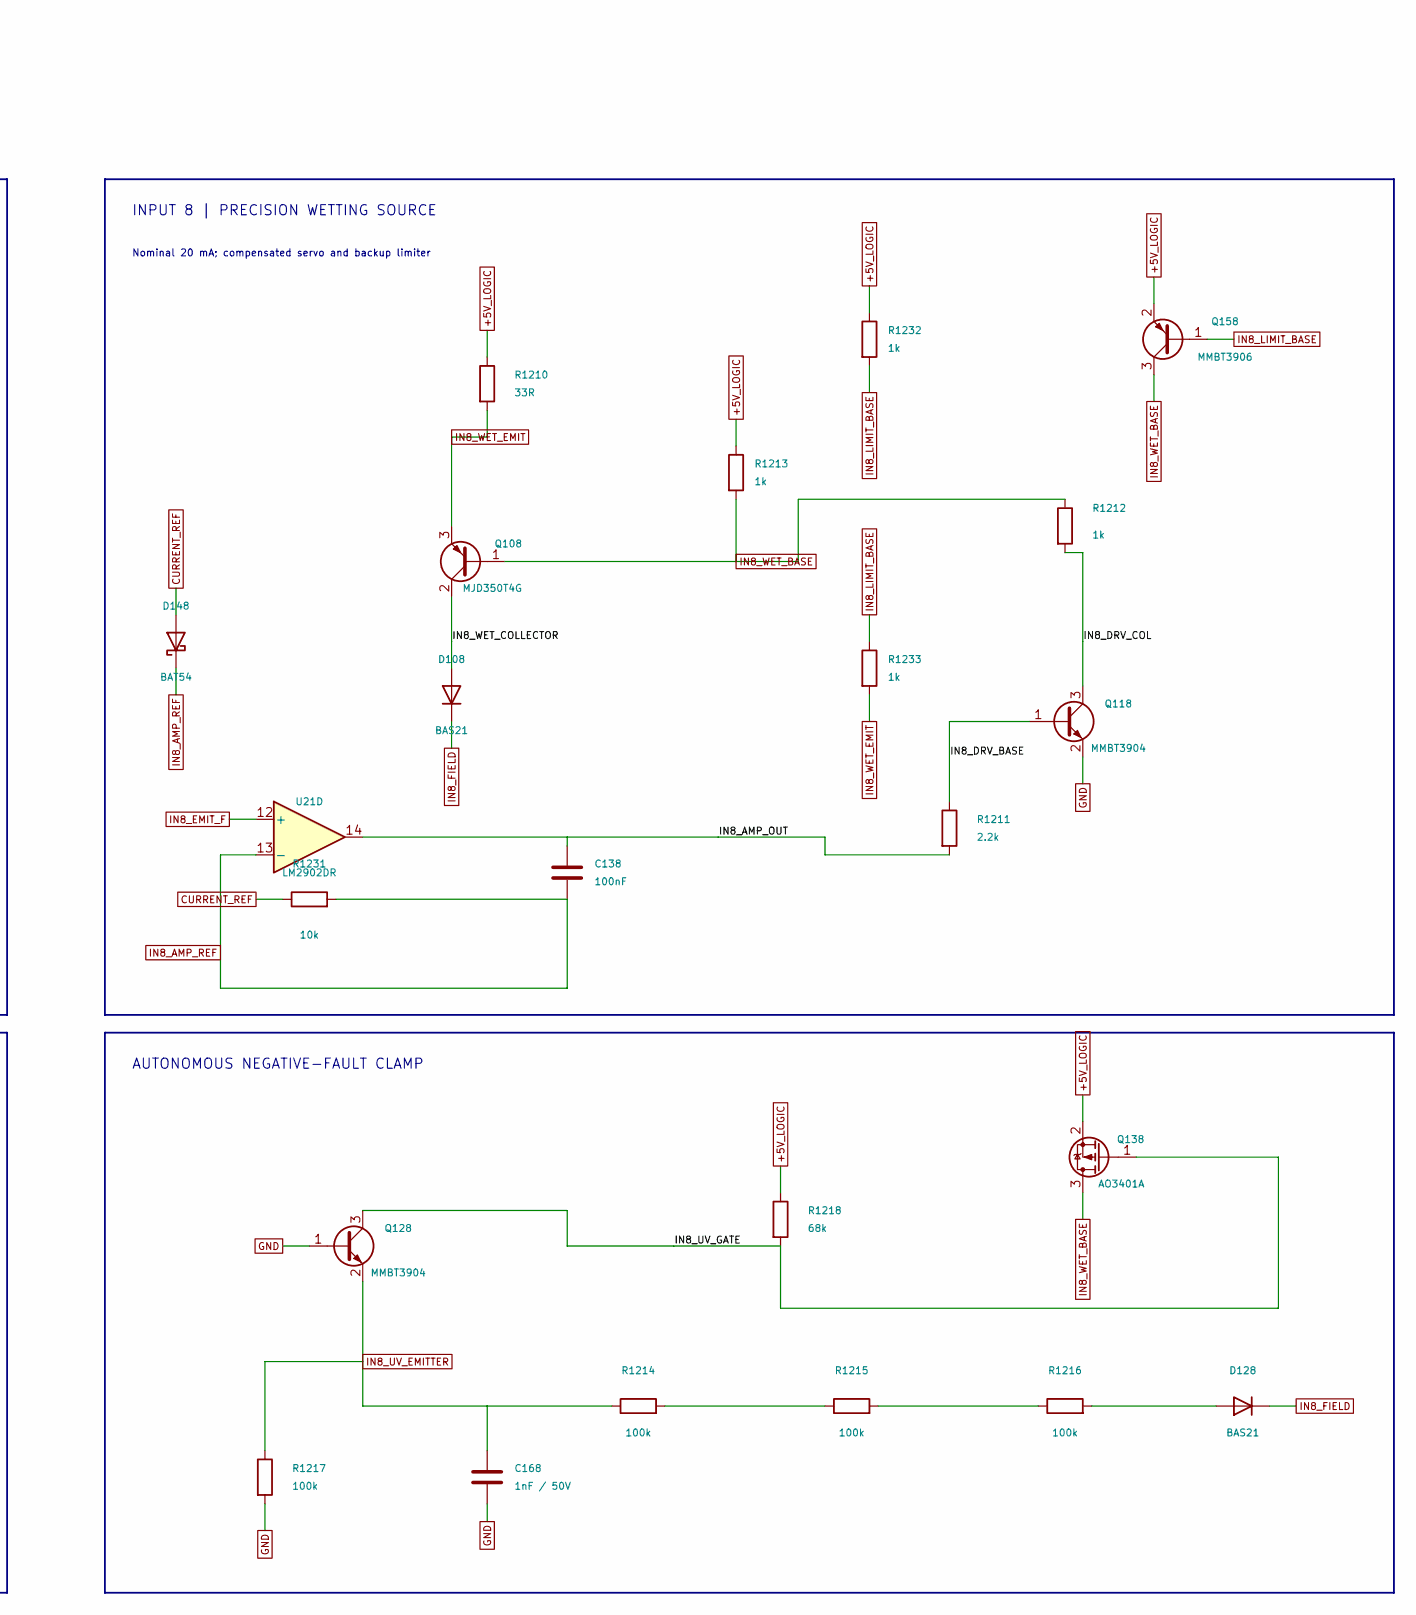
[picture p56: schematic Contact_Sources_4.kicad_sch, 14 | Wetting sources 7-8, part in row 1, column 2]

Parts:
C137, C138: 100nF; C_0805_2012Metric; MPN CC0805KRX7R9BB104; LCSC C49678
C167, C168: 1nF / 50V; C_0805_2012Metric; MPN CL21B102KBANNNC; LCSC C51210
D107, D108, D127, D128: BAS21; SOT-23; MPN BAS21,215; LCSC C8661
D147, D148: BAT54; SOT-23; MPN BAT54,215; LCSC C85084
Q107, Q108: MJD350T4G; TO-252-3_TabPin2; MPN MJD350T4G; LCSC C145514
Q117, Q118, Q127, Q128: MMBT3904; SOT-23; MPN MMBT3904(RANGE:100-300); LCSC C20526
Q137, Q138: AO3401A; SOT-23; MPN AO3401A; LCSC C15127
Q157, Q158: MMBT3906; SOT-23; MPN MMBT3906 2A(RANGE:100-300); LCSC C2143
R1180, R1210: 33R; R_0805_2012Metric; MPN 0805W8F330JT5E; LCSC C17634
R1181, R1211: 2.2k; R_0805_2012Metric; MPN 0805W8F2201T5E; LCSC C17520
R1182, R1183, R1202, R1203, R1212, R1213, R1232, R1233: 1k; R_0805_2012Metric; MPN 0805W8F1001T5E; LCSC C17513
R1184, R1185, R1186, R1187, R1214, R1215, R1216, R1217: 100k; R_0805_2012Metric; MPN 0805W8F1003T5E; LCSC C149504
R1188, R1218: 68k; R_0805_2012Metric; MPN 0805W8F6802T5E; LCSC C17801
R1201, R1231: 10k; R_0805_2012Metric; MPN 0805W8F1002T5E; LCSC C17414
U21: LM2902DR; SOIC-14_3.9x8.7mm_P1.27mm; MPN LM2902DR; LCSC C350545

Connections:
+5V_LOGIC: Q137.2 (S), Q138.2 (S), Q157.2 (E), Q158.2 (E), R1180.1, R1183.1, R1188.1, R1202.1, R1210.1, R1213.1, R1218.1, R1232.1; also elsewhere on the board
/14 | Wetting sources 7-8/IN7_AMP_OUT: C137.1, R1181.2, U21.8
/14 | Wetting sources 7-8/IN7_DRV_BASE: Q117.1 (B), R1181.1
/14 | Wetting sources 7-8/IN7_DRV_COL: Q117.3 (C), R1182.2
/14 | Wetting sources 7-8/IN7_UV_GATE: Q127.3 (C), Q137.1 (G), R1188.2
/14 | Wetting sources 7-8/IN7_WET_COLLECTOR: D107.1 (A), Q107.2 (C)
/14 | Wetting sources 7-8/IN8_AMP_OUT: C138.1, R1211.2, U21.14
/14 | Wetting sources 7-8/IN8_DRV_BASE: Q118.1 (B), R1211.1
/14 | Wetting sources 7-8/IN8_DRV_COL: Q118.3 (C), R1212.2
/14 | Wetting sources 7-8/IN8_UV_GATE: Q128.3 (C), Q138.1 (G), R1218.2
/14 | Wetting sources 7-8/IN8_WET_COLLECTOR: D108.1 (A), Q108.2 (C)
CURRENT_REF: D147.1 (A), D148.1 (A), R1201.1, R1231.1; also elsewhere on the board
GND: C167.2, C168.2, Q117.2 (E), Q118.2 (E), Q127.1 (B), Q128.1 (B), R1187.2, R1217.2; also elsewhere on the board
IN7_AMP_REF: C137.2, D147.3 (K), R1201.2, U21.9 (-)
IN7_EMIT_F: U21.10 (+); also elsewhere on the board
IN7_FIELD: D107.3 (K), D127.3 (K); also elsewhere on the board
IN7_LIMIT_BASE: Q157.1 (B), R1202.2, R1203.1
IN7_UV_EMITTER: C167.1, Q127.2 (E), R1184.1, R1187.1; also elsewhere on the board
IN7_WET_BASE: Q107.1 (B), Q137.3 (D), Q157.3 (C), R1182.1, R1183.2
IN7_WET_EMIT: Q107.3 (E), R1180.2, R1203.2; also elsewhere on the board
IN8_AMP_REF: C138.2, D148.3 (K), R1231.2, U21.13 (-)
IN8_EMIT_F: U21.12 (+); also elsewhere on the board
IN8_FIELD: D108.3 (K), D128.3 (K); also elsewhere on the board
IN8_LIMIT_BASE: Q158.1 (B), R1232.2, R1233.1
IN8_UV_EMITTER: C168.1, Q128.2 (E), R1214.1, R1217.1; also elsewhere on the board
IN8_WET_BASE: Q108.1 (B), Q138.3 (D), Q158.3 (C), R1212.1, R1213.2
IN8_WET_EMIT: Q108.3 (E), R1210.2, R1233.2; also elsewhere on the board
unnamed: D127.1 (A), R1186.2
unnamed: D128.1 (A), R1216.2
unnamed: R1184.2, R1185.1
unnamed: R1185.2, R1186.1
unnamed: R1214.2, R1215.1
unnamed: R1215.2, R1216.1

Notes on the sheet:
UNIVERSAL POOFER CONTROL | 14 | Wetting sources 7-8
REV A.3 | Dry contacts | Latched hardware stop | Buffered expansion
INPUT 7 | PRECISION WETTING SOURCE
Nominal 20 mA; compensated servo and backup limiter
AUTONOMOUS NEGATIVE-FAULT CLAMP
INPUT 8 | PRECISION WETTING SOURCE

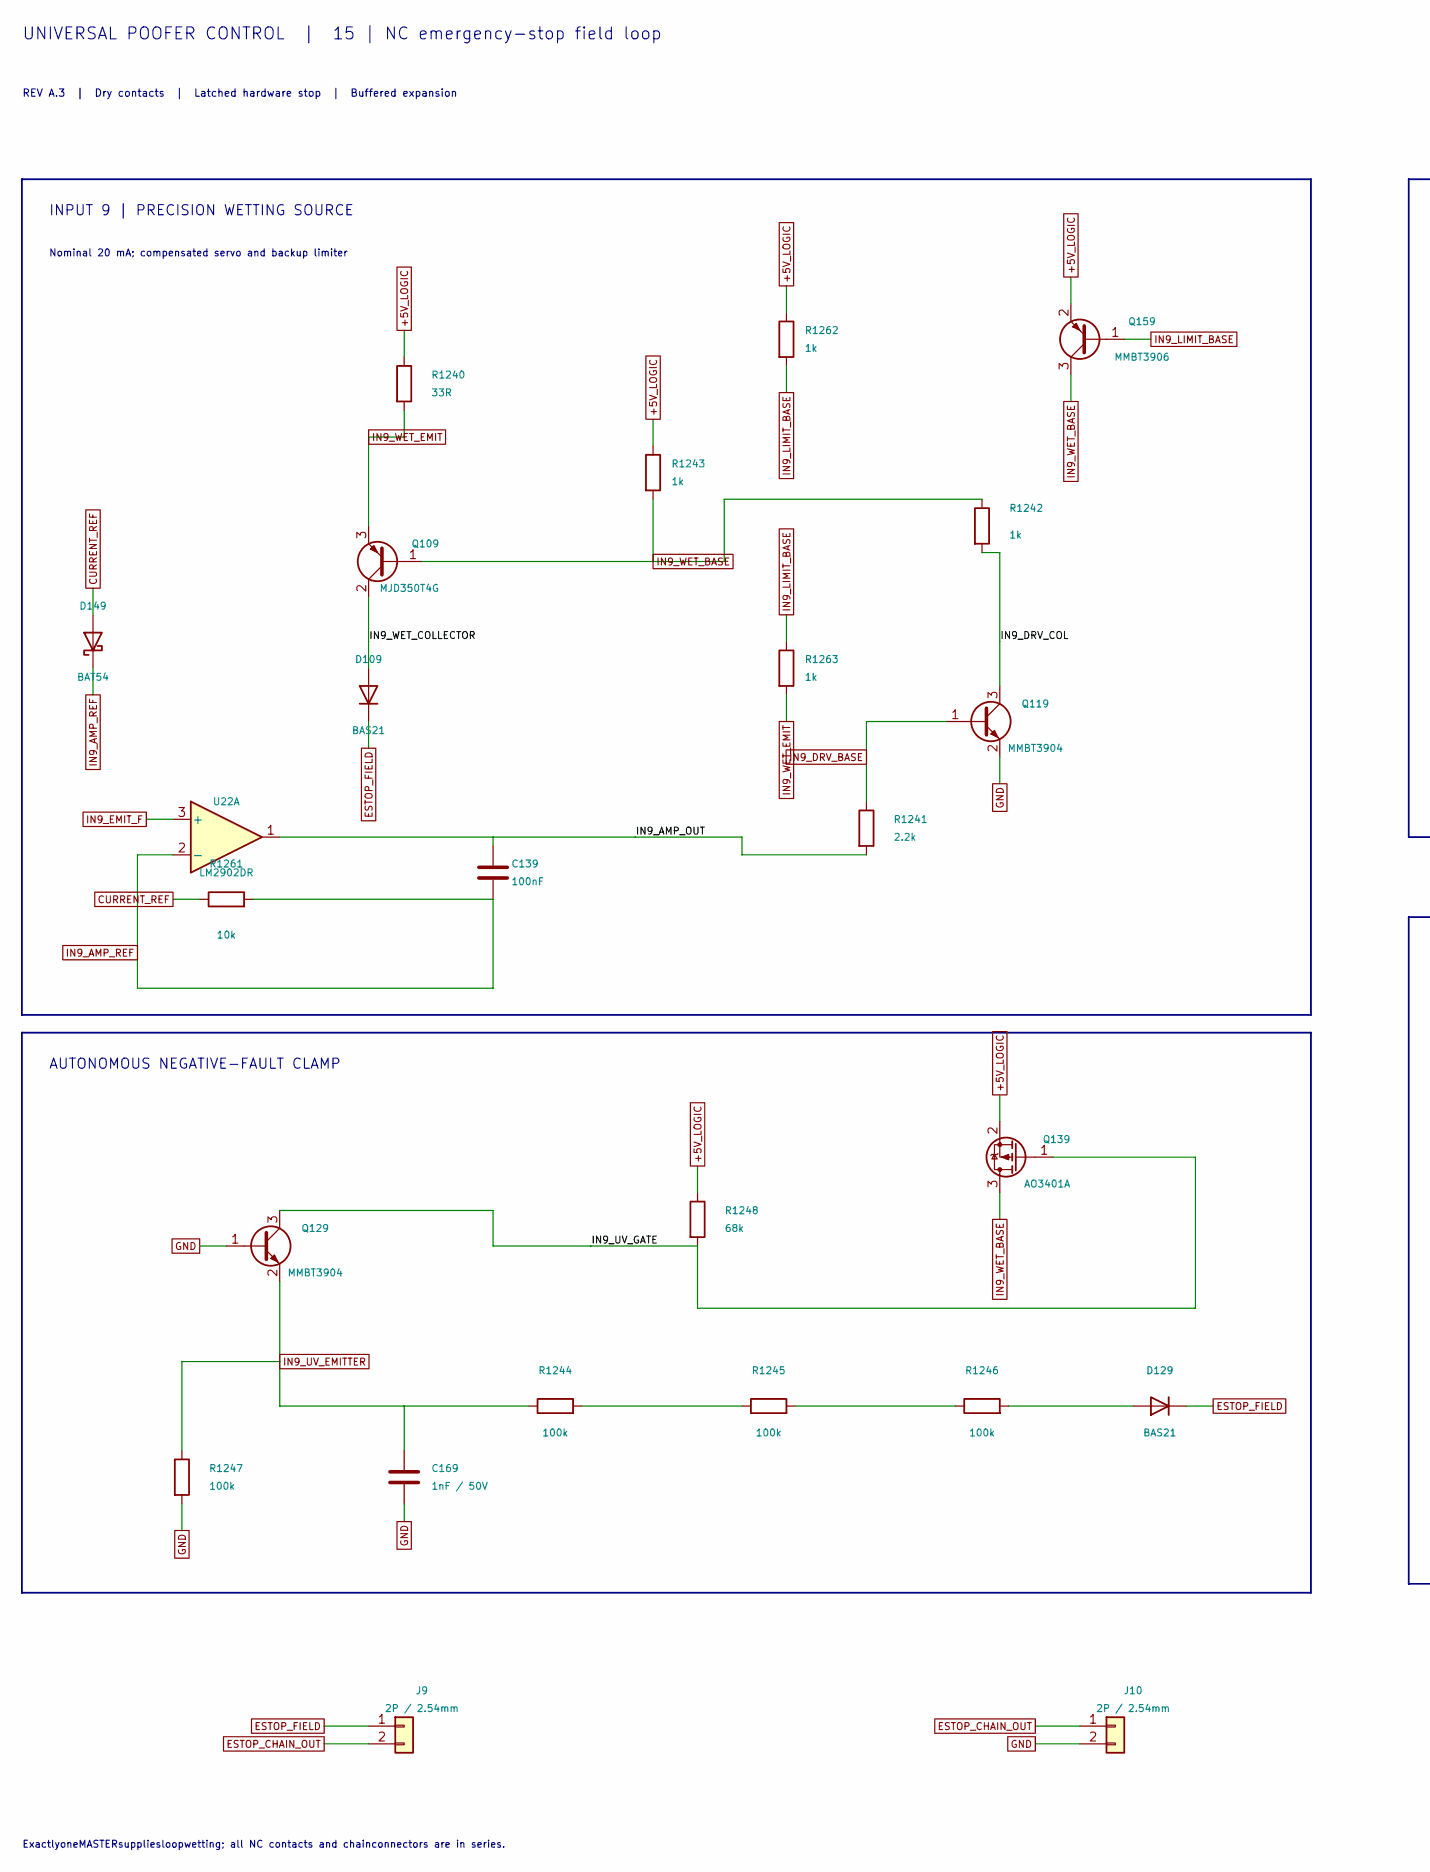
[picture p57: schematic Stop_Field.kicad_sch, 15 | NC emergency-stop field loop, part in row 1, column 1]

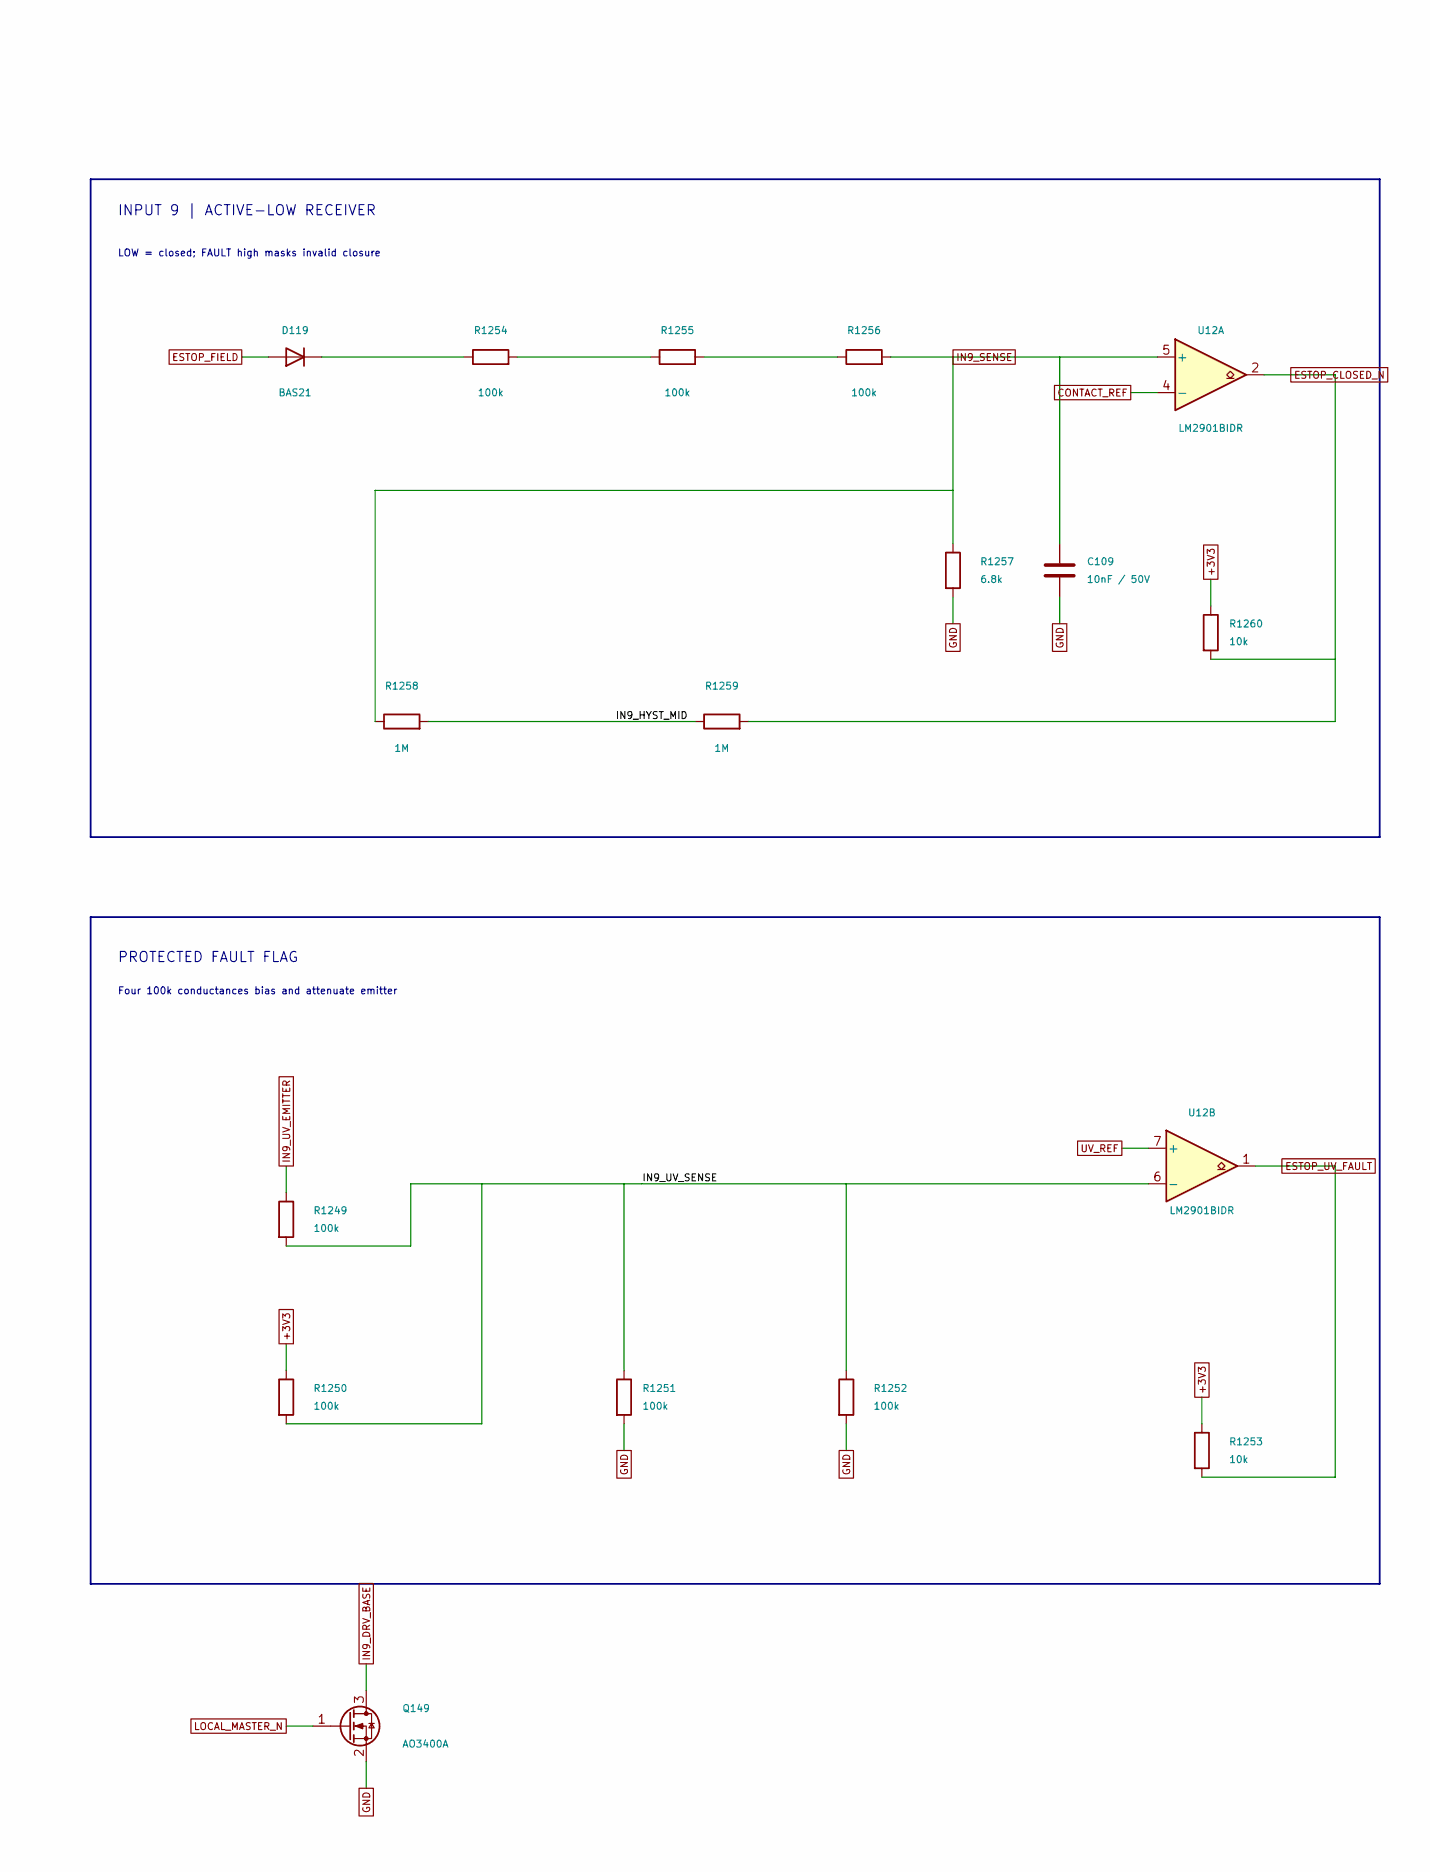
[picture p58: schematic Stop_Field.kicad_sch, 15 | NC emergency-stop field loop, part in row 1, column 2]

Parts:
C109: 10nF / 50V; C_0805_2012Metric; MPN CL21B103KBANNNC; LCSC C1710
C139: 100nF; C_0805_2012Metric; MPN CC0805KRX7R9BB104; LCSC C49678
C169: 1nF / 50V; C_0805_2012Metric; MPN CL21B102KBANNNC; LCSC C51210
D109, D119, D129: BAS21; SOT-23; MPN BAS21,215; LCSC C8661
D149: BAT54; SOT-23; MPN BAT54,215; LCSC C85084
J9, J10: 2P / 2.54mm; PinHeader_1x02_P2.54mm_Vertical; MPN B-2100S02P-A110; LCSC C124375
Q109: MJD350T4G; TO-252-3_TabPin2; MPN MJD350T4G; LCSC C145514
Q119, Q129: MMBT3904; SOT-23; MPN MMBT3904(RANGE:100-300); LCSC C20526
Q139: AO3401A; SOT-23; MPN AO3401A; LCSC C15127
Q149: AO3400A; SOT-23; MPN AO3400A; LCSC C20917
Q159: MMBT3906; SOT-23; MPN MMBT3906 2A(RANGE:100-300); LCSC C2143
R1240: 33R; R_0805_2012Metric; MPN 0805W8F330JT5E; LCSC C17634
R1241: 2.2k; R_0805_2012Metric; MPN 0805W8F2201T5E; LCSC C17520
R1242, R1243, R1262, R1263: 1k; R_0805_2012Metric; MPN 0805W8F1001T5E; LCSC C17513
R1244, R1245, R1246, R1247, R1249, R1250, R1251, R1252, R1254, R1255, R1256: 100k; R_0805_2012Metric; MPN 0805W8F1003T5E; LCSC C149504
R1248: 68k; R_0805_2012Metric; MPN 0805W8F6802T5E; LCSC C17801
R1253, R1260, R1261: 10k; R_0805_2012Metric; MPN 0805W8F1002T5E; LCSC C17414
R1257: 6.8k; R_0805_2012Metric; MPN 0805W8F6801T5E; LCSC C17772
R1258, R1259: 1M; R_0805_2012Metric; MPN 0805W8F1004T5E; LCSC C17514
U12: LM2901BIDR; SOIC-14_3.9x8.7mm_P1.27mm; MPN LM2901BIDR; LCSC C22427890
U22: LM2902DR; SOIC-14_3.9x8.7mm_P1.27mm; MPN LM2902DR; LCSC C350545

Connections:
+3V3: R1250.1, R1253.1, R1260.1; also elsewhere on the board
+5V_LOGIC: Q139.2 (S), Q159.2 (E), R1240.1, R1243.1, R1248.1, R1262.1; also elsewhere on the board
/15 | NC emergency-stop field loop/IN9_AMP_OUT: C139.1, R1241.2, U22.1
/15 | NC emergency-stop field loop/IN9_DRV_COL: Q119.3 (C), R1242.2
/15 | NC emergency-stop field loop/IN9_HYST_MID: R1258.2, R1259.1
/15 | NC emergency-stop field loop/IN9_UV_GATE: Q129.3 (C), Q139.1 (G), R1248.2
/15 | NC emergency-stop field loop/IN9_UV_SENSE: R1249.2, R1250.2, R1251.1, R1252.1, U12.6 (-)
/15 | NC emergency-stop field loop/IN9_WET_COLLECTOR: D109.1 (A), Q109.2 (C)
CONTACT_REF: U12.4 (-); also elsewhere on the board
CURRENT_REF: D149.1 (A), R1261.1; also elsewhere on the board
ESTOP_CHAIN_OUT: J9.2, J10.1; also elsewhere on the board
ESTOP_CLOSED_N: R1259.2, R1260.2, U12.2; also elsewhere on the board
ESTOP_FIELD: D109.3 (K), D119.1 (A), D129.3 (K), J9.1; also elsewhere on the board
ESTOP_UV_FAULT: R1253.2, U12.1; also elsewhere on the board
GND: C109.2, C169.2, J10.2, Q119.2 (E), Q129.1 (B), Q149.2 (S), R1247.2, R1251.2, R1252.2, R1257.2; also elsewhere on the board
IN9_AMP_REF: C139.2, D149.3 (K), R1261.2, U22.2 (-)
IN9_DRV_BASE: Q119.1 (B), Q149.3 (D), R1241.1
IN9_EMIT_F: U22.3 (+); also elsewhere on the board
IN9_LIMIT_BASE: Q159.1 (B), R1262.2, R1263.1
IN9_SENSE: C109.1, R1256.2, R1257.1, R1258.1, U12.5 (+)
IN9_UV_EMITTER: C169.1, Q129.2 (E), R1244.1, R1247.1, R1249.1
IN9_WET_BASE: Q109.1 (B), Q139.3 (D), Q159.3 (C), R1242.1, R1243.2
IN9_WET_EMIT: Q109.3 (E), R1240.2, R1263.2; also elsewhere on the board
LOCAL_MASTER_N: Q149.1 (G); also elsewhere on the board
unnamed: D119.3 (K), R1254.1
unnamed: D129.1 (A), R1246.2
unnamed: R1244.2, R1245.1
unnamed: R1245.2, R1246.1
unnamed: R1254.2, R1255.1
unnamed: R1255.2, R1256.1
UV_REF: U12.7 (+); also elsewhere on the board

Notes on the sheet:
UNIVERSAL POOFER CONTROL | 15 | NC emergency-stop field loop
REV A.3 | Dry contacts | Latched hardware stop | Buffered expansion
INPUT 9 | PRECISION WETTING SOURCE
Nominal 20 mA; compensated servo and backup limiter
AUTONOMOUS NEGATIVE-FAULT CLAMP
INPUT 9 | ACTIVE-LOW RECEIVER
LOW = closed; FAULT high masks invalid closure
PROTECTED FAULT FLAG
Four 100k conductances bias and attenuate emitter
ExactlyoneMASTERsuppliesloopwetting; all NC contacts and chainconnectors are in series.

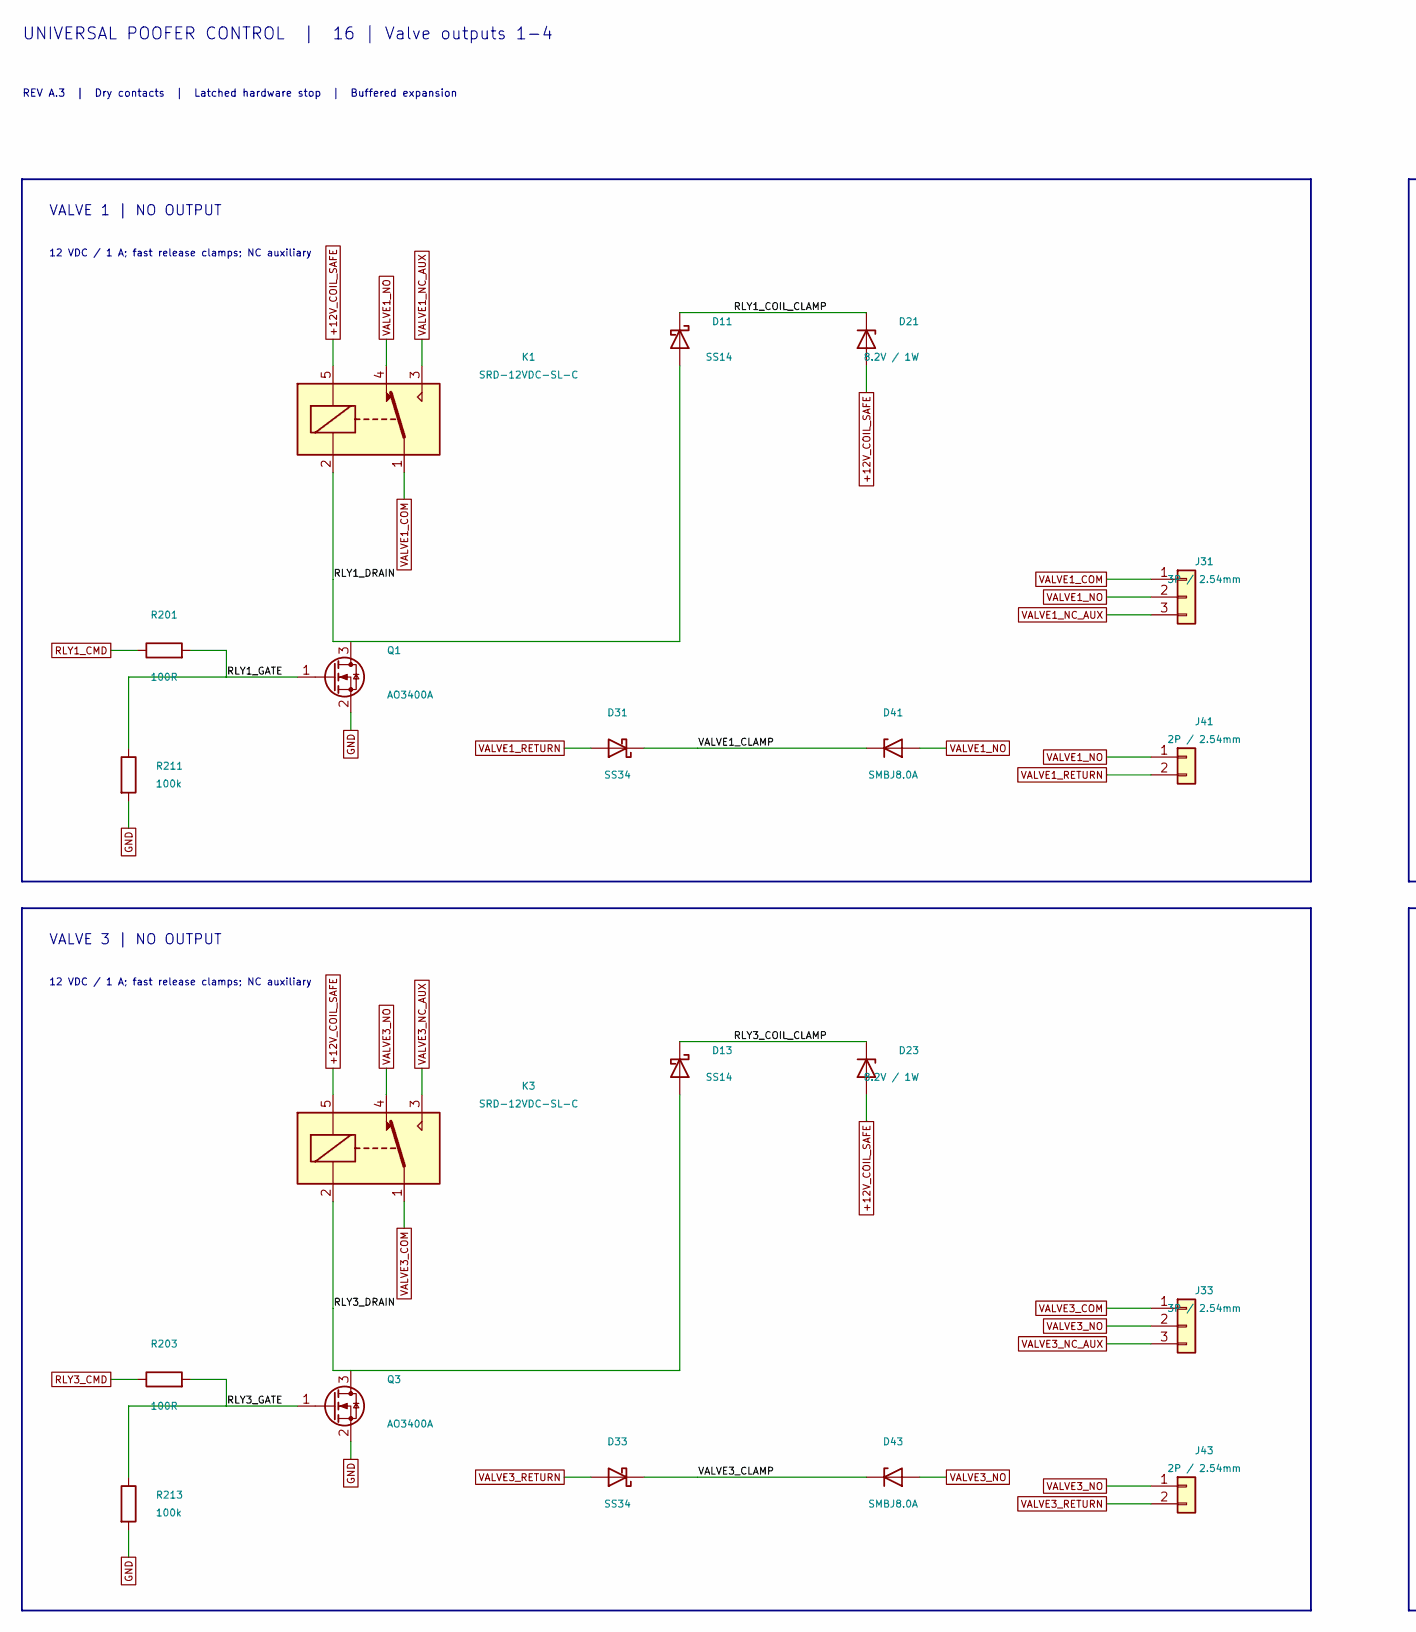
[picture p59: schematic Relay_Outputs_1.kicad_sch, 16 | Valve outputs 1-4, part in row 1, column 1]

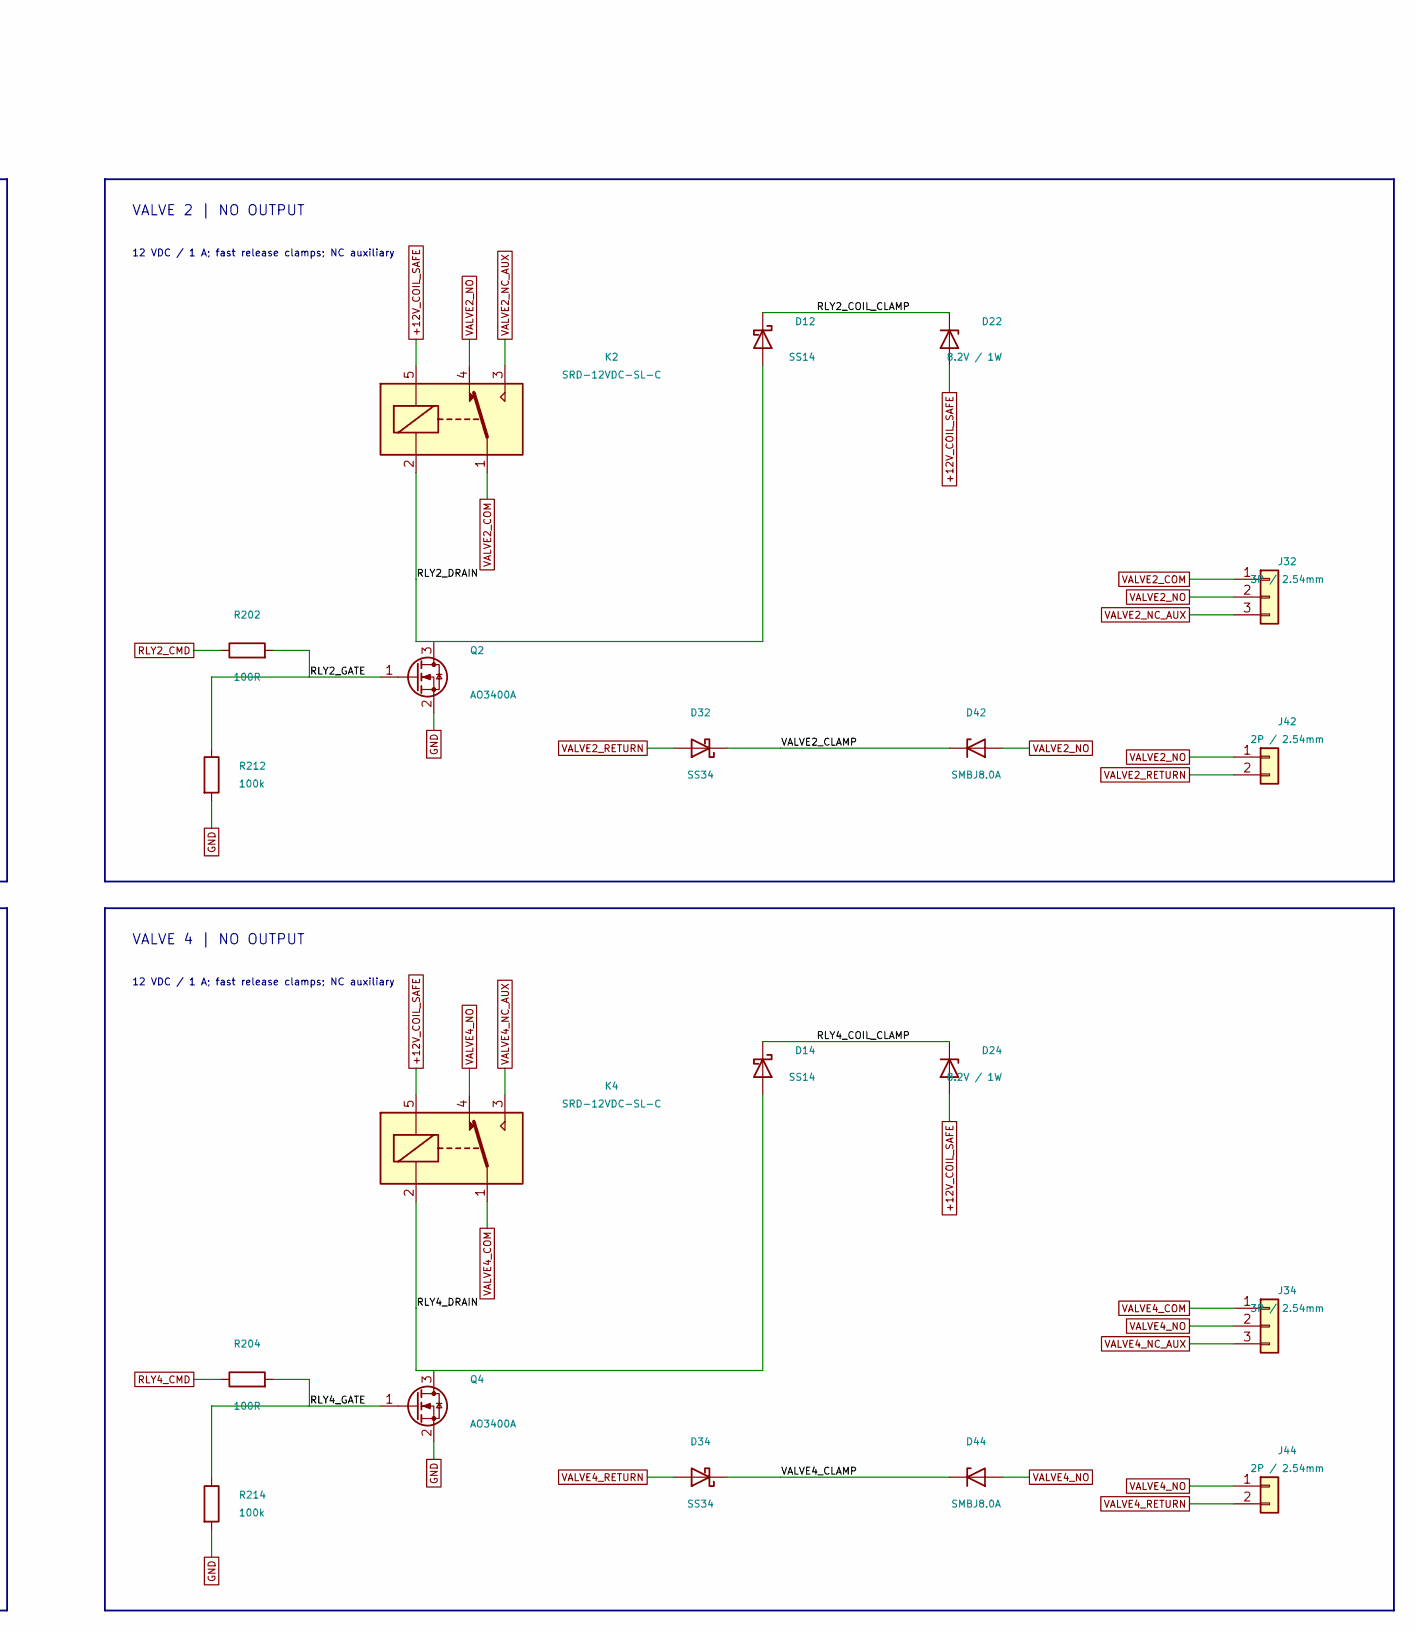
[picture p60: schematic Relay_Outputs_1.kicad_sch, 16 | Valve outputs 1-4, part in row 1, column 2]

Parts:
D11, D12, D13, D14: SS14; D_SMA; MPN SS14; LCSC C2480
D21, D22, D23, D24: 8.2V / 1W; D_SMA; MPN SMAZ8V2-13-F; LCSC C84362
D31, D32, D33, D34: SS34; D_SMA; MPN SS34; LCSC C8678
D41, D42, D43, D44: SMBJ8.0A; D_SMB; MPN SMBJ8.0A; LCSC C224028
J31, J32, J33, J34: 3P / 2.54mm; PinHeader_1x03_P2.54mm_Vertical; MPN B-2100S03P-A110; LCSC C124376
J41, J42, J43, J44: 2P / 2.54mm; PinHeader_1x02_P2.54mm_Vertical; MPN B-2100S02P-A110; LCSC C124375
K1, K2, K3, K4: SRD-12VDC-SL-C; Relay_SPDT_Songle_SRD; MPN SRD-12VDC-SL-C; LCSC C30431
Q1, Q2, Q3, Q4: AO3400A; SOT-23; MPN AO3400A; LCSC C20917
R201, R202, R203, R204: 100R; R_0805_2012Metric; MPN 0805W8F1000T5E; LCSC C17408
R211, R212, R213, R214: 100k; R_0805_2012Metric; MPN 0805W8F1003T5E; LCSC C149504

Connections:
+12V_COIL_SAFE: D21.2 (A), D22.2 (A), D23.2 (A), D24.2 (A), K1.5, K2.5, K3.5, K4.5; also elsewhere on the board
/16 | Valve outputs 1-4/RLY1_COIL_CLAMP: D11.1 (K), D21.1 (K)
/16 | Valve outputs 1-4/RLY1_DRAIN: D11.2 (A), K1.2, Q1.3 (D)
/16 | Valve outputs 1-4/RLY1_GATE: Q1.1 (G), R201.2, R211.1
/16 | Valve outputs 1-4/RLY2_COIL_CLAMP: D12.1 (K), D22.1 (K)
/16 | Valve outputs 1-4/RLY2_DRAIN: D12.2 (A), K2.2, Q2.3 (D)
/16 | Valve outputs 1-4/RLY2_GATE: Q2.1 (G), R202.2, R212.1
/16 | Valve outputs 1-4/RLY3_COIL_CLAMP: D13.1 (K), D23.1 (K)
/16 | Valve outputs 1-4/RLY3_DRAIN: D13.2 (A), K3.2, Q3.3 (D)
/16 | Valve outputs 1-4/RLY3_GATE: Q3.1 (G), R203.2, R213.1
/16 | Valve outputs 1-4/RLY4_COIL_CLAMP: D14.1 (K), D24.1 (K)
/16 | Valve outputs 1-4/RLY4_DRAIN: D14.2 (A), K4.2, Q4.3 (D)
/16 | Valve outputs 1-4/RLY4_GATE: Q4.1 (G), R204.2, R214.1
/16 | Valve outputs 1-4/VALVE1_CLAMP: D31.1 (K), D41.1 (K)
/16 | Valve outputs 1-4/VALVE2_CLAMP: D32.1 (K), D42.1 (K)
/16 | Valve outputs 1-4/VALVE3_CLAMP: D33.1 (K), D43.1 (K)
/16 | Valve outputs 1-4/VALVE4_CLAMP: D34.1 (K), D44.1 (K)
GND: Q1.2 (S), Q2.2 (S), Q3.2 (S), Q4.2 (S), R211.2, R212.2, R213.2, R214.2; also elsewhere on the board
RLY1_CMD: R201.1; also elsewhere on the board
RLY2_CMD: R202.1; also elsewhere on the board
RLY3_CMD: R203.1; also elsewhere on the board
RLY4_CMD: R204.1; also elsewhere on the board
VALVE1_COM: J31.1, K1.1
VALVE1_NC_AUX: J31.3, K1.3
VALVE1_NO: D41.2 (A), J31.2, J41.1, K1.4
VALVE1_RETURN: D31.2 (A), J41.2
VALVE2_COM: J32.1, K2.1
VALVE2_NC_AUX: J32.3, K2.3
VALVE2_NO: D42.2 (A), J32.2, J42.1, K2.4
VALVE2_RETURN: D32.2 (A), J42.2
VALVE3_COM: J33.1, K3.1
VALVE3_NC_AUX: J33.3, K3.3
VALVE3_NO: D43.2 (A), J33.2, J43.1, K3.4
VALVE3_RETURN: D33.2 (A), J43.2
VALVE4_COM: J34.1, K4.1
VALVE4_NC_AUX: J34.3, K4.3
VALVE4_NO: D44.2 (A), J34.2, J44.1, K4.4
VALVE4_RETURN: D34.2 (A), J44.2

Notes on the sheet:
UNIVERSAL POOFER CONTROL | 16 | Valve outputs 1-4
REV A.3 | Dry contacts | Latched hardware stop | Buffered expansion
VALVE 1 | NO OUTPUT
12 VDC / 1 A; fast release clamps; NC auxiliary
VALVE 2 | NO OUTPUT
VALVE 3 | NO OUTPUT
VALVE 4 | NO OUTPUT
