NOVA-Cluster/Universal-Poofer-Control/Universal_Poofer_Control.kicad_pcb

## KiCad design Universal_Poofer_Control.kicad_pcb (continued)

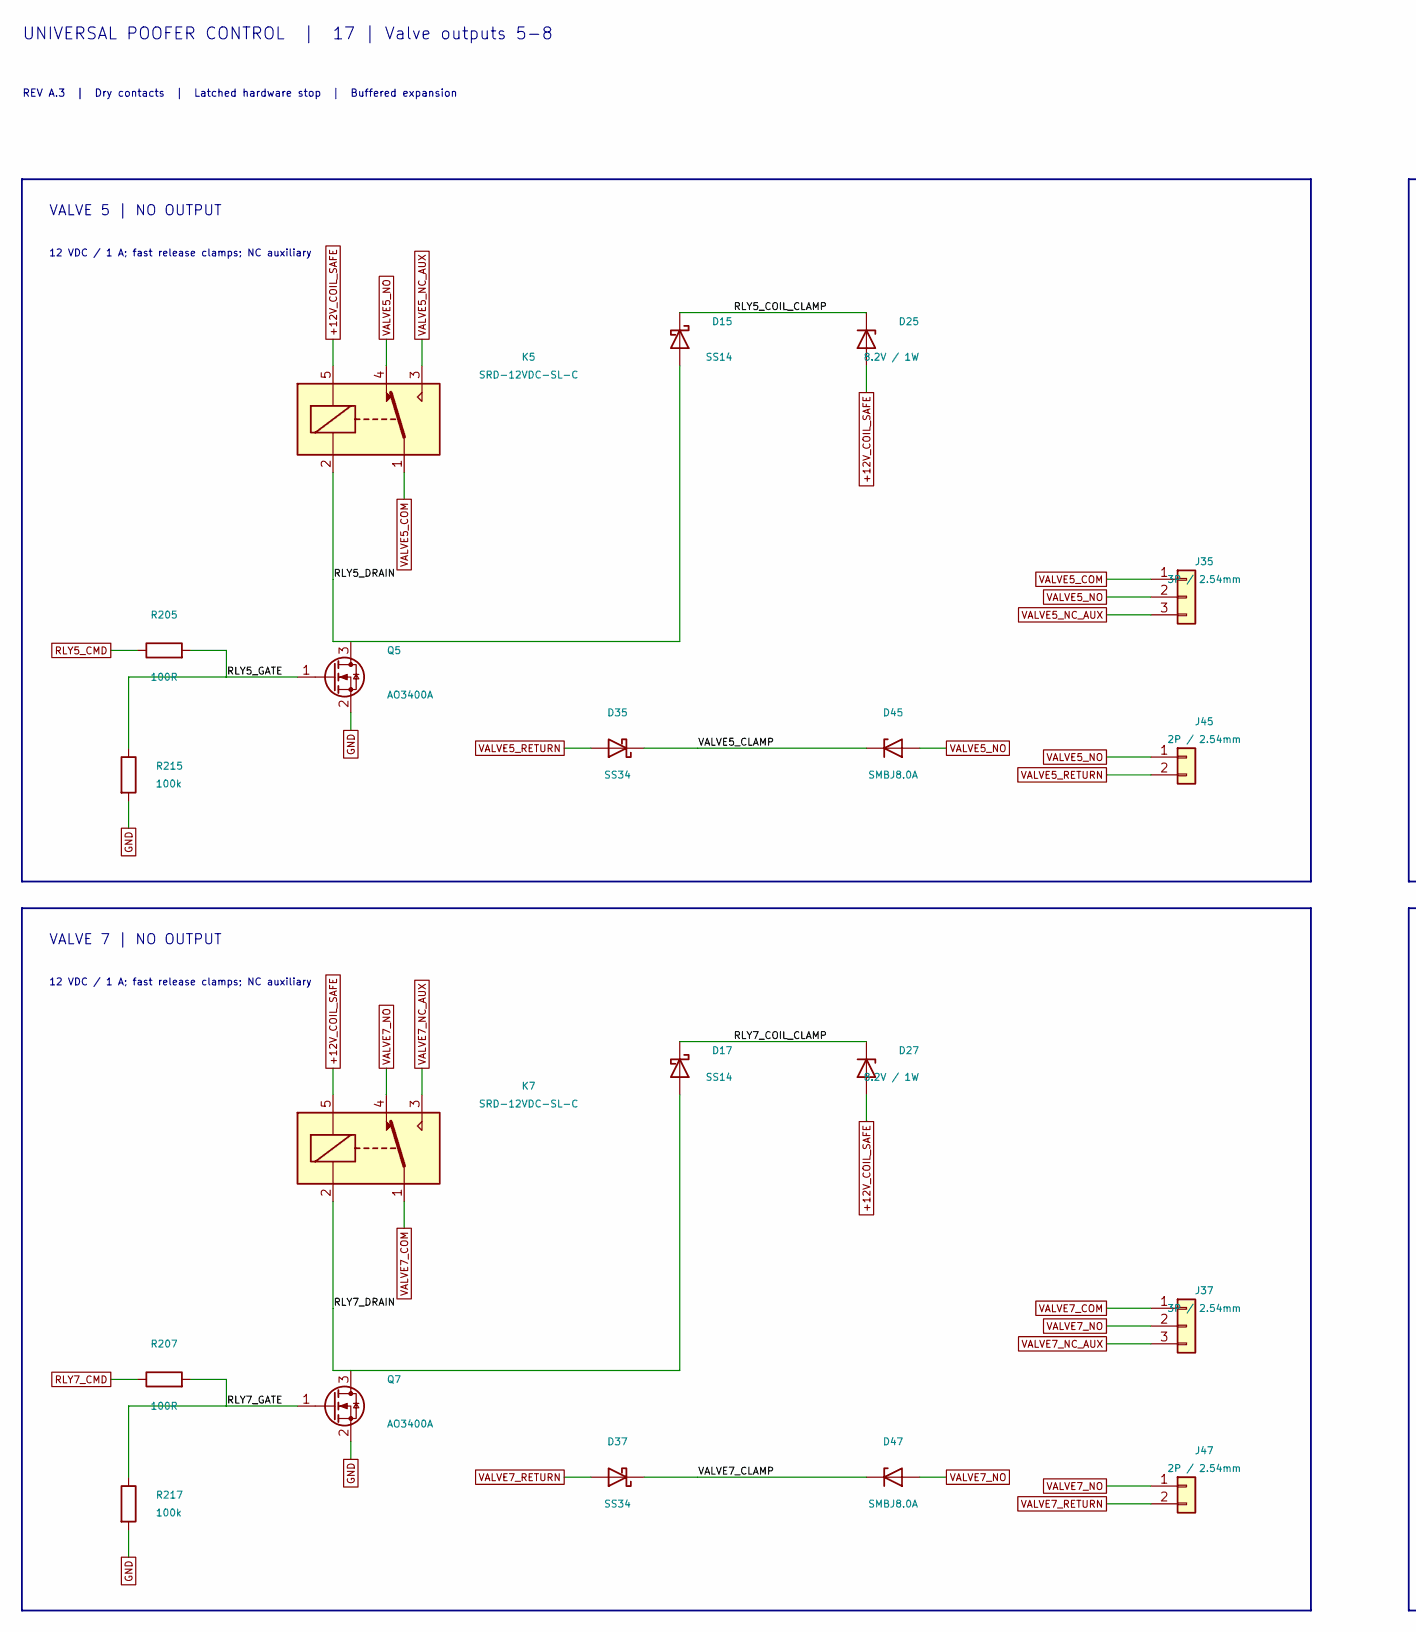
[picture p61: schematic Relay_Outputs_2.kicad_sch, 17 | Valve outputs 5-8, part in row 1, column 1]

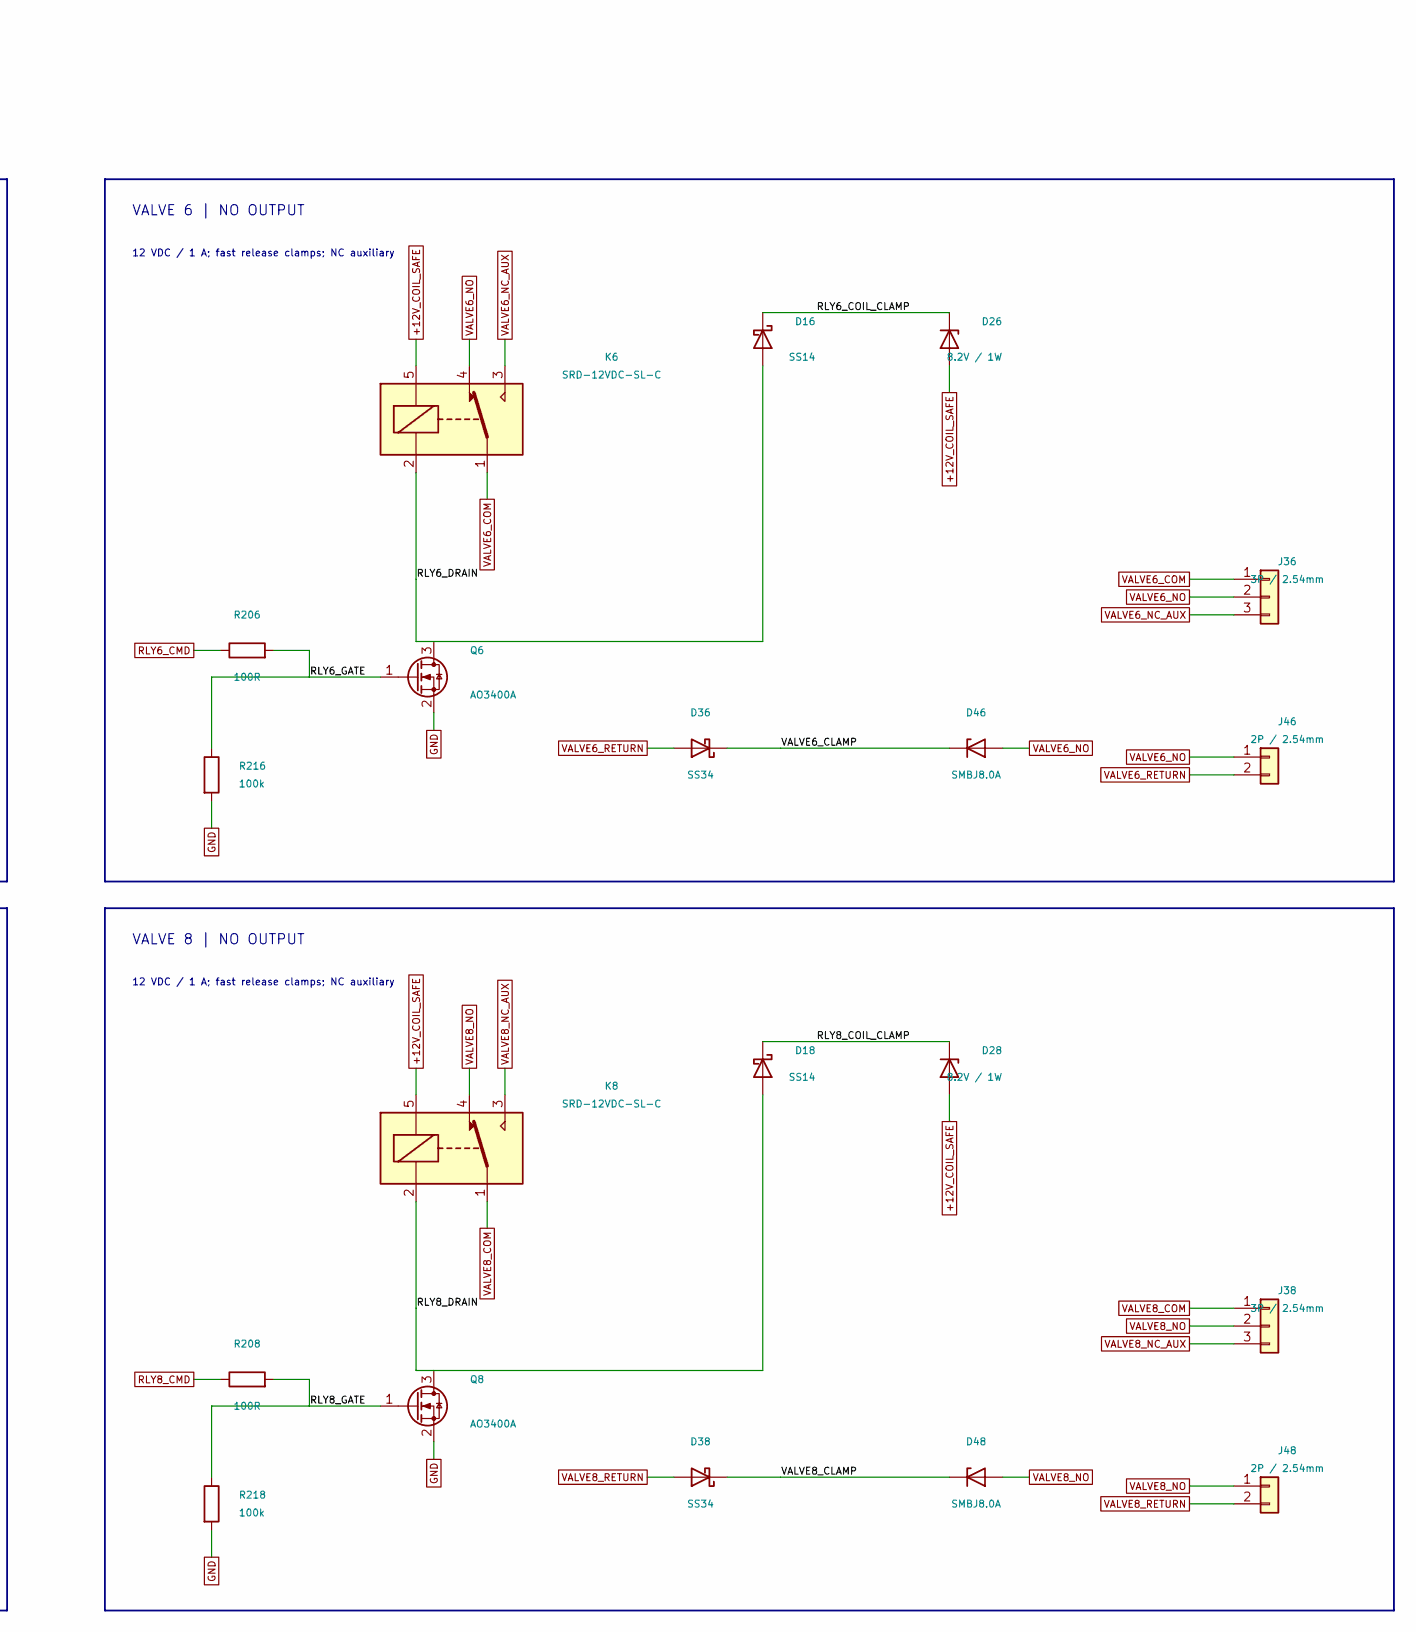
[picture p62: schematic Relay_Outputs_2.kicad_sch, 17 | Valve outputs 5-8, part in row 1, column 2]

Parts:
D15, D16, D17, D18: SS14; D_SMA; MPN SS14; LCSC C2480
D25, D26, D27, D28: 8.2V / 1W; D_SMA; MPN SMAZ8V2-13-F; LCSC C84362
D35, D36, D37, D38: SS34; D_SMA; MPN SS34; LCSC C8678
D45, D46, D47, D48: SMBJ8.0A; D_SMB; MPN SMBJ8.0A; LCSC C224028
J35, J36, J37, J38: 3P / 2.54mm; PinHeader_1x03_P2.54mm_Vertical; MPN B-2100S03P-A110; LCSC C124376
J45, J46, J47, J48: 2P / 2.54mm; PinHeader_1x02_P2.54mm_Vertical; MPN B-2100S02P-A110; LCSC C124375
K5, K6, K7, K8: SRD-12VDC-SL-C; Relay_SPDT_Songle_SRD; MPN SRD-12VDC-SL-C; LCSC C30431
Q5, Q6, Q7, Q8: AO3400A; SOT-23; MPN AO3400A; LCSC C20917
R205, R206, R207, R208: 100R; R_0805_2012Metric; MPN 0805W8F1000T5E; LCSC C17408
R215, R216, R217, R218: 100k; R_0805_2012Metric; MPN 0805W8F1003T5E; LCSC C149504

Connections:
+12V_COIL_SAFE: D25.2 (A), D26.2 (A), D27.2 (A), D28.2 (A), K5.5, K6.5, K7.5, K8.5; also elsewhere on the board
/17 | Valve outputs 5-8/RLY5_COIL_CLAMP: D15.1 (K), D25.1 (K)
/17 | Valve outputs 5-8/RLY5_DRAIN: D15.2 (A), K5.2, Q5.3 (D)
/17 | Valve outputs 5-8/RLY5_GATE: Q5.1 (G), R205.2, R215.1
/17 | Valve outputs 5-8/RLY6_COIL_CLAMP: D16.1 (K), D26.1 (K)
/17 | Valve outputs 5-8/RLY6_DRAIN: D16.2 (A), K6.2, Q6.3 (D)
/17 | Valve outputs 5-8/RLY6_GATE: Q6.1 (G), R206.2, R216.1
/17 | Valve outputs 5-8/RLY7_COIL_CLAMP: D17.1 (K), D27.1 (K)
/17 | Valve outputs 5-8/RLY7_DRAIN: D17.2 (A), K7.2, Q7.3 (D)
/17 | Valve outputs 5-8/RLY7_GATE: Q7.1 (G), R207.2, R217.1
/17 | Valve outputs 5-8/RLY8_COIL_CLAMP: D18.1 (K), D28.1 (K)
/17 | Valve outputs 5-8/RLY8_DRAIN: D18.2 (A), K8.2, Q8.3 (D)
/17 | Valve outputs 5-8/RLY8_GATE: Q8.1 (G), R208.2, R218.1
/17 | Valve outputs 5-8/VALVE5_CLAMP: D35.1 (K), D45.1 (K)
/17 | Valve outputs 5-8/VALVE6_CLAMP: D36.1 (K), D46.1 (K)
/17 | Valve outputs 5-8/VALVE7_CLAMP: D37.1 (K), D47.1 (K)
/17 | Valve outputs 5-8/VALVE8_CLAMP: D38.1 (K), D48.1 (K)
GND: Q5.2 (S), Q6.2 (S), Q7.2 (S), Q8.2 (S), R215.2, R216.2, R217.2, R218.2; also elsewhere on the board
RLY5_CMD: R205.1; also elsewhere on the board
RLY6_CMD: R206.1; also elsewhere on the board
RLY7_CMD: R207.1; also elsewhere on the board
RLY8_CMD: R208.1; also elsewhere on the board
VALVE5_COM: J35.1, K5.1
VALVE5_NC_AUX: J35.3, K5.3
VALVE5_NO: D45.2 (A), J35.2, J45.1, K5.4
VALVE5_RETURN: D35.2 (A), J45.2
VALVE6_COM: J36.1, K6.1
VALVE6_NC_AUX: J36.3, K6.3
VALVE6_NO: D46.2 (A), J36.2, J46.1, K6.4
VALVE6_RETURN: D36.2 (A), J46.2
VALVE7_COM: J37.1, K7.1
VALVE7_NC_AUX: J37.3, K7.3
VALVE7_NO: D47.2 (A), J37.2, J47.1, K7.4
VALVE7_RETURN: D37.2 (A), J47.2
VALVE8_COM: J38.1, K8.1
VALVE8_NC_AUX: J38.3, K8.3
VALVE8_NO: D48.2 (A), J38.2, J48.1, K8.4
VALVE8_RETURN: D38.2 (A), J48.2

Notes on the sheet:
UNIVERSAL POOFER CONTROL | 17 | Valve outputs 5-8
REV A.3 | Dry contacts | Latched hardware stop | Buffered expansion
VALVE 5 | NO OUTPUT
12 VDC / 1 A; fast release clamps; NC auxiliary
VALVE 6 | NO OUTPUT
VALVE 7 | NO OUTPUT
VALVE 8 | NO OUTPUT

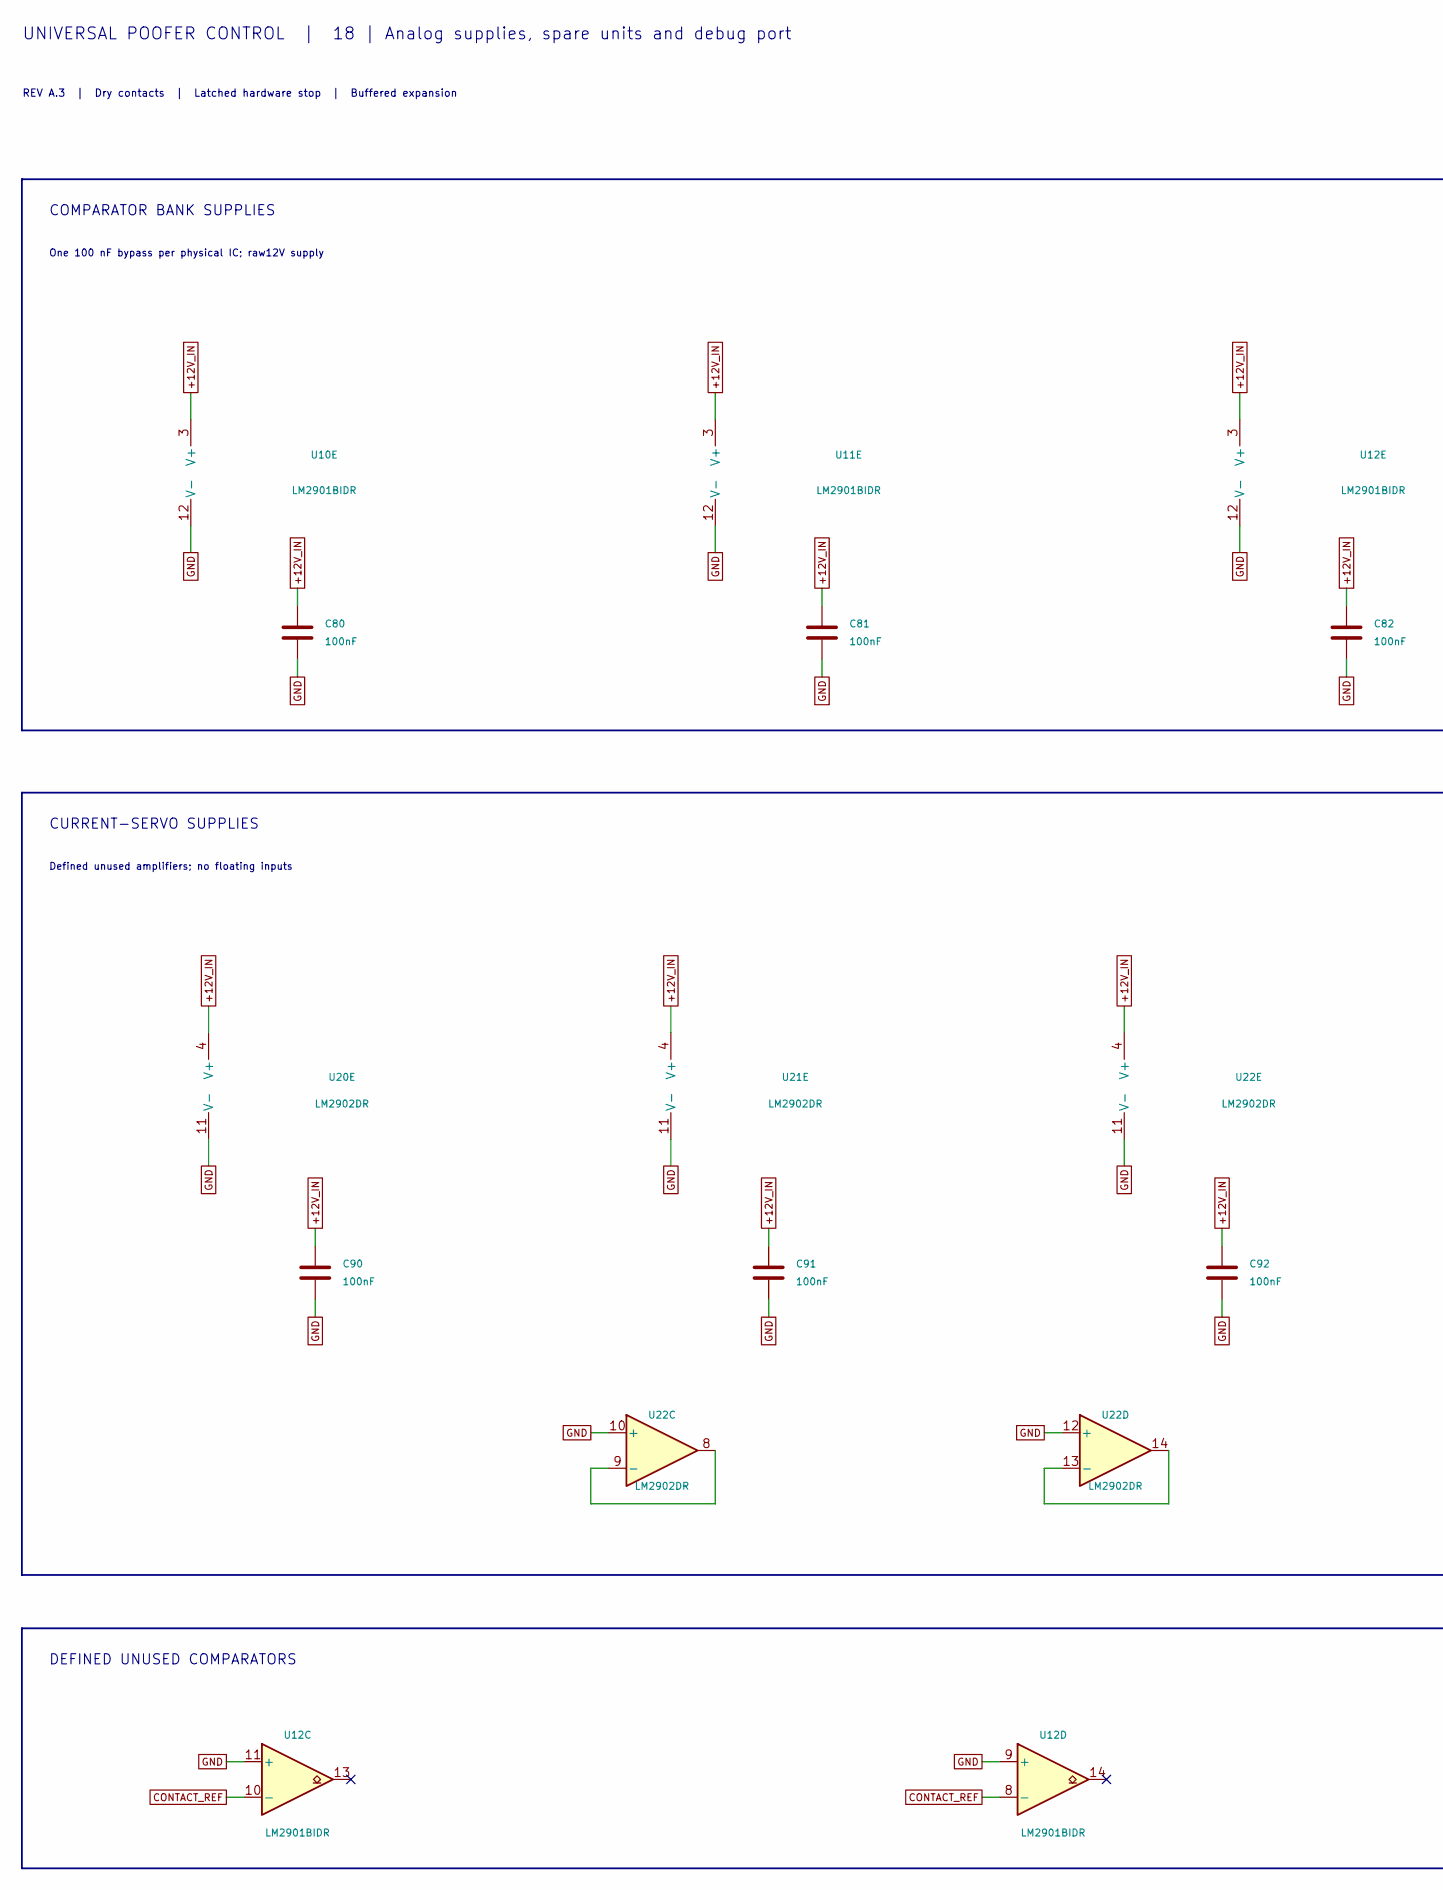
[picture p63: schematic Analog_Support.kicad_sch, 18 | Analog supplies, spare units and debug port, part in row 1, column 1]

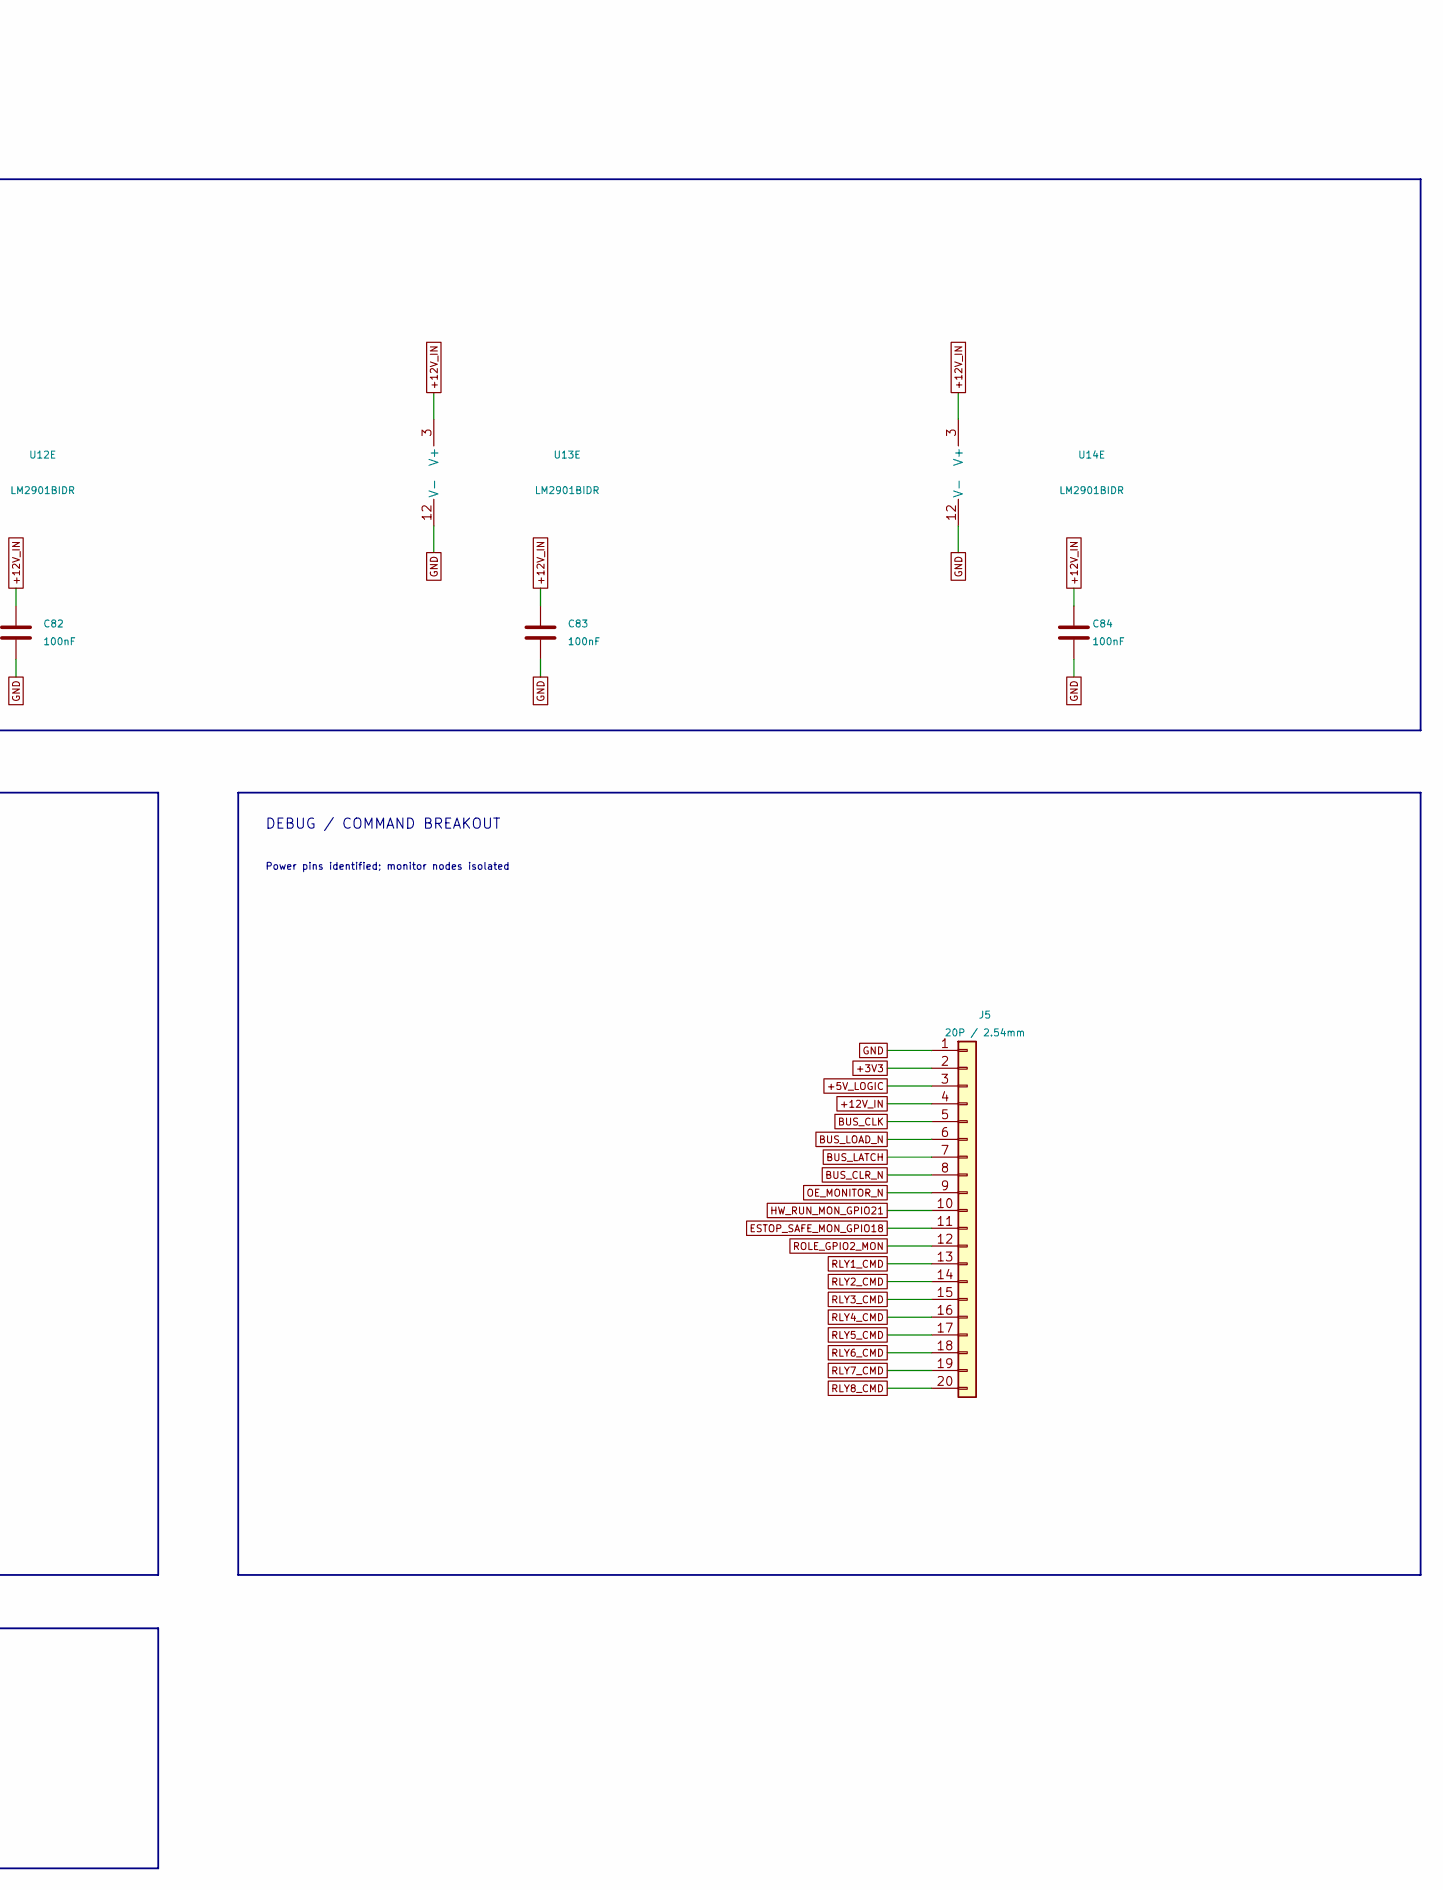
[picture p64: schematic Analog_Support.kicad_sch, 18 | Analog supplies, spare units and debug port, part in row 1, column 2]

Parts:
C80, C81, C82, C83, C84, C90, C91, C92: 100nF; C_0805_2012Metric; MPN CC0805KRX7R9BB104; LCSC C49678
J5: 20P / 2.54mm; PinHeader_1x20_P2.54mm_Vertical; MPN 2.54-1*20P; LCSC C50981
U10, U11, U12, U13, U14: LM2901BIDR; SOIC-14_3.9x8.7mm_P1.27mm; MPN LM2901BIDR; LCSC C22427890
U20, U21, U22: LM2902DR; SOIC-14_3.9x8.7mm_P1.27mm; MPN LM2902DR; LCSC C350545

Connections:
+3V3: J5.2; also elsewhere on the board
+5V_LOGIC: J5.3; also elsewhere on the board
+12V_IN: C80.1, C81.1, C82.1, C83.1, C84.1, C90.1, C91.1, C92.1, J5.4, U10.3 (V+), U11.3 (V+), U12.3 (V+), U13.3 (V+), U14.3 (V+), U20.4 (V+), U21.4 (V+), U22.4 (V+); also elsewhere on the board
BUS_CLK: J5.5; also elsewhere on the board
BUS_CLR_N: J5.8; also elsewhere on the board
BUS_LATCH: J5.7; also elsewhere on the board
BUS_LOAD_N: J5.6; also elsewhere on the board
CONTACT_REF: U12.8 (-), U12.10 (-); also elsewhere on the board
ESTOP_SAFE_MON_GPIO18: J5.11; also elsewhere on the board
GND: C80.2, C81.2, C82.2, C83.2, C84.2, C90.2, C91.2, C92.2, J5.1, U10.12 (V-), U11.12 (V-), U12.9 (+), U12.11 (+), U12.12 (V-), U13.12 (V-), U14.12 (V-), U20.11 (V-), U21.11 (V-), U22.10 (+), U22.11 (V-), U22.12 (+); also elsewhere on the board
HW_RUN_MON_GPIO21: J5.10; also elsewhere on the board
unnamed: U22.8, U22.9 (-)
unnamed: U22.13 (-), U22.14
OE_MONITOR_N: J5.9; also elsewhere on the board
RLY1_CMD: J5.13; also elsewhere on the board
RLY2_CMD: J5.14; also elsewhere on the board
RLY3_CMD: J5.15; also elsewhere on the board
RLY4_CMD: J5.16; also elsewhere on the board
RLY5_CMD: J5.17; also elsewhere on the board
RLY6_CMD: J5.18; also elsewhere on the board
RLY7_CMD: J5.19; also elsewhere on the board
RLY8_CMD: J5.20; also elsewhere on the board
ROLE_GPIO2_MON: J5.12; also elsewhere on the board

Notes on the sheet:
UNIVERSAL POOFER CONTROL | 18 | Analog supplies, spare units and debug port
REV A.3 | Dry contacts | Latched hardware stop | Buffered expansion
COMPARATOR BANK SUPPLIES
One 100 nF bypass per physical IC; raw12V supply
CURRENT-SERVO SUPPLIES
Defined unused amplifiers; no floating inputs
DEBUG / COMMAND BREAKOUT
Power pins identified; monitor nodes isolated
DEFINED UNUSED COMPARATORS

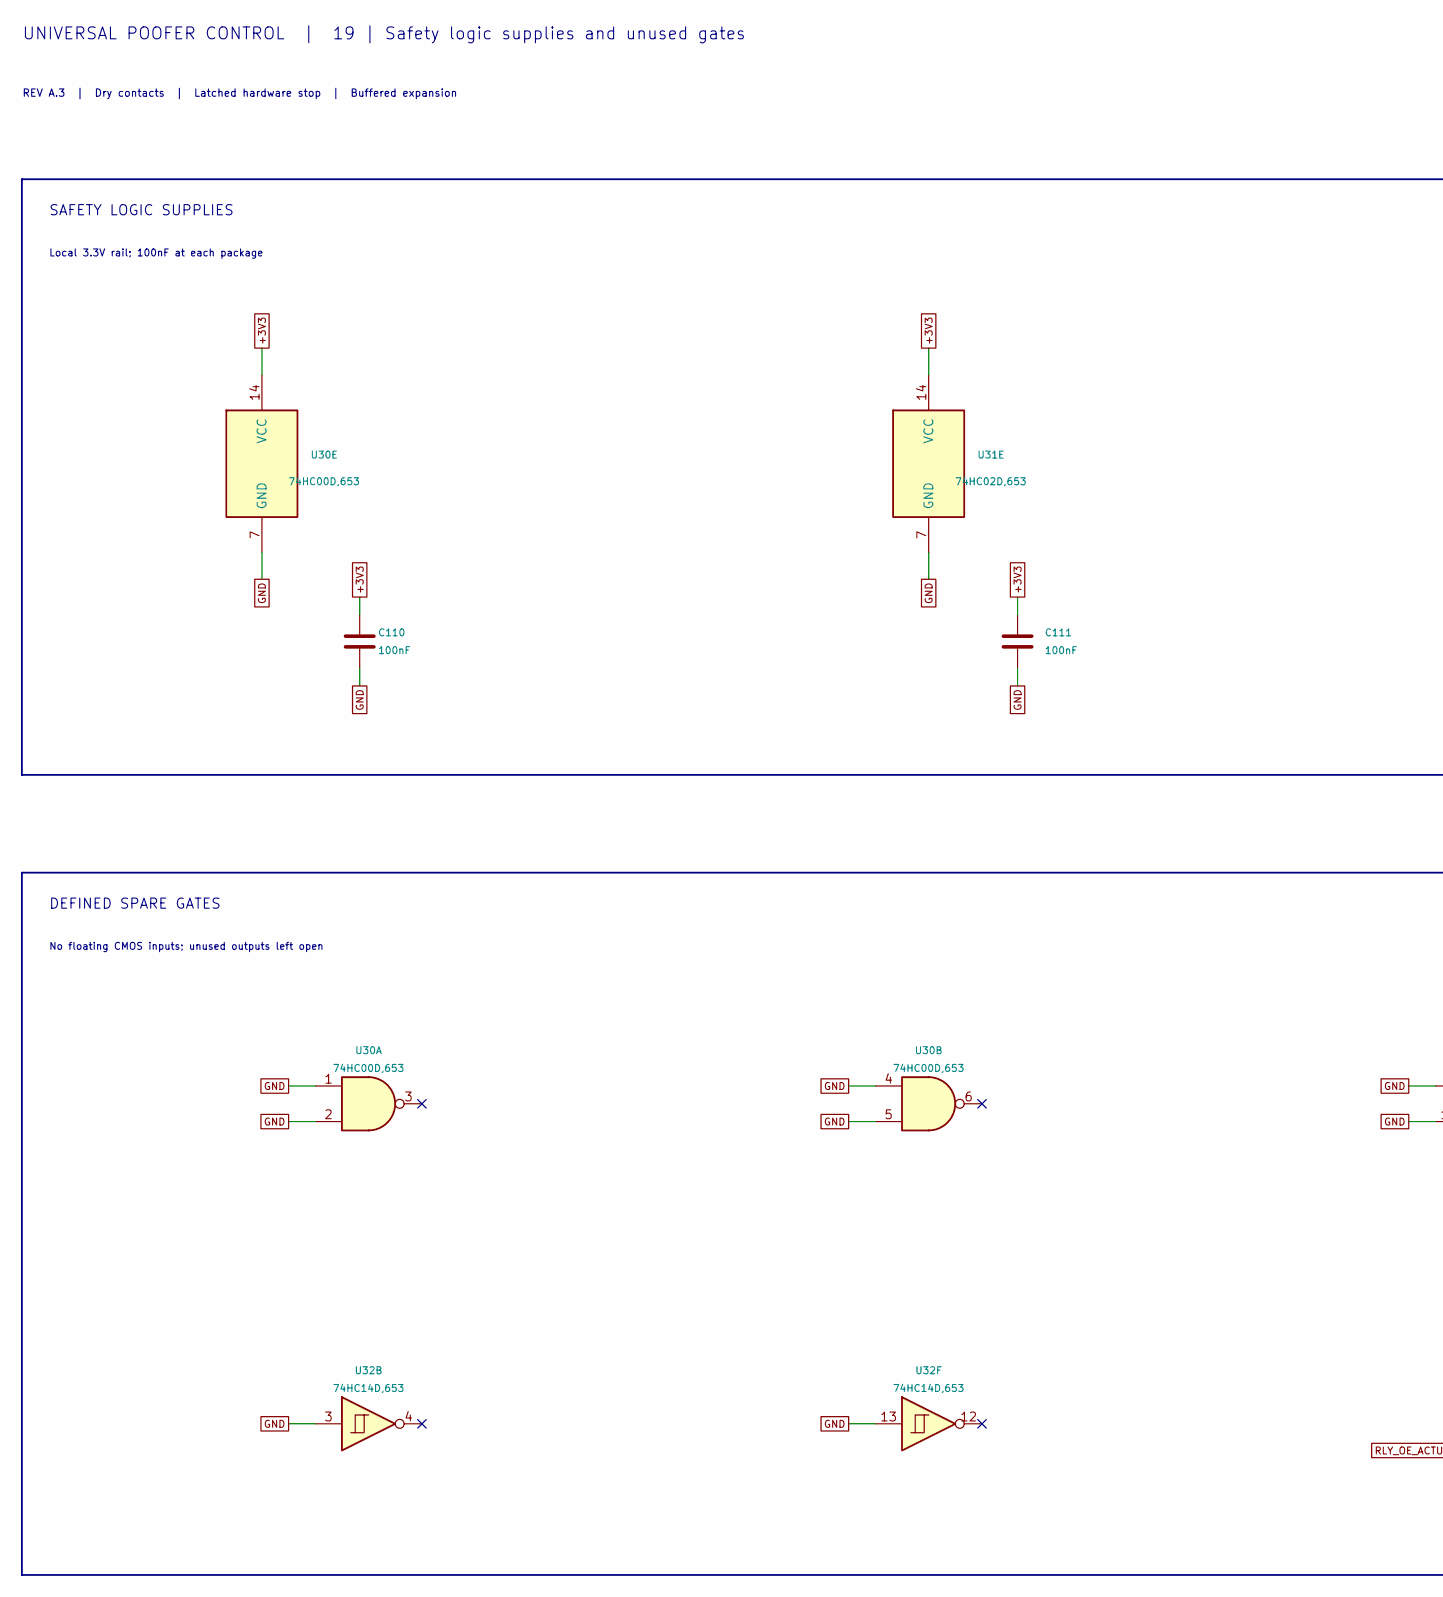
[picture p65: schematic Logic_Support.kicad_sch, 19 | Safety logic supplies and unused gates, part in row 1, column 1]

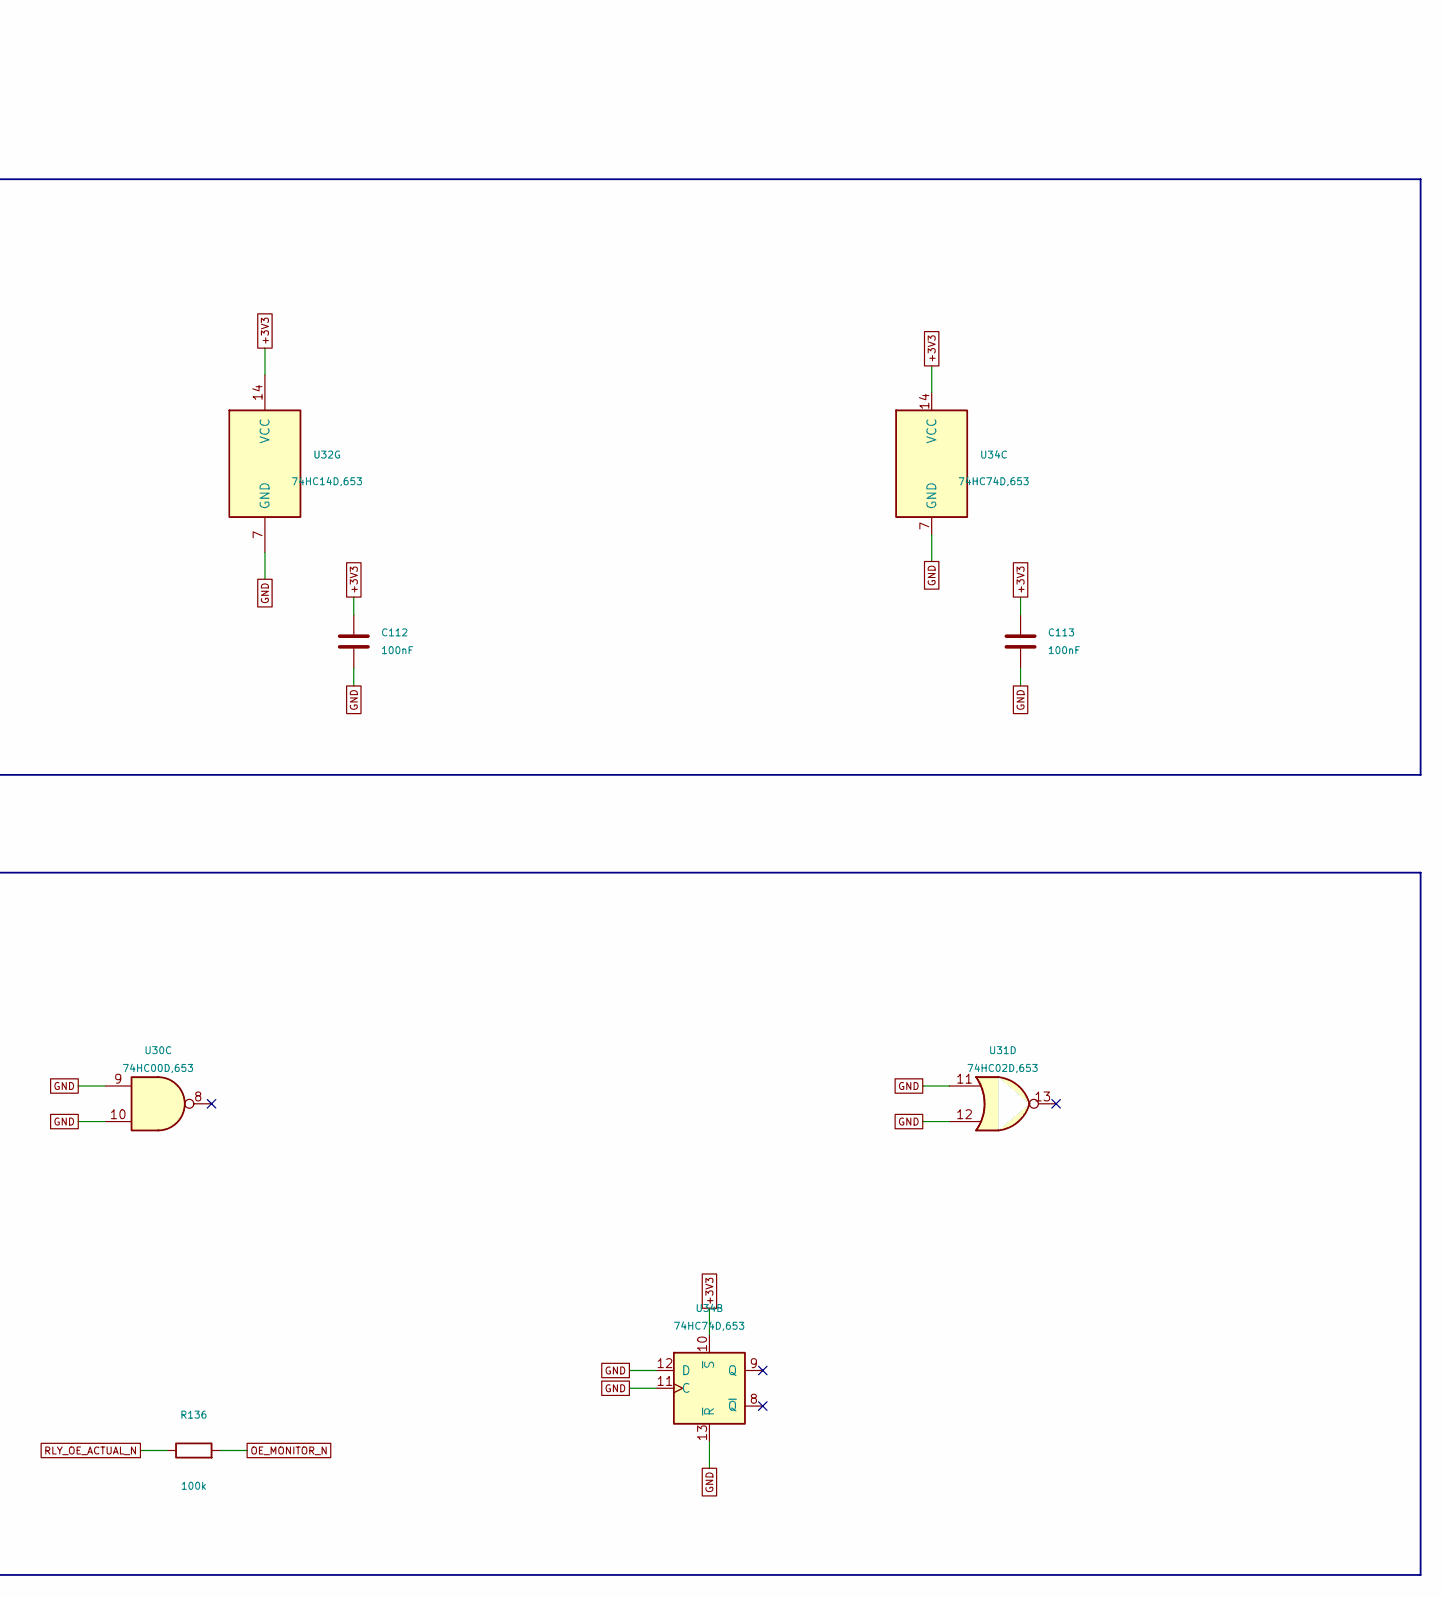
[picture p66: schematic Logic_Support.kicad_sch, 19 | Safety logic supplies and unused gates, part in row 1, column 2]

Parts:
C110, C111, C112, C113: 100nF; C_0805_2012Metric; MPN CC0805KRX7R9BB104; LCSC C49678
R136: 100k; R_0805_2012Metric; MPN 0805W8F1003T5E; LCSC C149504
U30: 74HC00D,653; SOIC-14_3.9x8.7mm_P1.27mm; MPN 74HC00D,653; LCSC C5586
U31: 74HC02D,653; SOIC-14_3.9x8.7mm_P1.27mm; MPN 74HC02D,653; LCSC C5588
U32: 74HC14D,653; SOIC-14_3.9x8.7mm_P1.27mm; MPN 74HC14D,653; LCSC C5605
U34: 74HC74D,653; SOIC-14_3.9x8.7mm_P1.27mm; MPN 74HC74D,653; LCSC C27597

Connections:
+3V3: C110.1, C111.1, C112.1, C113.1, U30.14 (VCC), U31.14 (VCC), U32.14 (VCC), U34.10 (~S), U34.14 (VCC); also elsewhere on the board
GND: C110.2, C111.2, C112.2, C113.2, U30.1, U30.2, U30.4, U30.5, U30.7 (GND), U30.9, U30.10, U31.7 (GND), U31.11, U31.12, U32.3, U32.7 (GND), U32.13, U34.7 (GND), U34.11 (C), U34.12 (D), U34.13 (~R); also elsewhere on the board
OE_MONITOR_N: R136.2; also elsewhere on the board
RLY_OE_ACTUAL_N: R136.1; also elsewhere on the board

Notes on the sheet:
UNIVERSAL POOFER CONTROL | 19 | Safety logic supplies and unused gates
REV A.3 | Dry contacts | Latched hardware stop | Buffered expansion
SAFETY LOGIC SUPPLIES
Local 3.3V rail; 100nF at each package
DEFINED SPARE GATES
No floating CMOS inputs; unused outputs left open

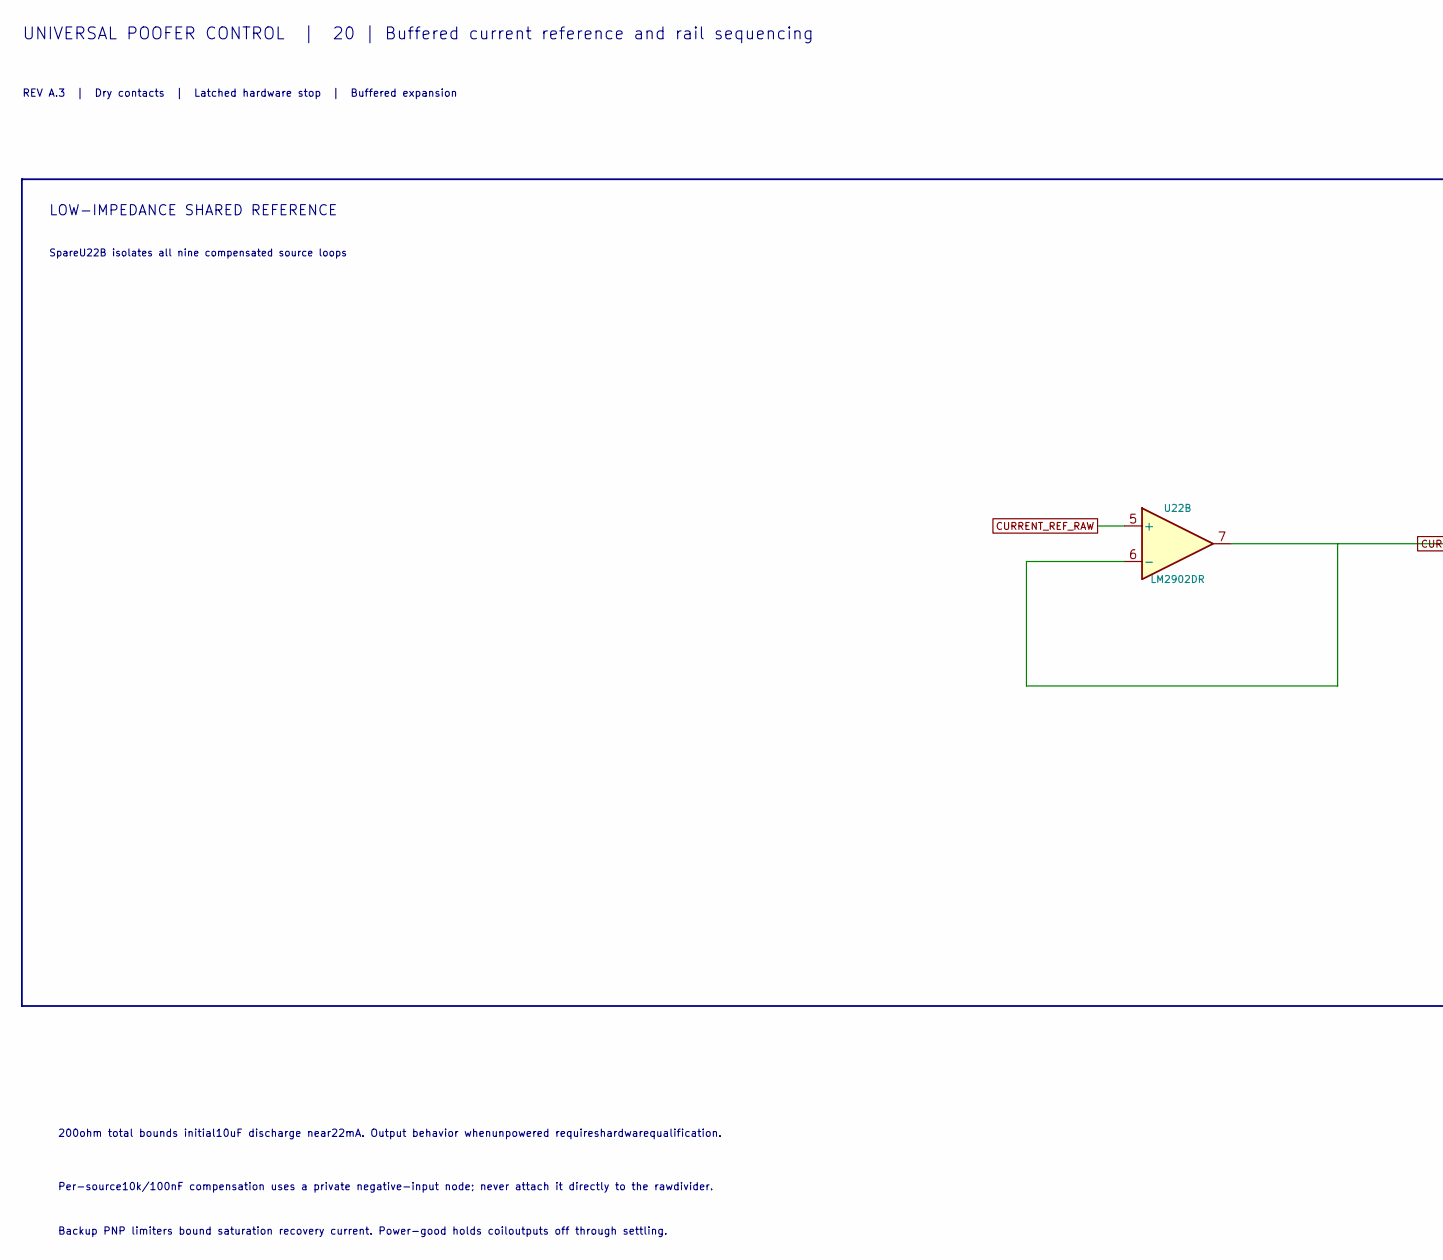
[picture p67: schematic Current_Reference.kicad_sch, 20 | Buffered current reference and rail sequencing, part in row 1, column 1]

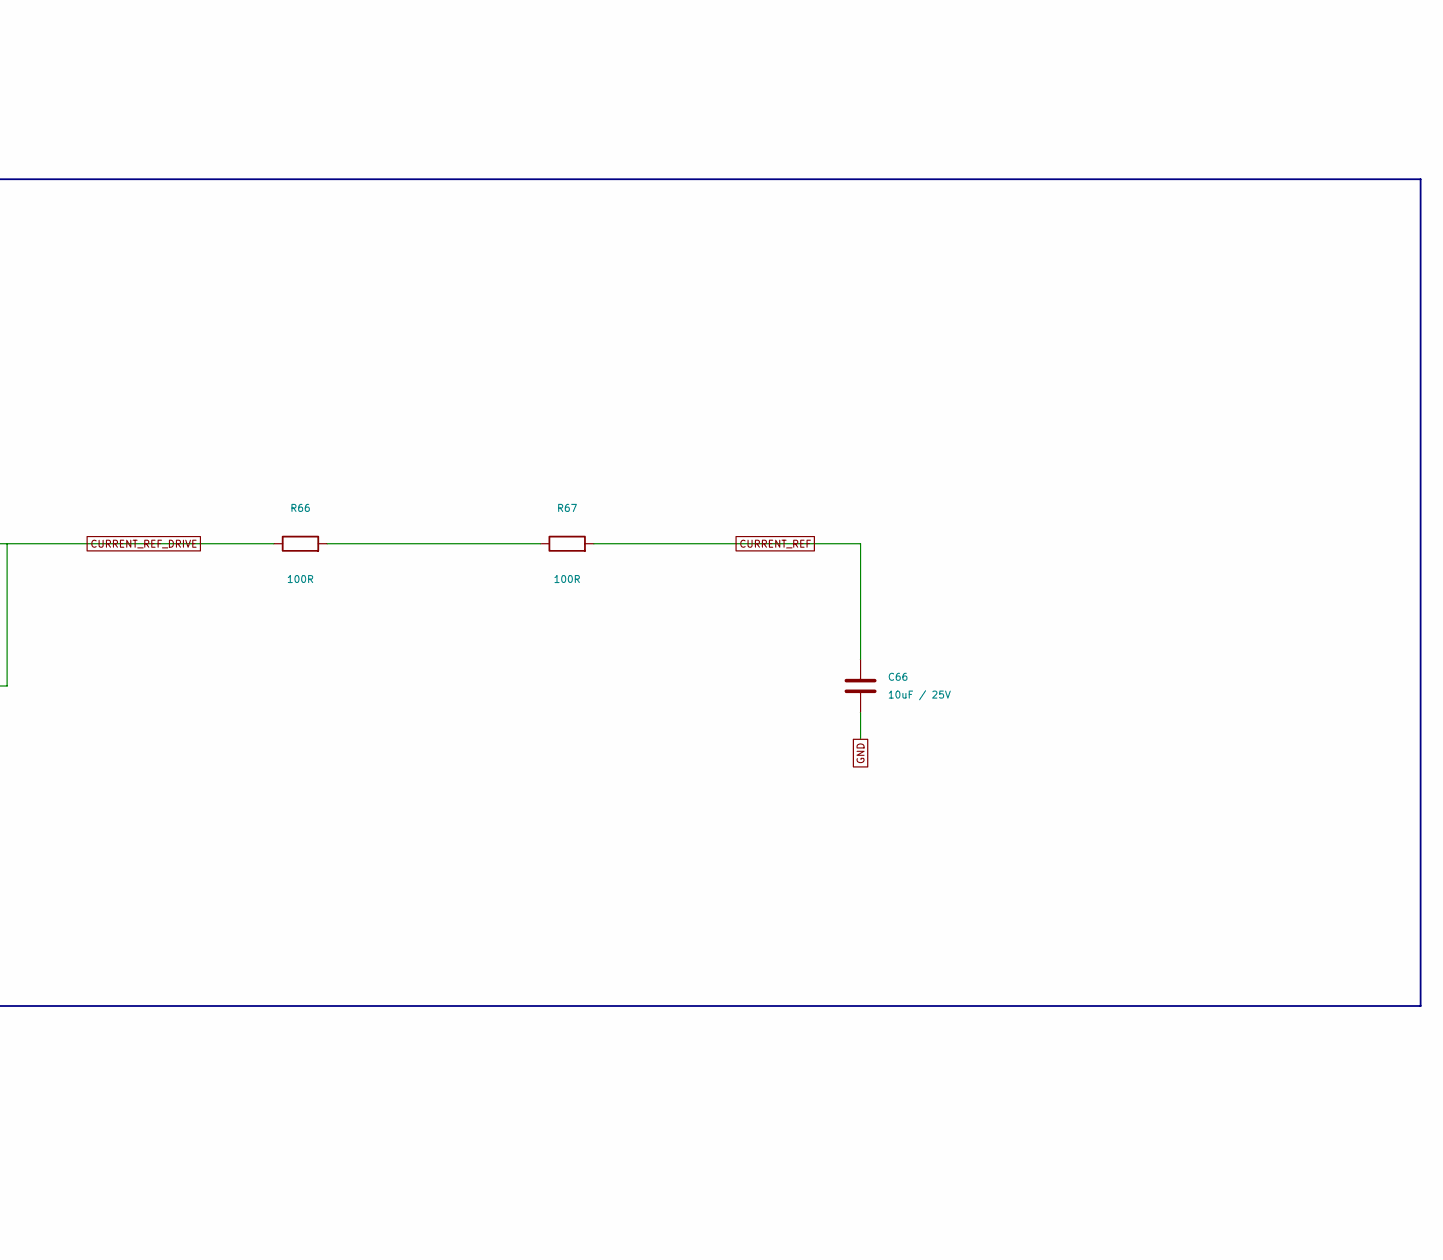
[picture p68: schematic Current_Reference.kicad_sch, 20 | Buffered current reference and rail sequencing, part in row 1, column 2]

Parts:
C66: 10uF / 25V; C_0805_2012Metric; MPN CL21A106KAYNNNE; LCSC C15850
R66, R67: 100R; R_0805_2012Metric; MPN 0805W8F1000T5E; LCSC C17408
U22: LM2902DR; SOIC-14_3.9x8.7mm_P1.27mm; MPN LM2902DR; LCSC C350545

Connections:
CURRENT_REF: C66.1, R67.2; also elsewhere on the board
CURRENT_REF_DRIVE: R66.1, U22.6 (-), U22.7
CURRENT_REF_RAW: U22.5 (+); also elsewhere on the board
GND: C66.2; also elsewhere on the board
unnamed: R66.2, R67.1

Notes on the sheet:
UNIVERSAL POOFER CONTROL | 20 | Buffered current reference and rail sequencing
REV A.3 | Dry contacts | Latched hardware stop | Buffered expansion
LOW-IMPEDANCE SHARED REFERENCE
SpareU22B isolates all nine compensated source loops
200ohm total bounds initial10uF discharge near22mA. Output behavior whenunpowered requireshardwarequalification.
Per-source10k/100nF compensation uses a private negative-input node; never attach it directly to the rawdivider.
Backup PNP limiters bound saturation recovery current. Power-good holds coiloutputs off through settling.
