NOVA-Cluster/Universal-Poofer-Control/Universal_Poofer_Control.kicad_pcb

## KiCad design Universal_Poofer_Control.kicad_pcb (continued)

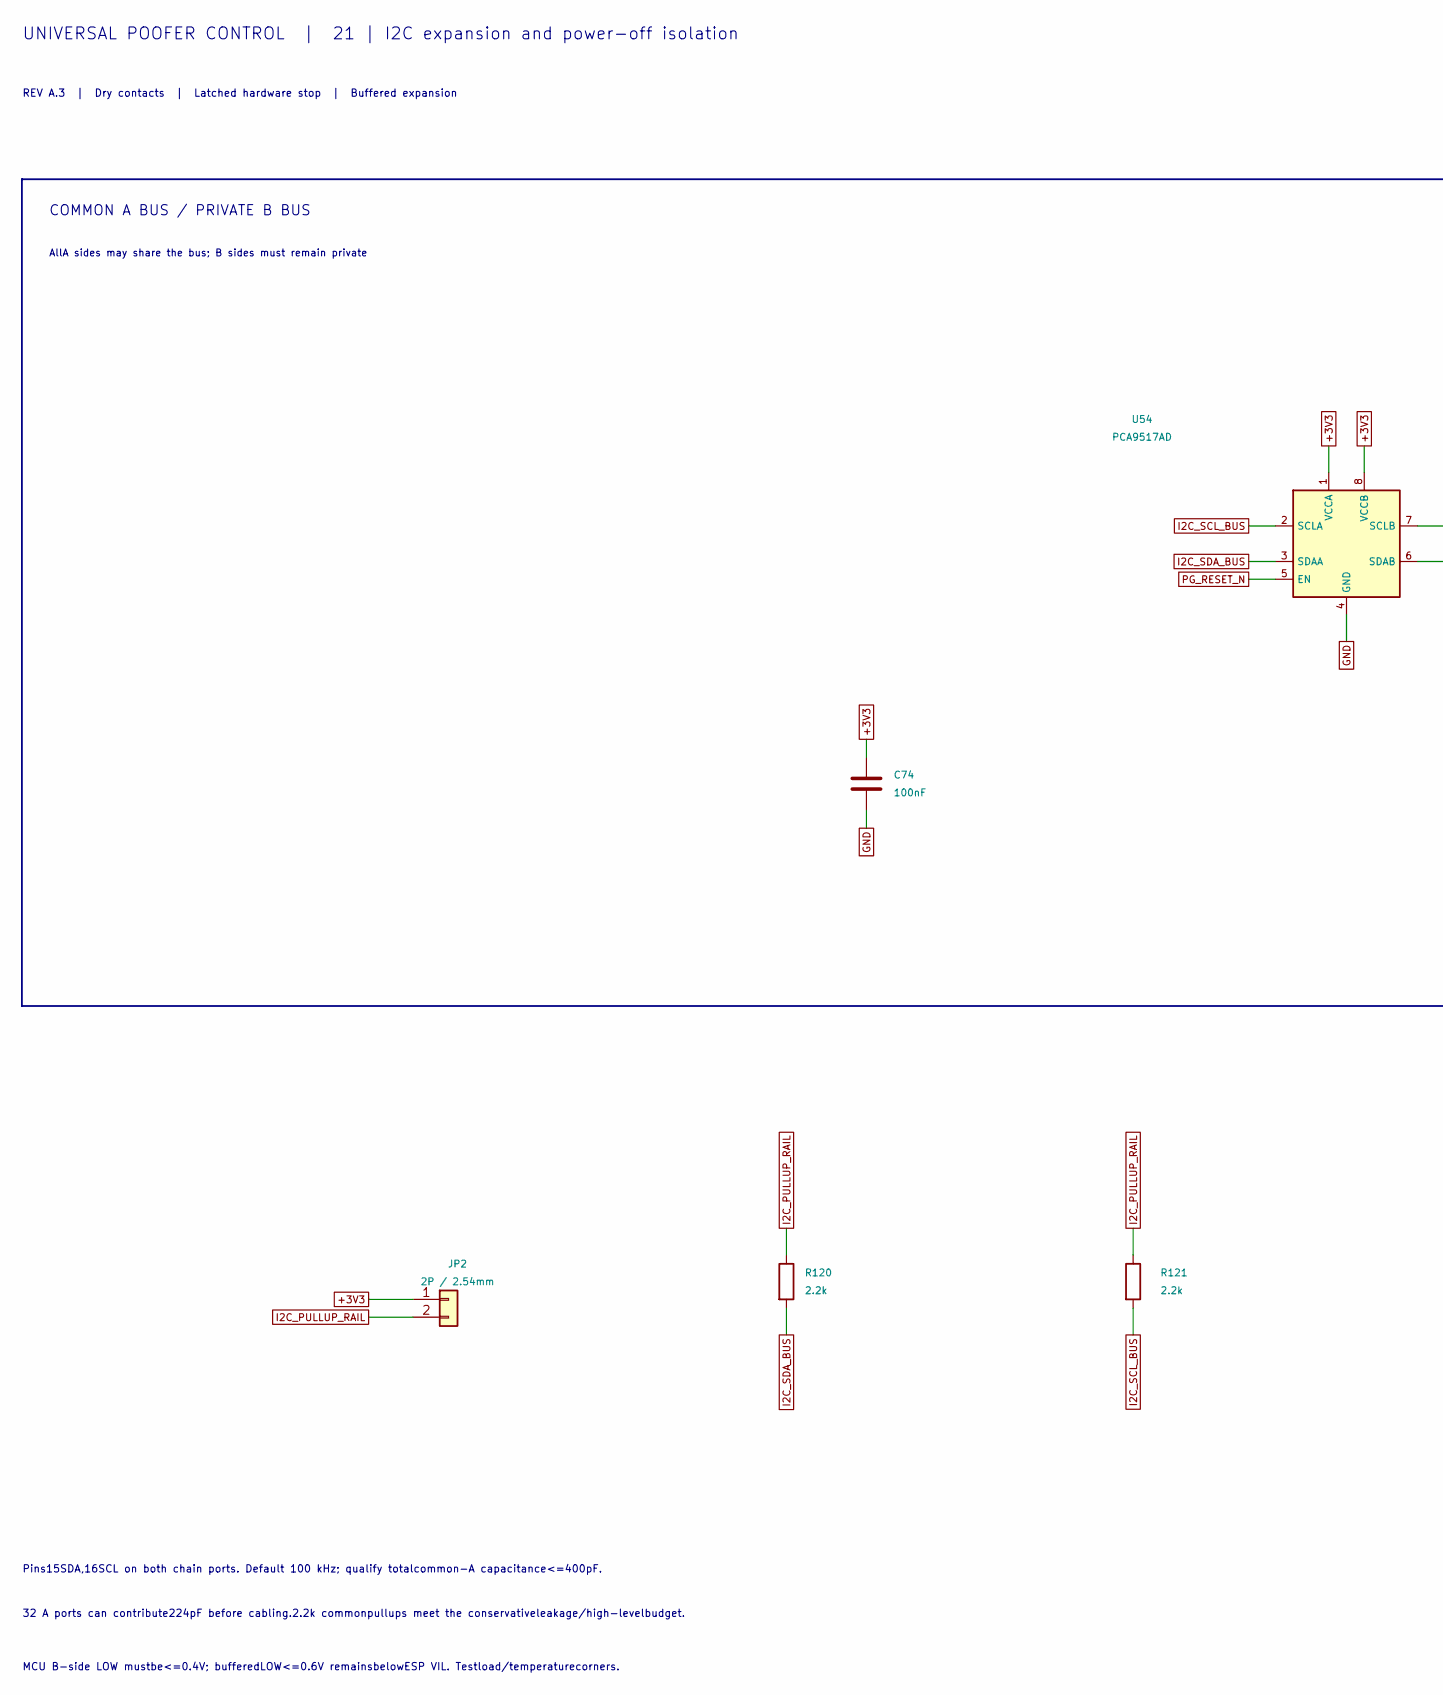
[picture p69: schematic I2C_Expansion.kicad_sch, 21 | I2C expansion and power-off isolation, part in row 1, column 1]

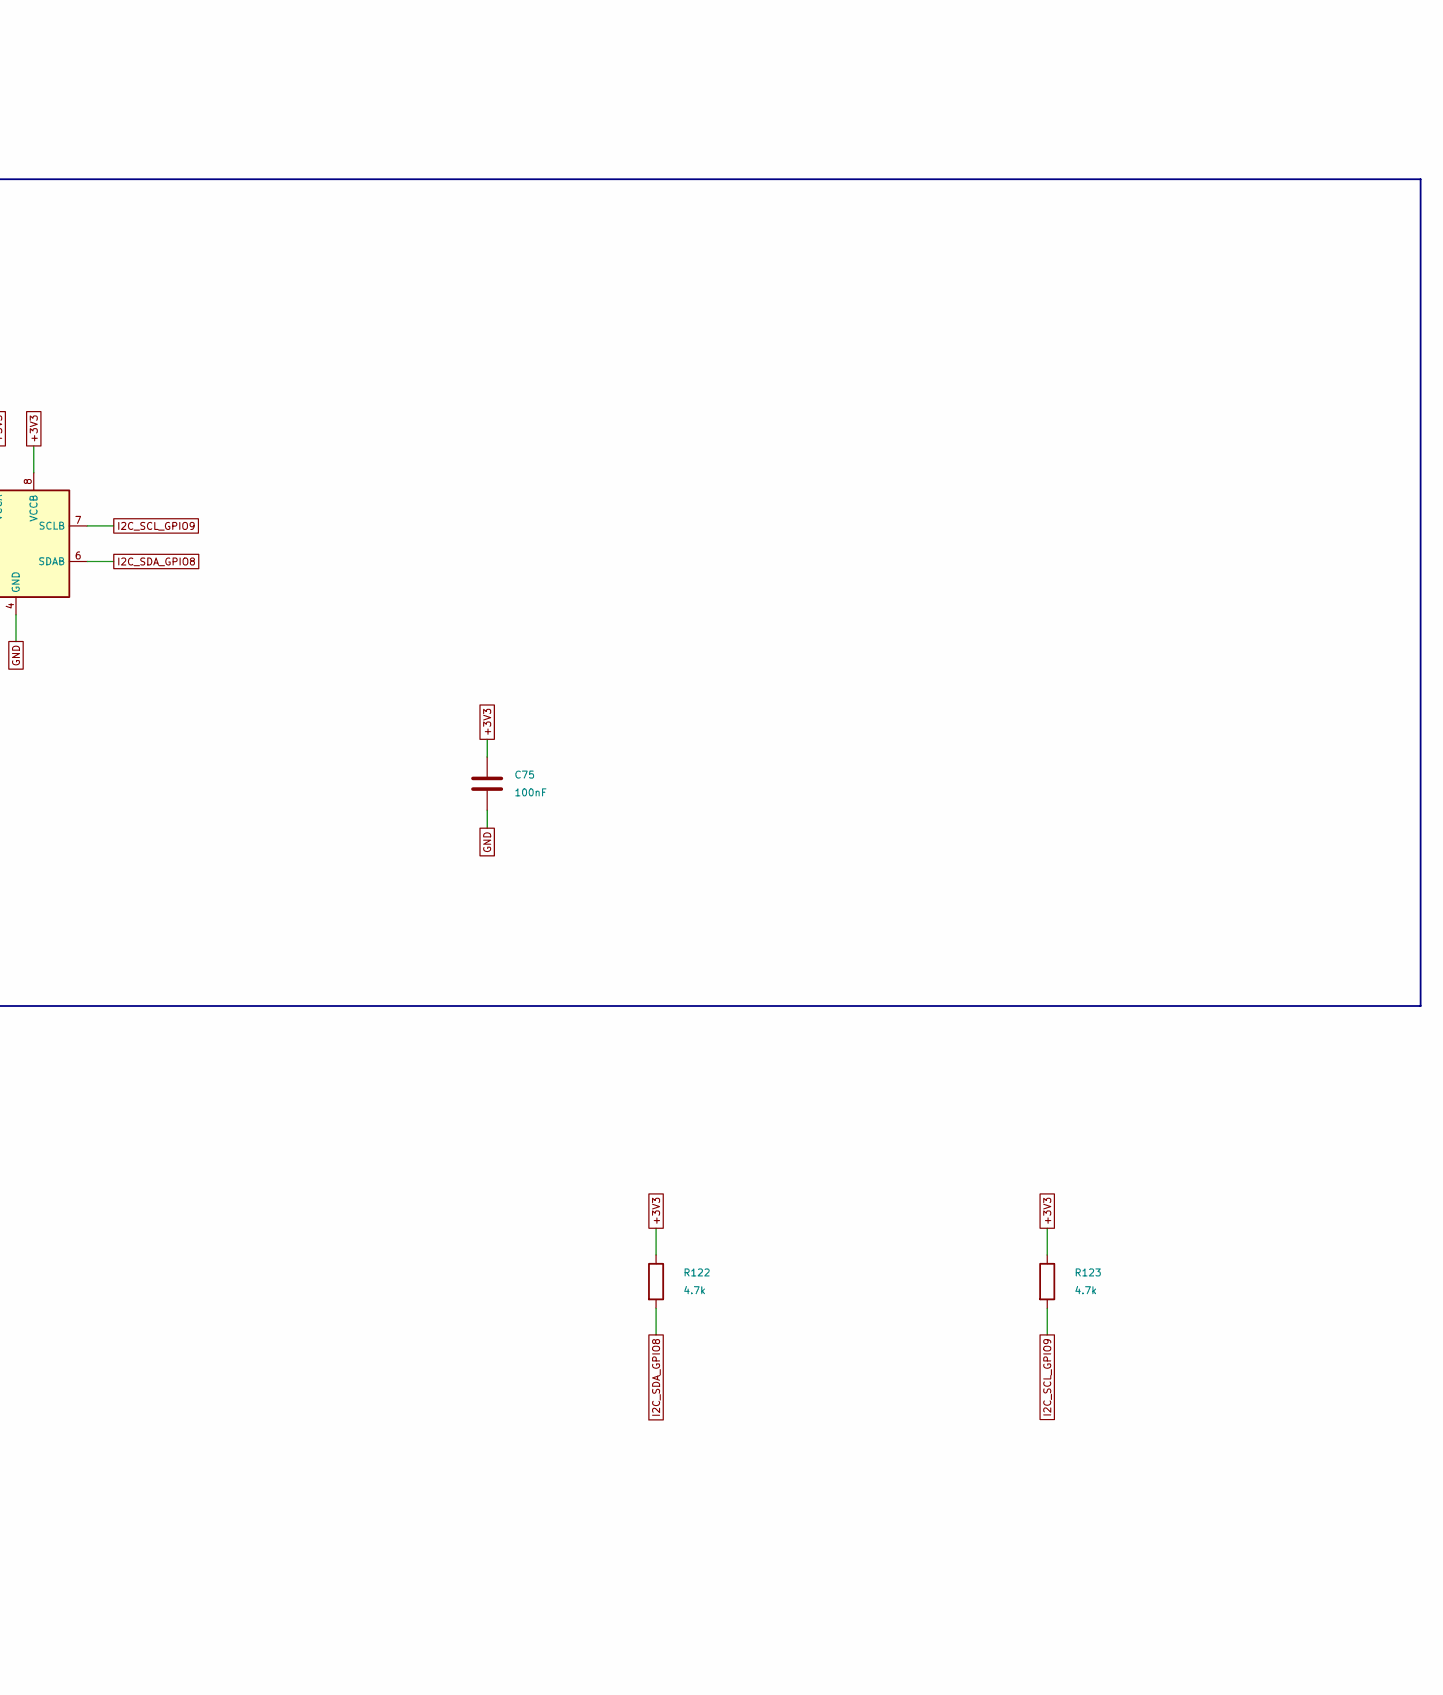
[picture p70: schematic I2C_Expansion.kicad_sch, 21 | I2C expansion and power-off isolation, part in row 1, column 2]

Parts:
C74, C75: 100nF; C_0805_2012Metric; MPN CC0805KRX7R9BB104; LCSC C49678
JP2: 2P / 2.54mm; PinHeader_1x02_P2.54mm_Vertical; MPN B-2100S02P-A110; LCSC C124375
R120, R121: 2.2k; R_0805_2012Metric; MPN 0805W8F2201T5E; LCSC C17520
R122, R123: 4.7k; R_0805_2012Metric; MPN 0805W8F4701T5E; LCSC C17673
U54: PCA9517AD; SOIC-8_3.9x4.9mm_P1.27mm; MPN PCA9517AD,118; LCSC C2802638

Connections:
+3V3: C74.1, C75.1, JP2.1, R122.1, R123.1, U54.1 (VCCA), U54.8 (VCCB); also elsewhere on the board
GND: C74.2, C75.2, U54.4 (GND); also elsewhere on the board
I2C_PULLUP_RAIL: JP2.2, R120.1, R121.1
I2C_SCL_BUS: R121.2, U54.2 (SCLA); also elsewhere on the board
I2C_SCL_GPIO9: R123.2, U54.7 (SCLB); also elsewhere on the board
I2C_SDA_BUS: R120.2, U54.3 (SDAA); also elsewhere on the board
I2C_SDA_GPIO8: R122.2, U54.6 (SDAB); also elsewhere on the board
PG_RESET_N: U54.5 (EN); also elsewhere on the board

Notes on the sheet:
UNIVERSAL POOFER CONTROL | 21 | I2C expansion and power-off isolation
REV A.3 | Dry contacts | Latched hardware stop | Buffered expansion
COMMON A BUS / PRIVATE B BUS
AllA sides may share the bus; B sides must remain private
Pins15SDA,16SCL on both chain ports. Default 100 kHz; qualify totalcommon-A capacitance<=400pF.
32 A ports can contribute224pF before cabling.2.2k commonpullups meet the conservativeleakage/high-levelbudget.
MCU B-side LOW mustbe<=0.4V; bufferedLOW<=0.6V remainsbelowESP VIL. Testload/temperaturecorners.

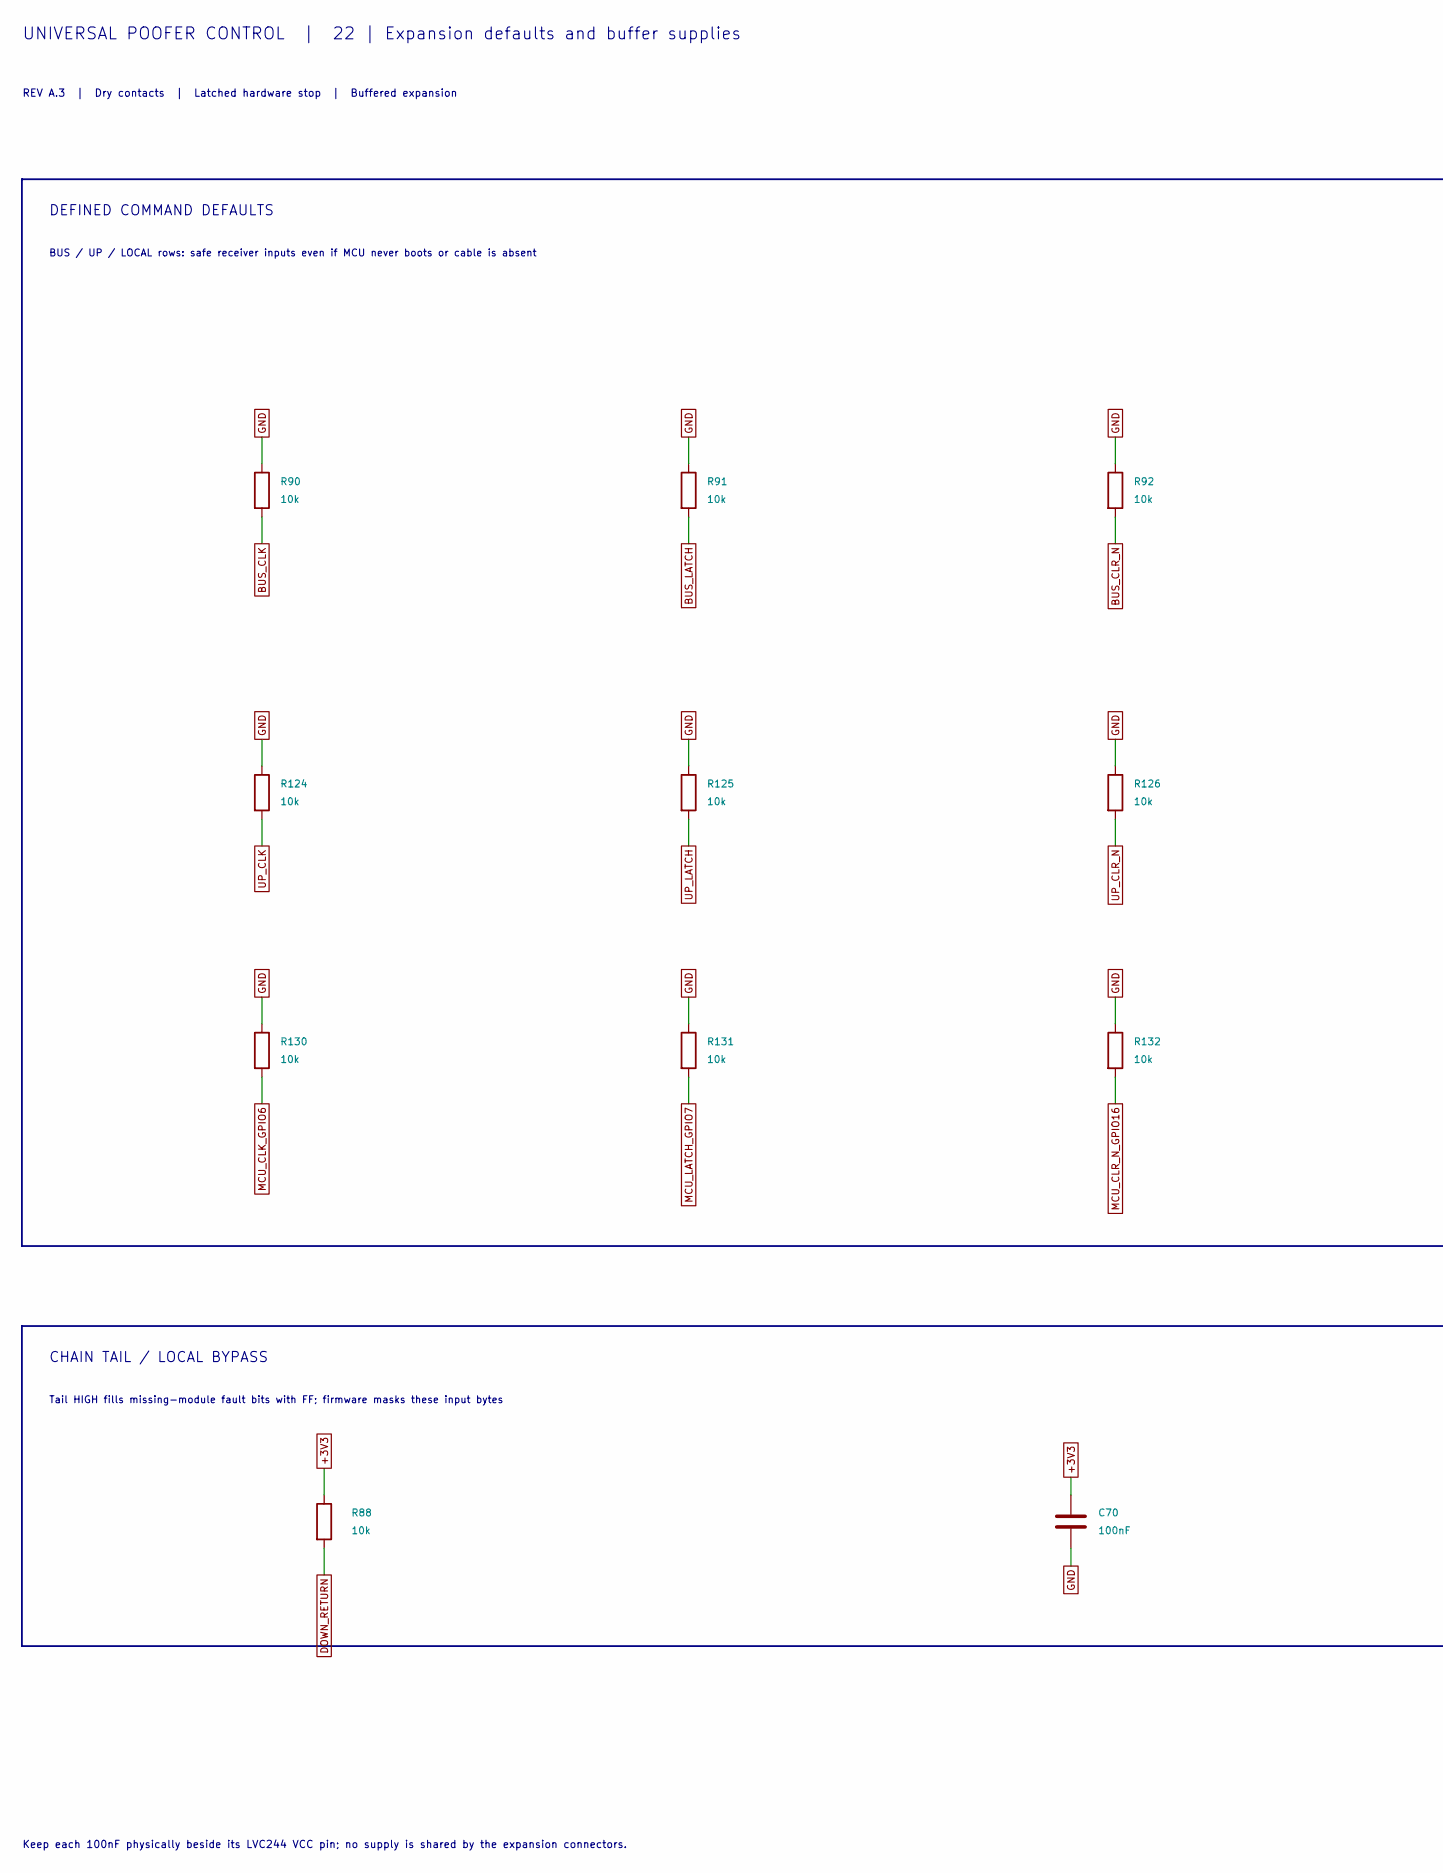
[picture p71: schematic Expansion_Bias.kicad_sch, 22 | Expansion defaults and buffer supplies, part in row 1, column 1]

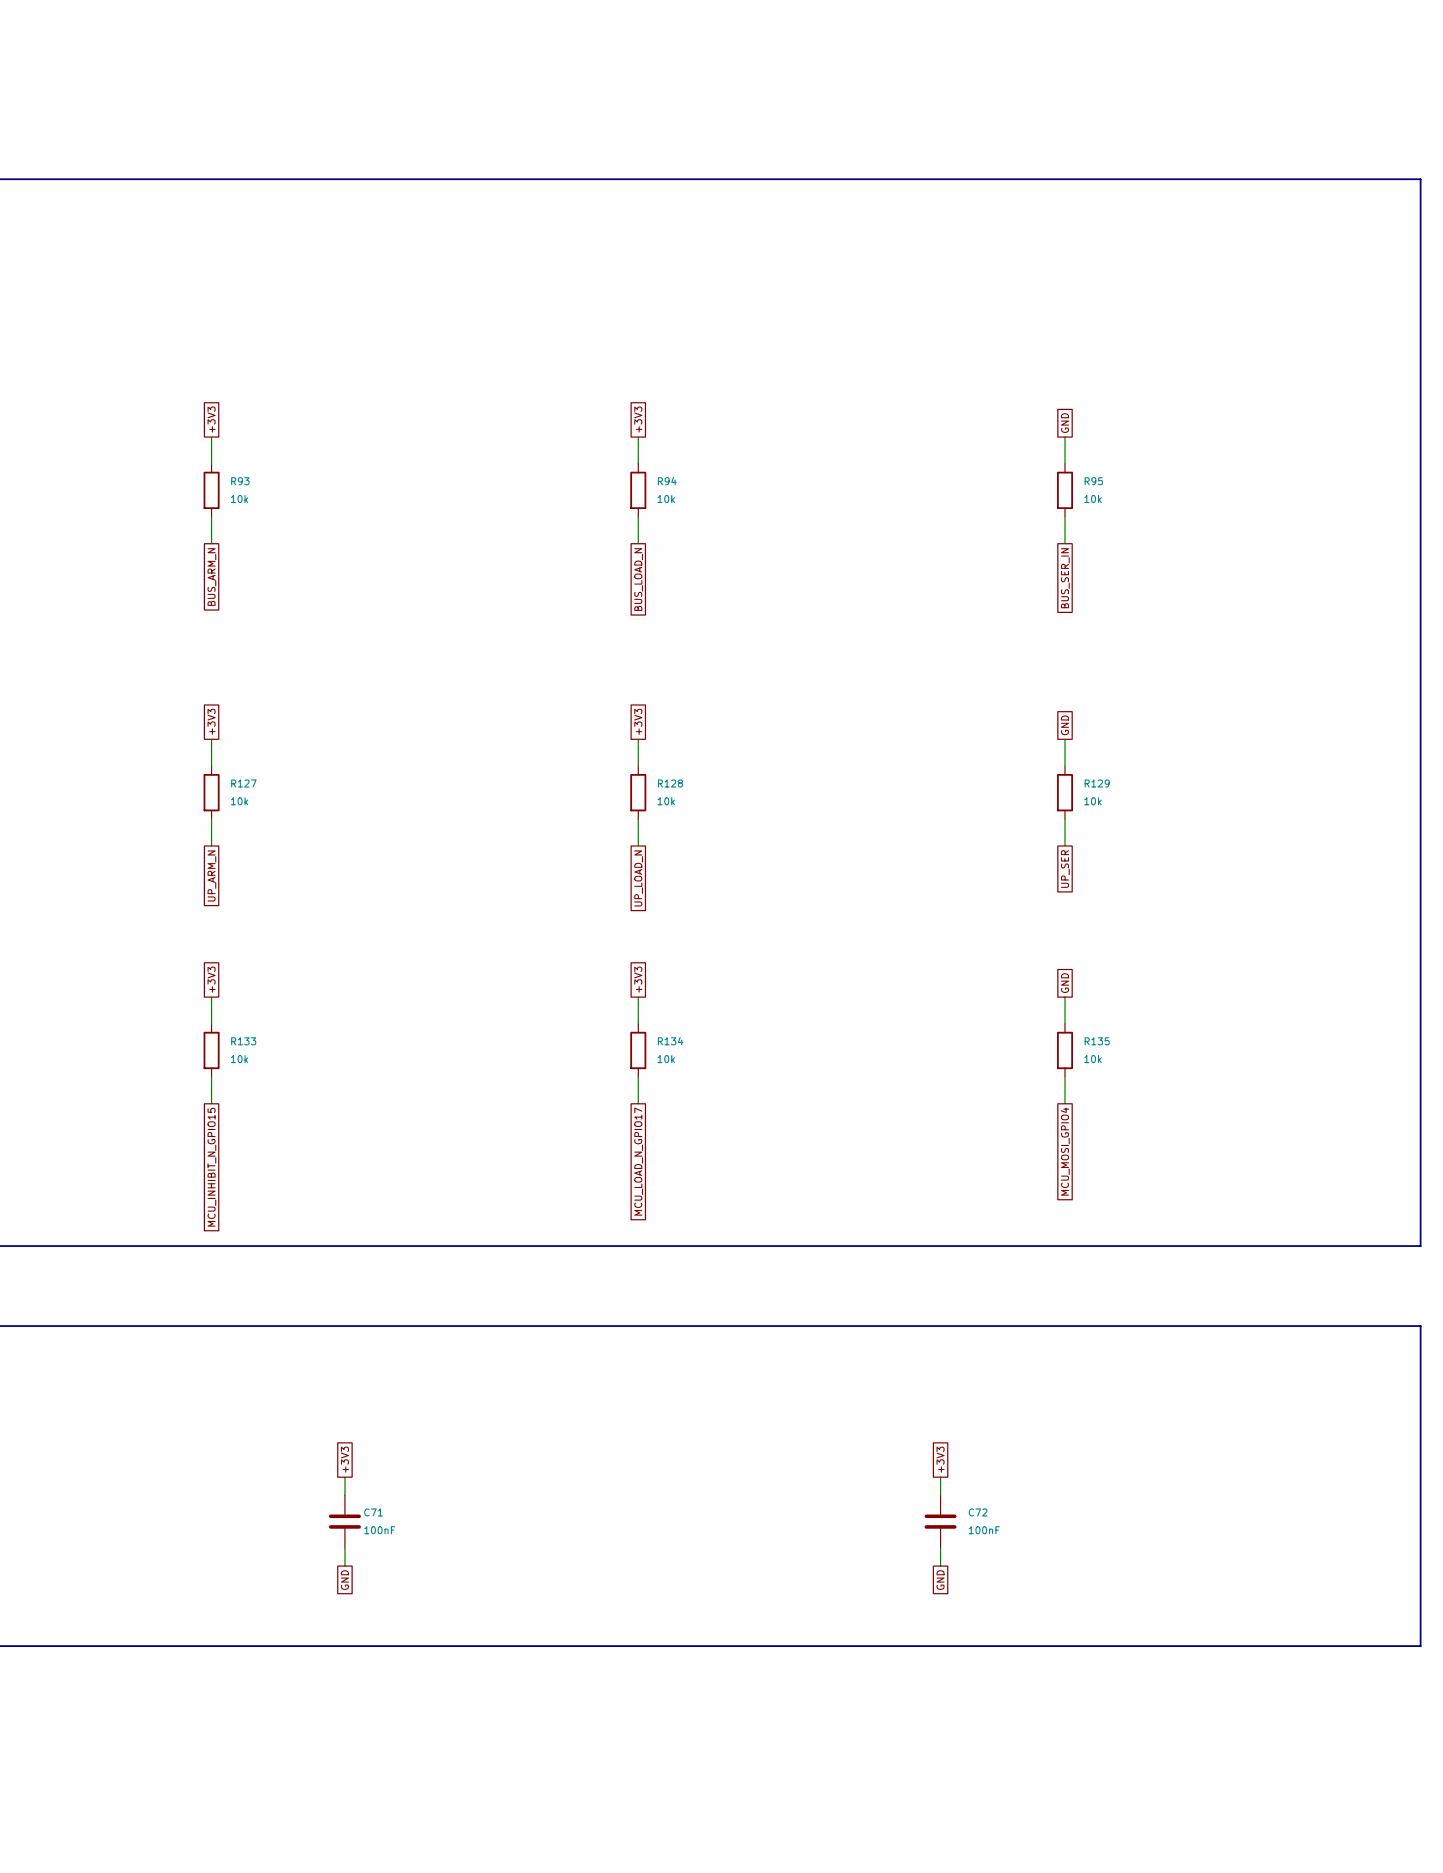
[picture p72: schematic Expansion_Bias.kicad_sch, 22 | Expansion defaults and buffer supplies, part in row 1, column 2]

Parts:
C70, C71, C72: 100nF; C_0805_2012Metric; MPN CC0805KRX7R9BB104; LCSC C49678
R88, R90, R91, R92, R93, R94, R95, R124, R125, R126, R127, R128, R129, R130, R131, R132, R133, R134, R135: 10k; R_0805_2012Metric; MPN 0805W8F1002T5E; LCSC C17414

Connections:
+3V3: C70.1, C71.1, C72.1, R88.1, R93.1, R94.1, R127.1, R128.1, R133.1, R134.1; also elsewhere on the board
BUS_ARM_N: R93.2; also elsewhere on the board
BUS_CLK: R90.2; also elsewhere on the board
BUS_CLR_N: R92.2; also elsewhere on the board
BUS_LATCH: R91.2; also elsewhere on the board
BUS_LOAD_N: R94.2; also elsewhere on the board
BUS_SER_IN: R95.2; also elsewhere on the board
DOWN_RETURN: R88.2; also elsewhere on the board
GND: C70.2, C71.2, C72.2, R90.1, R91.1, R92.1, R95.1, R124.1, R125.1, R126.1, R129.1, R130.1, R131.1, R132.1, R135.1; also elsewhere on the board
MCU_CLK_GPIO6: R130.2; also elsewhere on the board
MCU_CLR_N_GPIO16: R132.2; also elsewhere on the board
MCU_INHIBIT_N_GPIO15: R133.2; also elsewhere on the board
MCU_LATCH_GPIO7: R131.2; also elsewhere on the board
MCU_LOAD_N_GPIO17: R134.2; also elsewhere on the board
MCU_MOSI_GPIO4: R135.2; also elsewhere on the board
UP_ARM_N: R127.2; also elsewhere on the board
UP_CLK: R124.2; also elsewhere on the board
UP_CLR_N: R126.2; also elsewhere on the board
UP_LATCH: R125.2; also elsewhere on the board
UP_LOAD_N: R128.2; also elsewhere on the board
UP_SER: R129.2; also elsewhere on the board

Notes on the sheet:
UNIVERSAL POOFER CONTROL | 22 | Expansion defaults and buffer supplies
REV A.3 | Dry contacts | Latched hardware stop | Buffered expansion
DEFINED COMMAND DEFAULTS
BUS / UP / LOCAL rows: safe receiver inputs even if MCU never boots or cable is absent
CHAIN TAIL / LOCAL BYPASS
Tail HIGH fills missing-module fault bits with FF; firmware masks these input bytes
Keep each 100nF physically beside its LVC244 VCC pin; no supply is shared by the expansion connectors.

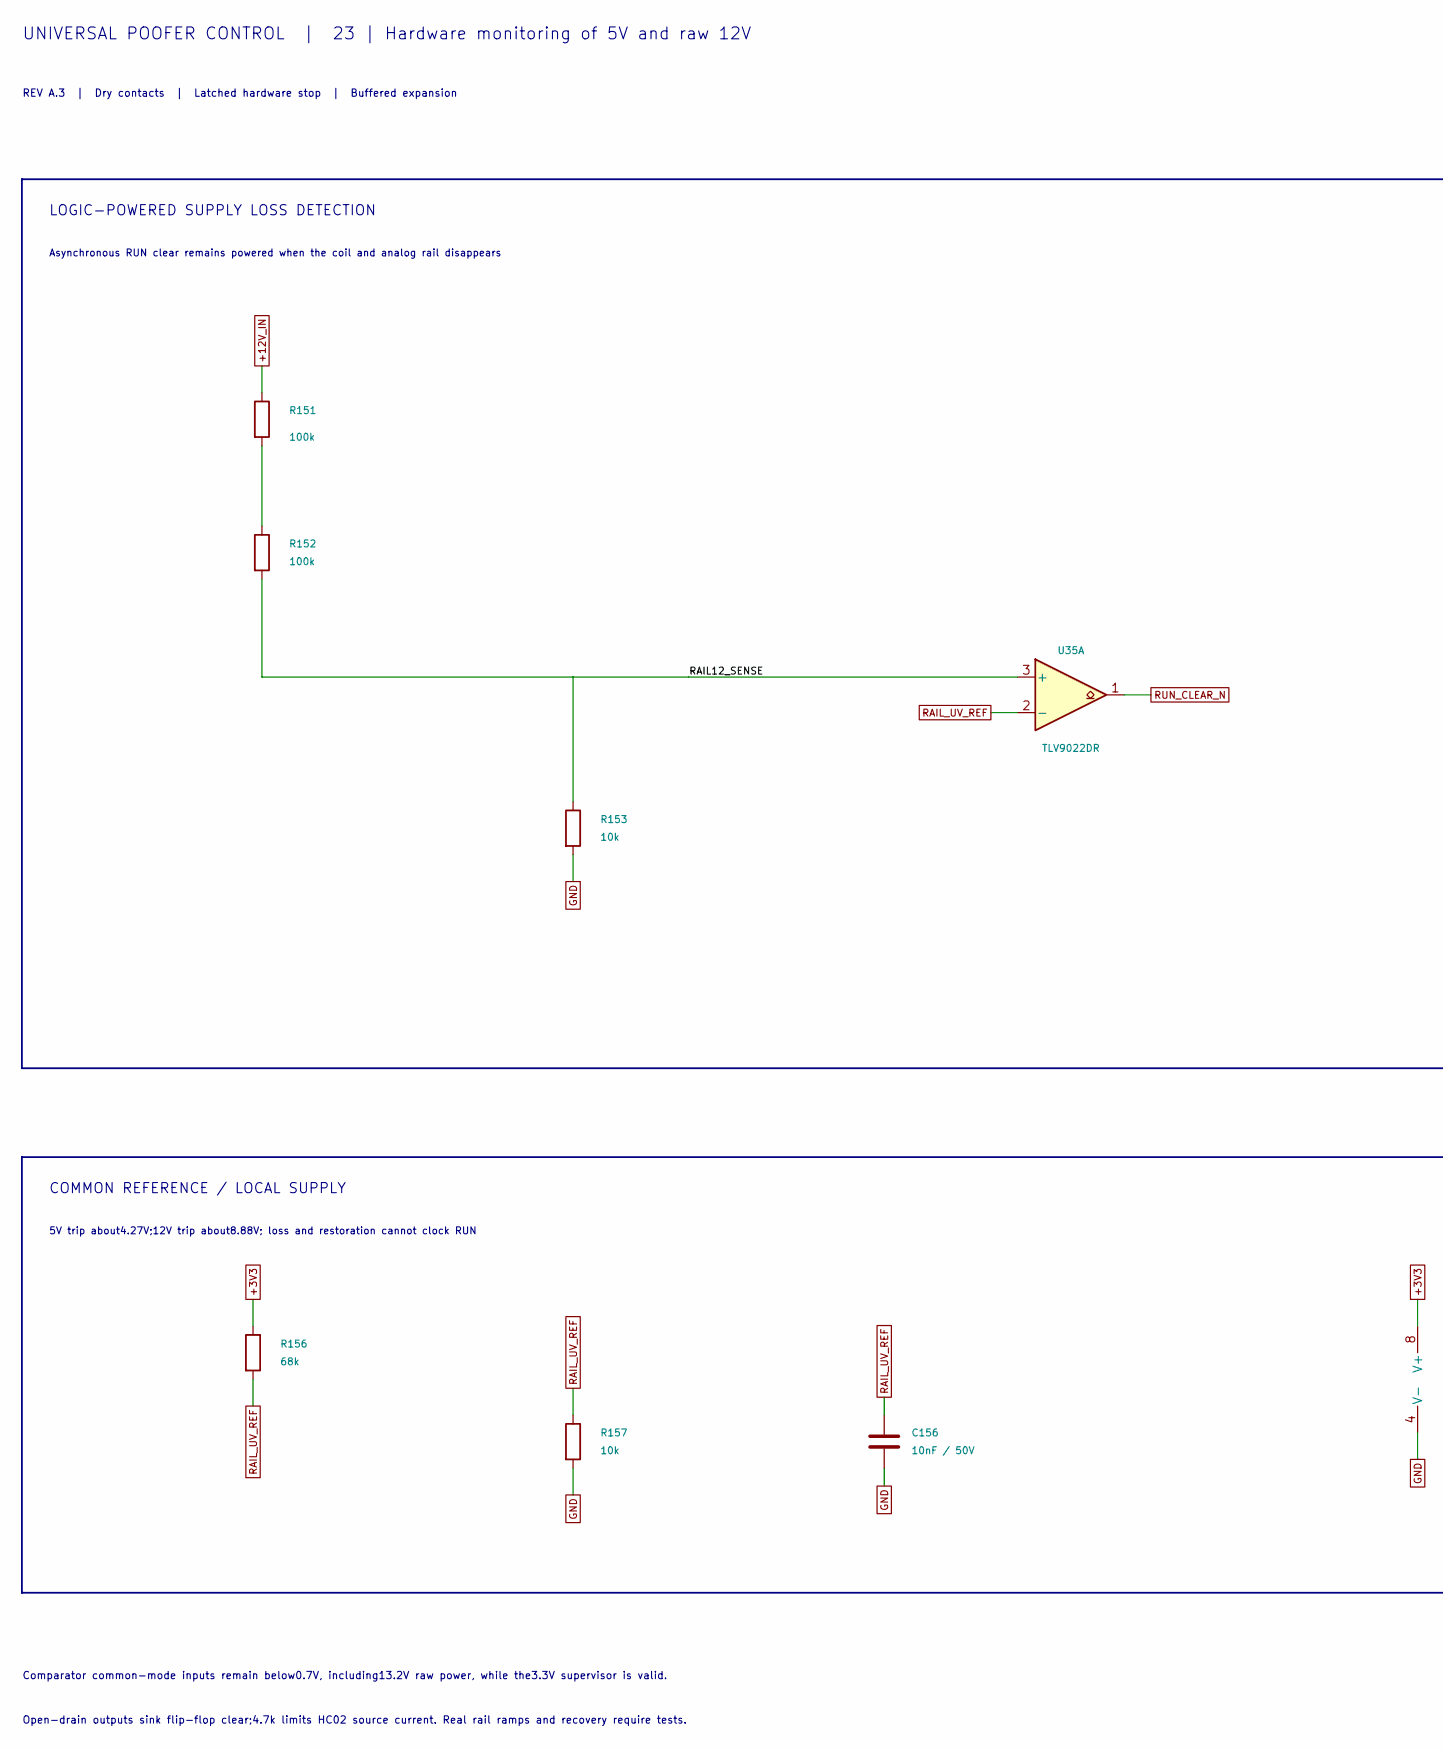
[picture p73: schematic Rail_Supervision.kicad_sch, 23 | Hardware monitoring of 5V and raw 12V, part in row 1, column 1]

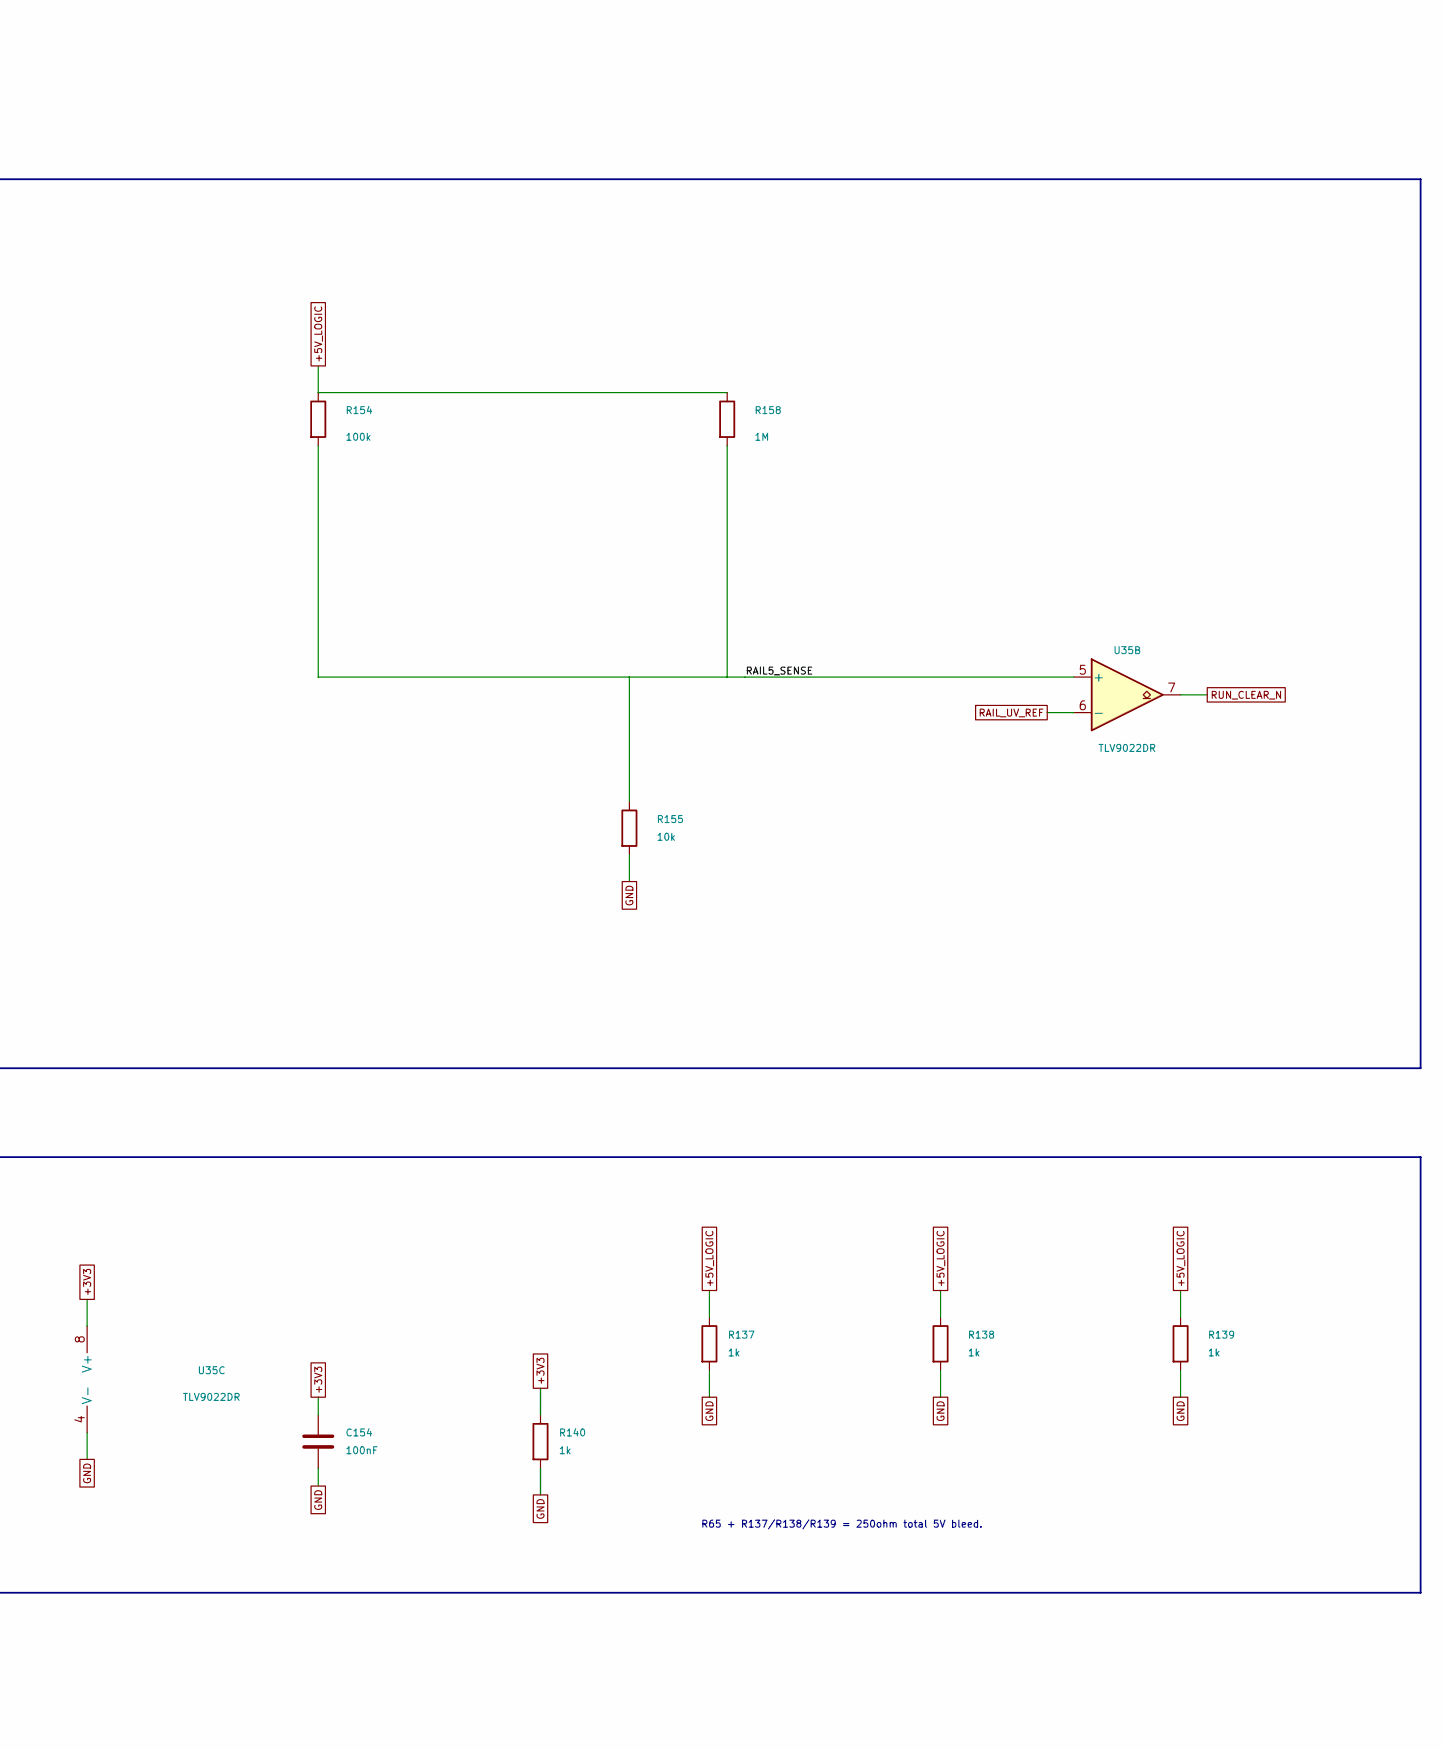
[picture p74: schematic Rail_Supervision.kicad_sch, 23 | Hardware monitoring of 5V and raw 12V, part in row 1, column 2]

Parts:
C154: 100nF; C_0805_2012Metric; MPN CC0805KRX7R9BB104; LCSC C49678
C156: 10nF / 50V; C_0805_2012Metric; MPN CL21B103KBANNNC; LCSC C1710
R137, R138, R139, R140: 1k; R_0805_2012Metric; MPN 0805W8F1001T5E; LCSC C17513
R151, R152, R154: 100k; R_0805_2012Metric; MPN 0805W8F1003T5E; LCSC C149504
R153, R155, R157: 10k; R_0805_2012Metric; MPN 0805W8F1002T5E; LCSC C17414
R156: 68k; R_0805_2012Metric; MPN 0805W8F6802T5E; LCSC C17801
R158: 1M; R_0805_2012Metric; MPN 0805W8F1004T5E; LCSC C17514
U35: TLV9022DR; SOIC-8_3.9x4.9mm_P1.27mm; MPN TLV9022DR; LCSC C2871718

Connections:
+3V3: C154.1, R140.1, R156.1, U35.8 (V+); also elsewhere on the board
+5V_LOGIC: R137.1, R138.1, R139.1, R154.1, R158.1; also elsewhere on the board
+12V_IN: R151.1; also elsewhere on the board
/23 | Hardware monitoring of 5V and raw 12V/RAIL5_SENSE: R154.2, R155.1, R158.2, U35.5 (+)
/23 | Hardware monitoring of 5V and raw 12V/RAIL12_SENSE: R152.2, R153.1, U35.3 (+)
GND: C154.2, C156.2, R137.2, R138.2, R139.2, R140.2, R153.2, R155.2, R157.2, U35.4 (V-); also elsewhere on the board
unnamed: R151.2, R152.1
RAIL_UV_REF: C156.1, R156.2, R157.1, U35.2 (-), U35.6 (-)
RUN_CLEAR_N: U35.1, U35.7; also elsewhere on the board

Notes on the sheet:
UNIVERSAL POOFER CONTROL | 23 | Hardware monitoring of 5V and raw 12V
REV A.3 | Dry contacts | Latched hardware stop | Buffered expansion
LOGIC-POWERED SUPPLY LOSS DETECTION
Asynchronous RUN clear remains powered when the coil and analog rail disappears
COMMON REFERENCE / LOCAL SUPPLY
5V trip about4.27V;12V trip about8.88V; loss and restoration cannot clock RUN
R65 + R137/R138/R139 = 250ohm total 5V bleed.
Comparator common-mode inputs remain below0.7V, including13.2V raw power, while the3.3V supervisor is valid.
Open-drain outputs sink flip-flop clear;4.7k limits HC02 source current. Real rail ramps and recovery require tests.
