NOVA-Cluster/Universal-Poofer-Control/Universal_Poofer_Control.kicad_pcb

## KiCad design Universal_Poofer_Control.kicad_pcb (continued)

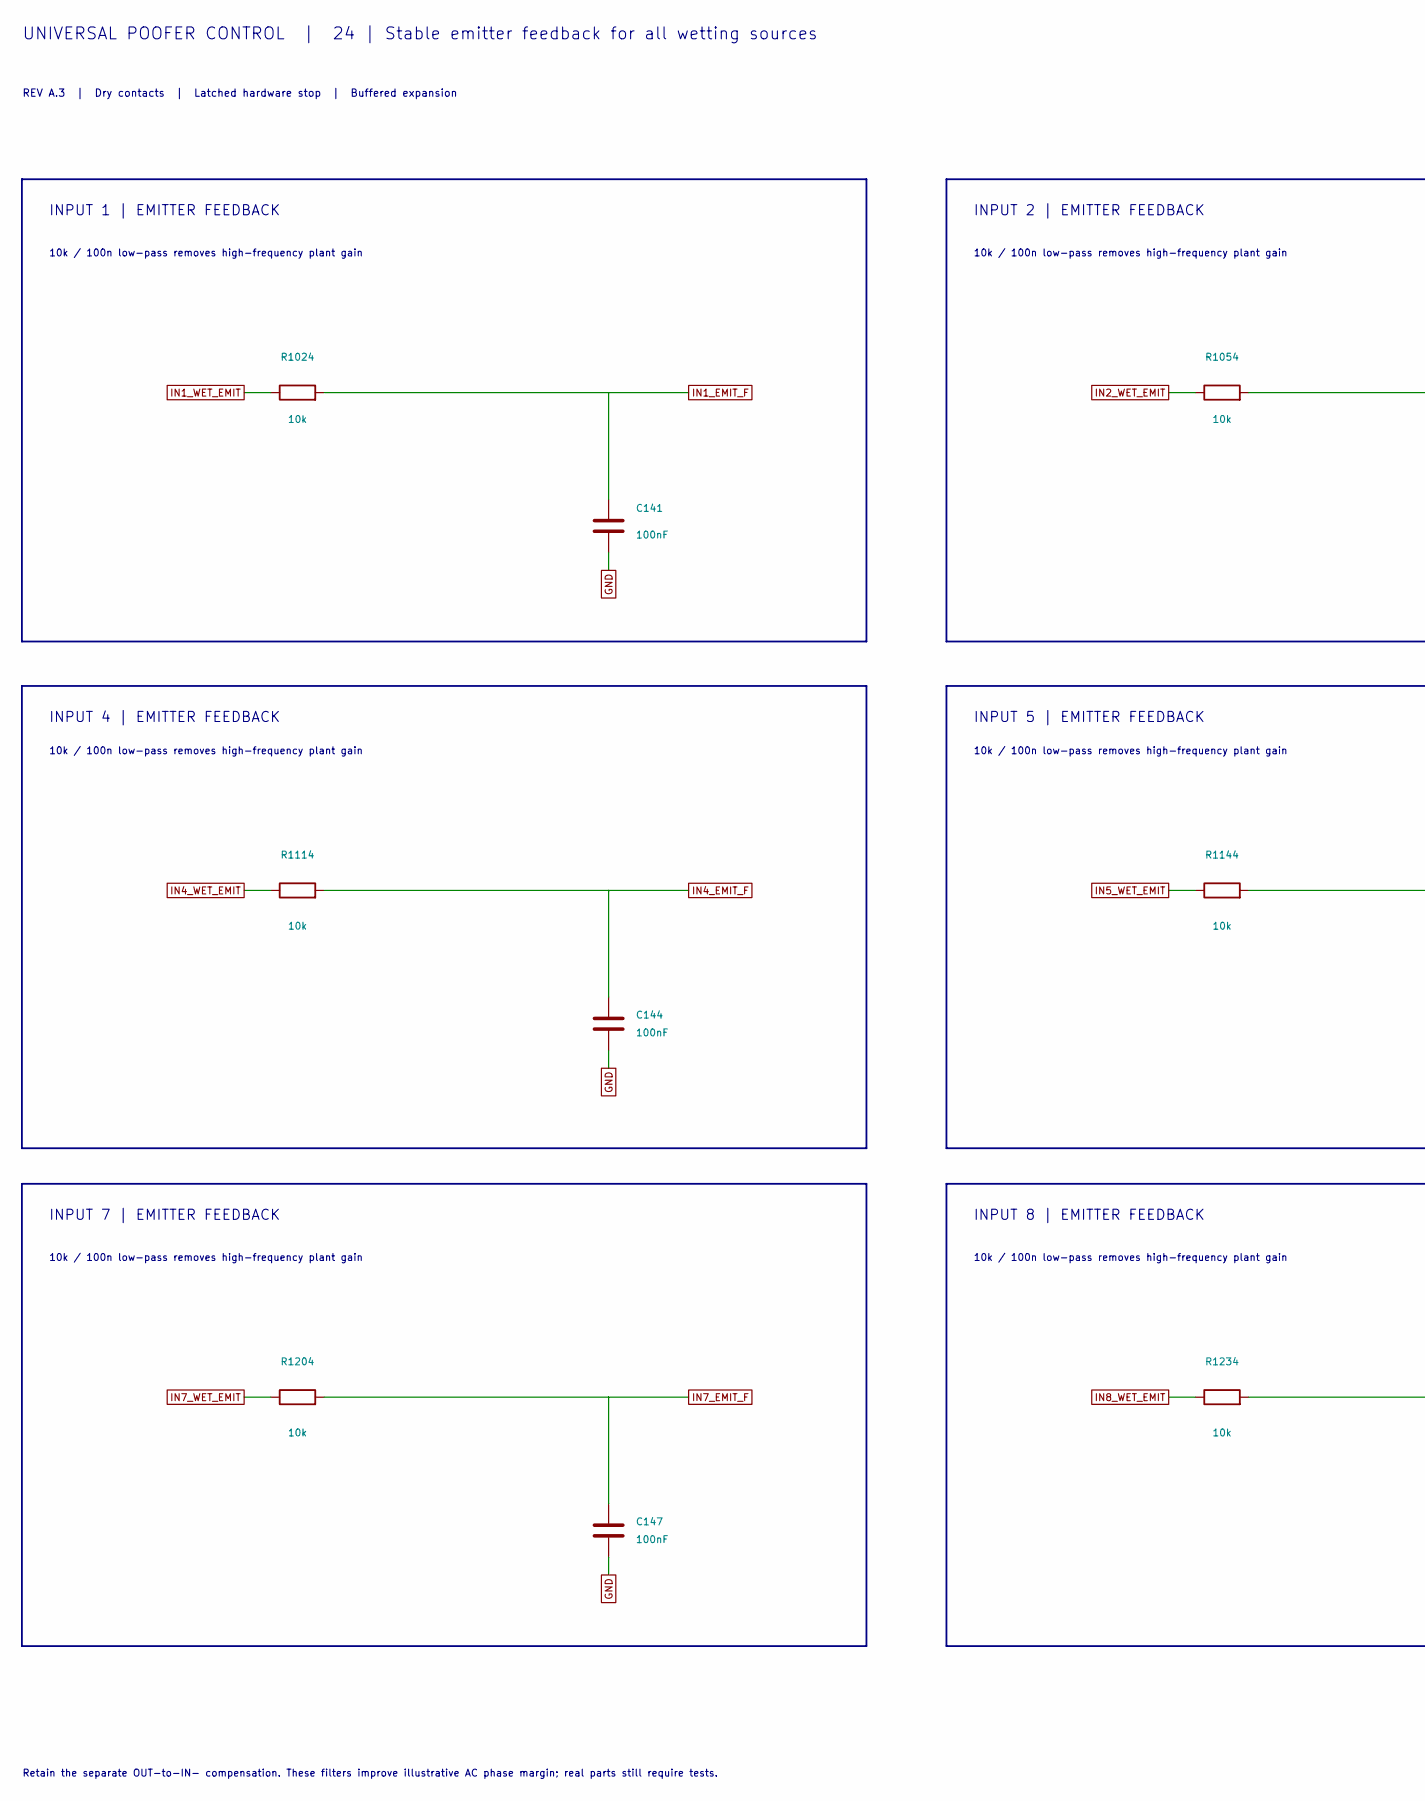
[picture p75: schematic Source_Feedback_Filters.kicad_sch, 24 | Stable emitter feedback for all wetting sources, part in row 1, column 1]

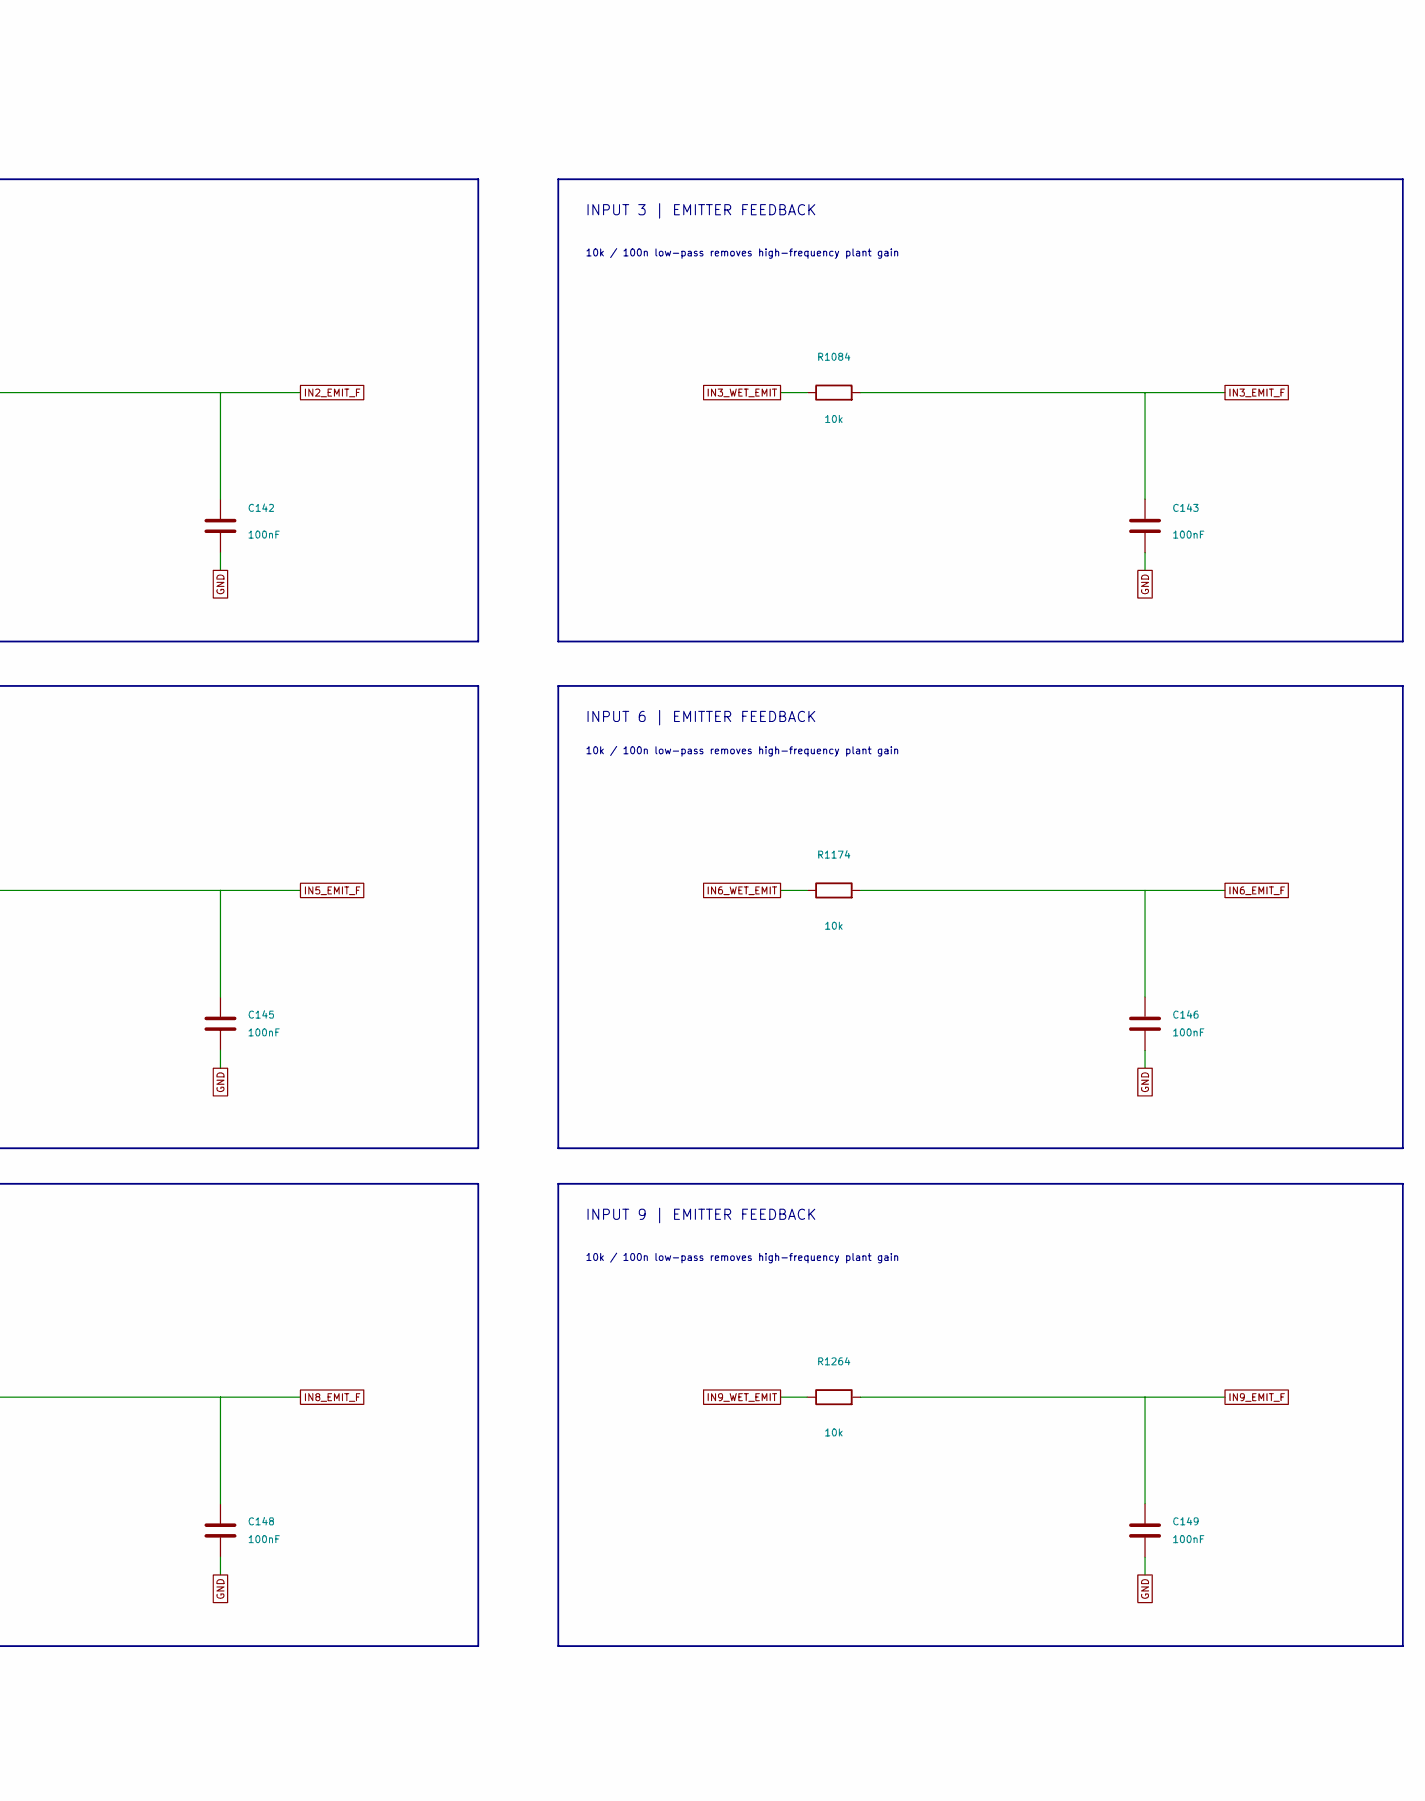
[picture p76: schematic Source_Feedback_Filters.kicad_sch, 24 | Stable emitter feedback for all wetting sources, part in row 1, column 2]

Parts:
C141, C142, C143, C144, C145, C146, C147, C148, C149: 100nF; C_0805_2012Metric; MPN CC0805KRX7R9BB104; LCSC C49678
R1024, R1054, R1084, R1114, R1144, R1174, R1204, R1234, R1264: 10k; R_0805_2012Metric; MPN 0805W8F1002T5E; LCSC C17414

Connections:
GND: C141.2, C142.2, C143.2, C144.2, C145.2, C146.2, C147.2, C148.2, C149.2; also elsewhere on the board
IN1_EMIT_F: C141.1, R1024.2; also elsewhere on the board
IN1_WET_EMIT: R1024.1; also elsewhere on the board
IN2_EMIT_F: C142.1, R1054.2; also elsewhere on the board
IN2_WET_EMIT: R1054.1; also elsewhere on the board
IN3_EMIT_F: C143.1, R1084.2; also elsewhere on the board
IN3_WET_EMIT: R1084.1; also elsewhere on the board
IN4_EMIT_F: C144.1, R1114.2; also elsewhere on the board
IN4_WET_EMIT: R1114.1; also elsewhere on the board
IN5_EMIT_F: C145.1, R1144.2; also elsewhere on the board
IN5_WET_EMIT: R1144.1; also elsewhere on the board
IN6_EMIT_F: C146.1, R1174.2; also elsewhere on the board
IN6_WET_EMIT: R1174.1; also elsewhere on the board
IN7_EMIT_F: C147.1, R1204.2; also elsewhere on the board
IN7_WET_EMIT: R1204.1; also elsewhere on the board
IN8_EMIT_F: C148.1, R1234.2; also elsewhere on the board
IN8_WET_EMIT: R1234.1; also elsewhere on the board
IN9_EMIT_F: C149.1, R1264.2; also elsewhere on the board
IN9_WET_EMIT: R1264.1; also elsewhere on the board

Notes on the sheet:
UNIVERSAL POOFER CONTROL | 24 | Stable emitter feedback for all wetting sources
REV A.3 | Dry contacts | Latched hardware stop | Buffered expansion
INPUT 1 | EMITTER FEEDBACK
10k / 100n low-pass removes high-frequency plant gain
INPUT 2 | EMITTER FEEDBACK
INPUT 3 | EMITTER FEEDBACK
INPUT 4 | EMITTER FEEDBACK
INPUT 5 | EMITTER FEEDBACK
INPUT 6 | EMITTER FEEDBACK
INPUT 7 | EMITTER FEEDBACK
INPUT 8 | EMITTER FEEDBACK
INPUT 9 | EMITTER FEEDBACK
Retain the separate OUT-to-IN- compensation. These filters improve illustrative AC phase margin; real parts still require tests.

Board: 4 copper layers, 584 parts (0 on the bottom side), 388 nets, no tracks yet.

Other parts of the board:
FID1, FID2, FID3: 1mm Cu / 2mm mask; Fiducial_1mm_Mask2mm
H1, H2, H3, H4: M3 / 3.2mm; MountingHole_3.2mm_M3
