NOVA-Cluster/Universal-Poofer-Control/(commit log)

2026-10-03 Initial checkin
    [Analog_Support.kicad_sch, Contact_Sources_1.kicad_sch, Contact_Sources_2.kicad_sch, Contact_Sources_3.kicad_sch, Contact_Sources_4.kicad_sch, Controller.kicad_sch, Current_Reference.kicad_sch, Expansion.kicad_sch]
2026-10-04 Clarify poofer intended use in docs
    Update the README and hardware user guide to describe Universal Poofer Control as a theatrical flame-effects/poofer controller platform while keeping its engineering-preview status clear. Bump the guide revision to UG-A3-1.1, record the intended-use correction in the customer fact audit, regenerate the published PDF, and ignore the separately managed website checkout.
    [render_hardware_user_guide.py]
